wr/airwriter/docs/hardware-rev-2026-11.md

# Rev 2026.11 hardware, as drawn

The main board after rev A, named for what prints on the top case. Designed and routed, the
routing approved by Wells (2026-10-29); not yet ordered or built. Why each change exists is in the design,
`docs/superpowers/specs/2026-10-28-rev-2026-11-board-design.md`. This file is the board as
drawn: what moved from rev A, where things are, and what to leave alone. Edit it in place.

## How the board file is made

`hardware/airwriter/airwriter.kicad_pcb` is generated from rev A (the `hw-rev-a` tag) by
scripts, so every change can be read and re-run:

1. `tools_pcb/r13_build.sh`: rev A's board, then `r13_sync.py` (follow the schematic),
   `r13_place.py` (new parts, D3, TP9, silk), `r13_clean.py` (remove rev A copper the
   changes made wrong; it stops rather than cut a net the design didn't change),
   `r13_place.py` again, and `r13_reroute.py` (rev A copper and parts that move). It stops
   at the first step that fails.
2. `tools_pcb/r13_route.py`: the new traces. The long runs are drawn point by point; the
   short stubs round a part's own pins are found by a small grid search in a corridor.
3. `tools_pcb/r14_lc_light.py`, after `r13_sync.py` has brought JP1 in from the
   schematic: JP1 placed, its two runs drawn by the same grid search, two ground vias (below).

D3's and SW1's footprints are `r13_mkfp_d3.py` and `r13_mkfp_sw1.py`, their 3D models
`lib/make_led_spacer_model.py` and `lib/make_sw1_model.py`.

Once Wells has edited the board in KiCad, don't re-run `r13_build.sh`: it starts again
from rev A. Close KiCad before any of these scripts write the board.

## U3's two RS-232 channels

Rev A used channel 1 for the printer port and tied channel 2's inputs to GND. Rev 2026.11
swaps them, so J4's lines leave U3 on the side facing J4:

| U3 pin | Function | Net | Goes to |
|---|---|---|---|
| 7 | T2OUT | `HSKI_RS232` | R9 (0 Ω), J2.1 |
| 8 | R2IN | `PR_HSKO` | J2.2 |
| 9 | R2OUT | `UART_CTS` | IO8 |
| 10 | T2IN | `HSKI_DRV` | IO47, R24 to GND |
| 11 | T1IN | `J4_HSKO_DRV` | IO13 |
| 12 | R1OUT | `J4_HSKI_RX` | IO21 |
| 13 | R1IN | `J4_HSKI` | J4.2 |
| 14 | T1OUT | `J4_HSKO` | J4.1 |

IO8 also carries a QuickDraw LaserWriter's clock: a Personal LaserWriter 300 drives 533 kHz
on J2.2 whenever it is on, and the firmware clocks TxD out to it with GP-SPI2 through the GPIO
matrix, so the link needs no pin of its own (SPEC §2.4, §3.18; measured on rev A only).

Each port's HSKo has its own GPIO, on pins the DIP switches freed. The cable test drives
each, and through a crossover IO8 reads J2.2 (from J4.1) and IO21 reads J4.2 (from J2.1).
U1 is the ESP32-S3-WROOM-1-N16R8 (16 MB flash, 8 MB octal PSRAM; rev A's is the N8R2): its
PSRAM takes IO35–IO37, so those stay off every net. It needs its own firmware build (SPEC §3.19:
`idf.py -B build-2026.11 -DAIRWRITER_BOARD=2026.11 build`), and it
is rated to 65 °C.

## GPIOs that changed

| GPIO | Net | Notes |
|---|---|---|
| IO15 | `BOARD_LC` | R33 to GND, fitted on AirWriter LC only |
| IO16 | `BOARD_REV` | R32 to GND, fitted on every 2026.11 board; rev A floats high |
| IO13 | `J4_HSKO_DRV` | J4's HSKo, through U3's driver 1; no pull-down (below) |
| IO21 | `J4_HSKI_RX` | J4.2 through U3's receiver 1 |
| IO47 | `HSKI_DRV` | J2's HSKo, through U3's driver 2; R24 holds it low until firmware |
| IO35–IO37 | the N16R8's PSRAM | rev A's `HSKI_DRV` (IO35) and `J4_HSKI_RX` (IO37) |
| IO38–IO40 | `SPARE_IO38`–`40` | rev A's DIP switches; now bare pads on the back (below) |
| IO41, IO42 | none | rev A's DIP switches |

Free: IO1, IO3, IO7, IO9–IO12, IO41, IO42, IO45, IO46, and IO38–IO40 on their pads.

## The LC's one light: D26 and JP1

The LC fits one LED of the 37: D26, the one under the test button, with its cap C46, and U9,
R20 and C29 to drive it. C21, the array's bulk cap, stays off. The chain starts at D10, so
JP1, a solder jumper marked LC on the silk south-east of D26, joins `LED_DATA5` (U9's output
after R20) to `LED_CH16` (D26's input). It is open on AirWriter, where it leaves stubs of
25 mm on `LED_DATA5` and 9 mm on `LED_CH16`; Wells bridges it on the LC. On the LC, D26 is
the first LED U9 drives, so it shows a frame's first pixel. The firmware tells the two
apart by `BOARD_LC`.

`LED_DATA5` runs east from JP1 on the front and down the back to TP5; `LED_CH16` passes under
D26's VBUS and `BTN_TEST` runs on the back. The front run closed off two patches of the front
pour, the ones D26.2, C46.2 and C21.2 reach ground through, so each has a via to the back
plane at (132.75, 97.6) and (139.45, 101.5). JP1 is in the schematic's BOM (konnect can't
clear the flag); `make_fab.sh` leaves solder jumpers off both orders' BOMs.

## Parts that moved from rev A

| Part | Rev A | Now | Why |
|---|---|---|---|
| C18 | (124.20, 152.40) | (121.55, 152.40) | beside U8's VCC pin, west of J4's handshake runs |
| R10 | (121.20, 152.40) | (120.00, 152.40) | `LT_RXD_N` straight down from U8 |
| R11 | (122.70, 152.40) | (118.45, 152.40) | `LT_RXD_P` straight down from U8 |
| R14 | (125.70, 152.40) | (131.30, 144.60) | on `LT_DATA` between U7 and U6, below U7's TASHTALK label |
| SW2 | (144.50, 151.20) | (140.00, 152.70) | below IO0, so `BOOT_CFG` runs straight down; BOOT label to its right |

The maker's marks are on the top silk where S1 was, where the LC's clear lid shows them:
the WW mark (the Macintosh Mini board's two chevrons, 7 mm wide) above KiCad's OSHW logo
(7.5 × 8 mm, LOGO1, a board-only footprint).

Gone: S1, the eight DIP switches, and with them rev A's eight runs from the west edge to the
module. SW1 is now the BZCN TSB001A3518A side-press switch (the Macintosh Mini's), at
(157.60, 99.45) turned −90°: its button faces the case's reset pinhole, on rev A's axis, and
its two contacts sit over rev A's EN and GND pads. It is held by two plastic pegs in 0.9 mm
holes and two bracket pads; rev A's EVQP44B3M lifted off its two small pads. Its RESET label
is board silk now, not a field of the old footprint.

The new resistors sit beside what they serve: R24 below U3, R25 east of U6 (off UART_TX's
back run by a via), R27 east of U7 in LT_RESET's back run, R21 above SW2, R32 and R33 above
IO16 and IO15.

## Rev A copper that changed

- U3's 3.3 V feed runs from pin 16 under U3's body (x 117.3) to the branch at y 144.24,
  not down U3's right side.
- The printer port's handshakes rejoin rev A's routes by short steps from pins 7–10.
- `LT_RESET` meets R27 east of U7; U7.4 is fed back along rev A's run as `LT_MCLR`.
- EN steps round SW1's bracket pad into its pad 1.
- `BOOT_CFG` goes straight down from IO0 to R21 and SW2.
- `LED_DATA`'s run north of the module is 0.37 mm higher, which makes room for R32 and R33's
  ground vias.
- The LocalTalk receive pair from R10/R11 to J4: `LT_PORT_RXD_P` on the back.
- The VBUS via at the H4 crossing is 0.5 mm drill (rev A 0.4), not doubled: its plated wall
  now holds more copper than the 0.5 mm track that feeds it, so that track, unchanged from
  rev A, is the limit.
- D− reaches the ESP32 through U5's pad 3, as D+ goes through U5; U5.2 has a ground via
  under U5.

## New runs

- J4.1 and J4.2 from U3.14 and U3.13: down beside U3, under U8, a via each just below U8,
  then the back layer to J4.
- IO21 (`J4_HSKI_RX`) and IO47 (`HSKI_DRV`): a via each by U3, then side by side on the
  back, along rev A's `HSKI_DRV` run, to a via each just west of the module and a short
  stub into pins 23 and 24.
- IO13 (`J4_HSKO_DRV`): a via beside U3.11, one straight run on the back between U7's two
  rows of pins, and a via just west of pin 21 (BTN_TEST passes on the front).
- Ground vias for R24, R32, R33, TP9's patch of the back pour and U5.2.
- Spare pins: IO38, IO39 and IO40 each run straight down from the module's pin to a via
  and a bare 1 mm pad on the back (TP10–TP12, labelled 38, 39, 40), for trying an idea on
  a built board with a few wires; 3V3 is at TP2 and GND at TP9 nearby. On the back, so the
  front keeps only a short stub per pin and the ground pour still reaches C1 and C22. IO41
  has no way down past USB D− on the back, and IO42 has C1 over it.

## Deliberate, don't "fix"

- IO13, J4's HSKo drive, has no pull-down. A resistor fits only at the end of an 8 mm
  stub, and nothing on J4 reads pin 1 at power-up; firmware drives it within about 0.1 s.
  J2's (IO47) keeps R24: a StyleWriter on J2 watches its HSKo.
- TP9 and the old test pads sit on the back under U1's courtyard.
- Vias under U5's and U8's bodies are tented.
- U2 is TI's THVD1451 (the design had the SP3490): the same pinout, rated ±30 kV HBM on its
  bus pins against the SP3490's ±2 kV, and its receiver works with ±15 V on its inputs
  (absolute maximum ±18 V), so an RS-232 printer's line is in range on its own. R29 and
  R30 stay in series with the receive pair at 15 k, as protection: against the receiver's
  load (at least 75 k at −15 V) a −15 V line arrives at about −12.5 V, and an RS-422
  printer's 2 V as about 1.7 V. Its fail-safe threshold (−20 to −200 mV) reads an idle,
  open or unplugged line as mark, so a printer switched off with the cable in sends no
  garbage.
- D3's cathode is marked K on the silk beside pad 1: the spacer hides the square pad.
- D3's axis sits about 0.5 mm east of the top case's slash centre line: the slash grew to
  about 1.0 × 5.75 mm in the Frame 16 art, and D3 can't move west without meeting J1. Its
  3 mm face still covers the slash's full width.
- R17's pads sit 0.58 mm in from the east edge: PCBWay's minimum is 0.30, with ±0.2 mm on a
  routed edge.

## Checks, 2026-10-28

- ERC: 0 errors, 47 known warnings (42 `lib_symbol_mismatch`; 5 `isolated_pin_label`: TXD0,
  RXD0 and the three spare pins, each a label on one pin by design).
- DRC with `--severity-all --schematic-parity --refill-zones`: 0 errors, 0 unconnected, 5
  `lib_footprint_mismatch` warnings, no field-parity warnings (`r13_sync.py` now copies the
  Description, Manufacturer and Datasheet fields too).
- `r12_gnd.py`: one GND component, no stranded pads.
- `r7_verify.py`: rev A's known FAIL lines, plus TP9 under U1.
- `r13_check.py`: every pad of a part inside the board 0.30 mm or more from the edge, no
  front silk off the board, D3's K and SW1's RESET in place.
- `enclosure/build.sh`: all tests pass; the tray has no DIP slot (a board without S1 gets
  none), and the reset pinhole aims at the new button, 1.90 mm up.
- `make_fab.sh`: 135 placements on AirWriter's panel, 54 on the LC's main board alone, drill
  floor 0.30 mm on both. Neither places J2, J4 or a PIC: Wells fits them after delivery, and
  U7's socket goes on empty.
