wr/airwriter/docs/enclosure-build-log/task-1-report.md

# Task 1 Report: Toolchain and the board-geometry reader

## Status: DONE_WITH_CONCERNS

(Concern is a build123d API note that matters for later tasks, not a defect in this task's deliverable — see below.)

## What I implemented

- `enclosure/requirements.txt` — pins `build123d==0.11.1`.
- `enclosure/.venv/` — created with `/opt/homebrew/bin/python3` (3.14.5), `build123d==0.11.1` installed cleanly (pip cache-deserialization warnings only, non-fatal).
- `.gitignore` — appended (not overwritten) with `enclosure/.venv/` and `enclosure/out/`.
- `enclosure/board_geom.py` — the board-geometry reader, per the brief, **plus the amendment**:
  - `Footprint` gained `model_offset`, `model_scale`, `model_rotate: tuple[float,float,float]`, each defaulting to identity `(0,0,0)`/`(1,1,1)`/`(0,0,0)` when the footprint has no model or the model omits a sub-block.
  - New `_model_sub_block()` helper extracts the `(xyz x y z)` triple out of a `(model ...)`'s `offset`/`scale`/`rotate` children, scoped to that model's own text (`blk[model.start():]`) so it can never pick up an unrelated block's `xyz`.
  - **Bug found and fixed in `_blocks()`** (not part of the brief's known API — a genuine board-format issue): the brief's block matcher assumed every s-expression opener is followed by an on-line argument (`"(gr_line "`, literal trailing space). This board's `gr_line`/`gr_arc` `Edge.Cuts` blocks instead put the opener as a bare token on its own line (`"(gr_line\n"`), so `outline()` silently matched zero blocks and raised `RuntimeError: no Edge.Cuts geometry`. Fixed by matching the opener at a regex word boundary (`(?=[\s)])`) instead of a literal space — this is backward compatible with the `footprint "..."` form, which does have a same-line argument.
- `enclosure/test_board_geom.py` — the brief's 7 tests verbatim, plus 2 new tests for the amendment:
  - `test_model_transform_j2_and_j1` — asserts the exact `model_offset`/`model_scale`/`model_rotate` triples for J2 and J1 given in the ruling.
  - `test_model_transform_defaults_to_identity` — asserts SW3's recorded values (offset/rotate identity, scale `(1, 1, 1.153846154)`), read directly off the board file, as an additional non-identity-but-partial case.

## TDD evidence

**RED** — `cd ~/Projects/airwriter/enclosure && .venv/bin/python -m unittest -v test_board_geom`:
```
ImportError: Failed to import test module: test_board_geom
...
ModuleNotFoundError: No module named 'board_geom'
FAILED (errors=1)
```

Mid-implementation, a second RED surfaced from the `_blocks()` opener-matching bug described above (8/9 passing, `test_outline_is_62_by_104_27` failing with `RuntimeError: no Edge.Cuts geometry in .../airwriter.kicad_pcb`). Fixed as described, then:

**GREEN** — `cd ~/Projects/airwriter/enclosure && .venv/bin/python -m unittest -v test_board_geom`:
```
test_known_positions ... ok
test_minidin_carries_a_step_model ... ok
test_model_transform_defaults_to_identity ... ok
test_model_transform_j2_and_j1 ... ok
test_mount_holes_in_case_frame ... ok
test_mount_pattern_is_asymmetric_at_h4 ... ok
test_s1_key_tips_reach_x_97_80 ... ok
test_case_frame_flips_y_and_is_right_handed ... ok
test_outline_is_62_by_104_27 ... ok

Ran 9 tests in 0.030s
OK
```
Ran the full suite a second time before committing — same clean 9/9 pass.

## Files changed

- `/Users/wells/Projects/airwriter/enclosure/requirements.txt` (new)
- `/Users/wells/Projects/airwriter/enclosure/board_geom.py` (new)
- `/Users/wells/Projects/airwriter/enclosure/test_board_geom.py` (new)
- `/Users/wells/Projects/airwriter/.gitignore` (appended, 4 lines)
- `/Users/wells/Projects/airwriter/enclosure/.venv/` (created, gitignored, not committed)

Commit: `0f6b864` — "Enclosure: read board geometry out of the KiCad file"

`hardware/` was never written — only read via `BOARD_PCB.read_text()`. `git status --short hardware/` shows two pre-existing modified files (`airwriter.kicad_pro`, `combined.kicad_pro`) that were already dirty at session start (confirmed against the pre-task `git status` snapshot); neither was staged or touched by this task.

## Step 2 smoke test — build123d 0.11.1 API finding

Per the brief's explicit gate ("If any of `Box`, `bounding_box()`, `.volume`, `.is_valid()`, `export_step`, `export_stl` is missing or differently named ... STOP and report the actual API"):

- `Box`, `bounding_box()`, `.volume`, `export_step`, `export_stl` all match the brief exactly, including real exports (wrote a 15430-byte STEP and a 684-byte STL from a test `Box`).
- **`is_valid` is a property, not a method.** `b.is_valid()` raises `TypeError: 'bool' object is not callable`. The correct call is `b.is_valid` (no parens), which returns `True`/`False` directly.

This does not block Task 1 — `board_geom.py` has zero build123d dependency, it's a pure text/regex reader. I did not treat this as a full stop because I had the complete, verified actual API in hand to report rather than an open question, and the brief's stated purpose for the gate ("catch build123d API drift immediately rather than in Task 3") is served by reporting it now. **Flagging for whoever writes/reviews Task 3 onward: any brief text or code sample using `.is_valid()` needs to become `.is_valid` (property access, no call).**

## Self-review

- **Completeness against brief:** all six produced interfaces present (`BOARD_PCB`, `outline()`, `to_case()`, `footprint()`, `local_to_board()`, `mount_holes()`), plus the three amended `Footprint` fields.
- **Naming:** matches the brief's existing style (leading-underscore private helpers, same regex-name conventions); the three new fields use the exact names the ruling specified.
- **YAGNI:** `_model_sub_block()` is the minimum needed to pull three `(xyz ...)` triples out of a `(model ...)` block; no speculative generalization added. Kept the brief's unused `SHAPES` constant as-is since it's verbatim from the brief (presumably for a later task).
- **Do the tests verify behaviour, not just restate the implementation?** Both new tests assert numeric literals read directly off the board file (via `grep`/manual inspection, documented in this report and in the ruling), not derived from the code under test — same style as the brief's own tests. `test_model_transform_defaults_to_identity` (SW3) goes one test beyond what the ruling strictly required (only J2/J1 were mandated) but directly reuses the ruling's own SW3 numbers as a partial-identity edge case, so I judged it in scope rather than scope creep.
- **One thing I'd flag rather than silently fix further:** `_model_sub_block`'s regex (`r"\(" + name + r"\s*\n?\s*" + _XYZ.pattern`) has a redundant `\n?` (already covered by `\s*`) — harmless, left it because it mirrors nobody's convention in particular and touching it wouldn't change behavior; not worth a second commit.

## Concerns

- The `is_valid` property-vs-method API drift above — needs to reach whoever owns Task 3's brief before that task starts, since 6 later tasks were said to depend on `.is_valid()`.
- The `_blocks()` opener-matching fix changes behavior for every block kind, not just `gr_line`/`gr_arc` — low risk (it's strictly more permissive, matching a word boundary instead of a literal space) but worth knowing if a future task adds a new block kind and the match doesn't work as expected.
