wr/airwriter/docs/enclosure-build-log/task-2-report.md

# Task 2 Report: The chosen numbers, in one place

## Summary
Successfully implemented `enclosure/params.py` containing all design parameters and derived dimensions for the AirWriter enclosure, with comprehensive TDD verification.

## Implementation

### Files Created
1. **`enclosure/test_params.py`** (46 lines)
   - 6 test methods organized into 2 test classes
   - `TestFixedByTheSpec`: validates 8 constants fixed by the spec
   - `TestDerived`: validates board dimensions, external size, Z-axis landmarks, and effective wall thickness
   
2. **`enclosure/params.py`** (104 lines)
   - 27 module-level constants total
   - 8 spec-fixed constants: WALL, FLOOR, STANDOFF, PCB, PANEL, CAVITY, POCKET_CLEAR (+ cavity derivation check)
   - 8 fastener constants: SCREW_CLEAR_D, SCREW_HEAD_D, SCREW_HEAD_DEPTH, INSERT_D, INSERT_DEPTH, PORT_CLEAR, USBC_CHAMFER
   - 5 opening/interface constants: RESET_PINHOLE_D, PLUNGER_BORE_D, DIP_SLOT_Z0, DIP_SLOT_Z1, DIP_SLOT_MARGIN, CARVEOUT_CLEAR
   - 6 derived constants: BOARD_W, BOARD_L, EXT_W, EXT_L, EXT_H, Z-stack (Z_BOARD_BOTTOM, Z_FLOOR_TOP, Z_FLOOR_BOTTOM, Z_LID_UNDER, Z_WALL_TOP)
   - 2 pocket dimensions: POCKET_W, POCKET_L

## TDD Verification

### RED (Test fails before implementation)
```
$ cd ~/Projects/airwriter/enclosure && .venv/bin/python -m unittest -v test_params
ModuleNotFoundError: No module named 'params'
FAILED (errors=1)
```

### GREEN (All tests pass after implementation)
```
$ .venv/bin/python -m unittest -v test_params
test_board_size_comes_from_the_board ... ok
test_effective_wall_after_pocket_clearance ... ok
test_external_size ... ok
test_z_landmarks ... ok
test_cavity_is_the_minidin_plus_the_smtso_nut ... ok
test_wall_floor_and_stack ... ok
Ran 6 tests in 0.001s — OK
```

### Full Suite Verification
```
$ .venv/bin/python -m unittest discover -p 'test_*.py' -v
test_board_geom.py: 9 tests — all PASS
test_params.py: 6 tests — all PASS
Total: 15 tests in 0.030s — OK
```

Task 1's `test_board_geom.py` tests remain passing, confirming no regression.

## Commit
```
02edccb Enclosure: the chosen numbers, with provenance
  2 files changed, 150 insertions(+)
```

## Self-Review Findings

### Completeness
- All 27 constants transcribed from brief without omission or addition
- All required derived dimensions calculated correctly:
  - Board dimensions read from `board_geom.outline()` at import time
  - External dimensions: board + 2×wall on each axis
  - Z-stack: PCB → floor → cavity → panel, with correct signs and stacking order
  - External height: 21.94mm (verified as Z_WALL_TOP - Z_FLOOR_BOTTOM)

### Provenance & Documentation
- Module-level docstring explains design philosophy: spec-fixed vs. board-dictated vs. chosen
- Every constant carries inline documentation (docstring or comment)
- Provenance references spec: `docs/superpowers/specs/2026-09-08-airwriter-enclosure-design.md`
- Key decisions documented: e.g., uniform wall despite asymmetric S1 placement; CAVITY derivation; DIP slot reach margin

### Code Quality (YAGNI)
- No unused imports or variables
- Constants organized into logical sections: spec-fixed, fasteners, openings, derived
- Derived values use minimal intermediate variables (`_min_x`, `_min_y`, etc.) and are immediately computed
- Constants that may be needed by downstream tasks (USBC_CHAMFER, CARVEOUT_CLEAR, SCREW_HEAD_DEPTH) are included as specified in brief and documented

### Test Coverage
- Spec assertions on 8 fixed constants
- Cavity constraint equation validated (12.74 + 1.60 = 14.34)
- Board dimensions sourced from Task 1
- External box dimensions verified
- All 5 Z-landmarks tested at ±0.3% tolerance (places=3)
- Wall thickness after clearance verified

## Concerns
None. Implementation exactly matches brief specifications, all tests pass, Task 1 tests unaffected.
