wr/airwriter/docs/enclosure-build-log/task-4-report.md

# Task 4 report: board standoffs and the screw stack

## What I implemented

Added two functions to `enclosure/case.py`, exactly as specified in the brief:

- `standoffs() -> Part`: four cylindrical bosses (Ø6.00, `STANDOFF_D`), one per
  mount hole from `board_geom.mount_holes()`, running from `Z_FLOOR_TOP` to
  `Z_BOARD_BOTTOM`.
- `screw_holes() -> Part`: four clearance-plus-counterbore solids to be
  subtracted — an M2.5 clearance bore (Ø2.80) running the full height from
  just below the floor to just above the board, an M2.5 pan-head counterbore
  (Ø5.00, 1.40mm deep) opening on the floor's underside, and a 45° `Cone`
  run-out between the two so the transition isn't a flat, unsupported
  annular ledge on a floor-down print.

Also appended `TestStandoffsAndScrews` to `enclosure/test_case.py`, copied
verbatim from the brief (three tests: standoff placement/reach, screw-hole
through-floor extent, and the coned-not-flat counterbore transition).

Did not write `tray()` — that's Task 6, per the brief.

## TDD evidence

**RED** — `cd ~/Projects/airwriter/enclosure && .venv/bin/python -m unittest -v test_case`, after adding the test class only:

```
test_counterbore_transition_is_coned_not_a_flat_ledge ... ERROR
test_screw_holes_pass_right_through_the_floor ... ERROR
test_standoffs_sit_at_the_mount_holes_and_reach_the_board ... ERROR
...
AttributeError: module 'case' has no attribute 'screw_holes'
AttributeError: module 'case' has no attribute 'standoffs'
Ran 8 tests in 0.051s
FAILED (errors=3)
```

**GREEN** — same command, after implementing `standoffs()`/`screw_holes()`:

```
test_cavity_is_hollow_from_floor_top_upward ... ok
test_external_bounding_box ... ok
test_floor_is_solid_under_the_pocket ... ok
test_is_a_valid_single_solid ... ok
test_sits_in_the_case_frame ... ok
test_counterbore_transition_is_coned_not_a_flat_ledge ... ok
test_screw_holes_pass_right_through_the_floor ... ok
test_standoffs_sit_at_the_mount_holes_and_reach_the_board ... ok

Ran 8 tests in 0.190s
OK
```

**Full suite** — `.venv/bin/python -m unittest discover -p 'test_*.py' -v`: 23 tests, all pass (Tasks 1-3's `test_board_geom.py`/`test_params.py`/`test_case.py` shell tests unaffected).

## Files changed

- `enclosure/case.py` — added `STANDOFF_D`, `standoffs()`, `screw_holes()`, extended the `build123d` import and added `import board_geom as bg`.
- `enclosure/test_case.py` — appended `TestStandoffsAndScrews`.

Commit: `a077a8f` "Enclosure: board standoffs and the screw stack" (2 files changed, 74 insertions, 1 deletion). Nothing under `hardware/` touched (the working tree has unrelated pre-existing modifications to two `.kicad_pro` files and some untracked firmware build artifacts — I left those alone and staged only the two intended files).

## build123d API notes (as requested)

- `Cone(bottom_radius, top_radius, height, ...)` and `Cylinder(radius, height, ...)` both default to `align=(CENTER, CENTER, CENTER)`, matching the brief's assumption that `Pos(x, y, z_center) * Cone(...)` centers the primitive on `z_center`. Confirmed via `help()` before using it — no surprise here.
- Chained `+` unions of several `Part` objects (as `standoffs()` and `screw_holes()` do in their loops) come back as `build123d.topology.composite.Compound`, not `Part`, even though the function signatures say `-> Part` (matching the brief). By contrast, `shell()`'s single `Box - Box` returns an actual `Part`. This is cosmetic, not functional — `.bounding_box()`, `.solids()`, `.is_valid`, and further `+`/`-` against real `Part` objects all work fine on the `Compound` (verified: `(shell() + standoffs()) - screw_holes()` comes back as a valid single-solid `Part`). Worth knowing for Task 6's `tray()`, which will do exactly that composition — no fix needed, just don't be surprised if `type(standoffs())` isn't `Part`.

## Self-review finding — the counterbore test does not actually catch a flat-ledge regression

This is the important one, and exactly the kind of "brief's code assumes something about `face.normal_at()` that doesn't hold" surprise I was told to flag explicitly rather than route around.

`test_counterbore_transition_is_coned_not_a_flat_ledge` calls `case.screw_holes()`
(the tool solid, not the assembled shell) and filters for faces whose
`normal_at(center()).Z ≈ -1` (downward-facing) with area > 2.0, asserting
none exist. I verified empirically (built the "broken" tool — clearance bore
`+` counterbore, no cone — by hand and ran the test's exact filter against
it):

```
flats found (no-cone tool): []   # test would PASS on the broken geometry
```

The dangerous flat annulus is real (area 13.477mm² = π(2.5²−1.4²), exactly
the Ø5.00→Ø2.80 shoulder, at z=−4.60 = `Z_FLOOR_BOTTOM + SCREW_HEAD_DEPTH`)
and it does exist in the no-cone tool — but its outward normal, on the *tool*
solid, is **+1** (up), not −1. That's the correct OCCT convention for a
union of two coaxial cylinders (wider below, narrower above): the tool's own
boundary at the shoulder faces away from the tool's interior, i.e. upward.
It's only after the tool is *subtracted* from real material that the
corresponding surface (now part of the shell) faces downward and becomes a
physical overhang. So the brief's test, run against the bare tool with a
downward-normal filter, is checking the wrong sign on the wrong object, and
it passes unconditionally regardless of whether the cone is present.

I confirmed the flip in isolation (`normal.Z ≈ +1` on the tool does show the
shoulder for the no-cone case and not for the coned case), but a plain sign
flip isn't a safe fix by itself: it also matches the legitimate top cap of
the through-bore (at `Z_BOARD_BOTTOM + 0.01`, area π·1.4² = 6.158), which
is not an overhang and appears in both the broken and correct geometry — so
naively flipping the sign turns the test into an always-fail. Checking the
assembled `shell() - tool` instead (rather than the tool alone) does
discriminate correctly on the shoulder in my testing, but introduces an
unexplained extra flat face elsewhere in the model that I didn't have
confidence chasing down inside this task's scope.

I did **not** change the test — the brief specified it verbatim and I don't
have a confidently-correct replacement to swap in without further
investigation, plus Task 8's whole-part printability gate is explicitly
"built on the same idea," so this is worth fixing once at the plan level
rather than my patching it ad hoc here. My actual `standoffs()`/`screw_holes()`
implementation is geometrically correct regardless — I verified directly
(not via this test) that the coned tool has no flat shoulder face at any
normal orientation at z=−4.60, only the no-cone version does. But the test
as committed gives false confidence: it would pass even if someone later
deleted the `Cone` and left a flat ledge. Recommend fixing the filter (and
probably scoping to the counterbore-to-clearance transition band, not just
any upward-or-downward face) before Task 8 reuses this pattern.

## Other self-review notes

- `test_standoffs_sit_at_the_mount_holes_and_reach_the_board` is solid: it
  pins exact Z bounds, solid count, and XY centres against
  `board_geom.mount_holes()` directly, so it would catch a wrong hole,
  wrong height, or merged/missing boss.
- `test_screw_holes_pass_right_through_the_floor` is deliberately loose
  (`<=`/`>=` on bounding box, not exact) — matches the brief, no concern.
- YAGNI: no `tray()`, no extra helpers beyond what's needed for these two
  functions. `STANDOFF_D` is the only new constant, with a rationale
  docstring per the file's existing convention.

## Fix report: counterbore-flat test now checks the boolean result

Addressed the self-review finding above (also raised independently as a
review "Important" finding): `test_counterbore_transition_is_coned_not_a_flat_ledge`
called `case.screw_holes()` — the cutting tool — and filtered for
downward-facing (`normal_at().Z ≈ -1`) planar faces. A tool solid has no
such face at that shoulder: the tool's own material sits below and wider
there, so the face's outward normal is +Z. The dangerous unsupported ledge
only exists on the boolean **result**, where the same surface (now the
underside of real material) points -Z. The test therefore always passed,
cone or no cone.

**Fix (test-only, `enclosure/test_case.py`):** rewrote the test to build
`(case.shell() + case.standoffs()) - case.screw_holes()` inside the test and
run the same filter (`abs(n.Z + 1.0) < 1e-6`, area > 2.0, centre above
`p.Z_FLOOR_BOTTOM`) against that result instead of the tool. Added a comment
recording why the check has to be on the result, not the tool. Did not touch
`case.py` — `standoffs()`/`screw_holes()` geometry was already correct.

**No-cone sanity check** — before committing, built a throwaway no-cone
variant of the tool (`bore + cbore`, cone omitted) inline in a scratch
script and ran the amended filter against
`(case.shell() + case.standoffs()) - screw_holes_no_cone()`:

```
no-cone result: 4 downward flat(s) found
  area=13.477 mm2 at (5.636, 12.340, -4.600)
  area=13.477 mm2 at (53.364, 12.340, -4.600)
  area=13.477 mm2 at (5.636, 98.634, -4.600)
  area=13.477 mm2 at (56.364, 98.634, -4.600)
SANITY CHECK PASSED: amended test would FAIL (correctly) on the no-cone regression
```

This matches the finding's manual verification exactly (area
π(2.5²−1.4²)=13.477 mm² at `Z_FLOOR_BOTTOM + SCREW_HEAD_DEPTH` = -4.60, one
per mount hole). The scratch variant was never added to `case.py` — discarded
after this check.

**Covering tests, real implementation:**

```
$ .venv/bin/python -m unittest -v test_case
test_cavity_is_hollow_from_floor_top_upward ... ok
test_external_bounding_box ... ok
test_floor_is_solid_under_the_pocket ... ok
test_is_a_valid_single_solid ... ok
test_sits_in_the_case_frame ... ok
test_counterbore_transition_is_coned_not_a_flat_ledge ... ok
test_screw_holes_pass_right_through_the_floor ... ok
test_standoffs_sit_at_the_mount_holes_and_reach_the_board ... ok

Ran 8 tests in 0.188s
OK

$ .venv/bin/python -m unittest discover -p 'test_*.py' -v
[... 23 tests ...]
Ran 23 tests in 0.193s
OK
```

Commit: `1abcf72` "Enclosure: check the counterbore-flat test against the
boolean result" (`enclosure/test_case.py`, 1 file changed, 9 insertions(+),
2 deletions(-)).
