wr/airwriter/docs/enclosure-build-log/task-5-report.md

# Task 5 report: port cutouts booleaned from the real connector STEPs

Status: **DONE_WITH_CONCERNS**

## What was implemented

`enclosure/case.py`:

- `connector_solid(ref)` — a connector's vendor STEP, placed in the case frame by
  the full KiCad 3D-model transform (model scale → model rotate → model offset →
  footprint's own board rotation/position → case frame's Y flip), not the brief's
  false "offset 0, footprint origin only" assumption.
- `_imported_step(path)` — module-level cache keyed by path, since `import_step`
  takes ~0.15s and `connector_solid()` is called many times across the port
  tests. Each caller gets its own transformed copy (`Location * Shape` returns a
  new object; the cached raw import is never mutated). Flagging this per the
  task instructions: it's machinery the brief didn't ask for, added because the
  suite would otherwise re-import the same STEP dozens of times.
- `_grown(ref, amount)` — a private helper: the connector's convex hull, grown by
  `amount` via `offset()`. See "build123d/OCCT surprise" below for why this
  exists instead of offsetting `connector_solid()` directly.
- `port_cutouts()` — unions `_grown(ref, PORT_CLEAR)` for J2/J4/J1, plus the
  USB-C outside chamfer, same construction as the brief's skeleton.

`enclosure/test_case.py`: a new `TestPorts` class with 7 tests — the three
ground-truth tests (mating face Y, shell Z height, USB-C face Y) plus the
brief's four remaining checks (real geometry, no intersection, ≥0.30mm
clearance, wall remains between the mini-DINs), adapted where the brief's
literal code didn't survive contact with the real geometry (see below).

## The transform composition, and the evidence for it

```python
mrx, mry, mrz = fp.model_rotate
part = Rot(-mrx, 0, 0) * part      # 1. negate stored rotate, apply about X first
part = Rot(0, -mry, 0) * part      # 2. ... then Y ...
part = Rot(0, 0, -mrz) * part      # 3. ... then Z, each about the FIXED axes
part = Pos(*fp.model_offset) * part  # 4. offset, in that same numeric frame

part = Rot(0, 0, fp.rot) * part    # 5. footprint's board rotation, sign AS STORED
x, y = bg.to_case(fp.x, fp.y)
return Pos(x, y, 0) * part          # 6. footprint position, converted to case frame
```

Two things this nails down that weren't obvious going in:

1. **KiCad negates the stored `rotate` and applies it about the fixed model
   axes in order X, then Y, then Z** — not the model's own rotating axes
   (that would be a different, intrinsic composition), and not Z-Y-X. I
   verified the axis order empirically: swapping to Z-then-X for J2 (mrx=-90,
   mrz=180) puts the shell's Z-max at 3.75mm instead of ~12.75mm — wildly
   wrong, which is exactly the "obviously wrong" signal the brief said to
   watch for. Not negating the stored rotate at all does the same (3.75mm).
   Only X-then-Y-then-Z with negation lands near the documented 12.74mm.

2. **The footprint's own board rotation (`fp.rot`) is applied to the model's
   local frame using its stored sign directly — not negated, and not
   `180 - fp.rot`** (the brief's formula, which was part of the false
   assumption being overridden). I derived this algebraically: rotating a
   local point by `fp.rot` via `board_geom.local_to_board`'s convention and
   then converting the result to the case frame (which flips Y) is
   numerically identical to applying `Rot(0, 0, fp.rot)` directly to the
   *un-flipped* local numbers and then translating by `to_case(fp.x, fp.y)`.
   The two sign flips (the board-rotation convention, and the case frame's Y
   flip) cancel. I confirmed this by computing full board-frame bounding
   boxes by hand for J2 with `Rot(0,0,-fp.rot)` (the naive guess) — it puts
   the connector body sticking 15mm out the *front* of the case, physically
   backwards — versus `Rot(0,0,fp.rot)` (implemented) — which puts the body
   properly behind the mating face, inside the case.

### The three ground truths, measured

| # | Ground truth | Measured | Match |
|---|---|---|---|
| 1 | J2/J4 mating face at case Y = −2.75 | **−2.75** (exact) | ✓ |
| 2 | J2/J4 shells top out at Z = 12.74 | **12.75** | ~0.01mm off |
| 3 | J1 shell face near case Y = −1.5 (±0.2) | **−1.5** (exact) | ✓ |

Ground truth 1 is somewhat structurally guaranteed once the offset/scale are
right (J2/J4 both have `model_offset = (0,0,0)`, so the footprint origin maps
straight through regardless of rotation), but it's still a real check on the
offset-handling code path and on `to_case()` being wired correctly.

Ground truth 2 came out to 12.75mm, not 12.74mm. I did not adjust the
composition to force this closer — every alternate axis order or sign I
tried during development landed far off (3.75mm, −3.75mm, 16.5mm), so there
was no "close but not quite" candidate to chase; the only two outcomes
observed were "exactly 12.75mm" (this composition) or "obviously wrong by
multiple mm" (every other one tried). 12.75mm is also not an artifact of
rounding in this pipeline — `repr()` on the bounding box gives
`12.750000100000003`, i.e. it's genuinely the raw STEP's own Y-extent
(12.75mm, read directly off `MiniDIN-8_Kycon_KMDGX-8S-BS_RightAngle.step`)
carried straight through the rotation with no further arithmetic. I traced
"12.74" to two places: `scripts/board-model/README.md` in the **shop** repo,
and this project's own `docs/superpowers/specs/2026-09-08-airwriter-enclosure-
design.md` (§2, "14.34 is not a free variable... 12.74 + 1.6 = 14.34"), both
apparently hand-derived rather than measured off this exact STEP file. I
wrote the test with `delta=0.02` rather than `places=2`, documented why in
both the test and the docstring, and am reporting it here rather than
treating it as silently resolved — this is exactly the kind of gap the task
asked me to flag rather than paper over. **This is worth a second look**:
if 12.74 is authoritative for another reason I'm not seeing (e.g. a
different reference plane for "board's top face"), `params.CAVITY` (14.34,
"not a free variable") should be revisited; if 12.75 is right, that design
doc and the shop README are each 0.01mm stale.

Ground truth 3 landed exactly on −1.5, comfortably inside its own stated
±0.2mm tolerance, and gave good confidence that the J1 offset-handling
(the case the brief's false assumption most directly breaks — J1 is the one
footprint with a non-zero `model_offset`) is correct.

## TDD evidence

1. Wrote `TestPorts` in `test_case.py` (7 tests) before touching `case.py`.
2. `python -m unittest -v test_case.TestPorts` → `AttributeError: module 'case'
   has no attribute 'port_cutouts'` (confirmed red).
3. Implemented `connector_solid()`, ran `test_each_connector_has_real_step_geometry`
   and the ground-truth tests in isolation via scratch scripts to find the right
   transform (see composition derivation above) before wiring up `port_cutouts()`.
4. Implemented `port_cutouts()` — first pass used `offset(connector_solid(ref),
   PORT_CLEAR)` per the brief, which failed (see below); switched to the
   convex-hull approach.
5. Full `TestPorts` green, then full suite: `.venv/bin/python -m unittest
   discover -p 'test_*.py'` → **30 tests, OK** (Tasks 1-4's 23 tests plus this
   task's 7, all passing).

## build123d / OCCT surprise: `offset()` fails on the real vendor STEPs

The brief's `port_cutouts()` calls `offset(connector_solid(ref), PORT_CLEAR)`
directly. Against the real imported STEP geometry (303 faces for the mini-DIN,
136 for the USB-C — not the simple few-face primitives `offset()` is usually
exercised against in this codebase), this fails outright:

```
ValueError: Null TopoDS_Shape object
```

I does dug into this rather than assuming it was unfixable:

- Not a degenerate-geometry problem: `solid.is_valid` is `True`, no zero-area
  faces (smallest is 0.015mm²), single solid, 500 vertices.
- Tried every `Kind` (`ARC`, `INTERSECTION`, `TANGENT`) — `ARC` fails instantly,
  `INTERSECTION`/`TANGENT` hang (I killed one after 2+ minutes of live CPU work,
  not a deadlock).
- Tried `.clean()` first (303 → 281 faces) — still null.
- Tried looser `tolerance` on the underlying `offset_3d()` (bypassing the
  `offset()` wrapper): 0.0001 through 0.01 all null; 0.05 "succeeds" but
  returns a solid **smaller** than the input in two of three axes (X: 6→7.6,
  Z: −3.75..12.75 → 0.85..11.65) — a corrupted result, not a real offset, from
  OCCT's healing collapsing features under a tolerance that coarse.
- Tried offset amounts from 0.05 to 0.4mm at tight tolerance: all either null
  or (at 0.2mm) a "successful" solid with volume `9e-10` — garbage.

Conclusion: `BRepOffsetAPI_MakeThickSolid` (what `offset()` calls for solids)
can't produce a valid true 3D offset of this connector's geometry at any
amount/tolerance combination tried — most likely the 8 closely-spaced pins on
the mini-DIN self-intersect under any real offset and the healer can't recover.
This isn't specific to my placement transform; I reproduced it on
`connector_solid()` output directly, and volume/bounding box are placement-
invariant, so a different rotation wouldn't change this.

**Fix:** `_grown(ref, amount)` builds a `ConvexPolyhedron` from
`connector_solid(ref).vertices()` (build123d has this as a first-class
constructor — `objects_part.ConvexPolyhedron`, backed by `scipy.ConvexHull`)
and offsets *that* instead. A convex hull is a handful of large flat/curved
faces with nothing close enough to self-intersect, so the offset is fast
(~0.02-0.08s) and clean. Since the hull always contains the original solid
(same bounding box, only concavities filled in), the grown hull always
contains the true Minkowski-grown solid, so this is a conservative
approximation: openings clear the connector by *at least* `PORT_CLEAR`
everywhere, possibly more near a concave feature (e.g. between the mini-DIN's
mounting posts). I judged this an acceptable and still-faithful-to-the-brief's-
intent substitution — it's still driven entirely by the real vendor geometry,
not a guessed/typed dimension — and documented the reasoning in `_grown()`'s
docstring rather than silently swapping the technique.

The `test_openings_clear_each_connector_by_at_least_0_30` test originally
called `offset(case.connector_solid(ref), 0.30)` per the brief; that fails the
same way, so I rewrote it to use `case._grown(ref, 0.30)` (same technique
port_cutouts() uses, at the spec's stated assertion floor of 0.30mm rather
than production's 0.40mm).

## A second, unrelated finding: J2/J4 pins dip into the floor slab

While writing `test_no_connector_touches_the_tray`, the unscoped version
(`tray_shell & connector_solid(ref)`, matching the brief) failed for J2 and J4
with a tiny intersection volume (0.0276mm³, at X≈19.7-20, Z −3.75..−3.6 for
J2 — the mirror position for J4). This is **not** a port-cutout bug: it's the
connector's real STEP geometry (whose lowest point is at Z=−3.75, now known
accurately for the first time) poking 0.15mm into the floor slab, because the
floor's top surface (`Z_FLOOR_TOP = -3.6`, from Task 2's `STANDOFF = 2.00`)
was sized before this task's accurate connector geometry existed.
`STANDOFF`'s comment says it's meant to clear "the through-hole tails of
J2/J4/S1/SW3/U7" — the real mini-DIN tails apparently need ~2.15mm below the
board's bottom face, not 2.00mm.

This is out of scope for Task 5 (I was told not to touch `tray()`, and
`STANDOFF`/floor sizing is Task 2's committed work) and I didn't touch
`params.py` or `standoffs()`/`shell()`. I scoped
`test_no_connector_touches_the_tray` to the wall/cavity region (Z ≥
`Z_FLOOR_TOP`) — what `port_cutouts()` can actually affect — documented the
0.15mm floor interference in the test's own comment, and am flagging it here
as the concern that makes this DONE_WITH_CONCERNS rather than DONE. Whoever
does Task 6 (`tray()`) should know: **J2/J4's real tails need ~0.15mm more
standoff clearance than `STANDOFF = 2.00` currently provides.**

## Files changed

- `enclosure/case.py` — `connector_solid()`, `_imported_step()` (STEP import
  cache), `_grown()` (convex-hull offset helper), `port_cutouts()`.
- `enclosure/test_case.py` — new `TestPorts` class (7 tests).

## Self-review findings

- Docstrings on `connector_solid()`, `_grown()`, and the affected tests carry
  the reasoning, not just the "what", per the pattern already established in
  this file (`params.py`, `screw_holes()`'s counterbore comment) — checked
  this matches house style before committing.
- Confirmed `.is_valid` used as a property everywhere (`solid.is_valid`, not
  `solid.is_valid()`).
- Confirmed no edits under `hardware/` (`git diff --stat` shows only
  `enclosure/case.py` and `enclosure/test_case.py`).
- Confirmed the STEP-import cache doesn't share mutable state across callers:
  `Location * Shape` returns a new object in build123d; verified this in
  practice by round-tripping `connector_solid()` for the same ref multiple
  times across different tests without cross-contamination (ground-truth
  tests and the clearance/intersection tests all call `connector_solid`
  independently and agree).
- Re-ran the full suite once more after the final test-scoping edit to
  confirm nothing regressed: 30/30 green.

## Concerns

1. **12.74 vs 12.75mm (ground truth 2)** — 0.01mm gap between the measured
   STEP geometry and two hand-written docs (this project's own design spec
   and the shop repo's README) that both cite 12.74 as load-bearing. Worth a
   second look at whether `params.CAVITY` (14.34) needs a 0.01mm correction,
   or whether the docs are just slightly stale. Not blocking — well within
   3D-printing tolerances — but flagged rather than silently absorbed.
2. **J2/J4 pins vs. floor (0.15mm)** — real, if tiny, interference between
   the connector's actual through-hole tail length and `params.STANDOFF`.
   Out of this task's scope to fix; the person doing Task 6 should see this
   before finalizing `tray()`.
3. `offset()` not working on real vendor STEP imports is a build123d/OCCT
   limitation worth remembering for any future task that needs true 3D
   offsets of imported (as opposed to hand-modelled) geometry — the
   convex-hull-offset pattern in `_grown()` is the workaround.

## build123d API notes worth keeping

- `ConvexPolyhedron(points)` (from `objects_part`) builds a convex solid from
  a point cloud via `scipy.ConvexHull` — useful, not obviously discoverable.
- `import_step()` for these STEP files takes ~0.15s each; cached at module
  level in `_imported_step()` since the test suite calls `connector_solid()`
  many times per ref. This is machinery the brief didn't ask for — flagging
  per the task instructions rather than leaving it unmentioned.
- `Solid.vertices()` currently prints a `DeprecationWarning` recommending
  `tuple(Vertex)` over `Vertex.to_tuple()`; used `tuple(v)` throughout to
  avoid it.

---

## Fix report: findings 1 and 2 (reviewer pass)

Status: **DONE**

Both findings the original implementation flagged are now fixed, additively:
`connector_solid()`'s transform and `_grown()`'s convex-hull approach were not
touched.

### Finding 1: STANDOFF was 0.15mm short

The reviewer measured the vendor STEPs directly and ruled `STANDOFF`
2.00 -> 3.00 (floor top -3.60 -> -4.60), and had already amended the spec and
plan before handing this off.

`enclosure/params.py`:

- `STANDOFF = 3.00`, comment rewritten to record the measurement: J2/J4's pin
  tips reach 2.150mm below the board's underside on the Kycon STEP, so 3.00
  leaves 0.85mm for hand-soldered fillets.
- Confirmed the rest of the stack follows without any other edit:

  ```
  STANDOFF          3.0
  Z_BOARD_BOTTOM   -1.6
  Z_FLOOR_TOP      -4.6   (was -3.6)
  Z_FLOOR_BOTTOM   -7.0   (was -6.0)
  EXT_H            22.94  (was 21.94)
  Z_LID_UNDER      14.34  (unchanged -- doesn't depend on STANDOFF)
  Z_WALL_TOP       15.94  (unchanged)
  ```

`enclosure/test_params.py`: updated the four expectations that move --
`STANDOFF` 3.00, `Z_FLOOR_TOP` -4.60, `Z_FLOOR_BOTTOM` -7.00, `EXT_H` 22.94.
Nothing else touched.

`enclosure/test_case.py`: added
`TestPorts.test_connectors_clear_the_floor_by_at_least_0_50`, which derives
the requirement instead of restating a number -- for J2, J4 and J1 it computes
`connector_solid(ref).bounding_box().min.Z - p.Z_FLOOR_TOP` live and asserts
it is `>= 0.50`, with a failure message naming the connector and the actual
clearance. Measured today:

| ref | bb.min.Z | Z_FLOOR_TOP | clearance |
|---|---|---|---|
| J2 | -3.750 | -4.60 | **0.850mm** |
| J4 | -3.750 | -4.60 | **0.850mm** |
| J1 | -1.000 | -4.60 | **3.600mm** |

This is the same 0.85mm the reviewer's ruling promised, now asserted rather
than hoped for -- a future board revision or connector swap that eats the
margin fails the suite instead of quietly interfering with the floor.

### Finding 2: nothing guarded the front wall against being eaten by a port opening

Added `TestPorts.test_front_wall_retains_material_above_and_below_each_port`
to `enclosure/test_case.py`, checked against `shell() - port_cutouts()` as
instructed.

For each of J2, J4, J1, it takes `case._grown(ref, p.PORT_CLEAR)`'s live
bounding box (not a hand-typed Z) and places a thin (0.4mm) probe slab
immediately above and immediately below it, spanning the connector's own
grown X-width and the wall's Y-band (`-WALL .. -POCKET_CLEAR` -- stopping
short of Y=0 so the probe doesn't cross into the board pocket, which is
already hollow for reasons unrelated to `port_cutouts()`). It asserts at
least 10% of each probe's volume survives the boolean against the tray
shell, with a failure message naming the connector, the side, and the
volume actually found.

Anchoring to the live envelope rather than a fixed number means the probe
tracks the real geometry: if a future `PORT_CLEAR` bump or connector STEP
revision grows an opening enough to reach the wall's own floor/top boundary,
the wall there is genuinely gone and the probe (placed just past the
envelope's own edge) finds nothing. Verified this directionally by
re-running the same probe construction with `PORT_CLEAR` inflated well past
its real value and watching the found fraction fall as the growth
approached the wall boundary, before writing the final assertion.

Measured today (probe volume varies by connector because each has a
different grown X-width; `frac` is what the test's 10% floor is checked
against):

| ref | side | probe mm^3 | material mm^3 | frac |
|---|---|---|---|---|
| J2 | above | 16.576 | 16.576 | 1.000 |
| J2 | below | 16.576 | 16.576 | 1.000 |
| J4 | above | 16.576 | 16.576 | 1.000 |
| J4 | below | 16.576 | 16.576 | 1.000 |
| J1 | above | 10.909 | 6.464 | 0.593 |
| J1 | below | 10.909 | 6.464 | 0.593 |

J2/J4 keep the full probe intact -- consistent with the reviewer's own
measurement of 2.79mm above / ~1.85-1.89mm below (recomputed here as
2.79mm / 1.89mm using the post-fix `Z_FLOOR_TOP`, clipped to the true wall
band). J1 sits lower (0.593) because the USB-C outside chamfer
(`USBC_CHAMFER`) is deliberately a wide flare, not because anything is wrong
-- there is still comfortably more than 10% of the probe's material intact.

### A new, unrelated observation -- not fixed, flagged for whoever owns port_cutouts() next

While characterizing J1's geometry for the test above, I found that the
USB-C chamfer cone in `port_cutouts()` reaches down to Z = -4.965 at the
wall's own outer face (Y = -WALL exactly, the cone's wide base). With the
Finding-1 fix, `Z_FLOOR_TOP` is now -4.60, so the chamfer still dips
**0.365mm below the floor top** right at the front-bottom corner near J1 --
confirmed as real (not a zero-area boundary artifact) by probing a small box
there: a 9.6mm^3 probe at that corner found only 9.317mm^3 of material,
~0.28mm^3 short. This is smaller than it was before the Finding-1 fix (old
`Z_FLOOR_TOP` -3.60 gave a ~1.0mm+ deeper overlap), so raising `STANDOFF`
incidentally improved it, but it is not zero.

This is a distinct issue from Finding 2 (it's the outside chamfer's cone
radius intersecting the floor slab, not `_grown()`'s convex hull eating the
wall) and touching `port_cutouts()`'s chamfer geometry or `USBC_CHAMFER` is
outside this fix's additive scope, so I left it alone and designed the new
wall test's J1 probes to sit above/below this corner rather than through it
(Z -1.8..-1.4, well clear of the -4.6ish corner). Whoever next touches
`port_cutouts()` or finalizes `tray()` (Task 6) should know: **the USB-C
chamfer currently shaves a small, real notch out of the floor slab's
front-bottom corner near J1.**

### Verification

```
cd /Users/wells/Projects/airwriter/enclosure
.venv/bin/python -m unittest discover -p 'test_*.py'
```

```
Ran 32 tests in 4.462s

OK
```

All of Tasks 1-4's 23 tests plus this task's original 7 plus the two new
fix tests (32 total) pass. No changes under `hardware/`; `connector_solid()`
and `_grown()` are byte-for-byte unchanged.

### Files changed (this fix pass)

- `enclosure/params.py` -- `STANDOFF` 2.00 -> 3.00, comment rewritten.
- `enclosure/test_params.py` -- `STANDOFF`, `Z_FLOOR_TOP`, `Z_FLOOR_BOTTOM`,
  `EXT_H` expectations updated.
- `enclosure/test_case.py` -- two new tests on `TestPorts`:
  `test_connectors_clear_the_floor_by_at_least_0_50` and
  `test_front_wall_retains_material_above_and_below_each_port`.

Commit: `8d03d6e` "Enclosure: fix STANDOFF pin/floor interference, guard
front wall against port over-cut (W-725 Task 5 fixes)".

---

## Fix report: third round -- the real clearance bug, the chamfer inversion, and four tests that could not fail

Status: **DONE**

A thorough review (not the two rounds above) found that `_grown()`'s
vertex-hull approach didn't just approximate conservatively -- it was
wrong in the unsafe direction: it hulls the BRep's topological *vertices*
(corner points), which chords across every curved face and returns a
solid *smaller* than the true connector everywhere a surface is round.
Real spec violation: J1's clearance to the finished wall measured
**0.0324mm** against a 0.30mm requirement. The review also found the
USB-C chamfer flared the wrong way and over-cut the floor, and that four
tests in this task were structurally incapable of failing. `connector_solid()`'s
placement transform was independently re-validated by the review (11 of
J2's through-hole pads probed against the placed STEP, all hit metal, a
1mm shift returns zero) and was **not** touched here.

### Finding 1: `_grown()` hulled vertices, not the solid

Fixed per the review's prescribed technique: tessellate the connector's
real boundary (`solid.tessellate(0.05)`), hull that dense point cloud
(this alone fixes the containment bug -- a fine tessellation's hull
converges on the true solid's hull, unlike a hull of a few dozen BRep
corner vertices), then grow *that* hull outward along a fixed set of unit
directions and re-hull.

**Direction-set choice: 98, Fibonacci-spiral distributed over the
sphere.** Measured directly against the 0.30mm spec floor at
`PORT_CLEAR=0.40` (all figures from J2, same order of magnitude on
J4/J1):

| directions | clearance measured |
|---|---|
| 14 | 0.298mm -- **fails** the 0.30mm floor outright |
| 26 | 0.344mm |
| 50 | 0.371mm |
| 98 | 0.385mm |

More directions approximate a true sphere (and thus a true Minkowski
offset) more closely, so accuracy keeps climbing with no free lunch at
low counts -- 14 directions isn't just "a bit worse," it fails the spec.
The deciding factor for 98 specifically: the cost turned out to be flat
in practice. Timing 14 vs 98 directions on the same connector: 2.19s vs
2.46s -- the tessellation and the first hull-reduction dominate runtime,
not the final grow-and-rehull, so there was no real cost to buy the
tighter hull. 98 also matches the count the review had already verified
against, giving one-to-one parity with that verification.

**Performance note:** growing all ~30,000 tessellated points along 98
directions directly would be ~3 million points into `scipy.ConvexHull` --
slow. Exploited an identity instead: for finite point sets,
`hull(P (+) D) == hull(vertices(hull(P)) (+) D)` (a convex hull is decided
entirely by its own extreme points, and Minkowski sum distributes over
convex hull), so hulling the raw tessellation *first* to strip it down to
its ~300-400 own corner points, then growing only those, gives the
identical result for a fraction of the cost. Verified numerically before
relying on it: direct (all ~30k points x 8 directions) vs reduced
(hull-first, then x 8 directions) on J2 gave volumes differing by
`4.5e-13 mm^3` (float noise) at ~35% less wall-clock time. Also added a
`(ref, amount)` cache (`_GROWN_CACHE`) since the test suite calls
`_grown()` for the same ref/amount combination several times --
`ConvexPolyhedron` results aren't mutated by the boolean ops callers
apply, so this is safe the same way the existing `_STEP_CACHE` is.

**Measured clearances after the fix** (distance from the surviving wall
to each connector's real solid, at production `PORT_CLEAR=0.40`):

| ref | clearance |
|---|---|
| J2 | 0.3849mm |
| J4 | 0.3849mm |
| J1 | 0.3849mm |

All comfortably clear the 0.30mm spec floor, with headroom below the
nominal 0.40mm growth (the ~0.015mm gap is the discrete-direction-set
approximation, consistent with the table above).

`_grown()`'s docstring is rewritten to state the real correctness
argument (the Minkowski-sum-distributes-over-hull identity, twice: once
for why tessellation-then-hull is correct, once for why hull-first is a
valid speed optimization) instead of the disproven "the hull always
contains the solid" claim.

**Before/after, `_grown(ref, 0.05)` null-shape bug (minor finding):**
resolved as a side effect -- no longer calls `offset()` at all, so there
is no OCCT offset tolerance to fail on. Confirmed: `case._grown("J2",
0.05)` now returns a valid solid (`is_valid=True`, volume 2804.9mm^3).

### Finding 2: `test_openings_clear_each_connector_by_at_least_0_30` could not fail

Rewritten per the review's prescription: probe the surviving local wall
material and assert its real distance to the connector's own solid, via
`Shape.distance_to()`, instead of intersecting the tray with the same
0.30 envelope that was already subtracted from it at 0.40.

**Before/after** (reproduced the exact old vertex-hull bug in a scratch
script, rebuilt the tray with it, and ran the new distance-based
assertion against that broken tray):

| ref | BEFORE (vertex-hull `_grown`, Finding 1's bug) | AFTER (tessellated-surface `_grown`) |
|---|---|---|
| J2 | 0.3324mm -- pass | 0.3849mm -- pass |
| J4 | 0.3324mm -- pass | 0.3849mm -- pass |
| J1 | **0.0324mm -- FAIL** | 0.3849mm -- pass |

This exactly reproduces the review's own numbers for the broken state
(0.3324 / 0.3324 / 0.0324), confirming both that the reproduction is
faithful and that the rewritten test catches it (J1 fails the 0.30
requirement) where the old subset-intersection assertion could not.

### Finding 3: the USB-C chamfer was inverted and over-cut vertically

Replaced the `Cone` (whose `rotation=(90,0,0)` put its wide end toward
the *board*, not the wall's outer face) with `_usbc_flare()`: a
`loft()` between two `RectangleRounded` profiles sized directly from the
connector's real X and Z bounding-box extents -- one at the transition
into the straight `_grown()` envelope, one at the wall's outer face,
widening outward. Because the profile's Z size comes from the
connector's own Z extent (not a radius derived from its X width, the old
bug), the vertical reach is naturally clamped to the port's real height
and can no longer plough into the floor slab or overshoot above the
receptacle.

**Before/after, orientation** (cross-section width at four Y-slices
through J1's opening, wall outer face at Y=-3.00):

| Y | OLD cone (bug) | NEW flare (fixed) |
|---|---|---|
| -2.99 (outer face) | 9.770mm | **12.130mm** |
| -2.50 | 10.750mm | 11.150mm |
| -2.00 | 11.750mm | 10.150mm |
| -1.81 (inner) | 12.130mm | **9.770mm** |

The old cone was narrowest exactly where a plug enters (9.77mm at the
outer face, widening to 12.13mm inside) -- backwards from "a plug's
overmould needs somewhere to go." The new flare is wide at the outer
face and narrows inward, matching the stated intent, and the endpoint
widths are the same two numbers, just swapped ends -- confirming this is
purely a direction fix, not a size change.

**Before/after, vertical over-cut / floor nick** (material removed from
a thin 9mm x WALL x 0.4mm band sitting right at `Z_FLOOR_TOP`, under
J1's X span):

| | OLD cone | NEW flare |
|---|---|---|
| Z range of the chamfer/flare solid | -4.965 .. 7.175 | -2.600 .. 4.810 |
| material removed from the near-floor band | 0.7734mm^3 | **0.0000mm^3** |

The port's real Z extent is -1.00 .. 3.21 (4.21mm tall). The old cone's
Z reach (12.14mm, derived from J1's 8.94mm X size swept as a circular
radius) had nothing to do with that and dipped 0.365mm below
`Z_FLOOR_TOP`; the new flare's Z reach (7.41mm, derived from the real
4.21mm port height plus clearance/chamfer margins in both directions)
stays 2.0mm clear of the floor and removes zero material there.

### Finding 4: nothing asserted the ports were actually open

Added `test_ports_are_actually_open`: for each of J2, J4, J1, a small bar
probe spans the full wall thickness (Y from `-WALL` to `0`) at the
connector's own centre and must find (almost) no material.

**Before/after** (built `port_cutouts()` with the grown hulls alone, no
`_usbc_flare()`, matching what the review described):

| ref | BEFORE (grown hulls only) | AFTER (grown hulls + flare) |
|---|---|---|
| J2 | 0.0000mm^3 -- pass | 0.0000mm^3 -- pass |
| J4 | 0.0000mm^3 -- pass | 0.0000mm^3 -- pass |
| J1 | **4.4357mm^3 -- FAIL (blind port)** | 0.0000mm^3 -- pass |

J1 is the only one that needs the flare to reach the outer face (J2/J4's
straight mini-DIN barrels already reach it on their own), which is why
only J1 fails without it -- consistent with the review's description of
a completely blocked USB-C port.

### Finding 5: the front-wall guard test couldn't detect its own failure

Rewrote `test_front_wall_retains_material_above_and_below_each_port` to
probe fixed bands (`Z_WALL_TOP - 0.8 .. Z_WALL_TOP` and
`Z_FLOOR_TOP .. Z_FLOOR_TOP + 0.8`, both structural constants that don't
move with `PORT_CLEAR` or a connector revision) and require an absolute
minimum surviving thickness (0.5mm) instead of a fraction of the
probe anchored to the live grown envelope.

**Before/after**, at a deliberately inflated `PORT_CLEAR=3.0` (the same
value the review used to show the old test still passing) -- ran both
the literal old (anchored-to-live-envelope) assertion and the new
(fixed-band, absolute-threshold) assertion against the same broken tray:

| | OLD anchored version | NEW fixed-band version |
|---|---|---|
| J2 top/bottom | 12.3/15.7 of 22.3mm^3 (>10%) -- **pass** | 0.282mm / 0.306mm -- **FAIL** (< 0.5mm) |
| J4 top/bottom | 12.3/15.7 of 22.3mm^3 (>10%) -- **pass** | 0.282mm / 0.306mm -- **FAIL** |
| J1 top/bottom | 12.5/12.5 of 16.7mm^3 (>10%) -- pass | 0.800mm / 0.579mm -- pass |

The old assertion passes even at this clearly-broken `PORT_CLEAR=3.0`,
reproducing the review's finding exactly. The new assertion correctly
fails for J2/J4 (whose walls thin to ~0.28-0.31mm there) while still
passing for J1 (whose flare geometry doesn't reach these particular
bands at this `PORT_CLEAR`). At the real production `PORT_CLEAR=0.40`,
the new assertion passes cleanly for all three (0.800mm at every band).

### Finding 6: no placement-registration test

Added `board_geom.pad_positions(ref)` (parses a footprint's through-hole
pads straight out of the board file, independent of
`connector_solid()`'s STEP-placement transform) and
`test_j2_placement_registers_against_the_boards_own_pads`: maps each of
J2's 11 pads (8 signal + 3 shield/mounting posts, confirmed by count)
footprint-local -> board -> case via `board_geom.local_to_board()` +
`to_case()`, and probes for real material in `connector_solid("J2")`
just below the board's underside at each one. Threshold (`0.005mm^3`) is
set from the physics -- a pin's tail either passes through a small probe
box or it doesn't -- not from the measured values (0.025mm^3 -
0.180mm^3 here), per the task's own instruction.

**Before/after** (mis-placed the connector solid in X and re-ran the
same 11 probes):

| mis-placement | pads with real material |
|---|---|
| +6mm X (matches earlier finding) | 0 of 11 -- **FAIL** |
| +1mm X | 1 of 11 -- **FAIL** |
| none (real placement) | 11 of 11 -- pass |

### Minor findings

- **Stale comment / redundant Z clip in `test_no_connector_touches_the_tray`**:
  fixed. The `above_floor` clip and its comment (citing the pre-fix
  `Z_FLOOR_TOP = -3.6` and a 0.15mm interference, both resolved by the
  second round's `STANDOFF` change) are gone; the test now checks the
  unclipped intersection directly. Confirmed it still passes unclipped
  (0.0mm^3 for all three connectors) now that the floor clearance is
  fixed at the source.
- **Back-side-footprint guard**: added. `connector_solid()` now raises
  `NotImplementedError` if a footprint's layer isn't `F.Cu` (added
  `Footprint.layer`, parsed from the board file's own `(layer ...)`
  field). Verified by monkeypatching a cached `Footprint` to `B.Cu` and
  confirming the raise fires with a clear message; reverted immediately
  after (this was a throwaway probe against the parser's cache, not a
  persisted change).
- **`_grown(ref, 0.05)` null-shape bug**: gone, see Finding 1 above --
  not a separate fix, a side effect of no longer calling `offset()`.

### Full suite

```
cd /Users/wells/Projects/airwriter/enclosure
.venv/bin/python -m unittest discover -p 'test_*.py'
```

```
Ran 34 tests in 21.9s

OK
```

34 tests: the prior 32 plus `test_ports_are_actually_open` and
`test_j2_placement_registers_against_the_boards_own_pads`.
`connector_solid()`'s placement transform is byte-for-byte unchanged from
the first round.

### Files changed (this fix pass)

- `enclosure/case.py` -- `_grown()` rewritten (tessellate-then-hull,
  directional growth, `_GROWN_CACHE`); `_sphere_directions()` /
  `_GROWN_DIRS` added; `connector_solid()` gained the F.Cu layer guard;
  `port_cutouts()`'s chamfer replaced by the new `_usbc_flare()`; `offset`
  import dropped, `RectangleRounded`/`loft`/`math` added.
- `enclosure/board_geom.py` -- `Footprint.layer` field, `pad_positions()`.
- `enclosure/test_case.py` -- `test_openings_clear_each_connector_by_at_least_0_30`
  rewritten (distance-based); `test_front_wall_retains_material_above_and_below_each_port`
  rewritten (fixed bands, absolute threshold); `test_no_connector_touches_the_tray`
  simplified (clip removed); two new tests:
  `test_ports_are_actually_open`, `test_j2_placement_registers_against_the_boards_own_pads`.

Commit: `40e817d` "Enclosure: fix port-cutout clearance envelope, USB-C
flare direction, and four tests that could not fail (W-725 Task 5 review
fixes)".

---

## Fix report: fourth round -- the dead layer guard, and a real USB-C flare regression guard

Status: **DONE**

A scoped re-review confirmed five of six prior findings cleanly and left
two narrow ones. Neither touches `connector_solid()`'s transform,
`_grown()`'s envelope, or `_usbc_flare()`'s geometry -- all three stay
byte-for-byte unchanged.

### Finding A: the back-side-footprint guard was dead code

`board_geom.py`'s `_all()` read a footprint's layer with
`_FP_LAYER.match(blk)`. `re.match` anchors at position 0, but every block
`_blocks()` yields begins with the literal characters `"\n\t(footprint "`
-- and `_FP_LAYER` itself starts with a literal `\(footprint`, no leading
whitespace in the pattern. So the match failed at position 0 on every
single block, front-side or back-side, and every footprint silently fell
through to the dataclass default `layer="F.Cu"`. Confirmed directly:

```
>>> bg.footprint('TP2').layer   # pre-fix
'F.Cu'          # wrong -- TP2 is really B.Cu
>>> bg.footprint('J2').layer    # pre-fix
'F.Cu'          # right, but only by accident of the default
```

This meant `connector_solid()`'s `NotImplementedError` guard for
non-F.Cu footprints (added in the third round) could never fire, for any
footprint on the board.

**Fix:** `.match(blk)` -> `.search(blk)` (one line, `board_geom.py:145`).

**The test goes through the real parser, not a fixture.** The prior
round's self-review claimed this guard was "verified by monkeypatching a
cached Footprint to B.Cu" -- which bypasses `_FP_LAYER` entirely and
would have passed identically whether `.match` or `.search` was used.
Added `test_back_side_footprints_read_b_cu_through_the_real_parser` to
`test_board_geom.py`: it calls `bg.footprint(ref)` for the board's five
real back-side footprints (confirmed by scanning all 138 footprint
blocks: exactly `TP2`, `TP4`, `TP5`, `TP7`, `TP8` are `B.Cu`, the
remaining 133 are `F.Cu`) plus `J2` as a known front-side part, and
asserts the layer read off each.

**Red, before the fix** (ran the new test against the untouched
`.match()` code):

```
AssertionError: 'F.Cu' != 'B.Cu'
 : TP2
```

**Green, after** the one-line `.search()` fix: all 138 footprints
re-scanned, counts `{'F.Cu': 133, 'B.Cu': 5}`, matching the board file
exactly; the new test and the full `test_board_geom.py` suite (10 tests)
pass.

### Finding B: the corrected USB-C flare had no regression guard

Round 3 fixed the USB-C flare's direction (was narrow outside, wide
inside -- backwards) and its vertical over-cut into the floor slab, but
nothing pinned either property down: the entire suite stayed green
against the ORIGINAL inverted cone too, in the same way it stayed green
through the flare fix itself. Added two tests to `test_case.py`'s
`TestPorts`:

**`test_usbc_flare_widens_from_the_wall_interior_to_the_exterior`** --
slices `port_cutouts()` with a thin Y slab at J1's Z centre (a 15mm-wide
probe centred on J1's own X, clear of J2/J4) at the wall's outer face
(Y=-2.99) and at the flare-to-envelope transition (Y=-1.81), and asserts
the outer opening is at least 1mm wider than the inner one.

**`test_port_cutouts_do_not_intersect_the_floor_slab`** -- intersects
`port_cutouts()` with a box spanning the full floor slab
(`Z_FLOOR_TOP..Z_FLOOR_BOTTOM`) and asserts the volume is (within
1e-4mm^3 of) zero.

**Verified both directions.** Reconstructed the exact pre-fix cone from
git history (`git show 8dd823e:enclosure/case.py`, the commit right
before the flare fix) --
`Cone((j1.size.X + 2*(PORT_CLEAR+USBC_CHAMFER))/2, (j1.size.X + 2*PORT_CLEAR)/2, USBC_CHAMFER, rotation=(90,0,0))`
-- swapped it into `port_cutouts()` in place of `_usbc_flare()`
temporarily (never committed; restored from a saved copy immediately
after, confirmed byte-identical via `git diff` showing no changes), and
ran the two new tests against it:

| | old inverted cone (RED) | current `_usbc_flare()` (GREEN) |
|---|---|---|
| opening width, Y=-2.99 (outer) | 9.780mm | **12.140mm** |
| opening width, Y=-1.81 (inner) | 12.140mm | **9.780mm** |
| outer - inner | -2.360mm -- **FAIL** (< 1.0mm) | 2.360mm -- pass |
| port_cutouts ∩ floor slab | 0.1473mm^3 -- **FAIL** (!= 0) | 0.0000mm^3 -- pass |

The old-cone numbers match the widths this round measured directly off
the reconstructed cone (not copied from the task brief) and the
0.1473mm^3 floor intersection is a fresh measurement of the exact
pre-Finding-3 geometry, confirming both new tests catch the regression
they're meant to catch.

### Recorded, not fixed: `_usbc_flare()`'s `y_inner` vs. `_grown("J1", PORT_CLEAR)`'s reach

Per instruction, did not touch `_usbc_flare()`'s geometry or restructure
the code. Added a comment at its `y_inner` line recording the coupling:
`y_inner` is hardcoded to `-WALL + USBC_CHAMFER` (currently -1.800) while
`_grown("J1", PORT_CLEAR)`'s own bounding box reaches -1.891 (verified
today: `case._grown("J1", p.PORT_CLEAR).bounding_box().min.Y ==
-1.8910642842345355`) -- a 0.109mm overlap today. If `USBC_CHAMFER` is
ever lowered enough to push `y_inner` past -1.891, a blind pocket reopens
between the flare and the straight envelope. Re-verified the cited
failure mode directly: monkeypatching `p.USBC_CHAMFER = 1.0` and
rebuilding `port_cutouts()` leaves `0.4357mm^3` of material blocking J1's
port (measured via the same bar-probe `test_ports_are_actually_open`
uses), matching the 0.436mm^3 the task description cited. That existing
test would catch this today; no new test asserts the overlap margin
itself, only its symptom.

### Full suite

```
cd /Users/wells/Projects/airwriter/enclosure
.venv/bin/python -m unittest discover -p 'test_*.py'
```

```
Ran 37 tests in 29.6s

OK
```

37 tests: the prior 34 (10 in `test_board_geom.py` + others) plus the
one new back-side-layer test and the two new USB-C flare regression
tests. `connector_solid()`, `_grown()`, and `_usbc_flare()`'s geometry
are byte-for-byte unchanged from the third round.

### Files changed (this fix pass)

- `enclosure/board_geom.py` -- `_FP_LAYER.match()` -> `.search()`
  (`board_geom.py:145`).
- `enclosure/case.py` -- comment only, at `_usbc_flare()`'s `y_inner`,
  recording the coupling to `_grown("J1", PORT_CLEAR)`'s reach.
- `enclosure/test_board_geom.py` -- new test
  `test_back_side_footprints_read_b_cu_through_the_real_parser`.
- `enclosure/test_case.py` -- two new tests on `TestPorts`:
  `test_usbc_flare_widens_from_the_wall_interior_to_the_exterior`,
  `test_port_cutouts_do_not_intersect_the_floor_slab`.

Commit: `5894ab9` "Enclosure: fix dead back-side-footprint guard, add
USB-C flare regression tests (W-725 Task 5 re-review)".
