wr/airwriter/docs/enclosure-build-log/task-8-report.md

# Task 8 report: export, printability gate, README

Branch `wells/airwriter-enclosure`, commit `56273d2` "Enclosure: export,
printability gate, README (W-8)".

## What was implemented

- `enclosure/test_printable.py` — the printability gate, exactly the code the
  brief specifies for Step 1, with one deliberate change to `downward_flats()`
  (see "The check that was wrong" below): a `f.geom_type != GeomType.PLANE`
  guard added before the normal check.
- `enclosure/export.py` — writes `out/airwriter-tray.{step,stl}` and
  `out/airwriter-lite-lid.{step,stl}`, printing each part's bounding box and
  volume. Verbatim from the brief.
- `enclosure/build.sh` (executable) — runs the full test suite, then
  `export.py`. Verbatim from the brief.
- `enclosure/README.md` — build instructions, print orientation, the M2.5×10
  correction, and the first-print checklist with the reset-pinhole caveat.
- `enclosure/case.py` — five additions to make the gate pass (see below).

## What the gate found on first run, and what changed in response

Ran `test_printable.py` against the Task 1–7 `case.py` (unmodified). 2 of 5
tests failed, reporting 5 tray offenders and 4 lid offenders (exact
coordinates below). One tray offender turned out to be a false positive in
the check itself, not the geometry; the other eight were real.

### Real offenders — fixed in `case.py`

1. **DIP slot ceiling** (`(-1.6, 30.0, 9.5)`, area 53.1mm²): `dip_slot()`
   cuts a plain box into the west wall; its own top face is a ~19mm-wide,
   dead-flat horizontal ceiling with nothing under it once printed
   floor-down.
2. **J2's port-opening top** (`(13.1, -1.4, 13.1)`, area 32.9mm²) and
   **J4's** (`(32.6, -1.4, 13.1)`, area 32.9mm²): `_grown(ref, PORT_CLEAR)`
   approximates each mini-DIN connector's shell as a convex hull; the
   shell's own mating flange is genuinely flat on top, so the grown hull's
   top stays flat too — an unsupported ceiling inside the front wall.
3. **J1's (USB-C) port-opening top** (`(52.1, -0.9, 3.6)`, area 8.4mm²):
   same mechanism as #2, on the USB-C receptacle's shield.
4. **Lite lid insert bores** (four, all at Z=4.5 — `(5.6,12.3)`,
   `(53.4,12.3)`, `(5.6,98.6)`, `(56.4,98.6)`): each M2.5 heat-set insert
   bore is a blind cylindrical hole (`INSERT_DEPTH`=4.50 into a 14.34mm-tall
   leg) with a flat bottom — solid above, void below, inside the leg.

**Fix, offenders 1–3:** added `_ridge_roof()` (a 45° ridge-roof
`ConvexPolyhedron`, tapering across whichever dimension is the wall's own
short axis — X for the west wall, Y for the front wall — so the rise is
always half the *wall's* thickness, not half the *opening's* width), plus
`_dip_slot_roof()` and `_port_roof(ref)` that build one over each offending
region, and `_print_reliefs()` that unions all four. `tray()` now subtracts
`_print_reliefs()` as an extra term, *not* by changing `dip_slot()` or
`port_cutouts()` themselves — those two describe the functional opening
(what the switch/connector clearance actually needs) and are exercised by
`TestPorts`/`TestSideFeaturesAndTray` in `test_case.py` against exact
bounding boxes; changing their return values would have broken those tests
for no functional reason. The relief is a printability-only add-on layered
on in `tray()`.

**Fix, offender 4:** the insert-bore loop in `lite_lid()` now also
subtracts a 45° cone from the bore's blind end down to a point
(`Cone(INSERT_D/2, 0, INSERT_D/2)`), the same idea `screw_holes()` already
uses for its own counterbore-to-clearance-bore transition.

### The check that was wrong — a false positive, not a geometry bug

Offender `(63.6, 64.8, 2.35)`, area 10.56mm², sits on the east wall at
SW1's Y — the reset pinhole. Its `geom_type` is `GeomType.CYLINDER`, not
`PLANE`: `normal_at(f.center())` evaluates to straight-down at the
parametric centre of the bore's *whole curved lateral surface* (the bottom
of the barrel), but the face itself is the full 1.20mm-diameter,
2.80mm-deep round through-hole — a curved overhang, exactly the case
`test_printable.py`'s own module docstring already says is fine ("a curved
overhang... prints fine at these diameters"). The area even confirms it:
π × 1.20 × 2.80 = 10.56mm², the full cylinder's lateral area, not a
fragment of a flat cap. Sampling one point's normal cannot distinguish a
curved face from a planar one; `downward_flats()` now also requires
`f.geom_type == GeomType.PLANE`. This is documented inline in
`test_printable.py`.

## Red/green evidence for every check

All five below were re-run against the *unmodified* Task 1–7 `case.py` via
`git stash push -- enclosure/case.py` (test_printable.py is untracked, so
stash left it alone), captured, then `git stash pop` to restore the fix.

| Check | Before (unmodified case.py) | After (fixed case.py) |
|---|---|---|
| `TestTray.test_single_watertight_solid` | ok | ok |
| `TestTray.test_no_unsupported_downward_flats` | **FAIL** — 4 offenders (DIP slot ceiling, J2/J4/J1 port tops; the reset-pinhole cylinder does *not* appear here because the geom_type guard was already in place in this run) | ok — `[]` |
| `TestTray.test_walls_are_at_least_2_80_thick` | ok | ok |
| `TestLid.test_single_watertight_solid` | ok | ok |
| `TestLid.test_no_unsupported_downward_flats_printed_plate_down` | **FAIL** — 4 offenders (all four insert bores) | ok — `[]` |

The very first run (before the geom_type guard existed) additionally
reported the reset-pinhole cylinder as a 5th tray offender; with the guard
in place it no longer appears in the "before" row above, confirmed directly:

```
WITHOUT geom_type filter: (63.6, 64.8, 2.35) area 10.56 GeomType.CYLINDER
WITH geom_type filter:    (nothing)
```

### Deliberate breaks, to confirm each check can actually fail

Per the verification bar, constructed a broken variant for every check
(scratch scripts, no files left modified):

- **`test_single_watertight_solid` (tray):** offset one standoff's mount
  hole by (+40, +40) so it floats disjoint from the shell instead of fusing
  to it. `is_valid=True, solids=2` (assertion wants `solids()==1` → fails).
  Union-ing standoffs the *wrong* way (`shell() - standoffs()` instead of
  `+`) did **not** break it — the resulting holes are still inside one
  solid — so a disjoint-solid break was used instead, confirming the check
  catches the real failure mode (a part that doesn't actually connect) and
  not just any code change.
- **`test_single_watertight_solid` (lid):** same technique, one leg offset
  by (+40, +40) off the plate. `is_valid=True, solids=2` → fails.
- **`test_walls_are_at_least_2_80_thick`:** mutated `params.POCKET_CLEAR`
  from 0.20 to 1.00 (and its two derived `POCKET_W`/`POCKET_L`) at runtime,
  rebuilt `case.tray()`. All three probes dropped from 22.40mm³ (pass, want
  ≥22.35) to 16.00mm³ (fail, want ≥22.35) — confirms the check is sensitive
  to the actual wall thickness and not just checking its own inputs, per
  the brief's specific concern about Task 3's cavity-test bug (probe built
  from the same formula as production geometry). This test's probes use
  fixed case-frame coordinates and its own `MIN_WALL=2.80` constant, not
  `p.POCKET_CLEAR`, so it is a genuinely independent probe.
- **`test_no_unsupported_downward_flats`/`..._printed_plate_down`:** the
  red/green table above *is* this experiment — the unmodified `case.py` via
  git stash — real code, not a synthetic break.

## Exported parts

```
airwriter-tray:      68.00 x 110.27 x 22.94 mm, 36.4 cm3
airwriter-lite-lid:  62.40 x 104.67 x 15.94 mm, 11.9 cm3
```

Matches the brief's Step 6 expectation (68.00 x 110.27 x 22.94 for the tray
— the brief's own text says "21.94" in one place, which conflicts with its
own Global Constraints section stating 22.94; 22.94 is what the geometry
actually produces and is confirmed by `test_case.TestShell.test_sits_in_
the_case_frame`/`test_external_bounding_box` against `p.EXT_H`, so treated
the "21.94" in Step 6 as the typo). `out/*.{step,stl}` written, `out/` is
gitignored and untracked.

## Full suite

```
.venv/bin/python -m unittest discover -p 'test_*.py'
Ran 55 tests in ~43s
OK
```

50 pre-existing tests + 5 new `test_printable.py` tests, all green, none
regressed.

## Files changed

- `enclosure/case.py` (modified) — `_ridge_roof()`, `_dip_slot_roof()`,
  `_port_roof()`, `_print_reliefs()` added; `tray()` subtracts
  `_print_reliefs()`; `lite_lid()`'s insert-bore loop cones the blind end.
- `enclosure/test_printable.py` (new) — the gate.
- `enclosure/export.py` (new) — the exporter.
- `enclosure/build.sh` (new, executable) — the driver.
- `enclosure/README.md` (new).

`hardware/` was not touched. `hardware/airwriter/airwriter.kicad_pro` and
`hardware/combined/combined.kicad_pro` show as modified in `git status` and
`firmware/` has some untracked build output — both pre-existing at session
start, unrelated to this task, and left alone.

## Self-review findings

- Checked that `_print_reliefs()` is subtracted only in `tray()`, not
  folded into `dip_slot()`/`port_cutouts()` — confirmed by re-running the
  full suite: every `TestPorts`/`TestSideFeaturesAndTray` test in
  `test_case.py` that pins an exact bounding box on `dip_slot()` or
  `port_cutouts()` still passes unchanged.
- Checked the new ridge roofs don't eat into the wall-thickness margin the
  existing `test_front_wall_retains_material_above_and_below_each_port`
  and `test_printable`'s own wall-thickness probes rely on: the port roofs
  peak at ~14.5mm Z (J2/J4) and ~5.0mm Z (J1), both well clear of the
  Z_WALL_TOP-band probe at 15.14–15.94mm; the wall-thickness probes sit on
  the west/east/back walls, away from the front-wall/west-wall features the
  roofs touch. Confirmed by the full suite passing, not just by inspection.
- Checked the ridge-roof "gable end" triangular faces (the prism's two
  ends) don't themselves introduce new near-horizontal faces — they lie in
  constant-X or constant-Y planes, so their normals have no significant Z
  component. Confirmed empirically: `test_no_unsupported_downward_flats`
  passes with `[]`, not just with the four original offenders replaced by
  different ones.
- Confirmed `out/` produces exactly 4 files and stays untracked
  (`git status` after `build.sh` shows nothing new under `enclosure/`).
- Re-read `case.py`'s diff end to end before committing; no stray debug
  code, no changed signatures on existing public functions
  (`dip_slot()`, `port_cutouts()`, `screw_holes()`, `tray()`, `lite_lid()`
  all still take no arguments and return `Part`).

## Concerns

- `_grown()`'s convex-hull approximation is the root cause of offenders 2
  and 3 (the mini-DIN/USB-C flat tops): a real mini-DIN shell's top may not
  be perfectly flat edge-to-edge in reality, but the hull-of-tessellated-
  points construction can flatten a genuinely slightly-domed or radiused
  region into a hard flat facet wherever the tessellation is coarse enough.
  The roof relief added here is a safe, deliberately generous fix regardless
  (it only ever removes *more* material above a functional opening, never
  less), but it means the roofs are sized to the *hull's* flat top, not
  necessarily to a print-optimal minimum. Not a functional risk, just a
  note that these two roofs are slightly more material removed than a
  human designing the port shapes by hand might choose.
- The M2.5×10 vs ×8 correction and the reset-pinhole derivation caveat were
  supplied as verbatim facts by the task brief; this report and the README
  state them as given, without independently re-deriving the 5.60mm
  counterbore-seat Z or the 1.75mm actuator Z from scratch. `params.py`
  already carries the actuator-Z derivation and its own caveats in detail;
  the README points there rather than duplicating the full derivation.
- Have not test-printed either part. The gate is a geometric proxy for
  printability (no unsupported flats, minimum wall thickness, single solid)
  — it cannot catch everything a real print would (e.g. warping, first-layer
  adhesion, actual bridging-distance limits on a specific printer/filament
  even for a 45°-roofed opening). The README's first-print checklist is the
  intended backstop for that gap.
