wr/airwriter/docs/superpowers/specs/2026-10-28-lc-acrylic-top-design.md

# LC acrylic top and frame design

2026-10-28. Wells chose a clean top over screws through the acrylic, then UV-cure glue
over tape, the rev 2026.11 board over rev A, and on 2026-10-29 1/16 in (1.5 mm) cast
acrylic (Outus's 12 × 12 in sheets), after a day on 1 mm, his library's. The shop sells AirWriter LC as "the same black bottom case under a clear
acrylic top with the AirWriter mark lasered into it".

## The stack

| Part | Where | Set by |
|---|---|---|
| Tray, board, M2.5 × 10 from below | unchanged | the LC lid's hardware |
| LC frame (printed) | board face to `ACRYLIC_UNDERSIDE - GLUE_LINE` | this design |
| UV-cure glue, about 0.10 | on the four leg tops | `GLUE_LINE` |
| Acrylic top, 1.50 mm clear cast | `ACRYLIC_UNDERSIDE` (13.04) to 14.54 | `ACRYLIC` |

The acrylic's face is at 14.54, `ACRYLIC_FACE_UNDER` (0.10) under the rim, whatever its
thickness: the frame's height follows `ACRYLIC`. A 1.5 mm sheet's underside is at
13.04, on J2 and J4's shells as the Pro's panel is, and on the glued leg tops. A sheet up
to 1.6 still sits no prouder than the rim; 1 mm would rest on the frame alone, 0.50 over
the shells; 3 mm would have to sink 1.50 past them, so it stands proud. A frame that prints up to 0.10 tall leaves the face no
prouder than the rim; one that prints short leaves the glue more gap to fill. The first
version left 0.50 for VHB tape; glue in a gap that deep could let the back of the sheet
settle before it cured.

## The acrylic

`hardware/panel/airwriter-lc-top.svg`, from `lc_top.py`: the panel's own outline cut
(62.00 × 104.27, R2.0), the test hole cut at the panel's 3.8 mm, and the LC's own art,
`hardware/panel/svg/lc.svg` (Wells's Figma Frame 17), frosted: "AirWriter LC", "airprint
to serial bridge", rev 2026.11, the 18 gold dots, the test dot and the dot under it, the
serial and power labels and the three rules, the power slash. The art draws the Pro's 37
lit dots in the background's colour, and they stay clear but for one: the LC fits one of
the 37 LEDs, D26, the one under the test dot, as its status light
(`docs/hardware-rev-2026-11.md`, "The LC's one light"), and the art draws its dot gold, so
it is frosted and lights. The frosted slash sits over D3, so the power light shows in it.

On rev 2026.11 (15 mm SW3) the test plunger stands 0.46 above the acrylic; on rev A
(16 mm) 1.46.

## The frame

One printed part, in `enclosure/lc_frame.py`:

- **Legs:** the LC lid's four, factored out as `case.lc_legs()`: Ø6 at H1–H4, an
  M2.5 heat-set insert in each foot, trimmed round J1, J2 and J4's hulls, feet relieved
  for C22. They stop `GLUE_LINE` under the acrylic, and their tops are the glue pads.
- **Rim:** `FRAME_RIM_H` (2.50) deep at the top, from `RIDGE_CLEAR` short of the pocket wall
  to `FRAME_RIM_IN` (1.50) inside the board edge, like the lattice's lip. It makes the
  four legs one part, so the acrylic goes on square, and it shows as a thin black line
  just inside the tray's rim. J2 and J4's hulls cut it at the front. The short piece
  between them would be loose, so it's left off.
- **Arms:** one `FRAME_ARM_W` (2.40) wide from each leg out to the side rim, at rim depth.
- **Light tube:** under a clear top D3 would light the whole corner, so the frame carries
  a tube round the LC's slash (`hardware/panel/lc_slash.polys.json`, written by
  `lc_top.py` from the art) and D3's envelope: on rev 2026.11 a 3 mm LED on a 4 mm
  spacer standing to 11.85, with R17 nearby outside. Walls run from the board to the
  top, `LATTICE_WALL` thick where there is room; on the east the spacer stands 0.38 from
  the board edge, so that wall runs out to the rim's outer line and is one printed line
  (`FRAME_TUBE_MIN_WALL`, 0.45), as the lattice's was let be on that board. Its inside
  corner follows the rim's rounded one, so the corner keeps that thickness too. A
  `FRAME_CAP` (0.60) cap closes it but for a slit the slash's own shape, right under the
  frost, 0.49 over the LED. D3's grown shadow is left out of the frame's part voids: the
  tube clears D3 itself, and the shadow would cut the east wall away.
- **Clearances:** the rim, arms and tube clear every other part's STEP envelope grown by
  `PART_CLEAR`/`PART_TOP_CLEAR` (`components.py`, as the lattice does).

Printed rim-down (the glue face on the bed, the flattest face), legs up, no supports: the
same orientation as the LC lid, and the same printability gate.

## The light tube

A second printed part, `enclosure/lc_light.py`. Under the clear top D26 would light
the board round it, so it gets a tube as D3 does. D26 sits mid-board, though, about
27 mm from the frame, and joining the two would take an arm across the clear top, so
the tube is a part of its own (Wells, 2026-10-29):

- **Walls:** `LATTICE_WALL` (0.80), from the board to `LC_LIGHT_PLAY` (0.20) under the
  acrylic, round D26's and C46's courtyards with `LC_LIGHT_CLEAR` (0.25) inside. They hug
  the two parts, which is what keeps the loose tube on its dot: about 0.5 of wander at
  most. JP1's solder blob is 0.75 outside the south wall and SW3 0.93 outside the north.
- **Cap:** `FRAME_CAP` (0.60), with a round `LC_LIGHT_APERTURE_D` (3.00) opening centred
  on the dot. The dot is 5.64 across; the smaller opening is a diffuser, since the LEDs
  are bright (Wells).
- **Held by:** the board below and the acrylic above. Nothing glues or screws it.

Printed cap-down, walls up, no supports.

## Assembly

1. Board into the tray. Heat-set inserts into the frame's legs.
2. Frame onto the board, four M2.5 × 10 from below. Bridge JP1 with solder if it
   isn't yet, and set the light tube over D26 (the LED under the test button), cap up.
3. Scuff the four leg tops with sandpaper and put a small dab of UV-cure glue (395–405 nm)
   on each. Squeeze-out shows through the clear top at the front legs.
4. Peel the acrylic's film off both faces, drop it into the pocket frosted face up, and
   press it down onto the shells and legs. The pocket lines it up.
5. Cure through the acrylic, longer than the glue's label says: many clear acrylics block
   some UV. The back legs sit under frosted dots, which scatter the light; give them
   longer still. Try the glue and light on an offcut of the same sheet first.

To open, unscrew from below: the frame and acrylic come out together.

## Calls made here

- Glue on the four leg tops only. The acrylic is captive in the pocket and the frame is
  screwed down, so the glue only has to stop the acrylic lifting off the frame.
  UV-cure over two-part epoxy: clear, and it sets only when lit, so the acrylic is lined
  up in the pocket first. Not superglue, whose fumes haze clear acrylic, nor acrylic
  cement, which doesn't take to the printed frame.
- The legs' tops at H1 and H2 sit under the frosted corner dots, so two of the four glue
  pads don't show. H3 and H4's do, as Ø6 discs below the subtitle.
- D26's tube is loose, not part of the frame: an arm out to it would show across the
  board through the clear top. Its opening is smaller than its dot, to soften the LED.
- The printed LC lid stays, for anyone without a laser. Its plunger bore goes from
  2.25 to 3.80, the panel's hole: 2.25 dated from the old switch and stopped the
  measured 3.1–3.2 plunger.

## What only a print settles

- Whether the glue cures through this acrylic, and whether the acrylic then sits flush.
- How the black rim and the two front leg pads read through the acrylic.
- How brightly the slash glows through the slit, and whether the frost scatters light
  along the sheet into the other frosted marks.
- How D26's dot reads through its 3 mm opening: bright enough, and soft enough at the
  edge of the dot; and whether the loose tube stays square on the board while the top
  goes on.
