wr/airwriter/docs/traps.md

# Traps

Gotchas that are still true, each of which cost real time at least once. Edit in place: when
a trap is fixed in code, delete it here (or move the reason into a comment at that code).
Traps already explained in a code comment are listed only when the comment is easy to miss.

## Firmware, FreeRTOS, ESP-IDF

- **A new Kconfig option doesn't reach an existing build directory by itself.** After an edit
  to `main/Kconfig.projbuild`, `idf.py build` in a build directory configured before it can
  compile with the old `sdkconfig.h`: a new `CONFIG_` reads as undeclared (W-1109's job buffer
  size). `idf.py reconfigure build` brings it in. Each board's build directory (`build/`,
  `build-2026.11/`) needs it once.
- **The bootloader doesn't see main's Kconfig.** Its hook (`bootloader_components/airwriter_boot`)
  can't read `CONFIG_AIRWRITER_*`, so it tells rev 2026.11 from rev A by
  `CONFIG_ESPTOOLPY_FLASHSIZE_16MB`, and main.c ties each board's build to its flash size. Its
  pins are numbers, checked against main's in main.c.

- **A held TLS session in internal RAM starves Wi-Fi.** With mbedTLS on internal RAM, Infinite
  Mac's relay (W-1076) took ~45 KB and left 4-13 KB (91 bytes at a handshake's worst): the
  settings page stalled 25 s at a time and every reconnect failed. `CONFIG_MBEDTLS_EXTERNAL_MEM_ALLOC`
  in `sdkconfig.defaults.esp32s3` fixed it (~42 KB free with the relay up). `/api/et`
  `internal_ram` shows free, largest block and the low mark without a console; `/api/status`
  `internal` shows free and the low mark in a reply small enough to fetch when it is short.
  `/api/mem` (W-1094) shows what held it at its lowest: blocks by size, each task's stack and
  spare, failed allocations; `POST /api/mem/reset` starts a new low. The console's `mem:` lines
  give the low between marks (a relay connect, a job).
- **Every static buffer is Wi-Fi's loss.** `.bss`, `.data` and task stacks are internal RAM,
  which Wi-Fi and lwIP buffer in. W-1082's first build added ~15 KB of statics: every reply
  over one TCP segment (~1.4 KB) crawled or stalled, on ports 80 and 631 alike, with no error
  but `httpd_sock_err ... 104`, while pings and small replies were fine. Put big state in
  PSRAM (`heap_caps_calloc(..., MALLOC_CAP_SPIRAM)` at start); a static with an initialiser
  goes to `.data` whole. Keep internal only what must be: a stack whose task writes NVS, and
  what an interrupt or DMA touches. Statics crept back to 72 KB by W-1088 (the three EtherTalk
  links alone 22 KB); W-1094 moved 60 KB of them to PSRAM: state used before its owner starts
  is a block a constructor makes (`et_mem_t`, `lt_mem_t`), reply buffers are made at first
  use. On board 1 idle free went from ~26 KB to 86.6 KB, and an iPhone job's low from 107
  bytes to 68 KB. Check with `idf.py size-components` (`liblocaltalk.a` `.bss` was 48 KB).
  Any `malloc` under 16 KB (`SPIRAM_MALLOC_ALWAYSINTERNAL`) lands internal too: a 300 dpi
  page's rip rows (~30 KB) took it to 923 bytes, so row buffers come from `bigmem.h`.
- **An unread TCP upload holds internal RAM.** Received frames stay in Wi-Fi's internal
  buffers until the socket is read, and more than the 5.7 KB window's worth. An AirPrint job
  left waiting for the job lock with its body unread took internal RAM from 26 KB to 6.8 KB
  in 25 s. Then it could not start its rip task and was aborted (W-1076 bench). A Print-Job
  that cannot have the printer now is told busy (the sink's `claim`). Never leave a socket
  unread for long.
- **A failed UDP send is usually only a full queue.** Wi-Fi's TX buffers come from internal RAM
  one per frame, so a burst (a PAP reply is eight frames) on top of an upload and a rip makes
  `sendto` fail with ENOMEM. Dropped, each lost PAP reply cost the printer a 2 s retry, and a
  photo page took 9 minutes at -86 dBm (W-1086). The tunnel and the Wi-Fi link wait 10 ms and
  try again (`et_send_patiently`); `/api/et` `tunnel_retries` counts the waits.
- **Broadcasts at boot starve a TLS handshake.** W-1088's first build sent six AppleTalk
  lookups the moment the laser task started, beside Infinite Mac's TLS handshake: esp-aes failed
  to allocate, mDNS dropped what it received, the relay's connect failed, and internal RAM's low
  mark was 23 bytes. The first look now waits 10 s and its lookups go 300 ms apart (low mark
  ~6.6 KB). Anything that bursts frames should wait for the handshakes, or space itself.
- **With internal RAM short, a task cannot be made, and an ignored `xTaskCreate` fails
  silently.** The OTA that installed W-1094's build (internal low 23 bytes on the old one)
  answered "ok" and never restarted: `/api/update` sat at "restarting" for 3+ minutes until
  `/api/restart`, because `fw_update_restart` dropped the failed create of its reboot task.
  It, and the Wi-Fi save's, now restart from the caller's task instead. Check every
  `xTaskCreate` whose task must run.
- **`SPIRAM_TRY_ALLOCATE_WIFI_LWIP` is not the cure.** It forces Wi-Fi to 16 static TX buffers in
  internal RAM: idle free fell from 29 KB to 13 KB with a 5 KB largest block, no job could
  start its rip task, and board 1 fell off Wi-Fi until replugged.
- **ESP-IDF's defaults are slow: 160 MHz and `-Og`.** `sdkconfig.defaults.esp32s3` sets 240 MHz
  (W-1143), but a local sdkconfig made before keeps 160 until it gets
  `CONFIG_ESP_DEFAULT_CPU_FREQ_MHZ_240=y`. The whole firmware stays at ESP-IDF's debug
  optimisation; the rip's components ask for `-O2` in their own CMakeLists (SPEC §3.7), which a
  new per-row component should do too.
- **The rip task's stack is internal and tight.** A task that may write flash (the rip's
  `done` keeps the known-good record) needs an internal stack, and 8 KB in one piece is often
  not free when a job starts: raising `PIPE_STACK` made jobs fail at once. Keep big state off
  it: `pipe_t` (ImageWriter encoder, ink screens, ~3.8 KB) is `big_calloc`'d; a LaserWriter job
  then leaves ~4.2 KB of 7 KB spare.
- **`esp_websocket_client` holds its lock while it runs your event handler.** A handler that
  takes a lock your own task holds while calling `esp_websocket_client_send_text` deadlocks. The
  relay handler only queues and sets flags; sends happen outside the EtherTalk lock.
- **`esp_websocket_client` keeps the last handshake's status after a failed attempt.** An
  `ERROR` event reads "101" (the previous success) when the real failure is TLS or a socket;
  report the TLS error first. And the event comes before the client records the error's type,
  so a connection that drops reads "type 0" with no TLS error: the client's own text ("...
  failed with -1, ... errno=104", "no PONG received") is the event's `data_ptr`. `/api/et`
  `relay` `why` keeps it (W-1094).

- **A semaphore taken on one task and given on another must be binary, not a mutex.** A mutex
  given by a non-holder trips `xTaskPriorityDisinherit` and panics the board after every job.
  Both carry the comment now. Bit `s_job_lock`
  (`W-1033 Test button reboots the board after the test page prints`) and `s_print_lock`
  (`W-1042 Buffer the whole job in PSRAM and reply when the upload is done`).
- **`pdMS_TO_TICKS()` rounds down at 100 Hz.** 3 and 6 ms become 0 ticks, so a "wait" ends at
  the next tick, 0–10 ms later. Round up to whole ticks plus one (`pic_sleep_ticks()`); the PIC
  config write failed verify until it did
  (`W-1035 PIC flash: config word verify fails because ms waits round to one tick`).
- **`uart_get_tx_buffer_free_size` is not a capacity probe, and `uart_write_bytes` has no
  timeout.** The probe sees only the ring item in service. That is why `serial_out` has no TX
  ring and writes FIFO-direct (comment in `serial_out.c`).
- **`sdkconfig.defaults*` only seed a new `sdkconfig`.** A value added there (the lwIP
  `CONFIG_LWIP_MAX_SOCKETS=16` and `CONFIG_LWIP_TCP_ACCEPTMBOX_SIZE=8`, for one) must also be
  set in an existing `sdkconfig`, or the build silently keeps the old one.
- **Floating pins from power-on until firmware claims them.** IO48 (U9's input, no pull) and IO35
  (SP3232 T1IN, a driver input with no pull) are driven low as the first statements of
  `app_main()`. IO48 floating can brownout-loop the board on a 500 mA port, not just flicker the
  LEDs. Keep the clamps first; rev B adds the resistors (`docs/hardware-rev-a.md`).
- **The LED chain needs RMT DMA.** 37 SK6812s are an 888-bit frame; without DMA the RMT driver
  refills a 48-symbol block from an interrupt every ~30 us, and that interrupt is masked while
  the flash cache is off. A Wi-Fi join (scan, handshake, NVS writes) delayed it and sent stale
  bits: the boot Spin stuttered. `led_grid.c` sends each frame from one DMA buffer (the S3's only
  DMA TX channel, so nothing else may ask for RMT DMA).
- **The LED task belongs on core 1.** Unpinned, it ran every frame on core 0 with the Wi-Fi task,
  and the WPA3 handshake starved it for about a second during the join (frames up to 316 ms
  apart, W-1060's frame log). It is pinned to core 1 and creates the strip there, so the RMT
  interrupt is on core 1 too. An unpinned task is not "free to use the idle core".
- **Rev A has no hardware LED current limit.** `LG_BRIGHTNESS_CAP` and friends in
  `led_grid_core.h` are the only limit on 37 SK6812s; raise them knowingly. All 37 lit at
  about the boot animation's heaviest draw (the Spin's then; the boot wave is held under it)
  measured 5.2 V, 0.461 A for the whole board at 160 MHz. At 240 MHz (W-1143) the boot spin
  peaked at 0.45 A, and a Personal LaserWriter 300 job drew about 0.19 A with a half-second
  peak near 0.22 A (board 1, 2026-11-13), under USB's 0.5 A.
- **Dithering one or two counts flickers.** There a dot can show only a few colours, and temporal
  dithering between them reads as flicker even at 400 fps: a rev A board's embers hopped red, yellow,
  white (W-1115). No dot rests below `LG_GLOW`, and only dots over `LG_BLEND` are dithered. A new
  dim floor goes through `glow_at` or `rest()`; a fade to or from dark may pass through.
- **The panel is not true RGB.** Through the FR4, blue reads cyan except at hue 240 (sky blue),
  270 is pale lavender, 285 onward pink, and there is no purple; under the mask white turns
  mint. Pick colours from the measured map (`tools/lights/panel_colours.json`, the
  status-language spec's material table), not from a screen.
- **A raw pyserial open on macOS drops the S3 into download mode** (the driver asserts DTR at
  open). Read the console only with `idf.py monitor` under `script` (AGENTS.md, On a real board).
- **Rev A can power up into download mode: D3 lit, panel dark, no Wi-Fi, console silent.** IO0
  has C7 (100 nF) to GND and only the S3's ~45 k internal pull-up, so it races EN's 10 k / 1 µF
  and sometimes is still low when the straps latch (board 1, 2026-10-28: `GPIO_STRAP` 0x23,
  bit 3 clear, after a power-on reset; IO0 read high once it had charged). No firmware runs, so
  none can help. An `idf.py monitor` reset and esptool's RTS reset leave it there (USB resets
  don't re-latch the straps); `esptool.py -p /dev/cu.usbmodem* --before no_reset --after
  watchdog_reset read_mac` does re-latch them, and so do SW1 or unplugging. Lifting C7 fixes
  it, and the BOOT button works without it: board 1 started normally in 50 plug-ins after
  (2026-10-29). Rev 2026.11 has a 10 k pull-up on IO0 and no C7.
- **An image built without W-1046 is rolled back at its next reboot** when a W-1046 image
  installs it over the air: the installer marks it on trial, and nothing in it ever keeps
  itself. It runs fine until then. Rebase a branch on W-1046 before OTAing it to a W-1046 board,
  or USB-flash it (which also puts the old bootloader and table back).
- **An image without W-1059 OTA'd onto a W-1059 board can overwrite the known-good slot.** It
  updates into IDF's next slot, which may be the known-good one, and never promotes itself. The
  record then vouches for nothing and the power-up reset boots the newest kept image instead.
  It also logs "no factory slot". Rebase a branch on W-1059 before OTAing it to board 1.
- **The bootloader hook (`bootloader_components/airwriter_boot`) cannot be updated over the
  air.** A bug there needs a USB flash on every board. Bench every reset path after changing it
  (`docs/superpowers/specs/2026-10-16-known-good-slot-design.md`), and keep it inside the
  bootloader's 9 s watchdog: the 5 s hold, the image checks and the app's start all count.
- **`esp_image_verify` in the app checks the RSA signature too** (signed updates), at least
  3.4 KB of stack, and that overflows `app_main`'s stack: the board crash-loops at boot. Board 1
  did twice, from a status check on the known-good slot (W-1059) and, after a failed update, from
  `esp_ota_get_last_invalid_partition()` (W-1108), which calls it out of sight; so do
  `esp_ota_check_rollback_is_possible()` and with it `esp_ota_mark_app_invalid_rollback*()`. The
  overflow lands on the other core's IPC task, so the panic names `ipc_task`, not the culprit.
  The bootloader's check has no such cost; leave whole-image checks to it, or run them on a task
  with a large stack, and run `tools/stackcheck` after adding one.
- **`idf.py app-flash` writes ota_0 and nothing else.** otadata may boot another slot, so the
  board can keep running the old image, and ota_0 may be the known-good slot. Use `idf.py flash`,
  which also blanks otadata and the record.
- **A board running a signed image refuses every image not signed with the same key**
  (`W-1048 OTA updates from GitHub releases: signed, verified, optional auto-update`), and
  `/update` says "not signed with this board's key, or damaged". A branch without W-1048 needs
  no rebase to OTA board 1: the five `CONFIG_SECURE_*` lines of `sdkconfig.defaults`, with the
  key's absolute path, in its own sdkconfig sign its build. An image running unsigned (one
  flashed as `airwriter-unsigned.bin`) refuses everything; USB-flash a signed one.
- **Never publish an image built with `idf.py` by hand.** The local sdkconfig may carry Wi-Fi
  credentials and bench options. `tools/release/release.sh` builds from `sdkconfig.defaults`
  alone and checks the image before it tags. Never rebase a branch after a release tag lands
  on it.
- **W-1048's TLS client and certificate bundle cost flash:** the S3 image leaves 37% of its 2 MB
  slot free. Check the size when adding anything large.
- **Any reboot while an OTA image is on trial rolls it back** (up to 2 min after it boots;
  `/api/status` `trial`): a crash, a Wi-Fi change from the web UI, the long-press reset, and
  `idf.py monitor` without `--no-reset`, which resets the chip when it attaches.
- **`idf.py flash` over USB leaves the printer not-ready until SELECT is toggled.** The S3 sits
  ~10 s in download mode with IO17 (UART1 TX → U2 DI) floating. Power-cycling does not do it.
  Dev-only; rev B candidate pull-up on IO17.
- **The Wi-Fi library logs one line in three calls** (prefix, message, newline), each through the
  `esp_log_set_vprintf` hook. A hook that takes each call for a line records blanks. `lb_feed`
  joins them per task.
- **The job lock is held for moments with nothing printing** (the port task's checks on the
  printer). Reading it twice in one operation can give two answers, so decide once. A request for
  the newest log lines that asked twice came back nearly empty about one time in ten.
- **PSRAM keeps its contents through a panic and a software restart** on rev A's N8R2, in the
  noinit segment (`CONFIG_SPIRAM_ALLOW_NOINIT_SEG_EXTERNAL_MEMORY`). A power cut loses it.

## Printer self-ID (W-1064)

- **`ESC ?` answers at once on board 1's ImageWriter II:** `49 57 31 30 43 0d` ("IW10C" and a
  CR; no F, no SheetFeeder), within ~150 ms, with RX at normal polarity. The CR fallback in
  `ribbon_check` was not needed. It needs the printer selected and between commands.
- **The colour ribbon is reported as C straight after the width.** `iw_self_id_ribbon` takes C
  only there, so noise read out after a black reply cannot flip the board to colour.
- **A cut-short job leaves the link dirty, and the idle `ESC ?` is then skipped** until a job
  resyncs the printer (`ribbon_ask`, `s_link.dirty`). Since W-1116 an ImageWriter record reads
  Ready only once `ESC ?` has named it since its line came up (`s_iw_named`), so a line-up
  while the link is dirty must keep the record it named, or the printer reads Offline until
  the next job (ruling R17, 2026-10-30). The plain question still runs every 5 s while the
  printer isn't answering.

## IPP, iOS, macOS, mDNS

- **iOS keys a printer on `printer-uuid`, cached capabilities included.** Changing
  `operations-supported` under the same UUID left every iPhone job at "Waiting"; a per-boot UUID
  (dev mode) left two "ImageWriter II" entries. Bump `CONFIG_AIRWRITER_UUID_EPOCH` only when
  advertised values change: a new UUID orphans the Mac's CUPS queue, whose device-uri pins
  `uuid=` (Kconfig help has the detail). The colour attributes are the exception (W-1064):
  turning `color-supported`, `print-color-mode-*` and `SRGB24` on under the same UUID, after
  the iPhone had the printer cached black-only, gave a colour option and a colour print with no
  "Waiting" (board 1, 2026-10-17). The TXT record's old copy (`Color=F`) still showed beside
  the new one on the Mac for a while.
- **Stale UUIDs linger as twins.** ESP mDNS does not cache-flush the previous boot's TXT record,
  so a UUID or name change shows two printers until client caches expire (~75 min).
- **A printer's whole answer must fit `RESP_MAX`.** Get-Printer-Attributes is encoded into one
  buffer per IPP worker (`ipp_server.c`); an answer that does not fit fails on the board and
  nowhere else. The largest is a Personal LaserWriter 300's six sheets asked for as `all` with
  `media-col-database`, 6,688 bytes (W-1102), so `RESP_MAX` is 7,680. The four workers' scratch
  (~67 KB) is in PSRAM. `tools/ipp`'s `test_qd_caps` and `test_sw_caps` print each printer's
  size; a printer with more sheets or sources raises it, in the tests too.
- **A Mac's print job carries about 50 settings of its own.** The print dialog adds
  `com.apple.print.*` attributes to every Print-Job: a one-page job to a Personal LaserWriter 300
  had a 2,082-byte attribute section (W-1102, 2026-11-13), past the 2,048 the board then read.
  The board answered 400 and macOS paused the queue ("Print job was not accepted"). The section
  must fit `HDRBUF_MAX`, now 8,192, in the same PSRAM scratch as `RESP_MAX`.
- **A Mac's print dialog sends no `media-col`.** Its job carries `media` "Letter",
  `PageSize` "Letter" and the PPD option `InputSlot` "Manual" (capitalised, nameWithoutLanguage)
  as Job attributes of their own (macOS, board 1, 2026-11-13). `ipp_req` reads `InputSlot` as
  well as media-col's `media-source`, or a Mac's manual-slot page feeds from the cassette.
- **Never advertise Create-Job / Send-Document.** With them in `operations-supported` the
  iPhone held every job at "Waiting" (SPEC §3.4).
- **iOS and macOS open 25–50 parallel Get-Printer-Attributes connections.** Workers parked on
  idle keep-alives starved them and prints timed out before Print-Job. Fixed in `ipp_server.c`
  (4 workers, backlog 8, 300 ms idle close when no worker is free); keep it when touching workers.
- **`make -C tools/ipp test` can run stale binaries.** After a `git checkout` the build folder
  may be newer than the sources; use `make -B -C tools/ipp test`.
- **macOS's `get-printer-attributes-suite.test` has a broken fifth test** (asks for `all`,
  expects only `media-col-database`). No printer passes it (SPEC §3.5).
- **A slow upload is usually the link, not the firmware.** Read the per-job `rssi` (`doc_begin`)
  and `run_document`'s upload-time / longest-wait / longest-push logs before debugging code.
  At rssi −80 an upload crawled at 270 B/s and a cut was seen 16 s late.
- **Killing `ipptool` does not cut a transfer on macOS.** The kernel delivers the buffered file,
  and with the PSRAM job buffer a small upload is already in. To cut mid-document use Cancel-Job, starve
  `ipptool` through a FIFO, or `curl --limit-rate` with a hand-built IPP request.
- **`ipptool` does not retry `server-error-busy`.** CUPS and iOS ask again; `ipptool` reports
  the busy and stops. A bench job sent while the printer is taken needs a loop around it.
- **Documents over 1 MB bypass the PSRAM buffer** and stream with TCP backpressure (an iPhone
  photo page is 6.4 MB of URF). For those a dropped upload during a pause still looks like a
  healthy pause until paper returns: the client's FIN waits behind its unsent data.
- **macOS's Supply Levels panel has a fixed layout (W-1137).** A row is a name and, on the
  right, a bar or macOS's own words: any negative level is "Level is unknown", except -3, "Level
  is OK". Nothing leaves the right side blank (a bar in the panel's colour draws as an empty
  outline), and level 0 always gets the warning triangle, whatever the low level. Names are forced
  to title case and inner capitals lowered ("AirWriter" shows as "Airwriter", "3 of 6" as "3 Of
  6"), and a newline ends the name. Colours run together stripe one bar. The type and high level
  change nothing, and a level over 100 is a full bar.
- **Testing that panel needs an AirPrint queue.** A queue added with `lpadmin -m everywhere` never
  asks the printer and shows "Information Not Available"; one whose PPD has `*APAirPrint: True`
  asks when the tab opens, and again only when the sheet is reopened.
- **`fixtures/checker.urf` cannot show printer desync.** Its 0x00/0xFF bytes print nothing when
  read out of sync; test resync with a mid-gray band.

## Wi-Fi and network

- **The home mesh: a fast scan joins the first node that answers.** It took a far node on
  channel 1 (−80 to −87 dBm) over a −46 dBm node in the same room; uploads ran at ~6 KB/s and an
  OTA failed. Firmware now scans all channels and joins the strongest AP; don't revert that.
- **The ESP32's Wi-Fi hands EtherTalk frames over with an 802.3 length of 0.** Seen from a
  BlueSCSI's DaynaPORT (W-1078): the SNAP header and the DDP datagram are intact, the length
  field is not. `et_radio_normalize` rebuilds it from the DDP header; don't trust it.
- **Infinite Mac's emulators send unicast only to MACs starting `B2`.** Theirs all do
  (`ether_js.cpp`); any other destination is dropped, so a board with another MAC answers the
  Chooser's lookup and never gets the OpenConn. The zone MAC is `B2` and the station MAC's rest.
- **An OTA refused as "not signed with this board's key, or damaged" can be a cut upload.** Seen
  once on W-1076's bench with a correctly signed image (`python -m espsecure verify_signature
  --version 2 --keyfile firmware/keys/airwriter-release.pub.pem build/airwriter.bin` passed); the
  same file went in on the next try. Verify the image, then retry once.
- **Never OTA while a job prints.** It cut two jobs on 2026-10-15. Since W-1048 `/update` refuses
  (409) while a job holds the job lock and gives way to one that arrives mid-upload, but an
  image from before W-1048 still on a board does not. AGENTS.md, On a real board.

## Serial, printer, LocalTalk

- **J2 needs Apple's crossover cable (590-0552-A / M0197).** Many reproduction "ImageWriter II"
  cables are wired straight and give a false "out of paper"; buzz pin 1 → pin 2 first (SPEC §2.4),
  or plug it from J2 to J4 and press test (the cable test, W-1055). The test can't reach pins 1/2
  (J4's are not connected), so a cable crossed on data but straight on the handshake passes.
- **TashTalk can go deaf to a fresh UART2 link with the node off** (seen once on board 1, W-1055):
  no transmit and no relay, while its CTS read ready and it took the 1024-NUL sync. A node-mode
  boot in between cleared it; the PIC is never reset by an ESP32 reboot. The cable test retries
  from a reset TashTalk (MCLR low 2 ms); its `dbg.reset` is 2 when the reset is what passed.
- **An empty U7 never answers, so silence looks like a free network.** With no PIC (or one not
  running TashTalk) CTS floats up through `uart_set_pin`'s pull-up and the node's bytes wait in
  UART2's ring; before W-1081 the node took 20 unanswered ENQs as a free node ID, went "online"
  and the panel played "LocalTalk on". `localtalk_start` now refuses (`ESP_ERR_NOT_FOUND`) unless
  TashTalk drains the 1024-NUL sync within 100 ms. A TashTalk that stops answering after the start
  still leaves the node running: anything sending through it must check `localtalk_tt_alive()`
  first (the cable test does, W-1063) or it fills the 4 KB ring and blocks with the node's lock
  held.
- **An empty U7 and a PIC with LVP off both read device ID 0x0000** (DAT is pulled down). Only
  with TashTalk silent too does 0x0000 mean an empty socket; a chip flashed with stock TashTalk
  elsewhere answers on the UART and reads 0x0000 over ICSP.
- **`uart_set_pin` releases every pin the UART had, CTS included, before routing new ones.**
  Re-routing TX and RX alone (after lending them to RMT, which also moves IO18 off the IOMUX)
  leaves CTS tied to "clear" and overruns the printer; `serial_out_lend(0)` passes all three.
- **An aborted mid-strip write leaves the printer counting `ESC G` bytes**, so it prints the next
  job's header as dots. The next job resyncs with 1280 NULs + CTRL-X (`iw_resync`,
  `W-1041 Resync the printer after an aborted job so the next job doesn't print garbage`).
  Not covered: a board reboot mid-strip.
- **Never place the print head with `ESC F`.** On board 1's ImageWriter II (test page, round 1,
  2026-10-20) lines near one landed inches to the right, whole strips and single colour passes,
  while AirPrint streams, which never use it, print right. Skip blank columns with zeros (or
  `ESC V nnnn` + a zero byte, as Ghostscript's driver does) and place text with spaces in a fixed
  pitch.
- **A line that runs past 8 in wraps:** its overflow prints from the left margin on the same row
  (an `ESC F1144` "8" in proportional type landed at 0 in). A line of exactly 1152 dots prints.
- **Nothing prints above where the head sat at power-on.** The board can add paper ahead of a
  page or drop its top rows, never roll the sheet back, so paper loaded at the tear edge (about
  2 3/16 in above the head) loses that much of every page whatever the top margin. Load it under
  the paper bail. The printer can pull paper back (`ESC r`, LFs, `ESC f`: 1 3/8 in of fanfold
  went back cleanly on board 1, 2026-10-20), but it counts its page from its top of form: pulled
  back past it, a form feed only returns to it. `ESC v` sets top of form where the head is.
- **Board 1's ImageWriter has a dead top pin.** Every strip's first row is blank, so a one-dot
  rule on bit 0 does not print at all: the test page's rules use pin 5.
- **`LT_DE` floats whenever the PIC is not driving it** (no PIC, or PIC held in reset, which
  tristates it). Tack 10 k across U6 pins 3–5 before connecting a LocalTalk network.
- **Never high-voltage program the PIC in its socket.** VPP (~9 V) lands on ESP32 IO2
  (`LT_RESET`). The ESP32 flashes it over LVP and keeps CONFIG2.LVP set so it stays
  reprogrammable without high voltage (`pic_prog.h`).
- **TashTalk never says whether a frame went out.** It does the RTS/CTS handshake itself and
  drops a frame silently after 32 failed attempts, and it relays every frame but its own. Prove
  the transmit path with `POST /api/lt/echo` (body: a Mac's node number) and look for the echo
  reply in `GET /api/log`.
- **TashTalk's CTS (RA2 → IO6) is low when it can take bytes**, the ESP32 UART's own CTS
  polarity: no inversion. Its queue is 128 bytes and a frame can be 605, so flow control is not
  optional.
- **A LocalTalk job with no printer on J2 cannot finish.** The line reads off line and the status
  word says so; whatever the Mac sends fills the spool and holds its reads, and after
  `CONFIG_AIRWRITER_STALL_ABORT` the job is aborted (CloseConn). To take a job on the bench without
  a printer, build with `CONFIG_AIRWRITER_UART_LOOPBACK`: the line reads ready and the log checks
  the job's bytes as they come back (never on a board that should print).
- **The LocalTalk node owns IO4/IO5, which are also the PIC's ICSP lines.** The web UI's
  TashTalk flash refuses while the node runs: switch the AppleTalk Port off on the page (with
  the switch never used, set DIP1-2 off mode 2; and build without `CONFIG_AIRWRITER_LT_BENCH`),
  restart, then flash. A chip without TashTalk never starts the node (W-1081), so it flashes
  straight from the AppleTalk Port card.
- **The Option Card's PAP status is a two-byte word, low byte first, not a string** (Apple TN
  NW20; `LT_IW_*` in `lt_node.h`). A LaserWriter-style `%%[ status: ... ]%%` string is wrong here.
- **Never report busy (bit 15) to a Mac about its own connection.** Mac OS 8.1's AppleTalk
  ImageWriter 7.0.1 opened PAP, read 0x8008 (busy + off line) and sent nothing until the
  connection timed out. Busy is only for the board printing someone else's job.
- **AppleTalk ImageWriter 7.0.1 ends a job with CloseConn, never PAP EOF**, after its last Data.
  It never reads back (no SendData to us), polls SendStatus about twice per chunk, writes ~88
  bytes per read with a flow quantum of 1, and sends the same native ImageWriter stream as serial
  (one short page: 11968 bytes, identical across prints). Once, the Mac sent a whole page and
  then tickled the connection for 10+ minutes without closing. Cause not found. Its next job's
  OpenConn now supersedes a connection silent for 10 s (`LT_PAP_STALE_MS`), and a job that has
  owed data for 5 min with the printer ready is closed (`LT_PAP_QUIET_MS`), so the printer is
  never held indefinitely.
- **The bench Mac's 8.1 install had no AppleTalk ImageWriter driver**, and the plain
  "ImageWriter" Chooser driver is serial only.
  Apple's `AppleTalk_ImageWriter_7.0.1.sea.bin` (Wayback copy of download.info.apple.com) works.
- **U8's ~RE rides `LT_DE`, so U8 shuts down while the PIC transmits.** Deliberate: wake is
  ≤ 1.8 µs against LocalTalk's ~200 µs inter-dialogue gap. It mirrors the U6 bug fixed on 08-22
  but is not that bug; don't "fix" it.
- **A port record and the printer on the port can be of different families** (W-1103, W-1116). A
  StyleWriter answering on a port whose records are ImageWriters, or the reverse, is a record of
  its own once it has answered twice (`pr_port_seen_sw`, `pr_port_seen`: one answer is
  `PR_SEEN_AGAIN`), never a notice; meanwhile nothing in a record's language goes out to the
  other family's printer, by what is on the port now and what the work's own questions got,
  never the list's last answer (`pr_port_other_family` is in the core and host-tested; nothing
  on the board reads it). What phones are told follows the printer on the port (`pr_port_say`,
  `port_push`); jobs, the test page and cleaning follow the record they are for (W-1116's job
  commit): a job, test page or cleaning for a port record that is not the one on the port --
  another port record's printer is -- is answered busy or 409 "Connect <name> to the printer
  port first." (`pr_port_absent`, the port sink's `port_claim`, `port_page_refused`,
  `clean_head`); a job or test page takes its family, model and screen from its own record
  (`printers_record_*`), not the port's; an ImageWriter job on a quiet port sends no page byte
  until its own model answers `ESC ?` (`colour_ok` on `pr_job_gate`). **The gate is fed only
  what the job's own questions got (`s_job_heard`), never the list's `heard`**: the list's last
  answer is history (a StyleWriter that answered and was unplugged stays `pr_port_current`), and
  a gate read from it ended a quiet-port ImageWriter job at once with "Another printer was
  connected" (task 6 review, I1). For the same reason the job's wait in `ribbon_ask` is not
  guarded on the current record's mode; `lt_print_begin` reads `s_port_sw` (a StyleWriter now)
  or a StyleWriter sighting whose repeat is pending (`s_port_confirm`, the 500 ms the port task
  lets the lock go between the two answers, R16), not `pr_port_other_family`; and `sw_swapped`
  is an ImageWriter on the port now (`printers_port_on_is_imagewriter`), not the list's last
  answer. **A job's or test page's plain question goes before any ImageWriter byte whenever the
  line is up** (the wait's 5 s question too), and a StyleWriter answering ends the call with
  nothing else sent: a StyleWriter that raises its line and hears `ESC ?` first goes deaf until
  a reset, and an original ImageWriter record would then take its silence for its own line (task
  6 re-review, N2/N3). **A job's or test page's settle is its own**: `ribbon_ask`'s wait and
  serial_out's line task poll the same pin every 100 ms, so `s_ribbon_want`/`s_ribbon_due`
  (`printer_line_changed`, on the line task) may not be set yet when the wait sees the line up;
  keyed off them alone, a II switched on mid-wait would get its first `ESC ?` ~0.3 s after the
  line-up, too soon to answer, and with an original ImageWriter record listed its silence would
  read as the original's. The wait holds 2 s from its own first sighting of the line up (or to
  `s_ribbon_due`, whichever is later), never more than 2.5 s. `s_port_sw` flips only under the
  job lock (`port_sw_sync`): read it with the lock held wherever a decision sends bytes; the
  unlocked reads (`port_live`, `box_ready`, `status_json`, `printer_line_changed`) only show
  state and may be one flip behind. And a StyleWriter-first port
  (`port_policy.h`) gets `ESC ?` only after the plain question got nothing: `swfake.py` takes
  `ESC ?` for a letter it does not know and stops listening until a reset.
- **A StyleWriter's bytes at 57600 print nothing on an ImageWriter II at 9600** (board 1,
  2026-10-27): 300 plain questions a second apart, then the full sequence (`00 FF FF FF 49`, 2 s,
  `?`) once, each followed by a CR LF at 9600, left the paper blank but for the line feeds. So a
  look or a swapped port's question costs an ImageWriter nothing; the bytes that can mark paper
  go the other way, an ImageWriter's stream to a StyleWriter.
- **A StyleWriter's rect is as wide as its rows' whole bytes** (board 1's Color StyleWriter 2500,
  2026-11-02). Letter's printable width on the 2200, 2400 and 2500 is 2916 dots, and a rect that
  wide over 365-byte rows stopped the 2500 before its first row: `1` read busy for about 6 s after `L`,
  then `1` 00 and `2` 80, with `B` never rising. It counts a row's bytes from the rect's width
  rounded down. A 2920-dot rect printed the page. The session once read that `2` 80 as spurious
  (lpstyl's testers saw 80 with nothing wrong), so the page sat in `wait_room` to the 600 s
  stall limit with the phone showing Printing; now 80 with `1` not busy and nothing draining
  ends it after 10 s. TailTalk's rects are the printable width (fine on A4's 2832); lpstyl's
  are always 2920.
- **A Color StyleWriter 2500 goes dark on its own** (board 1, 2026-11-02): about 5 minutes after
  a job's end (`E l`) its light goes out and it answers nothing, `?` and `1` alike, until
  `00 FF FF FF 49` wakes it, answering 2 s later (a job's reset, the start-up reset, Look for
  Printers'). Left alone after a reset with no job it stayed awake past 11 minutes. A second
  reset close behind the first has left it dark, twice: the start-up full sequence's at 2 s and
  a session's at 7 s, where a single reset woke it two minutes later. So a waking printer gets
  10 s before a second reset, and a job's start up to three resets. It also went dark at once
  after the reset that ends a failed page, after one Look for Printers wake it went dark again
  10 s later, and once a job's first reset darkened it while it was awake and answering; two
  more got nothing for 30 s, and the job's closing reset brought it back 70 ms later. Forum
  threads on aging StyleWriters blame power-supply capacitors that brown out when the motors
  start, which a reset does: this one may be that. A page cut short
  (the board restarting mid-page) leaves it answering nothing but a reset as well.

- **A Color StyleWriter 2500 reads busy whether it is or not** (board 1, 2026-11-07): `1`
  reads 11 from a reset on and 19 once what it was sent is done, idle, cleaning and after `E`
  alike, so its busy bit cannot say a cleaning has ended. Its 08 can: off from the reset, on
  26 s after a setup with `P` and 3.5 s after one without. A cleaning that waited for busy to go
  off, as TailTalk's does, showed Printing and held the job lock for the full 600 s, then reset
  the printer and failed, though the head was done in 26 s. A cleaning now ends on whichever
  comes first, busy off after on or 08 on after off (`wait_cleaned`).
- **A StyleWriter test page waits for whatever the board draws** (board 1's Color StyleWriter
  2500, 2026-11-07, `W-1133`). The page is drawn and sent from one task, and `serial_out` has no
  TX ring, so the link is idle while the board draws a row. Tracing the still life and the
  panels there stopped the 2500 twice partway down the page, the second time with the noises it
  makes at power-up; they are stored now (`sw_scene.h`). Anything new on the page that costs
  the board time costs the printer the same. The link itself is 57600 baud, 5.76 KB a second:
  the densest 400-row band (the still life beside its ramps) is 73 KB, about 13 s on the wire
  however fast it is drawn.

- **A Personal LaserWriter 300 drives a clock on HSKi, IO8 on rev A** (W-1102): 533 kHz while
  it is on. `serial_out` counts its edges with PCNT through the GPIO matrix, so the pad stays
  UART1's CTS. PCNT's counter is 16 bits (32,767 here): the line task counts for 50 ms of each
  100 ms (26,650 edges at 533 kHz), clears the count each window, and lets the unit accumulate
  past its limit so a window stretched by a busy core still counts true. Clocked is two windows
  running at 100 kHz or more; gone is 20 below (`serial_clock.c`), about 2 s: board 1's 300
  stopped its clock for under a second three times one afternoon with nobody near it
  (2026-11-13), and at two windows each showed on the phones as Offline and back. A stop ridden
  out is a warning in the log. While clocked, the line's level is never reported: it is
  noise.
- **IO17 is UART1's IO_MUX TxD pin.** A GPIO write reaches the pad only after
  `esp_rom_gpio_pad_select_gpio` moves it to the GPIO function; until then the UART still drives
  it. `qd_link_open` takes TxD from the UART with `serial_out_lend(1)` and does that first.
- **ESP-IDF's SPI slave reads chip select from a pad at every transaction's start** (W-1102,
  `qd_link.c`). `restore_cs` connects the pad named in `spics_io_num` to the chip-select input as
  each transaction loads, and `freeze_cs` ties it high at the end. Given `spics_io_num = -1` the
  driver never sets the signal number and would connect input signal 0, the flash's SPIQ, to a
  pad numbered -1. The link gives the driver TxD as chip select instead: TxD is a GPIO holding
  mark whenever the driver reads it, which is high, "not selected", on a board whose TxD is not
  inverted, and `post_setup_cb` then drives chip select from the matrix's constant 0 before it
  hands TxD to MISO; the chunk's end timer drives it from constant 1. No pad but TxD, RxD and
  HSKi is touched, so J6 and rev 2026.11's spare pins stay free. Untested on a board with
  `CONFIG_AIRWRITER_INVERT_TX`: there mark is low, the slave is selected a few microseconds
  early, and the read-back may fail every chunk. `spicommon_cs_initialize` also points TxD's
  output at the chip-select output for the moment between `spi_slave_initialize` and the link
  setting TxD back to mark.
- **The slave clocks out whatever follows its data while chip select stays low.** A chunk ends
  only when chip select rises, so each ends in a tail of 4,096 marks (7.7 ms at 533 kHz) and the
  end timer is armed from `post_setup_cb` as the chunk loads, aimed at the tail's middle: a rip
  that is slow to fill the next chunk can never leave one running past its tail. The spike's
  timer was up to 873 us late against a 960 us tail; `worst_end_us` is in the job's log line,
  and on board 1 it was never more than 1,828 us against the 4,096-mark tail's 3.8 ms half
  (2026-11-13).
- **A chunk's read-back can record nothing though the chunk went out** (W-1102, board 1,
  2026-11-13). About one chunk in 20 to 30, never the first after the link opens, the slave's
  result has `trans_len` of 0 to 7 bits, no more than the chunk's lead, while the clock is
  there. Sending such a chunk again printed its rows twice on the test page and a photo: it had
  reached the printer. `qd_link` counts it as `unchecked` and goes on, but only if the clock is
  toggling at that moment (`serial_out_clock_live`): `serial_out_clock` holds a pause of up to
  2 s as present, and a chunk that ended inside a pause never left, so it is short and the job
  ends Offline. A chunk with more bits recorded than its lead but fewer than sent is a failure
  too. The cause is not known.
- **The 300 says a page is done while the sheet is still coming out.** `8E 00` bit 2 comes about
  15 s before the sheet leaves the printer, while `83 01` bit 5 (paper moving) is still set. A
  job that went to Ready at page done would go Ready, then Printing again on the next status
  question; `qd_session_end` asks `83 01` and leaves the state Printing until the paper stops.
- **A 300's `83 02` `10` is no paper at the source it was told to use, and sets `83 01`'s fault
  bit too** (board 1, 2026-11-13). The cassette pulled out or empty, or the manual slot chosen
  (`83 4F`) and empty after a page from it: `83 01` `02`, `83 02` `10`, `82 00` `AC` (engine not
  ready); `83 2A` says which source has paper. Read as an engine fault, the phone said "check
  the printer" and a page mid-print failed; read as the cassette, the board said "check the
  paper cassette" with the cassette full after a manual-slot page. `qd_state_from` and the
  page's wait skip the fault bit while `10` is set and go by `83 2A`. The job's end sends
  `83 4C` after a manual-slot page: the printer otherwise keeps the slot, says it has no paper
  and pulls in any sheet put there.
- **A 300 takes the next page's rows while a page prints, and five things go with that**
  (W-1144; board 1's printer, 2026-11-13; SPEC §3.18 has the runs). `qd_session` keeps to each,
  and `qdfake.py` answers as the printer did:
  1. *Only the paper source goes before the next page's rows*: no `81 00`. Its print sequence
     (`83 2A`, `84`, `8B 8B` twice, `8A 01`) goes at the printing page's done (`8E 00` bit 2,
     with the printer's BREAK), never before: `8E`'s done is cleared by the read, so a done
     read anywhere, between rows too, must be counted.
  2. *The two pages share the memory.* 513,287 bytes of codes fit and 533,655 did not. Past it
     while a page prints, `8E 00` bit 0 and a BREAK, and both sheets come out blank, the
     printing one "done" early. A page's room is free at its done. `82 00` bit 0 never said
     full; don't wait on it. The session's limit for the two together is 500,000.
  3. *`81 00` while a page prints blanks that sheet* and no page done ever comes. It goes back
     to the start of the memory and clears nothing (`82 00` then says empty all the same). Send
     it between a page's `8A 01` and its done only to stop the page.
  4. *The offsets and width (`85` to `89`) are read as a page prints.* Sent for the next page
     3 s into a print, they moved both sheets. Change them only with nothing printing: a page
     on another sheet waits for the done.
  5. *Apple's jam recovery prints the page at the start of the memory*, the first since the
     last `81 00`, and a page loaded behind it survives and prints from its own print
     sequence. `8B 8B` sent straight after the recovery's `81 00` lands on that first page's
     start and blanks it (the bench's first two tries). After a recovery the printer writes
     from the start of its memory again, so the page after the one behind must start over
     with `81 00`. A jammed page that is not the first can't be had back this way: after
     a jam on page 2 the recovery printed page 1. A job sends its pages again from the copy
     it keeps (`qd_session.c`, `resend`) and never relies on the printer's reprint. The cover
     opened mid-page reads `83 01` `13`, `83 02` `0D`, and for about 3 s after it closes, and
     after `84 08`, the `83` questions go unanswered.
- **A 300 that says jam is to be sent nothing but questions, `8A 00` and the lights** (W-1144;
  board 1's printer, 2026-11-13, runs A4d and A4e). An `8A 01` sent while `83 02` says jam is
  kept: when the jam clears the printer feeds by itself, and `81 00` and `84 08` sent into
  that feed jammed it again. A jam during the second page of two usually has the first page's
  sheet in the path as well: after the cover closed `83 02` read clear once, then jam again
  until that sheet was out too. So a jam is gone only when `83 02` has stayed clear on reads
  3 s apart and `83 01` bit 5 (moving) is clear (`wait_clear`), and the recovery, a Cancel
  and an abort all hold back `81 00` until then. Rows were never tried with a jam or the
  cover showing: the session stops them, and `qdfake.py` fails a page sent any.
- **With a 300 on the port, HSKi's level means nothing.** The test button's cable-test branch
  reads that level for a printer that isn't there; with a clock it reads whatever edge it lands
  on. The button goes by `port_line_speaks()`, false when the port's printer is a StyleWriter or
  a 300, so a 300 gets its test page.

## LaserWriters (W-1082)

- **`gs` is aliased to `git status` in Wells's shell.** Call Ghostscript by path,
  `/opt/homebrew/bin/gs` (`brew install ghostscript`); the test scripts do.
- **Ghostscript 10 has no Level 1 mode** (`.setlanguagelevel` is gone). `pscheck.py` traps every
  operator outside `tools/rip/test/ps_level1_ops.txt` instead, plus the Level 2 names Ghostscript
  defines as procedures; trapping every procedure hangs Ghostscript.
- **Binary PostScript: exactly one LF after the procedure name.** The scanner eats one
  whitespace byte after a token; CR LF leaves the LF as the first data byte and shifts every
  row after it.
- **PAP to a LaserWriter: 512-byte Data packets, one ATP socket.** Bigger upsets a LaserWriter
  on LocalTalk; and the socket that sends OpenConn must be the responding socket it names, or
  the printer's SendData never arrives (TailTalk, on hardware, PR #26).
- **A LaserWriter's PAP connection carries many jobs: EOF ends a job, CloseConn the
  connection.** A Mac's LaserWriter driver sends a query (is Laser Prep in the printer?), reads
  the answer to the printer's EOF, then sends the document as the next job on the same
  connection, and closes only at the end; a LaserWriter, having answered a job's EOF with its
  own, asks for the next with a new SendData. Take the first EOF as the end and Print Monitor
  says "starting job" forever (W-1095: an SE/30 through the relay to a Personal LaserWriter
  NTR). The relay passes each EOF through (`LT_JOB_EOF`, `papc_open_multi`); the ImageWriter's
  connections and the board's own LaserWriter jobs stay one job each. The SE/30's driver sends
  four jobs (query, Laser Prep by `exitserver`, query, document) and closes as soon as the
  last EOF is out, before the printer's: a LaserWriter has every byte by then, so the relay
  finishes that job (`papc_finish`) rather than cancelling it and dropping what it still holds.
- **`lt_node_init` resets a node's roles and its PAP client.** Every re-init (the AppleTalk
  port waking from quiet) re-applies `lt_node_set_serve` and `lt_node_attach`.
- **`laser.c`'s lock order is `s_client_mx`, a link's lock, `s_mu`.** The client's callbacks
  run under a link's lock and take only `s_mu`; Cancel-Job reaches the client as a flag, since
  `ipp_server` calls cancel under its own lock.
- **The printer list's NVS blob is `pr_rec_t`s as they are in RAM.** A field added to
  `pr_rec_t` (or to `lw_info_t`, inside it) changes the blob's size, and an older firmware (an
  OTA rollback, the known-good reset) then reads none of it, keeps it untouched and shares no
  printer. Keep new facts about a printer beside it under a key of their own, as W-1098's
  `seen` does (addresses and page counts). A new kind or model (`pr_kind_t`, `pr_model_t`) is
  not a new key either: an older `pr_load` refuses the number. Bump `PR_BLOB_VER` (W-1103's
  StyleWriters made it 2), keep a reader for each older version in `pr_load`, and append,
  never insert. The bump is also what tells an older firmware the list is a newer one's, to
  keep; a list it merely cannot read is replaced. `pr_save` writes the lowest version that
  holds the list (1 until a record or notice names a StyleWriter), so an OTA rollback does not
  touch the printers of anyone with no StyleWriter. A StyleWriter's cartridge is no field of
  the record: it is `pr_live_t.cart`, read by the board. Version 4 (W-1102) adds the Personal
  LaserWriter 300's kind and model and nothing else; it is written only while the list holds
  one, versions 1 to 3 still load, and a board rolled back to a firmware before it keeps a 4
  untouched and shares nothing until the next update.
- **A printer switched on is not ready at its first frame.** The NTR spends 8 s on LLAP ENQs
  (TashTalk passes other nodes' ENQs; `/api/lt` counts them in `frames`, not `heard`), then
  looks up its own name five times 2 s apart, and answers lookups only after that. Look after
  the last check (W-1098), not at the first sign of it.
- **The preview server's port 8079 may be another session's.** `preview.py --port` runs one of
  your own.
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
