wr/airwriter/hardware/airwriter/fab/airwriter-top.png

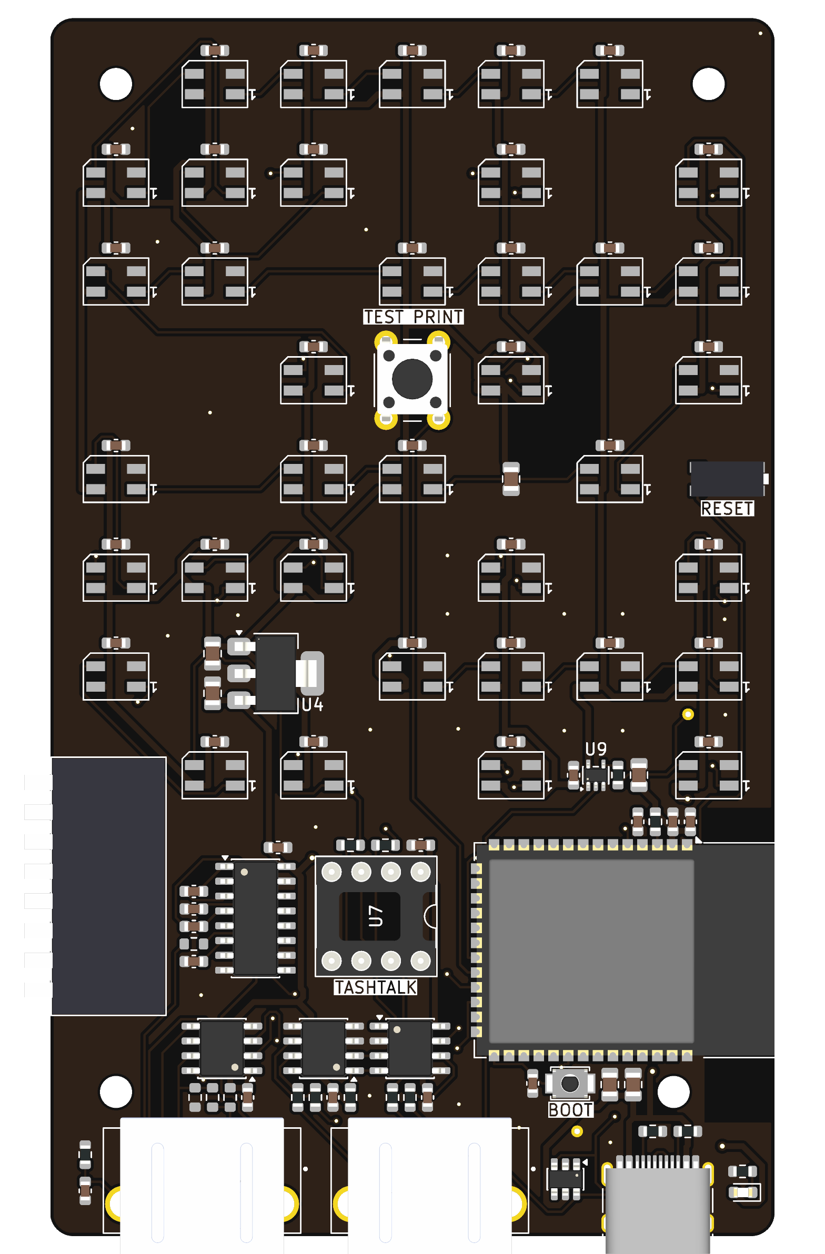
hardware/airwriter/fab/airwriter-top.png
