wr/airwriter/hardware/combined/airwriter-top.png

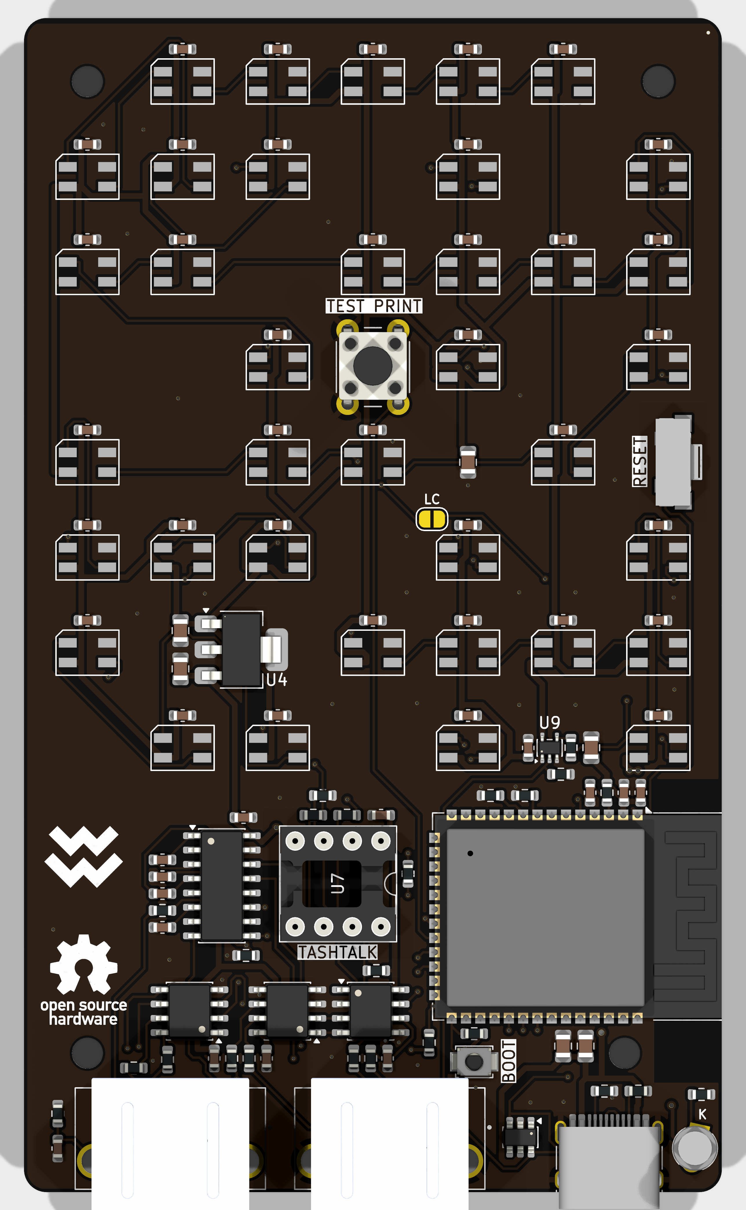
hardware/combined/airwriter-top.png
