wr/airwriter/hardware/combined/combined-top.png

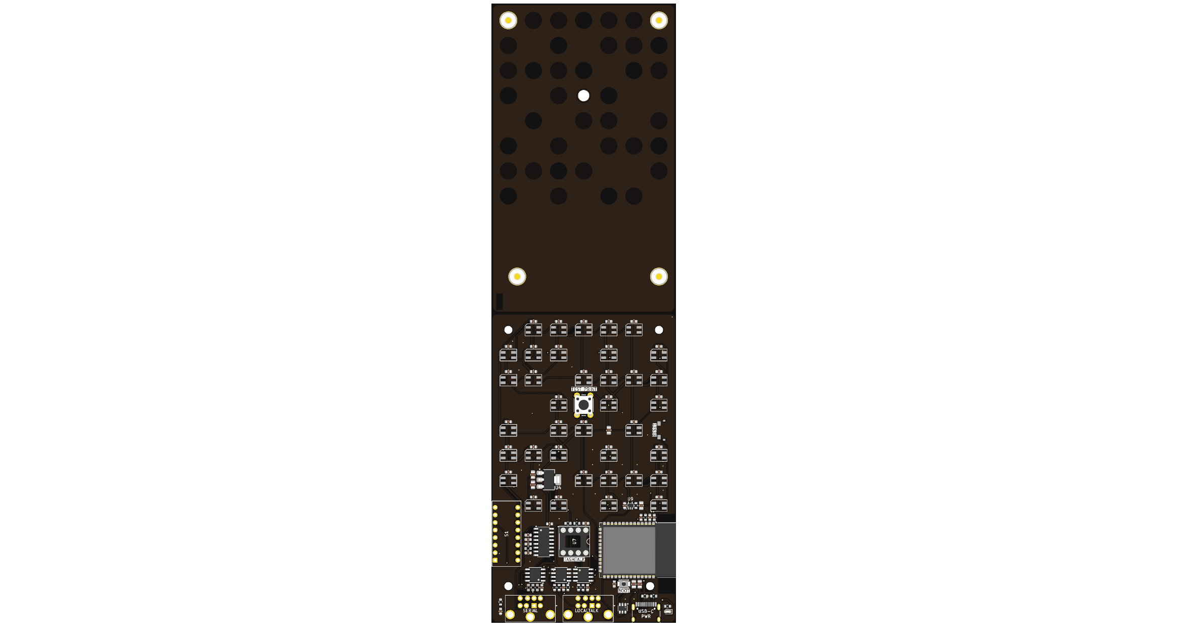
hardware/combined/combined-top.png
