wr/airwriter/tools/webui/airwriter.webp

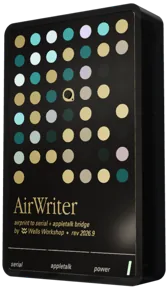
tools/webui/airwriter.webp
