wr/airwriter/hardware/combined/fab-lc/airwriter-lc-assembly-bom.csv

Designator | Comment | Footprint | LCSC | Qty | Note
C1,C22 | 22u | Capacitor_SMD:C_0805_2012Metric | C29277 | 2
C2,C4 | 10u | Capacitor_SMD:C_0805_2012Metric | C15850 | 2
C3,C5,C9,C10,C11,C12,C13,C14,C16,C17,C18,C29,C46 | 100n | Capacitor_SMD:C_0603_1608Metric | C14663 | 13
C6 | 1u | Capacitor_SMD:C_0603_1608Metric | C15849 | 1
C15 | 1n | Capacitor_SMD:C_0603_1608Metric | C1588 | 1
C67 | 1u | Capacitor_SMD:C_0805_2012Metric | C28323 | 1
D3 | green PWR | airwriter:LED_D3.0mm_Spacer_H8mm | C20613324 | 1 | THT: 3 mm flat-top green on a HIWA LED4*8 nylon spacer (LCSC C92326) under the body, lens up
D26 | SK6812MINI-C | LED_SMD:LED_SK6812MINI_PLCC4_3.5x3.5mm_P1.75mm | C7423117 | 1
J1 | USB-C 5V in | Connector_USB:USB_C_Receptacle_HRO_TYPE-C-31-M-12 | C165948 | 1
J2 | Mini-DIN-8 to printer | airwriter:MiniDIN-8_Kycon_KMDGX-8S-BS_RightAngle | C5780060 | 1 | DO NOT ASSEMBLE - keep its 11 holes free of solder; fitted after delivery (Kycon KMDGX-8S-BS)
J4 | Mini-DIN-8 LocalTalk | airwriter:MiniDIN-8_Kycon_KMDGX-8S-BS_RightAngle | C5780060 | 1 | DO NOT ASSEMBLE - keep its 11 holes free of solder; fitted after delivery (Kycon KMDGX-8S-BS)
R1,R2 | 5.1k | Resistor_SMD:R_0603_1608Metric | C23186 | 2
R3,R14,R21-R25,R32,R33 | 10k | Resistor_SMD:R_0603_1608Metric | C25804 | 9
R8,R9 | 0R | Resistor_SMD:R_0603_1608Metric | C21189 | 2
R10-R13 | 10R | Resistor_SMD:R_0603_1608Metric | C22859 | 4
R15,R16 | 100R | Resistor_SMD:R_0603_1608Metric | C22775 | 2
R17 | 150R | Resistor_SMD:R_0603_1608Metric | C22808 | 1
R20 | 47R | Resistor_SMD:R_0603_1608Metric | C23182 | 1
R27 | 1k | Resistor_SMD:R_0603_1608Metric | C21190 | 1
R29,R30 | 15k | Resistor_SMD:R_0603_1608Metric | C22809 | 2
SW1 | TSB001A3518A | airwriter:SW_BZCN_TSB001A3518A | C2888448 | 1
SW2 | B3U-1000P | Button_Switch_SMD:SW_SPST_B3U-1000P | C231329 | 1
SW3 | TS-1002-BR15026 | Button_Switch_THT:SW_PUSH_6mm_H13mm | C920209 | 1
U1 | ESP32-S3-WROOM-1-N16R8 | RF_Module:ESP32-S3-WROOM-1 | C2913202 | 1
U2 | THVD1451DR | Package_SO:SOIC-8_3.9x4.9mm_P1.27mm | C2671319 | 1
U3 | SP3232EBEN-L/TR | Package_SO:SOIC-16_3.9x9.9mm_P1.27mm | C6852 | 1
U4 | AP7361C-33E | Package_TO_SOT_SMD:SOT-223-3_TabPin2 | C500795 | 1
U5 | USBLC6-2SC6 | Package_TO_SOT_SMD:SOT-23-6 | C7519 | 1
U6,U8 | SP3485EN-L | Package_SO:SOIC-8_3.9x4.9mm_P1.27mm | C8963 | 2
U7 | PIC12F1840-I/P | Package_DIP:DIP-8_W7.62mm_Socket | C72124 | 1 | Fit the DIP-8 SOCKET only (LCSC C72124) and leave it empty: no PIC
U9 | SN74LV1T125DCKR | Package_TO_SOT_SMD:SOT-353_SC-70-5 | C75925 | 1
D3 (spacer) | LED4*8 nylon LED spacer, 4 mm x 8 mm | - | C92326 | 1 | Under D3: LED leads through the spacer bore, LED flange seated on it, lens up
