wr/airwriter/enclosure/out/airwriter-lc-light.stl

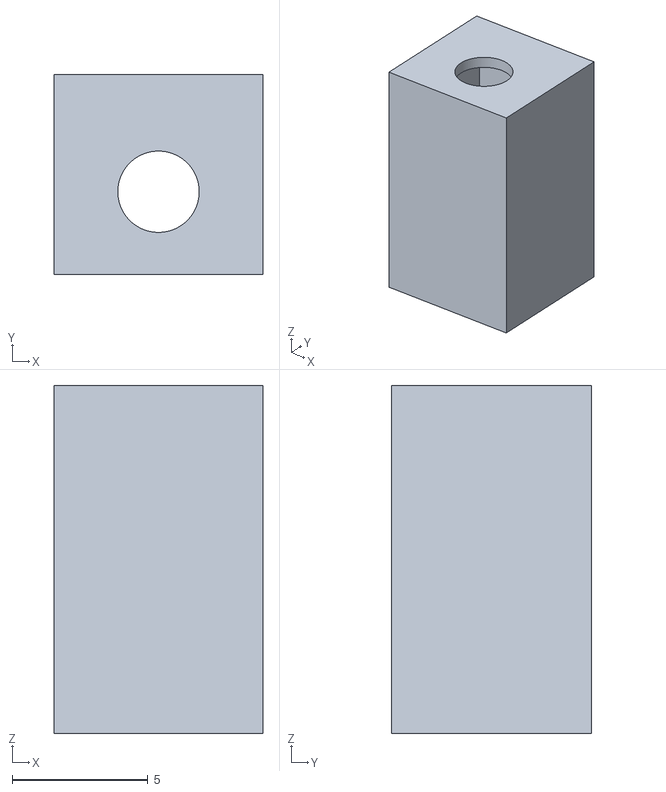
[picture p6: CAD file, 2026-10-30]
enclosure/out/airwriter-lc-light.stl
7.70 x 7.37 x 12.8
