wr/airwriter/hardware/airwriter/fab/airwriter-3d.step

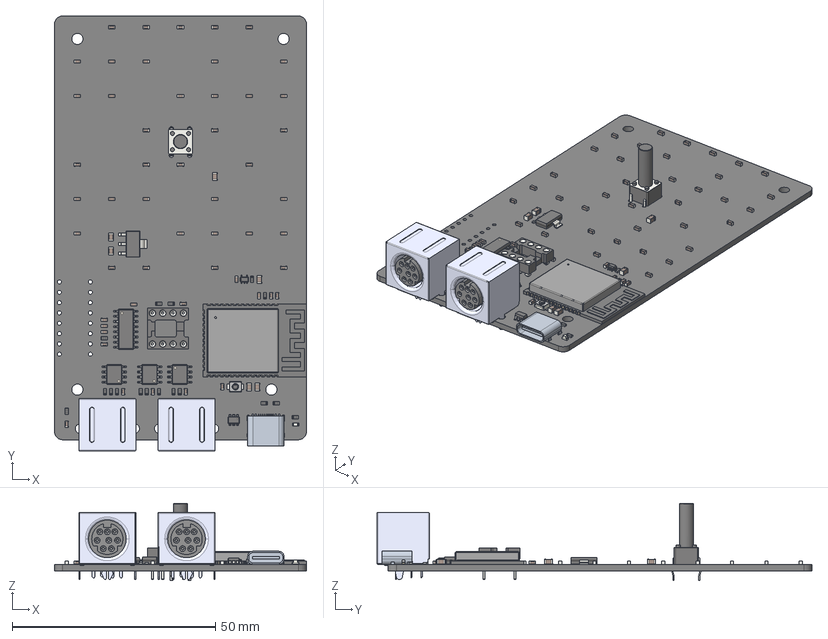
[picture p7: CAD file, 2026-10-16]
hardware/airwriter/fab/airwriter-3d.step
62.0 x 107.0 x 19.0 mm
C_0603_1608Metric x 52
R_0603_1608Metric x 17
C_0805_2012Metric x 6
SW_PUSH_6mm_h13mm
SOIC-16_3.9x9.9mm_P1.27mm
KMDGX-8S-BS_rC3 x 2
SOIC-8_3.9x4.9mm_P1.27mm x 3
LED_0603_1608Metric
SOT-223
SW_SPST_B3U-1000P
SOT-353_SC-70-5
USB_C_Receptacle_HRO_TYPE-C-31-M-12
ESP32-S3-WROOM-1
SOT-23-6
DIP_8_W762mm_Socket
airwriter_PCB
