wr/airwriter/enclosure/out/airwriter-lattice.stl

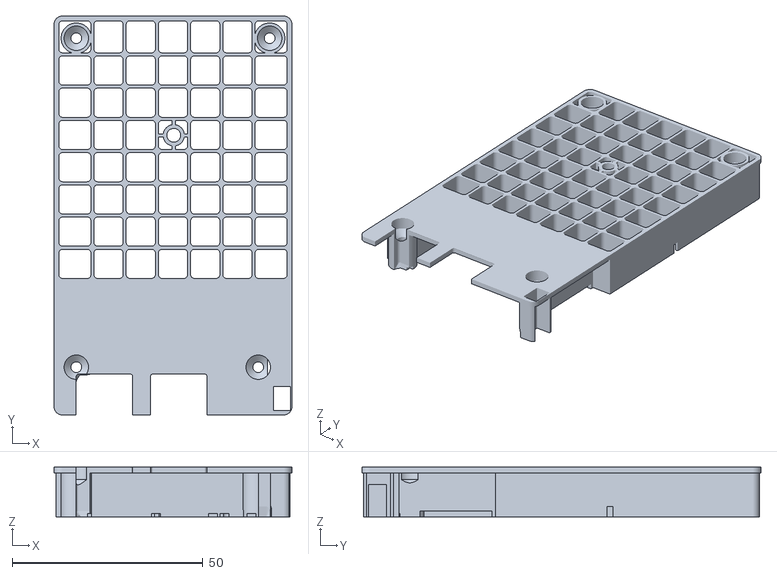
[picture p8: CAD file, 2026-10-30]
enclosure/out/airwriter-lattice.stl
62.4 x 104.7 x 13.0
