wr/airwriter/enclosure/out/airwriter-tray.stl

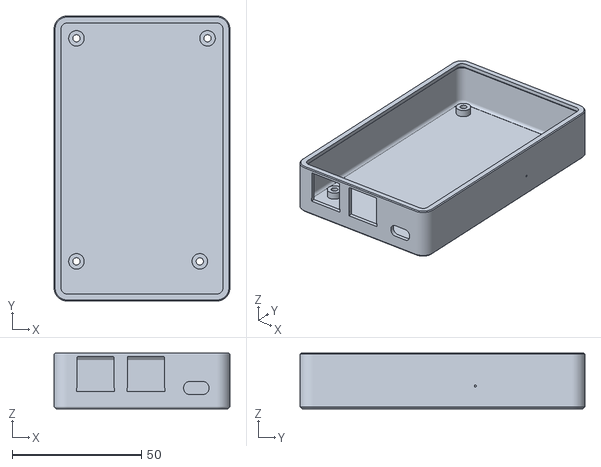
[picture p9: CAD file, 2026-10-29]
enclosure/out/airwriter-tray.stl
68.0 x 110.3 x 21.6
