wr/airwriter/enclosure/out/airwriter-lite-lid.stl

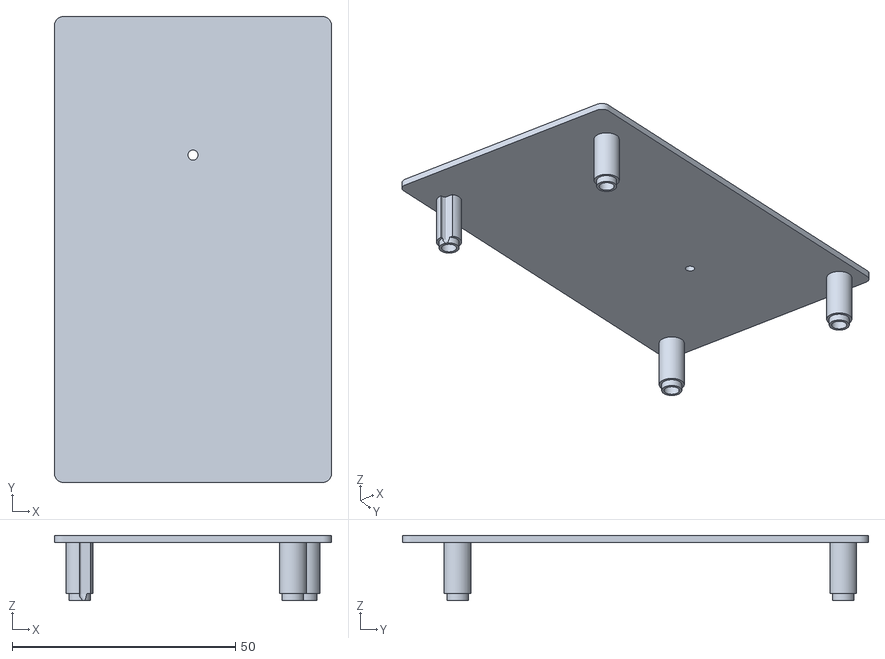
[picture p10: CAD file, 2026-10-15]
enclosure/out/airwriter-lite-lid.stl
62.0 x 104.3 x 14.6
