wr/airwriter/docs/superpowers/plans/2026-10-23-printers.md

# Printers Implementation Plan

> **For agentic workers:** REQUIRED SUB-SKILL: Use superpowers:subagent-driven-development (recommended) or superpowers:executing-plans to implement this plan task-by-task. Steps use checkbox (`- [ ]`) syntax for tracking.

**Goal:** AirWriter offers, over AirPrint and to old Macs, exactly the printers a person has, found or told, with a Printers section, printers in first-run setup, and existing boards unchanged.

**Architecture:** A pure-C printer list (`components/printers/printers_core.c`, host-tested) owns records, naming, identity, sharing, notices, migration and what old Macs are offered. A firmware glue (`printers.c`) persists it in NVS, feeds it what the port and AppleTalk find, and drives `ipp_server` (one slot per shared record), the AppleTalk links (one NBP registration per offered printer, plus an AirWriter marker) and the page. AppleTalk printers generalise W-1082's single LaserWriter; a PAP relay bridges a Mac on one link to a printer on another.

**Tech Stack:** ESP-IDF 5.5.1 C, FreeRTOS, esp-mdns; host tests in `tools/rip` (cc, Makefile); the page in `tools/webui` (HTML/JS, `mkheader.py`, `preview.py`); Python `etpeer.py` fakes; Ghostscript for PostScript checks.

**Spec:** `docs/superpowers/specs/2026-10-23-printers-design.md` (W-1088)

## Global Constraints

- No phantom printer: AirPrint advertises only records with `shared` on; old Macs are offered every identified record AirWriter can carry, shared or not.
- At most 4 records shared over AirPrint (1 on the port, 3 on AppleTalk); more are listed, not offered.
- Names come from the printer: an AppleTalk printer's NBP name; a port printer's model ("ImageWriter II", "ImageWriter LQ", "ImageWriter"); duplicates get " 2", " 3"; never "ImageWriter II" by default for a board with no ImageWriter.
- A record's `uuid` never changes. Port printer of an updated board: today's `41575254-4552-<epoch>-<mac>`. AppleTalk: `lw_uuid()` (W-1082). New port record on a new board: `lw_uuid()` form with the name hash replaced by the fixed tag `0001`.
- IPP paths: port record `ipp/print`; AppleTalk records `ipp/p<id>`; `ipp/laser` keeps answering for the LaserWriter migrated from W-1082.
- An AppleTalk printer is its NBP name and type; heard on two links it is one record on the preferred link: cable, network (radio), tunnel, zone.
- Every AirWriter registers `<host name>:AirWriter@*` on each link it runs; lookups skip printers registered by such a node, and its own.
- Lookups of `=:LaserWriter@*` and `=:ImageWriter@*`: at boot, every 30 s for the first 5 minutes, then every 5 minutes, and at once when the Printers section is open (and from setup's Look Again).
- A LaserWriter whose query gets no answer is asked again twice over 2 minutes, then gets the "didn't answer" notice with Try Again, Use Anyway (PostScript, Letter, 300 dpi, hex) and Remove.
- ImageWriter commands (idle CTRL-X, resync, `ESC ?` before jobs, the ImageWriter stream) go to the port only when its record's kind is ImageWriter; a ready port that does not answer `ESC ?` gets nothing more until the person says what it is.
- A different identified printer on the port is offered, never swapped: "The printer port now has an *model*. Use it instead of *name*?"
- Updated boards: records from today's NVS, nothing changes on phones; a board that never set a host name keeps `imagewriter-xxxx` (stored explicitly); new boards default to `airwriter-xxxx`.
- New boards' ways in: AppleTalk Port on, Networked Macs on, Basilisk II on, Infinite Mac off.
- On-screen words are the spec's words, verbatim (setup steps, notices, finish sheet, Remove confirmation, offline lines).
- One job at a time across the box, relayed Mac jobs included; internal RAM is Wi-Fi's: new state goes to PSRAM (`bigmem.h` / `heap_caps`), as in `docs/traps.md`.
- Board 1: checker and test pages may print without asking, daytime only; other prints wait for Wells's final sitting. Never OTA mid-print; console only via `idf.py monitor` under `script`.
- New source files carry an SPDX header (GPL-3.0-or-later for firmware and tools).

## Review Focus

1. **An updated board whose ImageWriter is off at first boot**: migration must create the port record from NVS alone, offered and shared, with no "found"/"changed" churn when the printer later answers. Test in Task 1 (`test_migrate_port_off`) and Task 5's bench step.
2. **Name collisions**: an AppleTalk printer whose NBP name equals the port printer's name, or two printers with one name: unique names, distinct Bonjour instances, stable across reboots. Test in Task 1 (`test_names_unique`).
3. **MacRoman NBP names** ("Café Laser"): UTF-8 for Bonjour, IPP and the page; the original Pascal bytes for NBP registration and lookups. Test in Task 1 (`test_macroman_name`) and Task 7 (`test_register_macroman`).
4. **A missing, short, old-version or corrupt `printers` blob**: load fails safe, migration runs only when no blob exists, legacy keys are never erased. Test in Task 1 (`test_load_garbage`).
5. **A relayed Mac job while an AirPrint job holds the box, or the target LaserWriter is busy**: the Mac is told busy (status and OpenConn), nothing deadlocks, the relay frees on either side's close. Test in Task 8 (`test_relay_busy`, `test_relay_peer_closes`).

---

### Task 1: The printer list (pure core)

**Files:**
- Create: `firmware/components/printers/include/printers_core.h`, `firmware/components/printers/printers_core.c`, `firmware/components/printers/CMakeLists.txt` (REQUIRES laser for `lw_uuid`, `nbp_utf8`)
- Modify: `tools/rip/Makefile` (INCS `printers/include`; SRCS `printers_core.c`)
- Test: `tools/rip/test/test_printers.c`

**Interfaces:**
- Consumes: `lw_uuid()` (`lw_caps.h`), `nbp_utf8()` (MacRoman Pascal to UTF-8), `at_link_t` (`at_printer.h`).
- Produces:
  - `enum { PR_MAX = 8, PR_SHARE_MAX = 4, PR_NAME_MAX = 33 };`
  - `typedef enum { PR_WHERE_PORT, PR_WHERE_CABLE, PR_WHERE_NETWORK, PR_WHERE_TUNNEL, PR_WHERE_ZONE } pr_where_t;` (order = link preference after the port)
  - `typedef enum { PR_KIND_UNKNOWN, PR_KIND_IMAGEWRITER, PR_KIND_LASERWRITER, PR_KIND_AT_IMAGEWRITER } pr_kind_t;`
  - `typedef enum { PR_MODEL_NONE, PR_MODEL_IW2, PR_MODEL_IWLQ, PR_MODEL_IW1 } pr_model_t;`
  - `typedef enum { PR_PORT_NOTHING, PR_PORT_SILENT, PR_PORT_IW2, PR_PORT_IWLQ } pr_port_seen_t;`
  - `typedef struct { uint8_t id, where, kind, model, shared, found_auto, identified, query_fails; char name[PR_NAME_MAX]; uint8_t nbp[33], nbp_type[33]; char uuid[46]; char dither[12]; uint8_t gain; int16_t top_margin; uint8_t ribbon; lw_info_t lw; uint8_t ipp_laser; } pr_rec_t;`
  - `typedef enum { PR_NOTE_FOUND, PR_NOTE_UNKNOWN_PORT, PR_NOTE_CHANGED, PR_NOTE_NO_ANSWER, PR_NOTE_TOO_MANY } pr_note_kind_t;` and `typedef struct { uint8_t kind, id, model; } pr_note_t;` (up to 8, oldest dropped)
  - `typedef struct { pr_rec_t r[PR_MAX]; uint8_t n, next_id; pr_note_t notes[8]; uint8_t n_notes; uint8_t mac[6]; uint16_t epoch; } pr_list_t;`
  - `void pr_init(pr_list_t *l, const uint8_t mac[6], uint16_t epoch);`
  - `int  pr_port_seen(pr_list_t *l, pr_port_seen_t what);` returns the port record id or -1
  - `int  pr_at_seen(pr_list_t *l, pr_where_t link, const uint8_t *nbp_name, const uint8_t *nbp_type, int from_airwriter);`
  - `void pr_at_queried(pr_list_t *l, int id, int ok, const lw_info_t *info);`
  - `int  pr_rename(pr_list_t *l, int id, const char *name);` `int pr_set_shared(pr_list_t *l, int id, int on);` (0, or -1 refused at the cap) `int pr_set_model(pr_list_t *l, int id, pr_model_t m);` (`PR_MODEL_NONE` = "Something else": kind unknown) `int pr_remove(pr_list_t *l, int id);` `int pr_use_anyway(pr_list_t *l, int id);` `int pr_accept_change(pr_list_t *l, int note);` `void pr_dismiss(pr_list_t *l, int note);`
  - `pr_rec_t *pr_get(pr_list_t *l, int id);` `const pr_rec_t *pr_port(const pr_list_t *l);`
  - `int pr_offers(const pr_list_t *l, pr_where_t link, int ids[], int max);` records old Macs get on `link`
  - `typedef struct { uint8_t present, ready, attention, printing, failed; } pr_live_t;` and `typedef enum { PR_BOX_OFFLINE, PR_BOX_READY, PR_BOX_PRINTING, PR_BOX_ATTENTION, PR_BOX_FAILED } pr_box_t;` `pr_box_t pr_box_state(const pr_list_t *l, const pr_live_t live[PR_MAX]);` `int pr_test_target(const pr_list_t *l, const pr_live_t live[PR_MAX]);`
  - `typedef struct { const char *model, *name; int airprint; const char *dither; uint8_t gain; int16_t top_margin; uint8_t ribbon; const char *uuid; int laser_shared; const uint8_t *laser_nbp; int laser_link; const lw_info_t *laser_info; const char *laser_dither; uint8_t laser_gain; } pr_legacy_t;` `void pr_migrate(pr_list_t *l, const pr_legacy_t *old);`
  - `size_t pr_save(const pr_list_t *l, uint8_t *buf, size_t cap);` `int pr_load(pr_list_t *l, const uint8_t *buf, size_t n);` (0 ok, -1 refused; version byte `PR_BLOB_VER 1`)
  - `size_t pr_json(const pr_list_t *l, const pr_live_t live[PR_MAX], char *buf, size_t cap);`

- [ ] **Step 1: Write the failing tests** in `test_printers.c`:
  - `test_port_identified`: empty list, `pr_port_seen(IW2)` → one record, where PORT, kind IW, model IW2, name "ImageWriter II", shared 1, found_auto 1, a FOUND note; again → same id, no new note.
  - `test_port_silent`: `PR_PORT_SILENT` → kind UNKNOWN, shared 0, one UNKNOWN_PORT note; `pr_set_model(id, IW1)` → kind IW, name "ImageWriter", shared 1.
  - `test_port_changed`: record IW2 named "Desk"; `pr_port_seen(IWLQ)` → still IW2 "Desk", a CHANGED note (model LQ); `pr_accept_change` → model LQ, name "ImageWriter LQ" unless renamed ("Desk" kept), same uuid, same id.
  - `test_port_nothing`: `PR_PORT_NOTHING` with a record → record kept, no note.
  - `test_at_laserwriter`: `pr_at_seen(NETWORK, "Office", "LaserWriter", 0)` → kind LW, identified 0, shared 0; `pr_at_queried(ok)` → identified 1, shared 1, FOUND note, uuid == `lw_uuid(mac, epoch, "Office")`.
  - `test_at_no_answer`: three `pr_at_queried(fail)` → NO_ANSWER note after the third only; `pr_use_anyway` → identified 1, shared 1, lw info Letter/300/hex.
  - `test_at_imagewriter`: type "ImageWriter" → kind AT_IW, identified 1, shared 1 at once.
  - `test_link_preference`: seen on TUNNEL then CABLE → one record, where CABLE; then NETWORK → still CABLE.
  - `test_skip_airwriter`: `from_airwriter` 1 → returns -1, no record.
  - `test_cap`: port + 4 LaserWriters identified → 4 shared (port + 3), the fourth AT record shared 0 with TOO_MANY; `pr_set_shared(5th, 1)` → -1; unshare one, then 0.
  - `test_names_unique`: port "ImageWriter II" + AT NBP "ImageWriter II" → second named "ImageWriter II 2"; `pr_rename(a, "X")`, `pr_rename(b, "X")` → b "X 2".
  - `test_macroman_name`: NBP name bytes `"\x0a" "Caf\x8e Laser"` → name "Café Laser" (UTF-8), nbp kept byte for byte.
  - `test_remove`: remove → gone, shared count drops; seen again → new id, new FOUND note.
  - `test_offers`: port IW, LW on CABLE, AT_IW on TUNNEL, unknown port excluded: `pr_offers(CABLE)` → {port, AT_IW}; `pr_offers(TUNNEL)` → {port, LW}; `pr_offers(NETWORK)` → {port, LW, AT_IW}; a LW with shared 0 still offered; an unidentified LW not offered.
  - `test_box_state`: ready+offline → READY; attention anywhere → ATTENTION; failed beats all; none present → OFFLINE. `pr_test_target`: port first, else the first shared.
  - `test_migrate`: legacy model "ImageWriter II", name "", airprint 1, uuid U, laser shared "Office" on TUNNEL → port record name "ImageWriter II", uuid U, found_auto 0, ipp_laser 0; AT record "Office" with `ipp_laser` 1, shared 1, uuid == lw_uuid; no notes.
  - `test_migrate_port_off`: as above with airprint 0 → port shared 0, still in `pr_offers(CABLE)`; a later `pr_port_seen(IW2)` makes no note.
  - `test_save_load`: round trip equal; `test_load_garbage`: empty, short, wrong version, flipped byte (length field) → -1 and the list unchanged.
  - `test_json`: two records → JSON with `id`, `name`, `where`, `kind`, `model`, `shared`, `state`, `notes[]`; names escaped.

- [ ] **Step 2: Run** `make -C tools/rip build/test_printers` — Expected: compile failure, `printers_core.h` missing.
- [ ] **Step 3: Implement** `printers_core.c` per the interfaces; names via `nbp_utf8` then the " N" suffix; uuid for a new port record: `lw_uuid` with a 1-byte Pascal name `"\x01\x01"`, then overwrite the hash group with `0001`.
- [ ] **Step 4: Run** `make -C tools/rip test` — Expected: `ok  test/test_printers.c`, every other test ok.
- [ ] **Step 5: Commit** `printers: the printer list, its rules and migration (W-1088)`.

### Task 2: The port tells II from LQ

**Files:**
- Modify: `firmware/components/imagewriter/include/imagewriter.h`, `imagewriter.c`
- Test: `tools/rip/test/test_imagewriter.c`

**Interfaces:**
- Produces: `typedef struct { iw_ribbon_t ribbon; pr_port_seen_t seen; } iw_self_id_t;` `iw_self_id_t iw_self_id(const uint8_t *reply, size_t n);` (`seen`: IW2 for "IW", IWLQ for "LQ", SILENT for no match). `iw_self_id_ribbon()` stays as a wrapper.

- [ ] **Step 1: Failing tests** `test_self_id_model`: `"IW10C"` → IW2 + colour; `"LQ1CF1\r"` → IWLQ + colour; `"LQ1F1"` → IWLQ + black; `""` → SILENT + unknown; noise `"\x00\x00IW10"` → IW2 + black.
- [ ] **Step 2: Run** `make -C tools/rip build/test_imagewriter && tools/rip/build/test_imagewriter` — FAIL (undefined `iw_self_id`).
- [ ] **Step 3: Implement** on top of W-1087's reader (one parse, two results).
- [ ] **Step 4: Run** `make -C tools/rip test` and `make -C tools/rip regress` — all ok, streams unchanged.
- [ ] **Step 5: Commit** `imagewriter: the self-ID names the model too (W-1088)`.

### Task 3: ipp_server: a slot per shared printer, records by name in Bonjour

**Files:**
- Modify: `firmware/components/ipp_server/ipp_server.c`, `include/ipp_server.h`, `include/ipp_req.h` (`IPP_PRINTERS 4`), `ipp_req.c` (`ipp_route` from the table only), `firmware/components/printer_caps/` (caps per ImageWriter model: make-and-model "Apple ImageWriter LQ" / "Apple ImageWriter", device id)
- Test: `tools/ipp/test/test_ipp_route.c`, `tools/ipp/test/test_printer_caps.c`, golden files unchanged

**Interfaces:**
- Consumes: `printer_caps_t`.
- Produces:
  - `ipp_printer_cfg_t` gains `const char *legacy_resource;` (`"ipp/laser"` or NULL) and slot 0 is set through the same call: `esp_err_t ipp_server_set_printer(int idx, const ipp_printer_cfg_t *cfg);` for idx 0..3, NULL withdraws (Bonjour records removed by instance name, routes answer not-found).
  - `ipp_server_cfg_t.queue_name` becomes only the default instance used before slot 0 is set; TXT `ty` and printer-info come from the slot's caps and name; `rp` from its resource.
  - `const printer_caps_t *printer_caps_imagewriter_model(int model);` (II, LQ, original)
  - Every mDNS call names its instance (`*_for_host(instance, ...)`), generalising f831c43 on `wells/w-1082-laserwriters` (cherry-pick it first).

- [ ] **Step 1: Cherry-pick** `f831c43` onto the branch; build.
- [ ] **Step 2: Failing tests**: `test_route_slots`: resources `{"ipp/print", "ipp/p3", NULL, "ipp/p5"}` plus legacy `"ipp/laser"` on slot 1 → `/ipp/p3` → 1, `/ipp/laser` → 1, `/ipp/p5` → 3, `/ipp/p4` → -1, `/ipp/print` → 0, `/` → 0 only when slot 0 is set else -1; `test_caps_models`: LQ caps make_model "Apple ImageWriter LQ", URF identical to the II's.
- [ ] **Step 3: Run** `make -B -C tools/ipp test` — FAIL on the new tests.
- [ ] **Step 4: Implement**; the ImageWriter golden answers stay byte for byte (slot 0 configured as today by main).
- [ ] **Step 5: Run** `make -B -C tools/ipp test` — all ok, golden unchanged; `idf.py build` clean.
- [ ] **Step 6: Commit** `ipp_server: a slot per shared printer, each named in Bonjour (W-1088)`.

### Task 4: lt_node: several NBP registrations and the AirWriter marker

**Files:**
- Modify: `firmware/components/localtalk/include/lt_node.h`, `lt_node.c`
- Test: `tools/rip/test/test_localtalk.c`, `test_ethertalk.c`

**Interfaces:**
- Produces:
  - `enum { LT_REG_MAX = 5 };` registration 0 is the node's own `obj:type` as today; `int lt_node_register(lt_node_t *n, int reg, const uint8_t *obj, const uint8_t *type, uint8_t sls);` (`obj == NULL` clears) with SLS sockets `0x81` (reg 0) and `0x85..0x88`.
  - `lt_ops_t` gains `int (*pap_open)(void *ctx, int reg, uint64_t now);` (0 accept, 1 busy) and the server connection records `reg`; registration 0 keeps today's spool path when `pap_open` is NULL.
  - The marker: `lt_node_register(n, 4, host, "AirWriter", 0x89)` answers lookups; it never opens.
  - `found` tuples carry the responder's node; `int lt_node_is_airwriter(const lt_node_t *n, uint16_t net, uint8_t node);` remembers nodes seen answering `AirWriter` (16 slots, 10 min).

- [ ] **Step 1: Failing tests**: `test_register_two`: LkUp `=:LaserWriter@*` answered only by reg 1 with its SLS; `=:=@*` answered by every registration; `test_open_on_reg`: OpenConn to 0x85 calls `pap_open(reg 1)`; busy return → OpenConnReply busy; `test_marker`: a LkUp for `=:AirWriter@*` answered; `lt_node_is_airwriter` true after hearing another node's marker reply; `test_register_macroman`: obj `"Caf\x8e"` registered and matched case-insensitively per NBP rules.
- [ ] **Step 2: Run** `make -C tools/rip build/test_localtalk build/test_ethertalk` and both binaries from `tools/rip` — FAIL.
- [ ] **Step 3: Implement** in `lt_node.c`; the 4 KB PAP `rd_buf` stays one per node (one connection per node at a time).
- [ ] **Step 4: Run** `make -C tools/rip test` (from the repo root; tests read fixtures relative to `tools/rip`) and `make -C tools/rip interop` — all ok.
- [ ] **Step 5: Commit** `lt_node: several names per node, and an AirWriter marker (W-1088)`.

### Task 5: The printers glue: NVS, migration, the port, the API

**Files:**
- Create: `firmware/components/printers/printers.c`, `include/printers.h`
- Modify: `firmware/main/main.c` (the port printer from the record; ImageWriter commands only for kind ImageWriter; detection hook; panel state; test button; `/api/status` gains `printers` summary), `firmware/components/settings/settings.c` (host default `airwriter-%s` for new boards; an updated board with Wi-Fi and no host key gets `imagewriter-%s` stored; a new board's `lt_port` defaults to 1, an updated board keeps -1 and its DIP rule), `firmware/components/webui/webui.c` (`GET/POST /api/printers`), `firmware/main/Kconfig.projbuild` (queue-name default no longer used for new boards)
- Test: `tools/rip/test/test_printers.c` (host-name rule), bench step

**Interfaces:**
- Consumes: Task 1 core, Task 2 `iw_self_id`, Task 3 `ipp_server_set_printer`.
- Produces:
  - `esp_err_t printers_start(const printers_cfg_t *cfg);` with `printers_cfg_t { uint8_t mac[6]; uint16_t epoch; void (*changed)(void); }`
  - `void printers_port_seen(pr_port_seen_t s);` `void printers_at_seen(pr_where_t link, const nbp_tuple_t *t, int from_airwriter);` `void printers_at_queried(int id, int ok, const lw_info_t *i);` `void printers_live(int id, const pr_live_t *live);`
  - `int printers_port_is_imagewriter(void);` `pr_model_t printers_port_model(void);`
  - `void printers_json(char *buf, size_t cap);` `int printers_post(const char *body, char *err, size_t cap);` keys: `rename{id,name}`, `share{id,on}`, `model{id,model}`, `remove{id}`, `use_anyway{id}`, `accept{note}`, `dismiss{note}`, `look`
  - `const char *settings_default_host(int has_wifi, int has_host_key);` returns the format ("airwriter-%s" or "imagewriter-%s")
- Store: NVS namespace `printers`, key `list` (the `pr_save` blob, in PSRAM while loaded). Migration runs only when `list` is absent; legacy keys are left in place.

- [ ] **Step 1: Failing test** `test_default_host`: (1,0) → "imagewriter-%s"; (0,0) → "airwriter-%s"; (1,1) and (0,1) → NULL (keep the stored one).
- [ ] **Step 2: Run** — FAIL.
- [ ] **Step 3: Implement** `printers.c`, the settings rule, the `/api/printers` routes, and in `main.c`: the port printer's slot 0 from its record (name, model caps, uuid, `shared`); `ps_want_kick`, `iw_resync`, `ribbon_check` and the job's `ESC ?` only when `printers_port_is_imagewriter()`; line-up after 1 s down → `ESC ?` → `printers_port_seen(iw_self_id(...).seen)`; LED state from `pr_box_state`; the test button from `pr_test_target`.
- [ ] **Step 4: Run** `make -C tools/rip test`, `make -B -C tools/ipp test`, `make -C tools/rip regress`, `idf.py build` — all ok.
- [ ] **Step 5: Bench (board 1)**: back up NVS over USB (`python -m esptool --chip esp32s3 -p <port> read_flash 0x9000 0x6000 nvs-backup.bin`, offsets from `partitions.csv`); OTA; `/api/printers` shows the ImageWriter and, with the fake running, "LaserWriter II NT" as migrated; `dns-sd -B _ipp._tcp` shows both under their old names; the iPhone-captured URF via `ipptool` to `ipp/print` and `ipp/laser` both print (checker crc32 `8ee84844` at top margin 0 on the USB console, then back to -126).
- [ ] **Step 6: Commit** `printers: the list on the board, migration, the port by its record (W-1088)`.

### Task 6: AppleTalk printers: many records, one PAP client

**Files:**
- Modify: `firmware/components/laser/laser.c`, `include/laser.h` (generalise from one shared LaserWriter to the records of kind LW and AT_IW), `lw_core.c/h` (per-record status and query schedule; lookup cadence 30 s for 5 min then 5 min, and on demand), `firmware/main/main.c` (per-slot sinks: `sink.ctx` = record id)
- Test: `tools/rip/test/test_lw_core.c`

**Interfaces:**
- Consumes: Task 1, Task 3, Task 4 (`lt_node_is_airwriter`, lookups of two types).
- Produces: `int laser_job_begin(int rec_id, const char *name, job_pipe_target_t *t);` `laser_job_end`, `laser_job_cancel` unchanged; `void laser_look_now(void);` `laser_json` removed (the page reads `/api/printers`); `/api/laser` answers from `/api/printers` for one release (old page cached in a browser).

- [ ] **Step 1: Failing tests** `test_cadence`: lookups at 0, 30, 60 … 300 s, then every 300 s; `laser_look_now` resets to 30 s; `test_query_retry`: query fails → retried at +60 s and +120 s, then NO_ANSWER via `pr_at_queried`; `test_two_lw_status`: two records polled in turn, a job's record every 2 s.
- [ ] **Step 2: Run** — FAIL.
- [ ] **Step 3: Implement**; the PAP client rides the link of whichever record it serves; state and caps per record in PSRAM.
- [ ] **Step 4: Run** `make -C tools/rip test`, `make -C tools/rip interop`, `idf.py build` — all ok.
- [ ] **Step 5: Bench**: two fakes (`etpeer.py tunnel laserwriter "LaserWriter II NT"` and a second on the zone or a second tunnel name) both appear on `dns-sd` unasked and each prints a text page via `ipptool`.
- [ ] **Step 6: Commit** `laser: every AppleTalk printer in the list, one client (W-1088)`.

### Task 7: Old Macs: register what each link offers

**Files:**
- Modify: `firmware/main/main.c` (`lt_roles_apply` from `pr_offers` per link), `localtalk.c`, `ethertalk.c` (register per offer: reg 0 the port printer as `ImageWriter`, regs 1-3 relayed printers under their NBP name and type, reg 4 the marker)
- Test: `tools/rip/test/test_ethertalk.c` (`test_offers_registered`)

**Interfaces:**
- Consumes: `pr_offers`, `lt_node_register`.
- Produces: `void localtalk_set_offers(const pr_offer_t *o, int n);` `void ethertalk_set_offers(int link, const pr_offer_t *o, int n);` with `pr_offer_t { int id; uint8_t obj[33], type[33]; }`.

- [ ] **Step 1: Failing test** `test_offers_registered`: offers {port "ImageWriter II":ImageWriter, "Office":LaserWriter} on the tunnel node → LkUp `=:LaserWriter@*` answered with "Office" on SLS 0x85; LkUp `=:ImageWriter@*` answered with reg 0; `test_register_macroman` already from Task 4 covers the bytes.
- [ ] **Step 2: Run** — FAIL. **Step 3: Implement.** **Step 4: Run** all host tests and interop — ok.
- [ ] **Step 5: Commit** `localtalk, ethertalk: offer old Macs every printer AirWriter can carry (W-1088)`.

### Task 8: The PAP relay

**Files:**
- Create: `firmware/components/localtalk/pap_relay.c`, `include/pap_relay.h`
- Modify: `laser.c` (a relayed connection takes the job lock and the client), `lt_node.c` (server reads answered from the relay's output; server pulls feed the relay)
- Test: `tools/rip/test/test_pap_relay.c` (two nodes in one process: Mac ↔ node B ↔ relay ↔ client on node A ↔ scripted printer); `tools/ethertalk/etpeer.py` gains `print-ps NAME FILE` (a Mac printing PostScript to a LaserWriter-type name, printing the printer's output it reads back)

**Interfaces:**
- Produces: `typedef struct pap_relay pap_relay_t;` `int pap_relay_open(pap_relay_t *r, lt_node_t *mac_side, int reg, pap_client_t *c, const lt_route_t *printer, uint64_t now);` (0 ok, 1 busy) `void pap_relay_tick(pap_relay_t *r, uint64_t now);` `int pap_relay_active(const pap_relay_t *r);` buffers 16 KB each way in PSRAM.

- [ ] **Step 1: Failing tests**: `test_relay_bytes`: 40 KB from the Mac reach the printer byte for byte; 3 KB of printer output (query answers) reach the Mac's reads; EOF both ways; both connections closed. `test_relay_status`: the Mac's SendStatus on node B gets the printer's last status string. `test_relay_busy`: printer OpenConn busy → the Mac's OpenConn answered busy, retried by the Mac, then opens. `test_relay_peer_closes`: printer closes mid-job → the Mac's connection closes; Mac closes mid-job → the printer's connection closes, no buffer left.
- [ ] **Step 2: Run** — FAIL. **Step 3: Implement.** **Step 4: Run** all host tests, `make -C tools/rip interop` — ok.
- [ ] **Step 5: Bench**: fake LaserWriter on the tunnel; `etpeer.py zone ZONE print-ps "LaserWriter II NT" page.ps` reaches it through the board (zone → tunnel), the fake saves the job and draws it.
- [ ] **Step 6: Commit** `localtalk: relay a Mac's PAP connection to a printer on another link (W-1088)`.

### Task 9: The PostScript test page

**Files:**
- Create: `firmware/components/ps_page/ps_testpage.c`, `include/ps_testpage.h`
- Modify: `tools/rip/main.c` (`rip --ps-testpage OUT.ps`), `tools/rip/test/pscheck.py` (renders it, Level 1 operators only), `laser.c` (`laser_test_page(int rec_id)` sends it raw, no rip)
- Test: `tools/rip/test/test_ps_page.c` (`test_testpage_text`)

**Interfaces:**
- Produces: `typedef struct { const char *printer, *product, *version, *host, *board; } ps_tp_info_t;` `void ps_testpage(const ps_tp_info_t *i, void (*out)(void *ctx, const uint8_t *b, size_t n), void *ctx);`

- [ ] **Step 1: Failing test**: output starts `%!PS-Adobe-3.0`, has `%%Title: (AirWriter test page)`, `/Times-Roman findfont`, `/Helvetica findfont`, the printer's name escaped, ends `%%EOF`; pscheck renders it with no error under the Level 1 trap.
- [ ] **Step 2: Run** — FAIL. **Step 3: Implement**: the mark, name, product, board details in Times and Helvetica; a gray ramp and the five screens as 300 dpi `imagemask` swatches (via `ht_*` and `ps_page`'s band writer); a ruler and four one-inch squares.
- [ ] **Step 4: Run** `make -C tools/rip test pscheck` — ok; look at the PNG.
- [ ] **Step 5: Commit** `ps_page: a test page for PostScript printers (W-1088)`.

### Task 10: Setup finds printers

**Files:**
- Modify: `firmware/main/main.c` (setup mode starts the port check, the LocalTalk node and the AppleTalk printers on the cable), `firmware/components/webui/webui.c` (`/api/printers` in captive mode; `/api/status` `fresh` for the finish sheet until dismissed: `POST /api/general {"finish":true}`), `settings.c` (`settings_finish_seen()`)

**Interfaces:**
- Consumes: Tasks 5, 6.
- Produces: `/api/status` `fresh` (bool); setup mode serves `/api/printers` and `POST /api/printers {"look":true}`.

- [ ] **Step 1: Bench in setup mode** (after the NVS backup): `POST /api/erase`; on the Mac join `AirWriter-2434`; `curl http://192.168.4.1/api/printers` lists the ImageWriter (printer on) within 5 s; with the fake LaserWriter impossible here (no Wi-Fi), the cable lookup runs (log line); `POST {"look":true}` re-runs. Then restore NVS (`write_flash 0x9000 nvs-backup.bin`) and reboot: board 1 back on Wi-Fi with its calibration.
- [ ] **Step 2: Commit** `setup: look for printers before Wi-Fi (W-1088)`.

### Task 11: The page: Printers, AirPrint, AppleTalk

**Files:**
- Modify: `tools/webui/body.html`, `app.js`, `style.css` (or the page's stylesheet), `states.json`; regenerate `firmware/components/webui/webui_page.h` with `mkheader.py`

**Interfaces:**
- Consumes: `/api/printers`, `/api/status` `printers` and `fresh`.

- [ ] **Step 1:** The Printers pane (hero, notices with their keys, rows, Look for Printers, Add a Printer…), a printer's detail (status words per spec, Name, Model for port printers, Share switch, Halftone with sample, Print Test Page, Test Cable… for the port, Remove Printer… with the spec's confirmation), AirPrint's list of addresses, AppleTalk's hero "Let old Macs print to your printers over AppleTalk." and "Old Macs see: …", the LaserWriters card removed; the sidebar row's state.
- [ ] **Step 2:** `states.json` states: no printer; one port printer; port + two AppleTalk; unidentified port device; found notice; changed notice; more than four; a printer offline; a LaserWriter that didn't answer.
- [ ] **Step 3: Check** `python3 tools/webui/preview.py`, every state at desktop and phone width, light and dark, in Chrome; fix what looks wrong; `python3 tools/webui/mkheader.py`; `idf.py build`.
- [ ] **Step 4: Commit** `webui: a Printers section, AirPrint and AppleTalk around it (W-1088)`.

### Task 12: The page: setup steps and the finish sheet

**Files:**
- Modify: `tools/webui/body.html`, `app.js`, `states.json`; `webui_page.h`

- [ ] **Step 1:** Captive setup as three steps with the spec's words: "Let's find your printer" (looking line, rows with editable names and where, the "Don't see your printer?" line, Look Again, Add a Printer…, Continue / Continue Without a Printer, "No printers found yet."), Wi-Fi with "AirWriter joins your Wi-Fi so your iPhone, iPad and Mac can print to it.", and Joining ("AirWriter is joining *Network*. … open **airwriter-xxxx.local** to print a test page." with Copy).
- [ ] **Step 2:** The finish sheet on the first visit with `fresh`: "AirWriter is ready", each printer with its lamp and Print Test Page, newly found ones, the two lines for iPhone/iPad and Mac, Done (posts `finish`).
- [ ] **Step 3:** `states.json`: each setup step (found, nothing found), joining, the finish sheet; check all in preview as Task 11; `mkheader.py`; build.
- [ ] **Step 4: Commit** `webui: printers in setup, and AirWriter is ready (W-1088)`.

### Task 13: Fakes for the bench

**Files:**
- Modify: `tools/ethertalk/etpeer.py` (`atimagewriter NAME`: an AppleTalk ImageWriter answering PAP with the Option Card status word, saving the stream; `--out`; a startup check that its tunnel IP still matches the Mac's and a restart when it changes), `tools/ethertalk/README.md`, `tools/ethertalk/test_interop.py` (`atimagewriter` case)

- [ ] **Step 1: Failing interop case**: the board's PAP client prints an ImageWriter stream to `atimagewriter` over the pipe; the saved stream equals what was sent.
- [ ] **Step 2: Run** `make -C tools/rip interop` — FAIL. **Step 3: Implement.** **Step 4: Run** — ok.
- [ ] **Step 5: Commit** `etpeer: a fake AppleTalk ImageWriter, and a fake that follows the Mac's IP (W-1088)`.

### Task 14: AppleTalk ImageWriters (last; cuttable)

**Files:**
- Modify: `laser.c` (kind AT_IW: the ImageWriter rip's stream into the spool, ImageWriter II caps, colour from status bit 0x80, attention from 0x20), `job_pipe_rip.c` target for an ImageWriter-stream stage over PAP
- Test: `tools/rip/test/test_lw.c` (`test_at_iw_status_word`), interop `atimagewriter` print

- [ ] **Step 1: Failing tests**: status word 0x20 → attention "out of paper"; 0x80 → colour; 0x00 → ready.
- [ ] **Step 2–4:** Run (FAIL), implement, run all host tests and interop (ok).
- [ ] **Step 5: Bench**: fake AppleTalk ImageWriter on the tunnel appears on `dns-sd` and prints the checker; its saved stream equals `checker.expected.bin` at top margin 0.
- [ ] **Step 6: Commit** `laser: print to an AppleTalk ImageWriter over PAP (W-1088)`.

### Task 15: Docs and wiki drafts

**Files:**
- Modify: `README.md`, `AGENTS.md`, `docs/SPEC.md` (§3.4, §3.5, §3.13, §3.14 and a new section for printers), `docs/traps.md`; wiki clone in the scratchpad: `Home.md`, `Setup.md`, new `Printers.md` (replaces the LaserWriters draft), `Vintage-Macs-(LocalTalk).md`, `Status-Lights.md`, `Settings-and-Updates.md` (rewritten for the W-1079 page), `Troubleshooting.md`, `_Sidebar.md`

- [ ] **Step 1:** Repo docs in the wording the spec gives (README's opening sentence verbatim).
- [ ] **Step 2:** Wiki drafts in the wiki's plain second-person style; no push.
- [ ] **Step 3: Commit** `docs: printers, not an ImageWriter (W-1088)`.

### Task 16: End to end on board 1, review, hand over

- [ ] **Step 1:** The spec's seven steps in order, each result written in the ledger, with the stand-ins the spec names, NVS backed up before step 2 and restored after; checker crc32 `8ee84844` read on the console.
- [ ] **Step 2:** Whole-branch review on the most capable model (Opus) with the spec, this plan and the Review Focus; fix Critical and Important findings test-first.
- [ ] **Step 3:** Push the branch; tell Wells what is ready for his one sitting (Wi-Fi password in the real setup, one iPhone print, the pages and the wiki drafts); merge only on his word.
