wr/airwriter/docs/superpowers/plans/2026-10-20-test-page.md

# Test Page Implementation Plan

> **For agentic workers:** REQUIRED SUB-SKILL: Use superpowers:subagent-driven-development (recommended) or superpowers:executing-plans to implement this plan task-by-task. Steps use checkbox (`- [ ]`) syntax for tracking.

**Goal:** Print the approved full-page test page from all three triggers.

**Architecture:** A pure-C component `testpage` builds the page as an ImageWriter II stream
through an output callback, band by band and line by line, so the firmware and the host tests
run the same code. Bit images go through `halftone` and a shared ink-screening helper in
`ink.c`; text is escape codes. `main.c` fills in the board's details and hands the stream to
`printer_out`.

**Tech Stack:** C11, ESP-IDF 5.5, host tests in `tools/rip` (`test_util.h`), Python 3.14 with
PIL for the art generator and the preview tool.

**Spec:** `docs/superpowers/specs/2026-10-20-test-page-design.md`

## Global Constraints

- 1152 dots across (144 dpi), rows at 72 dpi, line feeds in 1/144 in; content from 0.5 in to at
  most 10.5 in below top of form.
- No text line wider than 8 in; `ESC F` values ascending within a line and under 1152.
- No `ESC K` unless the ribbon is colour; the page ends on black.
- The colour fixture and every other `make -C tools/rip regress` stream stay byte-identical.
- Copy on the page is exactly the spec's.

## Review Focus

- A host name, name or version longer than its column: cut to the column, never past 8 in.
- A second tap during the ribbon wait or mid-page: stops within one line or strip.
- Setup mode (no IP yet): the Wi-Fi line and 192.168.4.1, no "0.0.0.0".
- Unknown ribbon: the black page with the "could not tell" note.
- Each screen as the one in use: exactly one tick, beside that screen's name.

---

### Task 1: Shared ink screening

**Files:** Modify `firmware/components/ripjob/include/ink.h`, `ink.c`, `ripjob.c`;
Test `tools/rip/test/test_ink.c`.

**Interfaces — Produces:**
```c
typedef struct { ht_t ht[IW_INKS]; uint8_t *plane[IW_INKS]; uint8_t *avoid; uint32_t w; } ink_screens_t;
int  ink_screens_init(ink_screens_t *s, ht_algo_t algo, int gain, uint32_t w);   // 0 or -1
void ink_screens_row(ink_screens_t *s, const uint8_t *rgb, uint8_t *const bits[IW_INKS]);
void ink_screens_free(ink_screens_t *s);
void ink_screen_phase(ht_t *h, iw_ink_t ink);   // the ink's mask phase, for one-ink rows
```
- [ ] Test: a 64-px RGB row of pure red screened through `ink_screens_row` prints only
  magenta and yellow dots and the same bits as `ink_split` + the ink-ordered `ht_row_avoid` loop.
- [ ] Move `ink_order`, `ink_phase` and `on_rgb_row`'s loop into `ink.c`; `ripjob.c` uses it.
- [ ] `make -C tools/rip test regress`: all pass, all four streams unchanged. Commit.

### Task 2: Letterhead art

**Files:** Create `firmware/components/testpage/tools/mkart.py`, generated
`firmware/components/testpage/tp_art.h`.

**Produces:** `TP_TITLE_W/H`, `tp_title[]` ("AirWriter", cap height 34 rows), `TP_SUB_W/H`,
`tp_sub[]` ("Test page", cap height 20 rows), rows MSB-first, `(W+7)/8` bytes each;
`TP_ICON_W 32`, `TP_ICON_H 28`, `tp_icon[]` palette indices and `tp_icon_rgb[][3]`.
- [ ] Script reads the woff2 out of `tools/webui/style.css` and `tools/icon/imagewriter.txt`,
  renders as the approved mock-up did (threshold 100 after a Lanczos scale to 2x across).
- [ ] Commit script and header.

### Task 3: Still life

**Files:** Create `firmware/components/testpage/tp_scene.c`, `include/tp_scene.h`;
Test `tools/rip/test/test_testpage.c`.

**Produces:** `void tp_scene_row(uint32_t w, uint32_t h, uint32_t y, uint8_t *rgb);`
(w x 3 bytes of sRGB for row y of a w-by-h picture at 144 x 72 dpi).
- [ ] Tests: row 0 is sky (blue the largest channel); a pixel at the red ball's centre is red
  dominant; the floor's bottom row is warm gray (no channel more than 40 from another); two
  calls give the same bytes.
- [ ] Port `scene.py` in float: the four spheres, the light, the 6 fixed shadow jitters, 2 x 2
  supersampling, the sRGB curve. Commit.

### Task 4: The page builder

**Files:** Create `firmware/components/testpage/testpage.c`, `include/testpage.h`,
`CMakeLists.txt`; Modify `tools/rip/Makefile`; Test `tools/rip/test/test_testpage.c`.

**Produces:**
```c
typedef struct {
    const char *version, *built, *model, *name, *host, *ip, *setup_ssid, *appletalk;
    iw_ribbon_t ribbon; ht_algo_t screen; int gain;
} tp_info_t;            // host: without .local; setup_ssid non-NULL in setup mode
typedef struct { iw_out_fn out; void *out_ctx; int (*stop)(void *ctx); void *stop_ctx; } tp_io_t;
typedef enum { TP_DONE = 0, TP_STOPPED = 1, TP_NOMEM = -1 } tp_result_t;
tp_result_t tp_print(const tp_info_t *info, const tp_io_t *io);
```
- [ ] Tests, each against a small interpreter in the test (ESC c/p/n/N/E/e/q/Q/P, ESC T, ESC F,
  ESC G, ESC V, ESC K, CR, LF, FF; text advance by pitch):
  starts `ESC c`, ends `FF` between commands (`iw_scan_between`); every line's extent ≤ 1152
  dots; last printed row ≤ 10.5 in; colour ribbon sends `ESC K` 0-6 and ends on `ESC K0`;
  black and unknown send none; unknown carries "could not tell"; version, host and IP appear;
  setup mode shows "join AirWriter-2434" and "http://192.168.4.1" and no "0.0.0.0"; for each of
  the five screens exactly one `ESC & D` and it follows that screen's name; a 60-character host
  name stays inside 8 in; `stop` true after its 10th call returns `TP_STOPPED` with no FF.
- [ ] Implement as the mock-up's layout (spec section "The page").
- [ ] `make -C tools/rip test`. Commit.

### Task 5: Preview tools

**Files:** Modify `tools/rip/main.c` (`--testpage [colour|black|unknown]` writes the stream);
Create `tools/iwview/iwview.py`.
- [ ] `rip --testpage colour --out-stream /tmp/tp.bin` then `iwview.py /tmp/tp.bin tp.png`
  renders the page; compare with the approved preview by eye. Commit.

### Task 6: Firmware

**Files:** Modify `firmware/main/main.c` (`test_page_task`, `ribbon_check`), `main/CMakeLists.txt`.
- [ ] `test_page_task`: ribbon check, `tp_info_t` from the settings, app description and link
  states, `tp_print` with `printer_out` and a stop that reads `s_test_cancel`; log free
  internal heap before, its minimum after, and the task's stack high-water mark.
- [ ] `idf.py build` clean; record app size and slot headroom. Commit.

### Task 7: Docs

- [ ] AGENTS.md (state, layout), SPEC test-button line, `docs/traps.md` if anything bit. Commit.
