wr/airwriter/(list of files, drawings)

Other design files:
hardware/airwriter/airwriter.dsn
