wr/airwriter/hardware/airwriter/airwriter.kicad_pcb

## KiCad design hardware/airwriter/airwriter.kicad_pcb (2026-10-29)

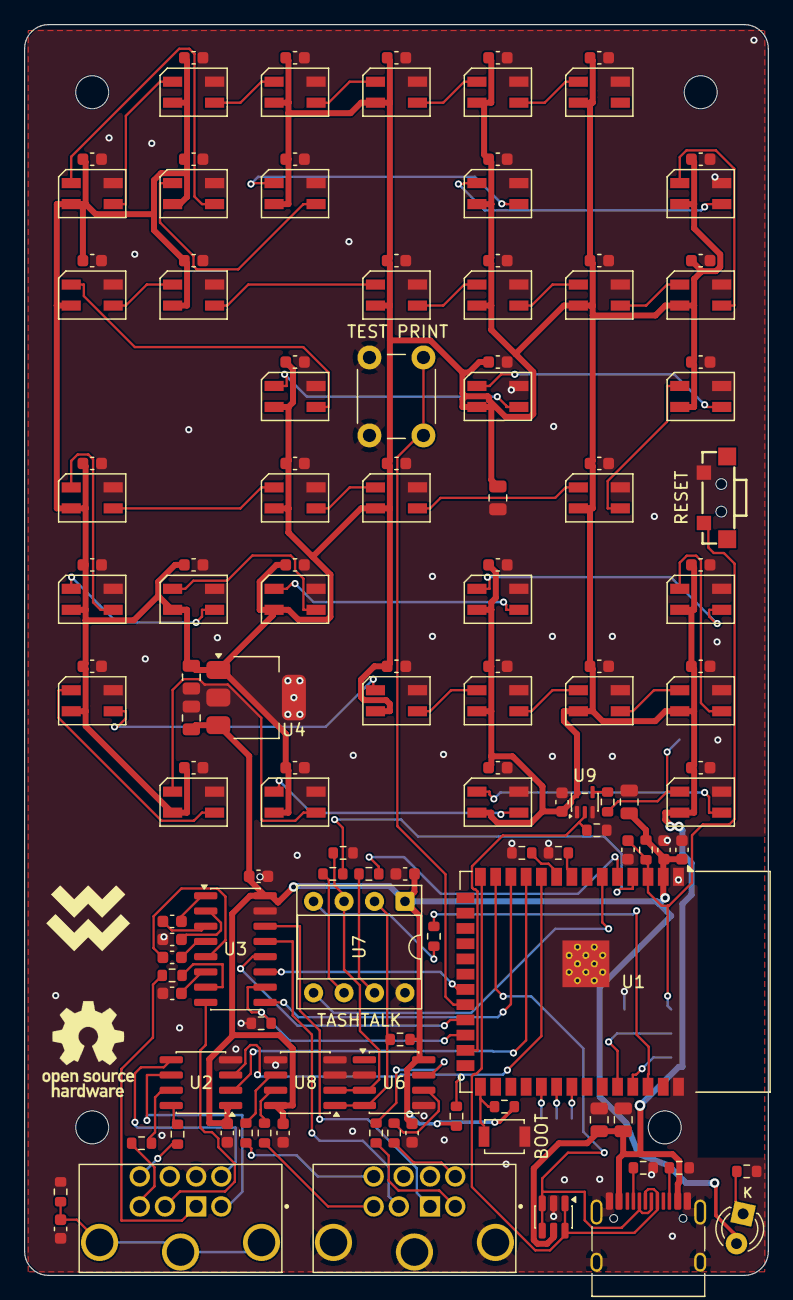
[picture p11: board airwriter.kicad_pcb from above]

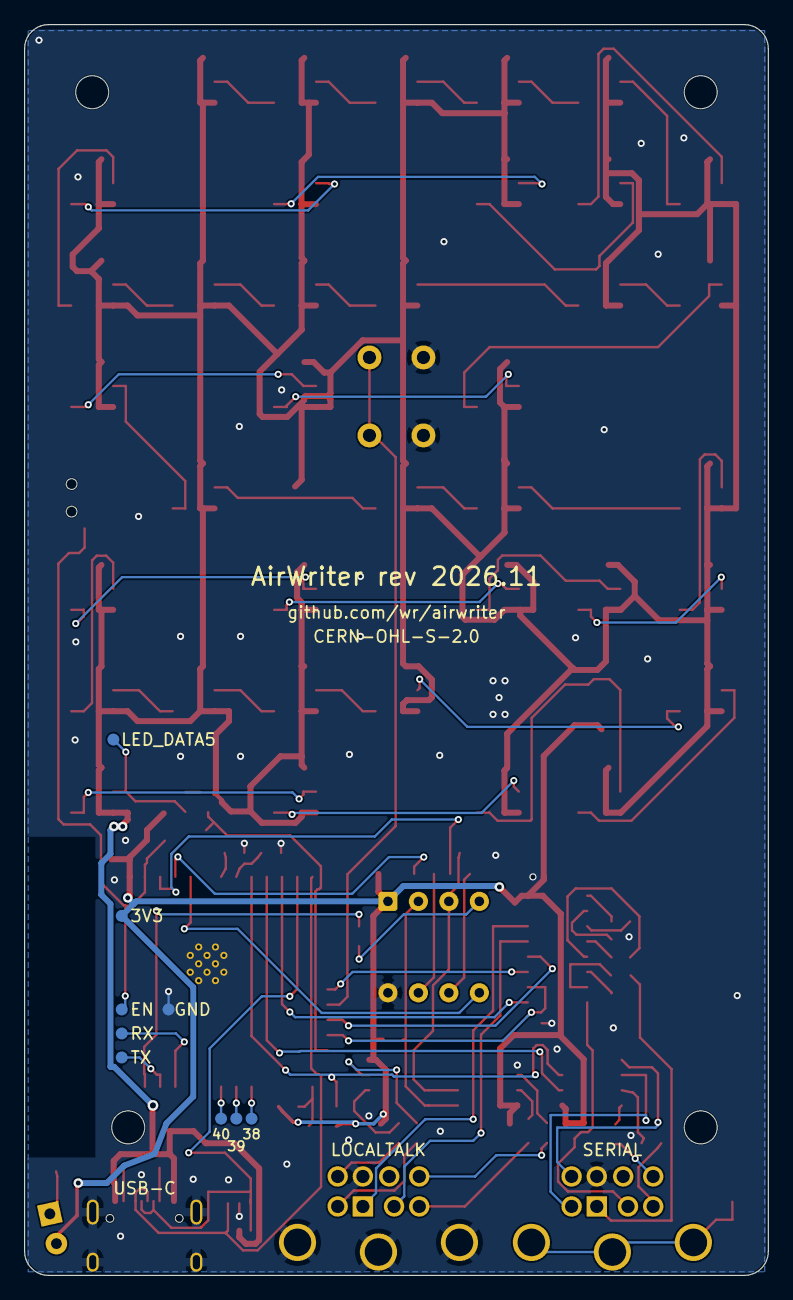
[picture p12: board airwriter.kicad_pcb from below]

Board: 2 copper layers, 62.0 x 104.3 mm, 148 parts (9 on the bottom side), 98 nets.

Parts:
C1, C21, C22: 22u; C_0805_2012Metric
C2, C4: 10u; C_0805_2012Metric
C3, C5, C9, C10, C11, C12, C13, C14, C16, C17, C18, C29, C30, C31, C32, C33, C34, C35, C36, C37, C38, C39, C40, C41, C42, C43, C44, C45, C46, C47, C48, C49, C50, C51, C52, C53, C54, C55, C56, C57, C58, C59, C60, C61, C62, C63, C64, C65, C66: 100n; C_0603_1608Metric
C6: 1u; C_0603_1608Metric
C15: 1n; C_0603_1608Metric
C67: 1u; C_0805_2012Metric
D3: green PWR; LED_D3.0mm_Spacer_H8mm
D10, D11, D12, D13, D14, D15, D16, D17, D18, D19, D20, D21, D22, D23, D24, D25, D26, D27, D28, D29, D30, D31, D32, D33, D34, D35, D36, D37, D38, D39, D40, D41, D42, D43, D44, D45, D46: SK6812MINI-C; LED_SK6812MINI_PLCC4_3.5x3.5mm_P1.75mm
H1, H2, H3, H4: MountingHole_2.2mm_M2
J1: USB-C 5V in; USB_C_Receptacle_HRO_TYPE-C-31-M-12
J2: Mini-DIN-8 to printer; MiniDIN-8_Kycon_KMDGX-8S-BS_RightAngle
J4: Mini-DIN-8 LocalTalk; MiniDIN-8_Kycon_KMDGX-8S-BS_RightAngle
LOGO1: OSHW-Logo_7.5x8mm_SilkScreen
R1, R2: 5.1k; R_0603_1608Metric
R3, R14, R21, R22, R23, R24, R25, R32, R33: 10k; R_0603_1608Metric
R8, R9: 0R; R_0603_1608Metric
R10, R11, R12, R13: 10R; R_0603_1608Metric
R15, R16: 100R; R_0603_1608Metric
R17: 150R; R_0603_1608Metric
R20: 47R; R_0603_1608Metric
R27: 1k; R_0603_1608Metric
R29, R30: 15k; R_0603_1608Metric
SW1: TSB001A3518A; SW_BZCN_TSB001A3518A
SW2: B3U-1000P; SW_SPST_B3U-1000P
SW3: TS-1002-BR15026; SW_PUSH_6mm_H13mm
TP2: +3V3; TestPoint_Pad_D1.0mm
TP4: EN; TestPoint_Pad_D1.0mm
TP5: LED_DATA5; TestPoint_Pad_D1.0mm
TP7: TXD0; TestPoint_Pad_D1.0mm
TP8: RXD0; TestPoint_Pad_D1.0mm
TP9: GND; TestPoint_Pad_D1.0mm
TP10: SPARE_IO38; SparePad_D1.0mm
TP11: SPARE_IO39; SparePad_D1.0mm
TP12: SPARE_IO40; SparePad_D1.0mm
U1: ESP32-S3-WROOM-1-N16R8; ESP32-S3-WROOM-1
U2: THVD1451DR; SOIC-8_3.9x4.9mm_P1.27mm
U3: SP3232EBEN-L/TR; SOIC-16_3.9x9.9mm_P1.27mm
U4: AP7361C-33E; SOT-223-3_TabPin2
U5: USBLC6-2SC6; SOT-23-6
U6, U8: SP3485EN-L; SOIC-8_3.9x4.9mm_P1.27mm
U7: PIC12F1840-I/P; DIP-8_W7.62mm_Socket
U9: SN74LV1T125DCKR; SOT-353_SC-70-5

Connections:
/+3V3: C2.1, C3.1, C4.1, C5.1, C9.1, C14.1, C16.1, C17.1, C18.1, D3.2, R3.1, R14.1, R21.1, R25.1, TP2.1, U1.2 (3V3), U2.1 (VCC), U3.16 (VCC), U4.3 (VO), U6.8 (VCC), U7.1 (VDD), U8.8 (VCC)
/BOARD_LC: R33.1, U1.8 (IO15)
/BOARD_REV: R32.1, U1.9 (IO16)
/BOOT_CFG: R21.2, SW2.1, U1.27 (IO0)
/BTN_TEST: SW3.1, U1.22 (IO14)
/CC1: J1.A5 (CC1), R1.1
/CC2: J1.B5 (CC2), R2.1
/CP1N: C10.2, U3.3 (C1-)
/CP1P: C10.1, U3.1 (C1+)
/CP2N: C11.2, U3.5 (C2-)
/CP2P: C11.1, U3.4 (C2+)
/EN: C6.1, R3.2, SW1.1, TP4.1, U1.3 (EN)
/GND: C1.2, C2.2, C3.2, C4.2, C5.2, C6.2, C9.2, C12.2, C13.2, C14.2, C15.2, C16.2, C17.2, C18.2, C21.2, C22.2, C29.2, C30.2, C31.2, C32.2, C33.2, C34.2, C35.2, C36.2, C37.2, C38.2, C39.2, C40.2, C41.2, C42.2, C43.2, C44.2, C45.2, C46.2, C47.2, C48.2, C49.2, C50.2, C51.2, C52.2, C53.2, C54.2, C55.2, C56.2, C57.2, C58.2, C59.2, C60.2, C61.2, C62.2, C63.2, C64.2, C65.2, C66.2, C67.1, D10.2, D11.2, D12.2, D13.2, D14.2, D15.2, D16.2, D17.2, D18.2, D19.2, D20.2, D21.2, D22.2, D23.2, D24.2, D25.2, D26.2, D27.2, D28.2, D29.2, D30.2, D31.2, D32.2, D33.2, D34.2, D35.2, D36.2, D37.2, D38.2, D39.2, D40.2, D41.2, D42.2, D43.2, D44.2, D45.2, D46.2, J1.A1 (GND), J1.A12 (GND), J1.B1 (GND), J1.B12 (GND), J1.SH (SHIELD), J2.4 (GND), J4.4 (GND), J4.9 (SHIELD), R1.2, R2.2, R8.2, R17.2, R22.2, R23.2, R24.2, R32.2, R33.2, SW1.2, SW2.2, SW3.2, TP9.1, U1.1 (GND), U1.40 (GND), U1.41 (GND), U2.4 (GND), U3.15 (GND), U4.2 (GND), U5.2 (GND), U6.2 (~RE), U6.5 (GND), U7.8 (VSS), U8.3 (DE), U8.4 (DI), U8.5 (GND), U9.1, U9.3 (GND)
/HSKI_DRV: R24.1, U1.24 (IO47), U3.10 (T2IN)
/HSKI_RS232: R9.1, U3.7 (T2OUT)
/J4_HSKI: J4.2 (HSKi), U3.13 (R1IN)
/J4_HSKI_RX: U1.23 (IO21), U3.12 (R1OUT)
/J4_HSKO: J4.1 (HSKo), U3.14 (T1OUT)
/J4_HSKO_DRV: U1.21 (IO13), U3.11 (T1IN)
/LED_CH01: D10.1, D11.3
/LED_CH02: D11.1, D12.3
/LED_CH03: D12.1, D13.3
/LED_CH04: D13.1, D14.3
/LED_CH05: D14.1, D15.3
/LED_CH06: D15.1, D16.3
/LED_CH07: D16.1, D17.3
/LED_CH08: D17.1, D18.3
/LED_CH09: D18.1, D19.3
/LED_CH10: D19.1, D20.3
/LED_CH11: D20.1, D21.3
/LED_CH12: D21.1, D22.3
/LED_CH13: D22.1, D23.3
/LED_CH14: D23.1, D24.3
/LED_CH15: D24.1, D25.3
/LED_CH16: D25.1, D26.3
/LED_CH17: D26.1, D27.3
/LED_CH18: D27.1, D28.3
/LED_CH19: D28.1, D29.3
/LED_CH20: D29.1, D30.3
/LED_CH21: D30.1, D31.3
/LED_CH22: D31.1, D32.3
/LED_CH23: D32.1, D33.3
/LED_CH24: D33.1, D34.3
/LED_CH25: D34.1, D35.3
/LED_CH26: D35.1, D36.3
/LED_CH27: D36.1, D37.3
/LED_CH28: D37.1, D38.3
/LED_CH29: D38.1, D39.3
/LED_CH30: D39.1, D40.3
/LED_CH31: D40.1, D41.3
/LED_CH32: D41.1, D42.3
/LED_CH33: D42.1, D43.3
/LED_CH34: D43.1, D44.3
/LED_CH35: D44.1, D45.3
/LED_CH36: D45.1, D46.3
/LED_DATA: R23.1, U1.25 (IO48), U9.2
/LED_DATA5: D10.3, R20.1, TP5.1
/LED_DATA5R: R20.2, U9.4
/LT_CTS: U1.6 (IO6), U7.5 (RA2)
/LT_DATA: R14.2, U6.4 (DI), U7.2 (RA5), U8.1 (RO)
/LT_DE: R22.1, U6.3 (DE), U7.3 (RA4), U8.2 (~RE)
/LT_ICSPCLK: R15.2, U7.6 (RA1)
/LT_ICSPDAT: R16.2, U7.7 (RA0)
/LT_MCLR: R27.2, U7.4 (RA3)
/LT_PORT_RXD_N: J4.5 (RxD-), R10.2
/LT_PORT_RXD_P: J4.8 (RxD+), R11.2
/LT_PORT_TXD_N: J4.3 (TxD-), R12.2
/LT_PORT_TXD_P: J4.6 (TxD+), R13.2
/LT_RESET: R27.1, U1.38 (IO2)
/LT_RXD_N: R10.1, U8.7 (B)
/LT_RXD_P: R11.1, U8.6 (A)
/LT_TXD_N: R12.1, U6.7 (B)
/LT_TXD_P: R13.1, U6.6 (A)
/LT_UART_RX: R16.1, U1.5 (IO5)
/LT_UART_TX: R15.1, U1.4 (IO4)
/PR_HSKI: J2.1 (HSKo), R9.2
/PR_HSKO: J2.2 (HSKi), U3.8 (R2IN)
/PR_RXD_N: J2.3 (TxD-), U2.6 (Z)
/PR_RXD_P: J2.6 (TxD+), U2.5 (Y)
/PR_TXD_N: J2.5 (RxD-), R30.1
/PR_TXD_N_IN: R30.2, U2.7 (B)
/PR_TXD_P: J2.8 (RxD+), R29.1
/PR_TXD_P_IN: R29.2, U2.8 (A)
/RXD0: TP8.1, U1.36 (RXD0)
/SHELL: C15.1, J2.9 (SHIELD), R8.1
/SPARE_IO38: TP10.1, U1.31 (IO38)
/SPARE_IO39: TP11.1, U1.32 (IO39)
/SPARE_IO40: TP12.1, U1.33 (IO40)
/TXD0: TP7.1, U1.37 (TXD0)
/UART_CTS: U1.12 (IO8), U3.9 (R2OUT)
/UART_RX: U1.11 (IO18), U2.2 (RO)
/UART_TX: R25.2, U1.10 (IO17), U2.3 (DI)
/USB_DM: J1.A7 (D-), J1.B7 (D-), U1.13 (USB_D-), U5.3 (I/O2), U5.4 (I/O2)
/USB_DP: J1.A6 (D+), J1.B6 (D+), U1.14 (USB_D+), U5.1 (I/O1), U5.6 (I/O1)
/VBUS: C1.1, C21.1, C22.1, C29.1, C30.1, C31.1, C32.1, C33.1, C34.1, C35.1, C36.1, C37.1, C38.1, C39.1, C40.1, C41.1, C42.1, C43.1, C44.1, C45.1, C46.1, C47.1, C48.1, C49.1, C50.1, C51.1, C52.1, C53.1, C54.1, C55.1, C56.1, C57.1, C58.1, C59.1, C60.1, C61.1, C62.1, C63.1, C64.1, C65.1, C66.1, C67.2, D10.4, D11.4, D12.4, D13.4, D14.4, D15.4, D16.4, D17.4, D18.4, D19.4, D20.4, D21.4, D22.4, D23.4, D24.4, D25.4, D26.4, D27.4, D28.4, D29.4, D30.4, D31.4, D32.4, D33.4, D34.4, D35.4, D36.4, D37.4, D38.4, D39.4, D40.4, D41.4, D42.4, D43.4, D44.4, D45.4, D46.4, J1.A4 (VBUS), J1.A9 (VBUS), J1.B4 (VBUS), J1.B9 (VBUS), U4.1 (VI), U5.5 (VBUS), U9.5 (VCC)
/VS_NEG: C13.1, U3.6 (VS-)
/VS_POS: C12.1, U3.2 (VS+)
unnamed: D3.1, R17.1
