wr/airwriter/firmware/main/main.c

// SPDX-License-Identifier: GPL-3.0-or-later
//
// AirWriter application entry point.
//
// M4 scope: join WiFi, advertise over mDNS, answer IPP. A job is accepted and
// counted, not printed -- serial_out and printer_state land with the board.
#include <string.h>
#include <stdio.h>

#include "driver/gpio.h"
#include "esp_rom_sys.h"
#include "esp_log.h"
#include "esp_system.h"
#include "esp_timer.h"
#include "esp_mac.h"
#include "esp_event.h"
#include "esp_netif.h"
#include "esp_wifi.h"
#include "nvs.h"
#include "nvs_flash.h"
#include "freertos/FreeRTOS.h"
#include "freertos/task.h"
#include "freertos/event_groups.h"
#include "freertos/semphr.h"

#include "dip_config.h"
#include "halftone.h"
#include "imagewriter.h"
#include "ipp_server.h"
#include "job_pipe.h"
#include "led_grid.h"
#include "led_grid_core.h"
#include "printer_state.h"
#include "serial_out.h"
#include "settings.h"
#include "webui.h"
#include "net_provision.h"
#include "pic_prog.h"
#include "localtalk.h"
#include "ethertalk.h"
#include "lt_node.h"
#include "laser.h"
#include "printers.h"
#include "printer_caps.h"
#include "port_policy.h"
#include "stylewriter.h"
#include "sw_status.h"
#include "qdlaser.h"
#include "qd_link.h"
#include "qd_status.h"
#include "ota_health.h"
#include "fw_update.h"
#include "cable_test.h"
#include "testpage.h"
#include "esp_heap_caps.h"
#include "bigmem.h"
#include "memdiag.h"
#include "logbook.h"
#include "esp_app_desc.h"
#include "esp_partition.h"
#if CONFIG_BOOTLOADER_RESERVE_RTC_MEM
#include "bootloader_common.h"
#endif

static const char *TAG = "airwriter";

// A Kconfig bool that is off defines nothing at all, so every one of these
// needs a fallback rather than a bare CONFIG_ reference.
#ifdef CONFIG_AIRWRITER_INVERT_TX
#define AW_INVERT_TX 1
#else
#define AW_INVERT_TX 0
#endif
#ifdef CONFIG_AIRWRITER_INVERT_RX
#define AW_INVERT_RX 1
#else
#define AW_INVERT_RX 0
#endif
#ifdef CONFIG_AIRWRITER_INVERT_CTS
#define AW_INVERT_CTS 1
#else
#define AW_INVERT_CTS 0
#endif
#ifdef CONFIG_AIRWRITER_UART_LOOPBACK
#define AW_LOOPBACK 1
#else
#define AW_LOOPBACK 0
#endif

// W-1046: the way back lives below the app, in the bootloader and the
// partition table, so the sdkconfig has to carry it. sdkconfig.defaults only
// seed a new sdkconfig; an older one keeps its old values, and this is where
// that shows rather than on a board that cannot recover.
#if !CONFIG_BOOTLOADER_APP_ROLLBACK_ENABLE
#error "sdkconfig predates W-1046: enable CONFIG_BOOTLOADER_APP_ROLLBACK_ENABLE (sdkconfig.defaults)"
#endif
// W-1059: the power-up reset is the bootloader hook's (airwriter_boot). IDF's
// own would erase otadata and boot ota_0 instead of the known-good slot.
#if CONFIG_BOOTLOADER_FACTORY_RESET
#error "sdkconfig predates W-1059: turn CONFIG_BOOTLOADER_FACTORY_RESET off (sdkconfig.defaults.esp32s3)"
#endif
#if !CONFIG_BOOTLOADER_RESERVE_RTC_MEM
#error "sdkconfig predates W-1059: set CONFIG_BOOTLOADER_CUSTOM_RESERVE_RTC (sdkconfig.defaults.esp32s3)"
#endif
#if CONFIG_AIRWRITER_TEST_BTN_PIN != 14
#error "the bootloader hook's reset pin (airwriter_boot, RESET_PIN) must be the test button"
#endif
// W-1048: an image that is not signed would refuse every update after it
// (IDF trusts the key that signed the running image), so every build is.
#if !CONFIG_SPIRAM_ALLOW_NOINIT_SEG_EXTERNAL_MEMORY
#error "sdkconfig predates W-1136: enable CONFIG_SPIRAM_ALLOW_NOINIT_SEG_EXTERNAL_MEMORY (sdkconfig.defaults.esp32s3)"
#endif
#if !CONFIG_SECURE_SIGNED_APPS_NO_SECURE_BOOT || !CONFIG_SECURE_SIGNED_APPS_RSA_SCHEME || \
    !CONFIG_SECURE_SIGNED_ON_UPDATE_NO_SECURE_BOOT || !CONFIG_SECURE_BOOT_BUILD_SIGNED_BINARIES
#error "sdkconfig predates W-1048: copy the signing options from sdkconfig.defaults"
#endif
// W-1109: each board's build carries its own module and pins. An sdkconfig made for one
// board and switched to the other in menuconfig keeps the first board's values; this is
// where that shows. Rev 2026.11's PSRAM is on IO35-IO37: nothing may name them.
#if CONFIG_AIRWRITER_BOARD_2026_11
// The bootloader hook knows the board only by the flash size.
#if !CONFIG_SPIRAM_MODE_OCT || !CONFIG_ESPTOOLPY_FLASHSIZE_16MB
#error "a rev 2026.11 build needs octal PSRAM and 16 MB flash (sdkconfig.defaults.2026.11)"
#endif
#if CONFIG_AIRWRITER_HSKI_DRV_PIN != 47 || CONFIG_AIRWRITER_J4_HSKO_DRV_PIN != 13 || \
    CONFIG_AIRWRITER_J4_HSKI_PIN != 21 || CONFIG_AIRWRITER_BOARD_REV_PIN != 16 || \
    CONFIG_AIRWRITER_BOARD_LC_PIN != 15
#error "this sdkconfig has rev A's pins: start sdkconfig.2026.11 again from the defaults"
#endif
#if CONFIG_AIRWRITER_DIP1_PIN >= 0 || CONFIG_AIRWRITER_DIP2_PIN >= 0 || CONFIG_AIRWRITER_DIP3_PIN >= 0 || \
    CONFIG_AIRWRITER_DIP4_PIN >= 0 || CONFIG_AIRWRITER_DIP5_PIN >= 0 || CONFIG_AIRWRITER_DIP6_PIN >= 0 || \
    CONFIG_AIRWRITER_DIP7_PIN >= 0 || CONFIG_AIRWRITER_DIP8_PIN >= 0
#error "rev 2026.11 has no DIP switches: start sdkconfig.2026.11 again from the defaults"
#endif
#else
#if CONFIG_IDF_TARGET_ESP32S3 && (!CONFIG_SPIRAM_MODE_QUAD || !CONFIG_ESPTOOLPY_FLASHSIZE_8MB || \
    CONFIG_AIRWRITER_HSKI_DRV_PIN != 35 || CONFIG_AIRWRITER_J4_HSKO_DRV_PIN >= 0 || \
    CONFIG_AIRWRITER_BOARD_REV_PIN >= 0)
#error "this sdkconfig has rev 2026.11's module or pins: build it with -DAIRWRITER_BOARD=2026.11"
#endif
#endif
_Static_assert(LG_RESET_FILL_MS == BTN_FILL_MS,
               "the panel's countdown must run out when the button commits");

#define WIFI_CONNECTED_BIT BIT0
#define WIFI_FAILED_BIT    BIT1
#define WIFI_MAX_RETRY     8

static EventGroupHandle_t s_wifi_events;
static int s_retries;
static settings_t s_set;
static char s_ip[16] = "0.0.0.0";
static int  s_ap_mode;

// Reconnect after a drop. Once the board has had the network it never falls
// back to setup mode on its own -- a router reboot is no reason to make the
// user re-provision -- it keeps trying, backing off 1, 2, 4 ... 30 s.
static int s_wifi_was_up;
static uint32_t s_backoff_ms = 1000;
static esp_timer_handle_t s_reconnect;

static void reconnect_cb(void *arg)
{
    (void)arg;
    esp_wifi_connect();
}

// Last job, for the status page.
static char   s_last_job[64];
static int32_t s_last_job_id;          // what the log calls it: it never holds the name (W-1136)
static int    s_printing;
static size_t s_last_pages, s_last_bytes;
// W-1132: what s_printing is busy with is a print-head cleaning (sw_clean_web to the end of
// sw_clean_task): the settings page says Cleaning for the StyleWriter, not Printing.
static volatile int s_cleaning;

// The real mutual exclusion between a real IPP job and a test page: taken
// (blocking) at the top of doc_begin and (non-blocking) in test_page, given
// back in job_finished -- when the job has printed, not when its upload
// ended -- and at the bottom of test_page_task. s_printing above is
// merely the status page's idea of "busy" -- it is not itself a lock, since
// checking it and then setting it is not atomic across tasks.
//
// A binary semaphore, not a mutex: test_page takes it on dip_config's poll
// task and test_page_task gives it back, and a mutex given by a task that
// does not hold it trips FreeRTOS's priority-disinherit assert (W-1033).
static SemaphoreHandle_t s_job_lock;

// W-1048: a firmware update holds s_job_lock from its start to the restart,
// and gives way to a job that arrives meanwhile. A job that finds the lock
// taken raises this; the update reads it between chunks and lets go. Only
// jobs raise it -- a refused CTRL-X kick or TashTalk flash is not a job.
// The test page holds s_job_lock, and a second tap cancels it (W-1049). The
// tap and the page's end decide under s_tap_mux, so a tap landing as the page
// finishes can never set its cancel on the next job instead.
static portMUX_TYPE s_tap_mux = portMUX_INITIALIZER_UNLOCKED;
static int s_test_running;      // the test page holds the lock
static int s_sw_test_running;   // ... and it is a StyleWriter's or a 300's: a session, not ImageWriter writes
static volatile int s_test_cancel;  // a second tap asked to stop it

static volatile int s_job_waiting;
// Uptime seconds of the last job's start or end, -1 for none yet:
// auto-update installs only once the board has been idle for a while.
static volatile int32_t s_last_job_s = -1;

static void job_touch(void)
{
    s_last_job_s = (int32_t)(esp_timer_get_time() / 1000000);
}

// For the log, which leaves flash alone while a job is on or just ended. Reads the count,
// never takes the lock: it's a binary semaphore, and a job arriving in that instant would be
// told the board was busy.
static int job_busy(void)
{
    if (!s_job_lock || uxSemaphoreGetCount(s_job_lock) == 0) return 1;
    int32_t last = s_last_job_s;
    return last >= 0 && esp_timer_get_time() / 1000000 - last < 5;
}

// ---------------------------------------------------------------- raster
// A bring-up check that the raster components run on this silicon, not just
// that they compile. Cheap enough to keep on the boot path.

#define SELFTEST_W 256
#define SELFTEST_H 16

static void count_out(void *ctx, const uint8_t *buf, size_t n)
{
    (void)buf;
    *(size_t *)ctx += n;
}

static void raster_selftest(void)
{
    ht_t h;
    if (ht_init(&h, HT_ATKINSON, SELFTEST_W) != 0) {
        ESP_LOGE(TAG, "raster selftest: ht_init failed");
        return;
    }

    // Once at boot: from the heap, not 2.3 KB of .bss held for good (W-1094).
    iw_t *w = big_calloc(1, sizeof *w);
    if (!w) {
        ht_free(&h);
        ESP_LOGE(TAG, "raster selftest: no memory");
        return;
    }
    size_t emitted = 0;
    iw_init(w, SELFTEST_W, count_out, &emitted);
    iw_begin_page(w);

    uint8_t gray[SELFTEST_W];
    uint8_t bits[(SELFTEST_W + 7) / 8];
    for (uint32_t y = 0; y < SELFTEST_H; y++) {
        for (uint32_t x = 0; x < SELFTEST_W; x++)
            gray[x] = (uint8_t)(x * 255 / (SELFTEST_W - 1));
        ht_row(&h, gray, bits);
        iw_row(w, bits);
    }

    iw_end_page(w);
    free(w);
    ht_free(&h);
    ESP_LOGI(TAG, "raster selftest: %ux%u page -> %u printer bytes",
             SELFTEST_W, SELFTEST_H, (unsigned)emitted);
}

// ------------------------------------------------------------- document
// The document goes straight into the raster pipeline. What comes out is the
// ImageWriter byte stream -- the exact bytes serial_out will put on the wire
// once there is a board to put them on. Until then they are checksummed, which
// is enough to compare the device against tools/rip byte for byte.

// CRC-32/ISO-HDLC, computed without a table: 256 entries of flash is not worth
// it at these rates, and this runs once per output byte, not per pixel.
static uint32_t crc32_up(uint32_t crc, const uint8_t *buf, size_t n)
{
    crc = ~crc;
    while (n--) {
        crc ^= *buf++;
        for (int k = 0; k < 8; k++)
            crc = (crc >> 1) ^ (0xEDB88320u & (uint32_t)(-(int32_t)(crc & 1)));
    }
    return ~crc;
}

static uint32_t s_stream_crc;

// Set when serial_out gave up on a stalled printer mid-job. job_pipe_cfg_t's
// out callback returns void, so the failure travels in this flag instead and
// job_finished() reads it for the post-mortem.
static int s_printer_failed;

// Set by doc_cancel: the job ended because the person cancelled it, which the
// panel shows as done, not as a red failure.
static volatile int s_job_cancelled;

// Set by doc_begin to record whether job_pipe_begin actually started the
// pipeline task. doc_end reads it to decide whether job_pipe_end is safe to
// call.
static int s_job_pipe_ok;

// Whether the last job's stream was cut mid-command (W-1041). Only the task
// holding s_job_lock touches it: doc_begin through job_finished, or a test
// page.
static iw_link_t s_link;

static void resync_out(void *ctx, const uint8_t *buf, size_t n)
{
    esp_err_t *err = (esp_err_t *)ctx;
    if (*err == ESP_OK) *err = serial_out_write(buf, n);
}

// A write failed: the printer stayed paused past STALL_ABORT, or the job was
// cancelled. Abort the job so the rip task winds down and job_pipe drops the
// rest of the job's bytes instead of pushing them at a dead line. On the
// printer task, the one writing.
static void printer_fail(void)
{
    s_printer_failed = 1;
    // The dead job's queued tail must not reach the printer when paper
    // returns -- it would print garbage ahead of the next job.
    serial_out_purge();
    job_pipe_abort();
}

// doc_end's verdict on the transfer, for job_finished on the pipeline task.
static volatile int s_doc_ok;

// The AirPrint printer (slot) the LaserWriter job in the pipeline is for (W-1082).
static int s_laser_slot = 1;

// An IPP job holds s_job_lock: from doc_claim's take to job_finished's give.
// A Cancel-Job before doc_begin must not reach the printer another job owns
// -- a LocalTalk job holds it for minutes (W-1053 review). ipp_server passes
// the cancel on again once begin returns.
static volatile int s_ipp_owns;

// The printer stream: checksummed so the device can be compared with tools/rip
// byte for byte, then put on the wire.
// The last stream left the paper away from top of form (cut, or a Mac's that
// stopped mid-page): a form feed first, so this job starts on a fresh page.
// Outside the CRC, as the resync is; after it, in text mode.
static esp_err_t paper_to_tof(void)
{
    if (!iw_link_need_ff(&s_link) || AW_LOOPBACK) return ESP_OK;
    ESP_LOGW(TAG, "the paper was left mid-page; a form feed first");
    static const uint8_t ff[] = { 0x0C };
    return serial_out_write(ff, sizeof ff);
}

static void printer_out(void *ctx, const uint8_t *buf, size_t n)
{
    (void)ctx;
    s_stream_crc = crc32_up(s_stream_crc, buf, n);
    if (s_printer_failed) return;
    // The last job was cut short, so the printer may still be counting a
    // strip's graphics bytes: flush that before this job's first byte. Flow
    // controlled like the job, so it waits out a paused printer; outside the
    // CRC, which is the job's stream alone. Loopback has no printer to resync,
    // and the extra bytes would fail its byte count.
    if (iw_link_need_resync(&s_link) && !AW_LOOPBACK) {
        ESP_LOGW(TAG, "last job was cut short; resyncing the printer first");
        esp_err_t err = ESP_OK;
        iw_resync(resync_out, &err);
        if (err != ESP_OK) { printer_fail(); return; }
    }
    if (paper_to_tof() != ESP_OK) { printer_fail(); return; }
    if (serial_out_write(buf, n) != ESP_OK) printer_fail();
}

// ------------------------------------------------------------- ribbon
// W-1064: which ribbon is in, from the printer's self-ID. What AirPrint
// clients see follows it (the colour attributes and TXT keys, same UUID), and
// RGB pages print in colour only while it says colour. Saved, so a restart
// advertises what the printer last said instead of black until it answers.
static volatile uint8_t    s_ribbon;        // iw_ribbon_t
static volatile int        s_ribbon_want;   // ask the idle printer, from s_ribbon_due on
static volatile TickType_t s_ribbon_due;
static volatile TickType_t s_line_low_at;   // when HSKo last went false
static volatile int        s_line_seen;     // serial_out has reported the line
// W-1082: which printer the panel's printer line follows. While a LaserWriter
// job prints, or with no ImageWriter shared and a LaserWriter shared, the
// LaserWriter's readiness (laser_ready); while the port prints, its HSKo; idle,
// the box's (W-1088): ready while the port printer is, if its record is shared, or any
// shared LaserWriter is (box_ready).
enum { LINE_IW, LINE_LASER };
static volatile int        s_line_src = LINE_IW;
static volatile int        s_iw_ready = -1;    // HSKo as last reported, -1 before
// W-1116: an ImageWriter record reads Ready only once ESC ? has named its model since the
// line came up, never from the line alone, so the page never shows the wrong ImageWriter for a
// moment. Cleared on a line-up after a second or more down, set when ESC ? names the current
// record's model (or an original ImageWriter record's silent line).
static volatile int        s_iw_named;
static volatile int        s_laser_owns;       // the job in the pipeline is the LaserWriter's

// W-1103: a StyleWriter on the port. Its HSKo says nothing, so its own answers are its state:
// `s_iw_ready` above is then what they say (-1 before the first), not the line.
// W-1102: the port's record's family (printers_changed). PR_FAM_IMAGEWRITER also stands for a
// port with no family yet: the line speaks for both (port_fam_norm).
static volatile pr_family_t s_port_fam = PR_FAM_IMAGEWRITER;
static volatile int        s_port_answering;   // the port's printer answered its last question
static volatile sw_state_t s_sw_state = SWS_OFFLINE;   // and what it said (a job's session also reports it)
static volatile int        s_sw_cart;          // pr_live_t.cart: 0 not read yet, 1 black, 2 colour
static volatile pr_family_t s_job_fam;         // the family whose own job is in the pipeline, PR_FAM_NONE otherwise
static volatile int        s_hsko = -1;        // HSKo as last reported, whichever printer is there
static volatile uint32_t   s_line_drops;       // and how often it has gone down

// W-1102: the line (HSKo) speaks for an ImageWriter, and for a port with no family yet; a
// StyleWriter's or a QuickDraw LaserWriter's own answers are its state.
static pr_family_t port_fam_norm(pr_family_t f)
{
    return f == PR_FAM_NONE ? PR_FAM_IMAGEWRITER : f;
}

static int port_line_speaks(void)
{
    return s_port_fam == PR_FAM_IMAGEWRITER || s_port_fam == PR_FAM_NONE;
}

static pr_family_t port_fam_of_mode(port_mode_t m)
{
    return m == PORT_STYLEWRITER ? PR_FAM_STYLEWRITER
         : m == PORT_QDLASER ? PR_FAM_QDLASER : PR_FAM_IMAGEWRITER;
}
// Events for the port task (kick_task), set by whoever knows and cleared by what acts on them.
static volatile int        s_look;             // boot, setup or the Printers section asked
static volatile int        s_confirm_sw;       // the person named the port's printer a StyleWriter
static volatile int        s_confirm_sw_id;    // ...the record they picked (pr_port_sw_found)
static volatile int        s_link_check;       // the record's kind changed: J2's link may be the wrong one
static volatile int        s_screen_check;     // the record on the port changed under a job: its screen follows after
// The port task's books between its calls of port_policy (port_policy.h's port_in_t).
static uint32_t            s_last_plain_ms, s_last_status_ms;
static int                 s_plain_asked, s_plain_unanswered, s_event_plain, s_full_due;
// W-1116: an act to repeat at once (port_in_t.confirm), set after a seen call that returned
// PR_SEEN_AGAIN (one sighting of an answer that would change the list: a model with no
// record, or one that would replace a Something else record or drop an Unknown one; the same
// answer twice makes the change, R16).
static volatile port_act_t s_port_confirm;   // read on the LocalTalk task too (lt_print_begin)
// W-1116: the last printers_port_seen result ribbon_ask kept, for the port task: the record id
// the ESC ? answer belongs to, PR_SEEN_AGAIN (asked again first), or -1.
static int                 s_seen_again = -1;
static volatile int        s_look_person;      // the pending look is the person's Look for Printers
// Bumped by every ask for a look (look_ask) and every line-up edge, so the port task's
// write-back after an act clears only what it saw before the act, never one asked for while
// its exchange ran (up to ~1.7 s): a model change or a Look then is still owed.
static volatile uint32_t   s_look_gen, s_ribbon_gen;
static void look_ask(void) { s_look = 1; s_look_gen++; }
static TaskHandle_t        s_kick_handle;      // the port task (kick_task)
// The port's StyleWriter answered before the session began (a job, the test page, a cleaning):
// if the session then gets nothing, the port is looked at once when it is over.
static volatile int        s_sw_was_answering;
// A session (a job, the test page, a cleaning, the person's pick) got no answer from the port's
// StyleWriter since it last answered: the original then reads as offline when idle and silent
// (sw_idle_silent), until it answers or the next session begins.
static volatile int        s_sw_job_silent;
// The port's StyleWriter was sent a job's end (`E l`: a job, the test page or a cleaning ended
// well) and no reset has woken it since: a 2200, 2400 or 2500 goes dark about 5 minutes later
// and answers nothing until a job's reset wakes it, so its silence reads as ready
// (sw_idle_silent). Answering meanwhile leaves it set: the dark comes after.
static volatile int        s_sw_asleep;
static volatile sw_model_t s_sw_asleep_model;  // whose: another StyleWriter on the port is not asleep
// W-1102: a Personal LaserWriter 300 on the port. Its state as it last said it (a job's session
// reports it too), and the clock on HSKi as serial_out last reported it: clocked, and its rate.
static volatile qd_state_t s_qd_state = QDS_OFFLINE;
static volatile int        s_clocked, s_clock_hz;
// The port task's books for port_policy's clocked port (port_in_t.last_qd_ms, qd_asked).
static uint32_t            s_last_qd_ms;
static int                 s_qd_asked;
// The last job's reason for a person, when it has one (/api/status job_error), cleared as the
// next job starts: a 300 page that didn't fit in its memory. And that job's first such page.
static char                s_job_error[64];
static volatile int        s_qd_bad_page;
static volatile int        s_qd_skipped;       // W-1141: pages of the job too big to print
// W-1116: the AirPrint printer (slot) the port's job came in on, and its record id, from the
// sink's ctx (printers.c's slot_ctx). The job's end goes back to the slot; the record is the
// job's own family (doc_begin) and the ImageWriter gate's (colour_ok), not the port's.
static int                 s_port_job_slot, s_port_job_record;
// W-1116: what an ImageWriter job's (or test page's) own ESC ? and plain questions got, for its
// gate (pr_job_gate): the family (pr_heard_t) and the model it named. Reset as the job's wait
// begins; never the list's history, so a printer that answered before the job and was
// unplugged neither ends the job as "another printer" nor passes it. Written and read on the
// task that holds the job lock.
static int                 s_job_heard, s_job_heard_model;
// The job's wait for its printer ends at this uptime (colour_ok, test_page_task), so the
// re-asks after a lost answer never run past one stall limit in all.
static uint32_t            s_job_deadline_ms;
// The upload was cut short (doc_end with ok 0): the job is ending, and its wait for the
// printer must stop now, as a cancel does.
static volatile int        s_job_dropped;
static uint32_t uptime_ms(void);
static void port_push(ps_state_t box);

static char s_suffix[8];            // the MAC's last two bytes, the default hostname's

// W-1079: what the page last saved, beside s_set's names in use since boot:
// a new name or hostname reaches mDNS and the Chooser only at a restart.
static char s_saved_model[SET_QUEUE_MAX], s_saved_name[SET_QUEUE_MAX], s_saved_host[SET_HOST_MAX];
// The DIP bank as last read, for the page (W-1079). Unknown until the first.
static dip_config_t s_dip;
static volatile int s_dip_known;

// W-1081: whether U7 runs TashTalk, for the AppleTalk Port card: asked at
// boot, whenever the node starts, and after a flash. Unknown until then.
typedef enum { LT_CHIP_UNKNOWN, LT_CHIP_OK, LT_CHIP_NONE, LT_CHIP_NO_TASHTALK,
               LT_CHIP_SILENT } lt_chip_t;
static volatile lt_chip_t s_lt_chip;

static const char *lt_chip_name(lt_chip_t c)
{
    switch (c) {
    case LT_CHIP_OK:          return "ok";
    case LT_CHIP_NONE:        return "no_chip";
    case LT_CHIP_NO_TASHTALK: return "no_tashtalk";
    case LT_CHIP_SILENT:      return "silent";
    default:                  return "unknown";
    }
}

// The page saved queue, hostname, dither or gain (W-1068): re-read them, and
// give the pipe and the test page the screen they now name. The hostname
// and queue still take a restart to reach mDNS, as they always have.
static void lt_port_apply(int on);
static void line_source(void);

static void general_saved(void *ctx)
{
    (void)ctx;
    settings_t fresh;
    if (settings_load(&fresh, s_suffix) != ESP_OK) return;
    // W-1088: the port printer's record holds its screen; the old Printer
    // pane's save reaches it here.
    if (strcmp(fresh.dither, s_set.dither) || fresh.gain != s_set.gain)
        printers_port_set_screen(fresh.dither, fresh.gain);
    strncpy(s_set.dither, fresh.dither, sizeof s_set.dither - 1);
    s_set.gain = fresh.gain;
    ht_algo_t algo;
    if (ht_algo_from_name(s_set.dither, &algo)) algo = HT_ATKINSON;
    job_pipe_set_screen(algo, s_set.gain);
    ESP_LOGI(TAG, "screen now %s, gain %u%%", s_set.dither, s_set.gain);
    if (fresh.top_margin != s_set.top_margin) {
        s_set.top_margin = fresh.top_margin;
        job_pipe_set_top_margin(s_set.top_margin);
        ESP_LOGI(TAG, "top margin now %d/144 in", s_set.top_margin);
    }
    // W-1079: the names wait for a restart; the switches act now.
    snprintf(s_saved_model, sizeof s_saved_model, "%s", fresh.model);
    snprintf(s_saved_name, sizeof s_saved_name, "%s", fresh.name);
    snprintf(s_saved_host, sizeof s_saved_host, "%s", fresh.hostname);
    if (fresh.airprint != s_set.airprint) {
        s_set.airprint = fresh.airprint;
        ipp_server_set_airprint(s_set.airprint);
        line_source();                       // W-1082: no ImageWriter, the LaserWriter's lights
    }
    if (fresh.lt_port >= 0 && fresh.lt_port != s_set.lt_port) {
        s_set.lt_port = fresh.lt_port;
        lt_port_apply(s_set.lt_port);
    }
    if (fresh.rainbow != s_set.rainbow) {
        s_set.rainbow = fresh.rainbow;
#if CONFIG_AIRWRITER_DIP7_PIN < 0
        led_grid_set_gamer(s_set.rainbow);  // on rev A, DIP 7 decides
#endif
    }
}

static const char *ribbon_name(uint8_t r)
{
    return r == IW_RIBBON_COLOUR ? "colour" : r == IW_RIBBON_BLACK ? "black" : "unknown";
}

// Asks the printer which ribbon is in. The caller holds s_job_lock, with
// nothing of a job sent yet. ESC ? needs the printer ready (a deselected one
// does not answer) and between commands (after a stream cut mid-graphics it
// would be taken as dots). Idle, a printer that is not ready, or one left
// mid-graphics, is left alone. For a job it must not be: a colour page on a
// ribbon swapped while the printer was off would print four passes in black.
// So a job waits for the line as its first write would, and sends the resync
// its first write would have sent. 1 when the printer answered as an ImageWriter.
// The job (or test page) whose printer is being waited for is ending: a cancel, the test
// page's second tap, or an upload cut short. Nothing waits on the printer past it.
static int job_stopping(void)
{
    return s_job_cancelled || s_test_cancel || s_job_dropped;
}

// W-1116: an ImageWriter job's (or test page's) plain question: has a StyleWriter taken the
// port? Its bytes are harmless to an ImageWriter (bench 2026-10-27). The link goes back to the
// ImageWriter's afterwards whatever record is on the port now (stylewriter_ask_plain puts it
// back to the port's record's, which may be a StyleWriter's while this job's record is an
// ImageWriter). One that answers is this job's answer (its gate aborts: the page was ripped
// for an ImageWriter) and is recorded, so it comes online.
static sw_model_t job_ask_plain(void)
{
    sw_model_t sw = stylewriter_ask_plain();
    stylewriter_link(0);
    if (sw != SW_NONE) {
        s_job_heard = PR_HEARD_STYLEWRITER;
        s_job_heard_model = pr_model_from_sw(sw);
        printers_port_seen_sw(sw);
    }
    return sw;
}

static int ribbon_ask(int for_job)
{
    if (AW_LOOPBACK) { s_iw_named = 1; return 0; }  // no printer to ask: the record reads Ready
    s_seen_again = -1;                  // no answer unless printers_port_seen is reached below
    // W-1088: ESC ? also finds what is on the port, so it goes to anything
    // but a printer the person said is something else.
    port_mode_t mode = printers_port_mode();
    // W-1116: on a Something else port only the person's own Look for Printers asks (the policy
    // sends PA_ESCQ for that alone); a job's or test page's never does.
    // ...and the repeat of what that look sighted once (the look is over by then, port_after
    // ends it; the same answer twice replaces the Something else record, R16).
    if (mode == PORT_UNKNOWN_SAID && (for_job || (!s_look_person && s_port_confirm != PA_ESCQ)))
        return 0;
    // W-1116: a job's or test page's ESC ? is its own record's, an ImageWriter by construction
    // (doc_begin and test_page_to took this path for one), whatever record is on the port now:
    // a StyleWriter that answered before and was unplugged must not keep the job from waiting
    // for its ImageWriter. It waits for the line to its deadline (s_job_deadline_ms: one stall
    // limit in all, the plain questions' time counted), and every 5 s with the line down asks
    // whether a StyleWriter took the quiet port; one answering ends the wait.
    //
    // Then its ESC ? waits the idle one's settle (W-1064) after a line-up: a II switched on
    // mid-wait does not answer its first ESC ? yet, and with an original ImageWriter record
    // listed its silence would be taken for the original's. The settle is the job's own: 2 s
    // from when this wait first saw the line up, since serial_out's line task and this loop poll
    // the same pin every 100 ms and either may see the edge first; and a line-up the line task
    // saw just before the job (s_ribbon_due still ahead) is waited out too. Never more than
    // 2.5 s, however stale s_ribbon_due is; a cancel or a cut upload ends it, and a line that
    // goes down again inside it is waited for anew.
    uint32_t plain_at = uptime_ms();
    int saw_down = 0;                   // this ask found the line down
    for (;;) {
        while (for_job && !serial_out_clear() && !job_stopping() &&
               (int32_t)(s_job_deadline_ms - uptime_ms()) > 0) {
            saw_down = 1;
            vTaskDelay(pdMS_TO_TICKS(100));
            if (uptime_ms() - plain_at >= 5000) {
                if (job_ask_plain() != SW_NONE) return 0;     // a StyleWriter: not one ImageWriter byte
                plain_at = uptime_ms();
            }
        }
        if (!serial_out_clear()) return 0;
        if (!for_job) break;
        if (job_stopping()) return 0;
        TickType_t t0 = xTaskGetTickCount();
        TickType_t hold = saw_down ? pdMS_TO_TICKS(2000) : 0;
        if (s_ribbon_want) {
            TickType_t left = s_ribbon_due - t0;
            if ((int32_t)left > 0 && left > hold) hold = left;
        }
        if (hold > pdMS_TO_TICKS(2500)) hold = pdMS_TO_TICKS(2500);
        while (!job_stopping() && xTaskGetTickCount() - t0 < hold)
            vTaskDelay(pdMS_TO_TICKS(100));
        if (job_stopping()) return 0;
        if (serial_out_clear()) break;
        if ((int32_t)(s_job_deadline_ms - uptime_ms()) <= 0) return 0;
        saw_down = 1;                   // down again inside the settle
    }
    // W-1116: a job's or test page's plain question goes before any ImageWriter byte -- the
    // resync, ESC ?, the CR -- whenever the line is up: a StyleWriter that raised its line and
    // heard ESC ? first would stop listening until a reset, and an original ImageWriter record
    // would then take its silence for its own line. One that answers is this job's answer and
    // nothing else is sent. The question is harmless to an ImageWriter (bench 2026-10-27).
    if (for_job && job_ask_plain() != SW_NONE) return 0;
    if (s_link.dirty) {
        if (!for_job) return 0;
        esp_err_t err = ESP_OK;
        iw_resync(resync_out, &err);
        if (err != ESP_OK) return 0;
        iw_link_resynced(&s_link);
        ESP_LOGW(TAG, "last job was cut short; resynced the printer before asking its ribbon");
    }
    static const uint8_t self_id[] = { 0x1B, '?' }, cr[] = { '\r' };
    uint8_t reply[16];
    serial_out_rx_drop();
    int n = serial_out_query(self_id, sizeof self_id, reply, sizeof reply, 500);
    // The printer acts on a command when it reaches the line holding it (the
    // note under Table 6-7), so if it said nothing, end the line. Idle, the
    // head is at the left margin and a CR moves nothing.
    if (n == 0) n = serial_out_query(cr, sizeof cr, reply, sizeof reply, 1000);
    if (n < 0) return 0;
    char hex[3 * sizeof reply + 1] = "";
    for (int i = 0; i < n; i++) snprintf(hex + 3 * i, 4, " %02x", reply[i]);
    iw_self_id_t id = iw_self_id(reply, (size_t)n);
    iw_ribbon_t r = id.ribbon;
    ESP_LOGI(TAG, "self-ID: %d byte%s%s, %s, %s ribbon", n, n == 1 ? "" : "s", hex,
             id.model == IW_MODEL_LQ ? "LQ" : id.model == IW_MODEL_II ? "II" : "no model",
             ribbon_name(r));
    s_seen_again = printers_port_seen(id.model, 1);
    int answered = id.model != IW_MODEL_NONE;
    // W-1116: what this job's own ESC ? got, for its gate. The line up with ESC ? and the plain
    // question (asked above) both unanswered is an original ImageWriter's answer when the list
    // has that record (the core named it: printers_port_seen gave its id): the job's answer is
    // then ImageWriter / original, so an original's job goes and a II's or LQ's ends as
    // another printer's. With no such record, silence is a lost answer, and the job re-asks.
    if (for_job) {
        if (answered) {
            s_job_heard = PR_HEARD_IMAGEWRITER;
            s_job_heard_model = id.model == IW_MODEL_LQ ? PR_MODEL_IWLQ : PR_MODEL_IW2;
        } else if (printers_record_model(s_seen_again) == PR_MODEL_IW1) {
            s_job_heard = PR_HEARD_IMAGEWRITER;
            s_job_heard_model = PR_MODEL_IW1;
        }
    }
    // The ImageWriter on the port named its model, or an original ImageWriter record answered
    // with its silent line (the core then makes it current): Ready may now show for it. A
    // first sighting (PR_SEEN_AGAIN), and silence on a port whose record is a II or LQ (a lost
    // answer: the core keeps the record and nothing is named), leave Ready waiting.
    if (s_seen_again > 0 && printers_port_is_imagewriter() &&
        (answered || printers_port_model() == PR_MODEL_IW1) && !s_iw_named) {
        s_iw_named = 1;
        line_source();                  // the panel follows the record's Ready (box_ready)
    }
    if (!printers_port_is_imagewriter() || r == IW_RIBBON_UNKNOWN || r == s_ribbon) return answered;
    ESP_LOGI(TAG, "ribbon now %s (was %s)", ribbon_name(r), ribbon_name(s_ribbon));
    s_ribbon = (uint8_t)r;
    settings_save_ribbon((uint8_t)r);
    port_push(printer_state_view().state);      // the colour it offers (W-1116: its own slot)
    return answered;
}

// ESC ? is the ImageWriter's, at 9600 with CTS (W-1103): a StyleWriter's link is given
// up for it and taken back, so a port whose record is a StyleWriter that has stopped
// answering can still be asked whether an ImageWriter has taken its place. Before a job's
// or the test page's ImageWriter bytes the link stays the ImageWriter's, whatever the record
// becomes meanwhile.
static int ribbon_check(int for_job)
{
    stylewriter_link(0);
    int answered = ribbon_ask(for_job);
    if (!for_job) stylewriter_link_record();
    return answered;
}

// W-1116: the wait of an ImageWriter job, or test page, for its own record's printer, before
// any page byte, on the task that holds s_job_lock. ribbon_check asks (the line, the plain
// question, then ESC ?) and pr_job_gate reads only what this job's own questions got (never
// the list's last answer), to one stall limit in all, the questions' time counted:
//   GO    its own model answered (an original ImageWriter: its line up with ESC ? and the plain
//         question unanswered): the page may go.
//   OTHER another model or a StyleWriter answered: the page was ripped for the model it was
//         sent to, and must not go.
//   WAIT  it stopped with nothing answered: a cancel, an upload cut short, or the deadline.
// Between asks it rests 500 ms: the line still down (ribbon_check waited to the deadline, or
// a flap), or a II or LQ record's model not named while its line is up (a lost ESC ?).
static pr_gate_t job_gate_wait(int id)
{
    if (AW_LOOPBACK) return PR_GATE_GO;     // the UART loopback build takes every job
    s_job_heard = PR_HEARD_NONE;
    s_job_heard_model = PR_MODEL_NONE;
    s_job_deadline_ms = uptime_ms() + CONFIG_AIRWRITER_STALL_ABORT * 1000u;
    for (;;) {
        if (job_stopping()) return PR_GATE_WAIT;
        ribbon_check(1);
        if (job_stopping()) return PR_GATE_WAIT;
        pr_gate_t g = printers_job_gate(id, s_job_heard, (pr_model_t)s_job_heard_model,
                                        serial_out_clear());
        if (g != PR_GATE_WAIT) return g;
        if ((int32_t)(s_job_deadline_ms - uptime_ms()) <= 0) return PR_GATE_WAIT;
        vTaskDelay(pdMS_TO_TICKS(500));
    }
}

// job_pipe asks as each job's rip starts, on the pipeline task, before any page byte, while
// the job holds s_job_lock. W-1116: the ImageWriter job's gate (job_gate_wait): on GO the rip
// runs, in the ribbon's colour; on OTHER the job aborts with the message the phone shows; on
// WAIT it aborts as a cancel, a cut upload, or a printer that never answered.
static int colour_offered(int kind, int model);

static int colour_ok(void *ctx)
{
    (void)ctx;
    pr_gate_t g = job_gate_wait(s_port_job_record);
    if (g == PR_GATE_GO)
        return s_ribbon == IW_RIBBON_COLOUR &&
               colour_offered(PR_KIND_IMAGEWRITER, printers_record_model(s_port_job_record));
    if (g == PR_GATE_OTHER) {
        ESP_LOGW(TAG, "job %d aborted: another printer was connected on the printer port",
                 (int)s_last_job_id);
        ipp_server_job_message_for(s_port_job_slot, "Another printer was connected. Print again.");
    } else if (!job_stopping()) {
        ESP_LOGW(TAG, "job %d aborted: its printer never answered", (int)s_last_job_id);
    }
    job_pipe_abort();                       // ends the job before any page byte
    return 0;
}

// HSKo edges from serial_out. printer_state turns a low line into "printer
// offline" (idle) or "needs attention" (mid-job) on its own clock. A printer
// that comes ready may have had its ribbon changed: ask it once it settles.
// Only after the line was down a second or more (power, SELECT, the lid) or
// at its first report: the printer's own busy blips are not a ribbon swap,
// and a check whose CR blipped the line must not schedule the next.

static void printer_line_changed(void *ctx, int ready)
{
    (void)ctx;
    TickType_t now = xTaskGetTickCount();
    if (!ready) {
        s_line_low_at = now;
    } else if (!s_line_seen || now - s_line_low_at >= pdMS_TO_TICKS(1000)) {
        s_ribbon_due  = now + pdMS_TO_TICKS(2000);
        s_ribbon_want = 1;
        s_ribbon_gen++;
        // A fresh line is not Ready until ESC ? names the model (W-1116). Not mid-job (a paper
        // reload drops the line), and not while the link is dirty after a job cut short (the
        // idle ESC ? waits for a job's resync, so the record it named is kept, ruling R17; the
        // plain question still runs).
        if (!s_printing && !s_link.dirty) s_iw_named = 0;
    }
    s_line_seen = 1;
    s_hsko = ready;                     // the port task's, for any record
    if (!ready) s_line_drops++;
    // W-1103: a StyleWriter's line says nothing; its answers are its state, and the
    // line only tells the port task when an ImageWriter may have taken its place.
    if (!port_line_speaks()) return;
    s_iw_ready = ready;
    printer_state_port_line(ready);     // the kick's, whatever line the panel follows
    // Mid-job the line toggles every printed line: this stays cheap.
    if (s_line_src == LINE_IW && s_printing) {
        printer_state_post(ready ? PS_EV_LINE_READY : PS_EV_LINE_NOT_READY);
        return;
    }
    if (s_line_src == LINE_IW) line_source();
    // Idle, the box may not change while the port does (W-1088): its printer's own state.
    if (!s_printing) port_push(printer_state_view().state);
}

// W-1088: the box's line while idle. Ready while the printer on the port is, if its record
// is shared (an ImageWriter once ESC ? named it), or any shared LaserWriter is; with nothing
// shared, the port's line, as before. Unknown (-1) until the port's
// ImageWriter, when shared, has reported, so the quiet power-on's boot wave waits.
static int box_ready(void)
{
    int iw = printers_port_shared(), lw = laser_ready();   // lw < 0: none shared
    if (!iw && lw < 0) return s_iw_ready;
    // W-1116: an ImageWriter record is ready once ESC ? has named it, as port_live reads it,
    // so the panel does not read Ready before the record does.
    int iw_up = s_iw_ready == 1 && (!port_line_speaks() || s_iw_named);
    if ((iw && iw_up) || lw == 1) return 1;
    if (iw && s_iw_ready < 0) return -1;
    return 0;
}

// W-1082: the line the panel follows, chosen again whenever a job starts or
// ends, the printer list changes, or a LaserWriter's readiness changes. Its
// state is posted at once (the panel takes a repeat as nothing new); before a
// LaserWriter has answered there is none, so the quiet power-on's boot wave waits
// for it, to its 30 s cap.
static void line_source(void)
{
    int src = s_laser_owns || (!printers_port_shared() && laser_shared()) ? LINE_LASER : LINE_IW;
    s_line_src = src;
    int ready = src == LINE_LASER ? laser_ready() : s_printing ? s_iw_ready : box_ready();
    if (ready >= 0) printer_state_post(ready ? PS_EV_LINE_READY : PS_EV_LINE_NOT_READY);
}

// Both AirPrint sinks' claim: a job never waits out a Mac's job, the test page
// or an update with its document unread (ipp_server.h). Its client is told
// busy and asks again, as a Mac on AppleTalk is.
static int doc_claim(void *ctx)
{
    (void)ctx;
    if (xSemaphoreTake(s_job_lock, 0) == pdTRUE) return 1;
    s_job_waiting = 1;                  // an update in progress gives way (W-1048)
    return 0;
}

// The port sink's claim (W-1116). A job for a port record whose printer is not the one on the
// port -- another port record's printer is -- is answered busy at once, nothing held, as SPEC
// 3.4 does when a job finds the printer taken: the phone keeps the job and asks again, and it
// prints once the person swaps the cable. s_job_waiting is not set: this is not an update
// giving way, and the board holds nothing, so the printer that is there keeps printing. Else
// the job takes the lock as any AirPrint job does.
static int port_claim(void *ctx)
{
    int id = (int)((intptr_t)ctx & 0xFF);
    if (printers_port_absent(id)) return 0;
    return doc_claim(ctx);
}

static esp_err_t sw_doc_begin(const char *format, const char *name, const ipp_job_opts_t *opts);
static esp_err_t qd_doc_begin(const char *format, const char *name, const ipp_job_opts_t *opts);
static void port_fam_sync(pr_family_t fam, int locked);

static esp_err_t doc_begin(void *ctx, const char *format, const char *name,
                           const ipp_job_opts_t *opts)
{
    // W-1116: whose job, by its slot and record id (printers.c's slot_ctx): the end goes back
    // to the slot, and the record is the job's own family and the ImageWriter gate's.
    s_port_job_slot = (int)((intptr_t)ctx >> 8);
    s_port_job_record = (int)((intptr_t)ctx & 0xFF);
    s_job_dropped = 0;
    // doc_claim took s_job_lock. ipp_server always pairs this call with
    // exactly one doc_end -- including when job_pipe_begin below fails -- and
    // every doc_end leads to exactly one job_finished, whose give balances
    // the claim.
    // W-1116: whose job this is follows its own record (the one the phone picked), not the
    // printer on the port: port_claim already answered busy if another port record's printer
    // is there, so here the record is the one on the port or the port is quiet. An ImageWriter
    // job on a quiet port sends no page byte until its model answers (colour_ok's gate).
    port_fam_sync(printers_record_family(s_port_job_record), 1);
    s_ipp_owns = 1;
    switch (s_port_fam) {
    case PR_FAM_STYLEWRITER:            // W-1103: the same sink, its own job
        return sw_doc_begin(format, name, opts);
    case PR_FAM_QDLASER:                // W-1102: the same again
        return qd_doc_begin(format, name, opts);
    default:                            // an ImageWriter's, below
        break;
    }
    stylewriter_link(0);                // the ImageWriter's link, whatever the last job's was
    // W-1116: the rip's screen and gain are this job's own record's (the pipe's otherwise
    // follow the printer on the port, port_screen_follow), set under the job lock before the
    // pipeline starts; every rip path sets its own, so nothing reads a stale one.
    {
        char d[sizeof s_set.dither];
        int g;
        ht_algo_t algo;
        if (!printers_record_screen(s_port_job_record, d, sizeof d, &g)) {
            if (ht_algo_from_name(d, &algo)) algo = HT_ATKINSON;
            job_pipe_set_screen(algo, g);
        }
    }
    // The link's strength with each job: a weak one is what a slow upload
    // usually is (W-1042 bench).
    wifi_ap_record_t ap;
    int rssi = esp_wifi_sta_get_ap_info(&ap) == ESP_OK ? ap.rssi : 0;
    s_last_job_id = opts ? opts->job_id : 0;
    ESP_LOGI(TAG, "job %d format %s, rssi %d", (int)s_last_job_id,
             format[0] ? format : "(unspecified)", rssi);
    memdiag_mark("job start");          // W-1094
    s_job_error[0] = '\0';
    strncpy(s_last_job, name && name[0] ? name : "Untitled", sizeof s_last_job - 1);
    s_last_job[sizeof s_last_job - 1] = '\0';
    s_stream_crc = 0;
    s_printer_failed = 0;
    s_job_cancelled = 0;
    serial_out_set_abort(0);
    iw_link_job_start(&s_link);
    s_printing = 1;
    job_touch();
    led_grid_set_source(LG_SRC_AIRPRINT);
    line_source();                  // the port's own line, not the box's
    printer_state_post(PS_EV_JOB_START);
    serial_out_loopback_reset();
    esp_err_t err = job_pipe_begin(name);
    s_job_pipe_ok = (err == ESP_OK);
    return err;
}

static esp_err_t doc_data(void *ctx, const uint8_t *buf, size_t n)
{
    (void)ctx;
    return job_pipe_data(buf, n);
}

static void doc_cancel(void *ctx)
{
    (void)ctx;
    if (!s_ipp_owns) return;
    s_job_cancelled = 1;
    if (s_job_fam == PR_FAM_STYLEWRITER) stylewriter_cancel();     // its session stops at its next step
    else if (s_job_fam == PR_FAM_QDLASER) qdlaser_cancel();         // W-1102: the same
    else serial_out_set_abort(1);    // a paused printer must not hold the job hostage
    job_pipe_abort();
}

// The job is over: ripped and written, or abandoned. Runs on the pipeline
// task once it has finished with the document (or on the IPP worker, if the
// pipeline never started), and is what ends the job everywhere -- the panel,
// the job lock, and the IPP job record with the printer it holds.
static void job_finished(const job_pipe_stats_t *st, int ok)
{
    s_printing = 0;
    job_touch();
    memdiag_mark("job done");           // W-1094: the low since its start

    // Clean only if the rip finished every page and every byte was queued;
    // anything else may have stopped mid-strip.
    int clean = st->rc == 0 && ok && !s_printer_failed;

    if (!clean) {
        iw_link_job_end(&s_link, 0);
        // The rip may have stopped between writes, leaving up to a FIFO of
        // the dead job queued behind a paused printer. The printer task has
        // stopped writing, or no write ever ran.
        serial_out_purge();
        if (s_job_cancelled) {
            ESP_LOGI(TAG, "job canceled after %u bytes in", (unsigned)st->doc_bytes);
            printer_state_post(PS_EV_JOB_CANCELLED);
        } else {
            ESP_LOGE(TAG, "job failed: %u bytes in, rc %d%s",
                     (unsigned)st->doc_bytes, st->rc,
                     s_printer_failed ? ", printer timeout"
                                      : ok ? "" : ", transfer truncated");
            printer_state_post(PS_EV_JOB_FAILED);
        }
        s_ipp_owns = 0;
        xSemaphoreGive(s_job_lock);
        ipp_server_job_done_for(s_port_job_slot, 0);
        return;
    }

    s_last_pages = (size_t)st->pages;
    s_last_bytes = st->printer_bytes;
    ESP_LOGI(TAG, "ripped %d page%s, %ux%u dots, %u bytes in -> %u printer bytes in %ums, "
             "all out in %ums", st->pages, st->pages == 1 ? "" : "s", (unsigned)st->dst_w,
             (unsigned)st->dst_h, (unsigned)st->doc_bytes, (unsigned)st->printer_bytes,
             (unsigned)st->rip_ms, (unsigned)st->ms);
    ESP_LOGI(TAG, "printer stream crc32 %08x", (unsigned)s_stream_crc);

    // Let the last byte clear the shift register before calling it printed.
    // Paper running out on the last sheet is still this job's stall, so the
    // flush waits as long as a paused job does, and Done comes after it. A
    // cancel stops the wait, and the tail must not print ahead of the next job.
    esp_err_t flushed = serial_out_flush(CONFIG_AIRWRITER_STALL_ABORT * 1000u);
    // A purged tail is a cut stream too, so the link is settled only here.
    iw_link_job_end(&s_link, flushed == ESP_OK);
    if (flushed != ESP_OK) {
        serial_out_purge();
        if (s_job_cancelled) {
            ESP_LOGI(TAG, "job canceled with its last bytes still queued");
            printer_state_post(PS_EV_JOB_CANCELLED);
        } else {
            ESP_LOGE(TAG, "job failed: the printer never took its last bytes");
            printer_state_post(PS_EV_JOB_FAILED);
        }
        s_ipp_owns = 0;
        xSemaphoreGive(s_job_lock);
        ipp_server_job_done_for(s_port_job_slot, 0);
        return;
    }
    printer_state_post(PS_EV_JOB_DONE);

    if (AW_LOOPBACK) {
        size_t got; uint32_t crc;
        serial_out_loopback_wait(st->printer_bytes, 3000);
        serial_out_loopback_stats(&got, &crc);
        if (got == st->printer_bytes && crc == s_stream_crc)
            ESP_LOGI(TAG, "uart loopback: %u bytes returned intact, crc32 %08x",
                     (unsigned)got, (unsigned)crc);
        else
            ESP_LOGE(TAG, "uart loopback MISMATCH: sent %u/%08x, got %u/%08x",
                     (unsigned)st->printer_bytes, (unsigned)s_stream_crc,
                     (unsigned)got, (unsigned)crc);
    }

    // At 9600 baud, 8N1, one byte costs 10 bit times.
    ESP_LOGI(TAG, "that is %u seconds of printing at 9600 baud",
             (unsigned)(st->printer_bytes * 10 / 9600));

    ota_health_printed();       // W-1059: this firmware prints; under the job lock
    s_ipp_owns = 0;
    // W-1141: every page printed. Under the job lock, as each finisher's is, so the slot is
    // still this job's.
    ipp_server_job_pages_for(s_port_job_slot, st->pages);
    xSemaphoreGive(s_job_lock);
    ipp_server_job_done_for(s_port_job_slot, 1);
}

static void laser_finished(const job_pipe_stats_t *st, int ok);
static void sw_finished(const job_pipe_stats_t *st, int ok);
static void qd_finished(const job_pipe_stats_t *st, int ok);

// job_pipe's page_out (W-1141): a page's last byte has gone to the printer, so the phone's
// "Printing 1 of 5" moves on. On the printer task for an ImageWriter's or a StyleWriter's
// job; on the pipeline task for a LaserWriter's, and for a Personal LaserWriter 300's once its
// session has printed the page. Whose job it is was set at its begin, under the job lock, and
// holds until its finish.
static void pipe_page_out(void *ctx, int pages)
{
    (void)ctx;
    if (s_laser_owns) {
        // After a PostScript error the printer throws the rest of the job away.
        if (!laser_job_ps_error()) ipp_server_job_pages_for(s_laser_slot, pages);
    } else if (s_ipp_owns) {
        // A 300's page too big for its memory was skipped: no sheet came out for it.
        if (s_job_fam == PR_FAM_QDLASER) pages -= s_qd_skipped;
        ipp_server_job_pages_for(s_port_job_slot, pages);
    }
}

// job_pipe's done callback: the pipeline has printed the document or let it go.
static void pipe_done(void *ctx, const job_pipe_stats_t *st)
{
    (void)ctx;
    if (s_job_fam == PR_FAM_STYLEWRITER) {
        sw_finished(st, s_doc_ok);
    } else if (s_job_fam == PR_FAM_QDLASER) {
        qd_finished(st, s_doc_ok);
    } else if (s_laser_owns) {
        laser_finished(st, s_doc_ok);
    } else {
        job_finished(st, s_doc_ok);
        printers_apply();           // W-1088: a change to the port's printer waited for it
        line_source();              // idle: the box's line
    }
}

// The upload is over; the printing usually is not. Returns at once so the
// client gets its answer while the pipeline prints from the job buffer, and
// pipe_done finishes the job when the paper stops.
static void doc_end(void *ctx, int ok)
{
    (void)ctx;
    s_doc_ok = ok;
    if (!ok) s_job_dropped = 1;         // W-1116: a wait for the printer stops now (colour_ok)
    // A cut transfer (a client that cancels by dropping the upload rather
    // than with Cancel-Job) means nothing more will arrive: stop a write
    // that is waiting out a paused printer, so the pipeline unwinds now
    // instead of after the stall limit. A StyleWriter's session stops at its next step.
    if (!ok) {
        if (s_job_fam == PR_FAM_STYLEWRITER) stylewriter_cancel();
        else if (s_job_fam == PR_FAM_QDLASER) qdlaser_cancel();
        else serial_out_set_abort(1);
    }
    if (s_job_pipe_ok) {
        job_pipe_end(ok);
        return;
    }
    if (s_job_fam == PR_FAM_STYLEWRITER) {                    // the pipeline never started: finish here
        job_pipe_stats_t none = {0};
        sw_finished(&none, 0);
        return;
    }
    if (s_job_fam == PR_FAM_QDLASER) {                        // W-1102: the same
        job_pipe_stats_t none = {0};
        qd_finished(&none, 0);
        return;
    }
    // A failed job_pipe_begin never created the pipeline task, so nothing
    // will call pipe_done: finish here, with zeroed stats. ipp_server still
    // calls doc_end exactly once after a failed begin, so the give in
    // job_finished balances doc_begin's take.
    job_pipe_stats_t st = {0};
    job_finished(&st, 0);
    printers_apply();
    line_source();
}

// ------------------------------------------------------------ LaserWriter jobs
// W-1082: a shared LaserWriter on AppleTalk, AirPrint printer 1-6 (W-1088, W-1116). Its
// job takes the same job lock as the ImageWriter's (one job buffer, one rip),
// rips at 300 dpi into laser.c's PostScript and PAP client, and is a job like
// any other to the panel and to Macs on AppleTalk (told busy). The rip runs
// through job_pipe as the ImageWriter's does; laser_job_end waits for the
// printer. The sink's ctx is (slot << 8 | record id), the printer list's.

static int s_laser_pipe_ok;

static esp_err_t laser_doc_begin(void *ctx, const char *format, const char *name,
                                 const ipp_job_opts_t *opts)
{
    (void)opts;
    int id = (int)((intptr_t)ctx & 0xFF);
    s_laser_owns = 1;                   // doc_claim took s_job_lock
    memdiag_mark("job start");          // W-1094
    s_laser_slot = (int)((intptr_t)ctx >> 8);
    s_last_job_id = opts ? opts->job_id : 0;
    ESP_LOGI(TAG, "LaserWriter job %d for printer %d format %s", (int)s_last_job_id, id,
             format[0] ? format : "(unspecified)");
    s_job_error[0] = '\0';
    strncpy(s_last_job, name && name[0] ? name : "Untitled", sizeof s_last_job - 1);
    s_last_job[sizeof s_last_job - 1] = '\0';
    s_job_cancelled = 0;
    s_printing = 1;
    job_touch();
    led_grid_set_source(LG_SRC_AIRPRINT);
    line_source();
    printer_state_post(PS_EV_JOB_START);
    job_pipe_target_t t = { 0 };
    s_laser_pipe_ok = 0;
    if (laser_job_begin(id, name, &t)) return ESP_FAIL;
    esp_err_t err = job_pipe_begin_to(name, &t);
    s_laser_pipe_ok = err == ESP_OK;
    return err;
}

static void laser_doc_cancel(void *ctx)
{
    (void)ctx;
    if (!s_laser_owns) return;
    s_job_cancelled = 1;
    laser_job_cancel();
    job_pipe_abort();
}

// The rip is over; the printer usually is not. On the pipeline task (or the
// IPP worker, when the pipeline never started), as job_finished.
static void laser_finished(const job_pipe_stats_t *st, int ok)
{
    int printed = laser_job_end(st->rc == 0 && ok && !s_job_cancelled);
    s_printing = 0;
    job_touch();
    memdiag_mark("job done");           // W-1094
    s_last_pages = (size_t)st->pages;
    s_last_bytes = 0;
    printer_state_post(printed ? PS_EV_JOB_DONE : s_job_cancelled ? PS_EV_JOB_CANCELLED
                                                                  : PS_EV_JOB_FAILED);
    s_laser_owns = 0;
    line_source();
    if (printed) ipp_server_job_pages_for(s_laser_slot, st->pages);   // W-1141
    xSemaphoreGive(s_job_lock);
    ipp_server_job_done_for(s_laser_slot, printed);
    printers_apply();               // W-1088: a change to its slot waited for it
}

static void laser_doc_end(void *ctx, int ok)
{
    (void)ctx;
    s_doc_ok = ok;
    if (!ok) laser_job_cancel();
    if (s_laser_pipe_ok) {
        job_pipe_end(ok);
        return;
    }
    job_pipe_stats_t st = {0};
    laser_finished(&st, 0);
}

// laser.c's view changed: the panel's line may follow it.
static void laser_changed(void)
{
    line_source();
}

// laser.c heard a printer, or its query ended: the printer list's.
static void laser_found(int link, const uint8_t *name, const uint8_t *type)
{
    printers_at_seen(link, name, type);
}

static void laser_queried(int id, int ok, const lw_info_t *info, const laser_at_t *at)
{
    printers_at_queried(id, ok, info, at ? at->link : -1, at ? at->net : 0, at ? at->node : 0,
                        at ? at->pages : -1);
}

// W-1088: a Mac's job relayed to a printer on another AppleTalk link holds the
// job lock as any job does, never waiting (the Mac hears busy and asks again),
// and shows on the panel in the Mac's stripes.
static int laser_relay(int take)
{
    if (take) {
        if (xSemaphoreTake(s_job_lock, 0) != pdTRUE) {
            s_job_waiting = 1;
            return -1;
        }
        s_job_error[0] = '\0';
    strncpy(s_last_job, "Relayed job", sizeof s_last_job - 1);
        s_printing = 1;
        s_laser_owns = 1;
        job_touch();
        led_grid_set_source(LG_SRC_LOCALTALK);
        line_source();
        printer_state_post(PS_EV_JOB_START);
        return 0;
    }
    printer_state_post(PS_EV_JOB_DONE);
    s_printing = 0;
    s_laser_owns = 0;
    job_touch();
    line_source();
    xSemaphoreGive(s_job_lock);
    return 0;
}

// ------------------------------------------------------------ StyleWriter jobs
// W-1103: the port's printer is a StyleWriter. Its job takes the same sink, job lock and
// pipeline as the ImageWriter's, rips at 360 dpi into sw_page's frames and goes out through
// a session (stylewriter.c) on the printer task: the printer is reset and its cartridge
// read as the rip begins, then each frame is sent as the printer's buffer has room.

static esp_err_t sw_doc_begin(const char *format, const char *name, const ipp_job_opts_t *opts)
{
    s_job_fam = PR_FAM_STYLEWRITER;     // doc_claim took s_job_lock; sw_finished gives it
    s_sw_job_silent = 0;                // a new session: what it finds is the state
    s_sw_was_answering = s_port_answering;
    // W-1116: the job's own record's model and screen (the one the phone picked), not the
    // printer on the port's: port_claim let it through, so that record is the one on the port
    // or the port is quiet, and the session's own `?` must name this model before any page byte.
    sw_model_t m = pr_model_to_sw(printers_record_model(s_port_job_record));
    s_last_job_id = opts ? opts->job_id : 0;
    ESP_LOGI(TAG, "StyleWriter job %d format %s, quality %d", (int)s_last_job_id,
             format[0] ? format : "(unspecified)", opts ? opts->quality : 0);
    memdiag_mark("job start");          // W-1094
    s_job_error[0] = '\0';
    strncpy(s_last_job, name && name[0] ? name : "Untitled", sizeof s_last_job - 1);
    s_last_job[sizeof s_last_job - 1] = '\0';
    s_printer_failed = 0;
    s_job_cancelled = 0;
    s_printing = 1;
    job_touch();
    led_grid_set_source(LG_SRC_AIRPRINT);
    line_source();
    printer_state_post(PS_EV_JOB_START);
    // The job's record's screen, with Apple's tone curve under it (stylewriter.c).
    char screen[sizeof s_set.dither];
    int gain = 0;
    ht_algo_t algo = HT_ATKINSON;
    if (!printers_record_screen(s_port_job_record, screen, sizeof screen, &gain) &&
        ht_algo_from_name(screen, &algo))
        algo = HT_ATKINSON;
    job_pipe_target_t t = { 0 };
    s_job_pipe_ok = 0;
    if (stylewriter_job_begin(m, opts ? opts->quality : 0, algo, gain, &t)) return ESP_FAIL;
    esp_err_t err = job_pipe_begin_to(name, &t);
    s_job_pipe_ok = err == ESP_OK;
    return err;
}

// The rip is over and the printer task has sent its last frame, or the job was abandoned. On
// the pipeline task (or the IPP worker, when the pipeline never started): the last page is
// waited out and the printer told it is the end, or told to stop.
static void sw_finished(const job_pipe_stats_t *st, int ok)
{
    int cancelled = s_job_cancelled;
    int rc = stylewriter_job_end(!(st->rc == 0 && ok && !cancelled));
    int printed = rc == 0;
    s_printing = 0;
    job_touch();
    memdiag_mark("job done");           // W-1094
    s_last_pages = (size_t)st->pages;
    s_last_bytes = st->printer_bytes;
    s_sw_was_answering = 0;
    if (printed) {
        printers_port_answered(PR_HEARD_STYLEWRITER);   // its `?` named the record's model
        ESP_LOGI(TAG, "StyleWriter job: %d page%s, %u bytes in -> %u printer bytes in %ums, "
                 "all out in %ums", st->pages, st->pages == 1 ? "" : "s", (unsigned)st->doc_bytes,
                 (unsigned)st->printer_bytes, (unsigned)st->rip_ms, (unsigned)st->ms);
        ota_health_printed();           // W-1059: this firmware prints; under the job lock
    } else {
        ESP_LOGE(TAG, "StyleWriter job %s: %u bytes in, rc %d, printer %d%s",
                 cancelled ? "canceled" : "failed", (unsigned)st->doc_bytes, st->rc, rc,
                 ok ? "" : ", transfer truncated");
    }
    printer_state_post(printed ? PS_EV_JOB_DONE : cancelled ? PS_EV_JOB_CANCELLED
                                                            : PS_EV_JOB_FAILED);
    // A job that stopped short reset the printer, which takes 2 s to settle: the port task's
    // next `1` and `2` are due in 10 s, not now, or a printer still starting reads as gone.
    s_last_status_ms = uptime_ms();
    s_job_fam = PR_FAM_NONE;
    s_ipp_owns = 0;
    line_source();
    if (printed) ipp_server_job_pages_for(s_port_job_slot, st->pages);   // W-1141
    xSemaphoreGive(s_job_lock);
    ipp_server_job_done_for(s_port_job_slot, printed);
    printers_apply();                   // W-1088: a change to the port's printer waited for it
}

// ------------------------------------------------- Personal LaserWriter 300 jobs
// W-1102: the port's printer is a Personal LaserWriter 300. Its job takes the same sink, job
// lock and pipeline again, rips at 300 dpi into qd_page's rows and runs its session on the rip
// task (qdlaser.c): the link opens and the printer is asked who it is as the rip begins, each
// page is loaded as the rip makes it, while the page before it prints (W-1144), and a page too
// big for the printer's memory in the record's screen goes in Apple's.

static esp_err_t qd_doc_begin(const char *format, const char *name, const ipp_job_opts_t *opts)
{
    s_job_fam = PR_FAM_QDLASER;         // doc_claim took s_job_lock; qd_finished gives it
    s_qd_bad_page = 0;
    s_qd_skipped = 0;
    qd_model_t m = pr_model_to_qd(printers_record_model(s_port_job_record));
    int manual = opts ? opts->manual : 0;
    s_last_job_id = opts ? opts->job_id : 0;
    ESP_LOGI(TAG, "LaserWriter 300 job %d format %s, source %s", (int)s_last_job_id,
             format[0] ? format : "(unspecified)", manual ? "manual" : "cassette");
    memdiag_mark("job start");          // W-1094
    s_job_error[0] = '\0';
    strncpy(s_last_job, name && name[0] ? name : "Untitled", sizeof s_last_job - 1);
    s_last_job[sizeof s_last_job - 1] = '\0';
    s_printer_failed = 0;
    s_job_cancelled = 0;
    s_printing = 1;
    job_touch();
    led_grid_set_source(LG_SRC_AIRPRINT);
    line_source();
    printer_state_post(PS_EV_JOB_START);
    char screen[sizeof s_set.dither];
    int gain = 0;
    ht_algo_t algo = HT_ATKINSON;
    if (!printers_record_screen(s_port_job_record, screen, sizeof screen, &gain) &&
        ht_algo_from_name(screen, &algo))
        algo = HT_ATKINSON;
    job_pipe_target_t t = { 0 };
    s_job_pipe_ok = 0;
    qd_link_stats(NULL, 1);
    if (qdlaser_job_begin(m, algo, gain, manual, &t)) return ESP_FAIL;
    esp_err_t err = job_pipe_begin_to(name, &t);
    s_job_pipe_ok = err == ESP_OK;
    return err;
}

// A page was settled, on the rip task: the screen it went in, or too big for the printer's memory.
static void qd_page_cb(int page, int apple, uint32_t bytes, int too_big)
{
    if (too_big) {
        ESP_LOGW(TAG, "page %d: didn't fit in the printer's memory", page + 1);
        if (!s_qd_bad_page) s_qd_bad_page = page + 1;
        s_qd_skipped++;                 // before its page_done, on the same task
    } else {
        ESP_LOGI(TAG, "page %d: %s screen, %u bytes of codes", page + 1,
                 apple ? "Apple's" : "the record's", (unsigned)bytes);
    }
}

// The rip is over and every page that was going to print is loaded, the last still printing,
// or the job was abandoned. On the rip task (or the IPP worker, when the pipeline never started).
static void qd_finished(const job_pipe_stats_t *st, int ok)
{
    int cancelled = s_job_cancelled;
    // W-1144: the last page is still printing as the rip ends; the job's end waits for its done.
    int64_t t_end = esp_timer_get_time();
    int rc = qdlaser_job_end(!(st->rc == 0 && ok && !cancelled));
    uint32_t end_ms = (uint32_t)((esp_timer_get_time() - t_end) / 1000);
    int printed = rc == QD_OK;
    s_printing = 0;
    job_touch();
    memdiag_mark("job done");           // W-1094
    s_last_pages = (size_t)st->pages;
    s_last_bytes = st->printer_bytes;
    if (s_qd_bad_page) {
        // The job went on past it, and ends as failed with the page named, on the phone and
        // the settings page alike.
        snprintf(s_job_error, sizeof s_job_error, "Page %d didn’t fit in the printer’s memory.",
                 s_qd_bad_page);
        ipp_server_job_message_for(s_port_job_slot, s_job_error);
    }
    if (printed) {
        printers_port_answered(PR_HEARD_QDLASER);   // its 83 3E named the record's model
        ESP_LOGI(TAG, "LaserWriter 300 job: %d page%s, %u bytes in, all out in %u s",
                 st->pages, st->pages == 1 ? "" : "s", (unsigned)st->doc_bytes,
                 (unsigned)((st->ms + end_ms) / 1000));
        ota_health_printed();           // W-1059: this firmware prints; under the job lock
    } else {
        ESP_LOGE(TAG, "LaserWriter 300 job %s: %d page%s, %u bytes in, rc %d, printer %d%s",
                 cancelled ? "canceled" : "failed", st->pages, st->pages == 1 ? "" : "s",
                 (unsigned)st->doc_bytes, st->rc, rc, ok ? "" : ", transfer truncated");
    }
    qd_link_stats_t ls;
    qd_link_stats(&ls, 0);
    ESP_LOGI(TAG, "LaserWriter 300 link: %u chunks, %u bits, %u bad, %u stalls, %u unchecked, "
             "ends at most %d us late; last failure %u, %u of %u bits in %d us, due %d us",
             (unsigned)ls.chunks, (unsigned)ls.bits, (unsigned)ls.bad_bits, (unsigned)ls.stalls,
             (unsigned)ls.unchecked, (int)ls.worst_end_us, (unsigned)ls.fail_why,
             (unsigned)ls.fail_got, (unsigned)ls.fail_want, (int)ls.fail_took_us, (int)ls.fail_due_us);
    printer_state_post(printed ? PS_EV_JOB_DONE : cancelled ? PS_EV_JOB_CANCELLED
                                                            : PS_EV_JOB_FAILED);
    s_last_qd_ms = uptime_ms();         // its status was just in the job: the next in 3 s
    s_job_fam = PR_FAM_NONE;
    s_ipp_owns = 0;
    line_source();
    if (printed) ipp_server_job_pages_for(s_port_job_slot, st->pages - s_qd_skipped);   // W-1141
    xSemaphoreGive(s_job_lock);
    ipp_server_job_done_for(s_port_job_slot, printed);
    printers_apply();                   // a change to the port's printer waited for it
}

// ------------------------------------------------------------- printers
// W-1088: the printer list (components/printers) keeps what is where; these
// are its board's side of the port printer.

static void port_live(pr_live_t *o)
{
    ps_view_t v = printer_state_view();
    int mine = s_line_src == LINE_IW;
    // W-1116: an ImageWriter is present and ready only once ESC ? has named its model since the
    // line came up, so the page never shows the wrong ImageWriter while the line is up but the
    // self-ID has not come back yet (about 2-3 s).
    o->present = o->ready = s_iw_ready == 1 && s_iw_named;
    o->printing = s_printing && !s_laser_owns;
    o->cleaning = o->printing && s_cleaning;
    o->attention = mine && v.state == PS_ATTENTION;
    o->failed = mine && v.state == PS_FAILED;
    if (s_port_fam == PR_FAM_STYLEWRITER) {
        // W-1103: its own answers. A fault it reports is attention whether or not a job is
        // printing, and the page names it; present means it answered, or is the original
        // StyleWriter reading as ready while it is silent (sw_idle_silent), and ready that it
        // could print now.
        sw_state_t st = s_sw_state;
        o->present = s_port_answering || s_iw_ready == 1;
        o->ready = o->present && sw_state_ready(st);
        o->attention = s_port_answering && sw_state_fault(st);
        o->fault = o->attention ? (uint8_t)pr_fault_from_sw(st) : 0;
        o->cart = (uint8_t)s_sw_cart;
    } else if (s_port_fam == PR_FAM_QDLASER) {
        // W-1102: its own answers too. Present means it answered its last question, which
        // only a clock on HSKi lets it be asked.
        qd_state_t st = s_qd_state;
        o->present = s_port_answering;
        o->ready = o->present && qd_state_ready(st);
        o->attention = o->present && qd_state_fault(st);
        o->fault = o->attention ? (uint8_t)pr_fault_from_qd(st) : 0;
    }
}

// The page changed the port printer's halftone: the next job prints with it.
static void port_screen(const char *dither, int gain)
{
    settings_save_general(NULL, NULL, dither, gain);
    snprintf(s_set.dither, sizeof s_set.dither, "%s", dither);
    s_set.gain = (uint8_t)gain;
    ht_algo_t algo;
    if (ht_algo_from_name(s_set.dither, &algo)) algo = HT_ATKINSON;
    job_pipe_set_screen(algo, s_set.gain);
    ESP_LOGI(TAG, "the port printer's screen now %s, gain %u%%", s_set.dither, s_set.gain);
}

// ------------------------------------------------------- a StyleWriter on the port
// W-1103: the port task (kick_task) asks it, a job reports through its session, and these
// turn what it says into the box's state, the panel's line and what the phone is told.

// The screen ImageWriter jobs and the test page print with follows the record on the port
// (W-1116): another ImageWriter record (the LQ for the II), or one changed back from a
// StyleWriter (no Apple screen), each with its own halftone and gain. Under the job lock: a
// job's rip keeps the screen it started with.
static void port_screen_follow(void)
{
    char d[sizeof s_set.dither];
    int g;
    if (!printers_port_screen(d, sizeof d, &g) && (strcmp(d, s_set.dither) || g != s_set.gain))
        port_screen(d, g);
}

// The port's record became a StyleWriter, or stopped being one: whose answers are the
// port's state changes hands. Only with no job on the port, which reads the family it began
// with (its panel, IPP state and cartridge): `locked` when the caller holds the job lock, else
// it is taken without waiting, and a flip that finds it held is the port task's to make once
// the job is over.
static void port_fam_sync(pr_family_t fam, int locked)
{
    fam = port_fam_norm(fam);
    if (fam == s_port_fam) return;
    if (!locked && xSemaphoreTake(s_job_lock, 0) != pdTRUE) return;
    s_port_fam = fam;
    s_port_answering = 0;
    s_sw_cart = 0;
    s_sw_job_silent = 0;
    s_sw_asleep = 0;
    s_link_check = 1;                   // J2's link follows the record, under the job lock
    // The printer now on the record is asked what it has in, its ribbon or its cartridge, so
    // AirPrint offers colour for it and not for the last one (a look: ESC ? with the line up
    // for an ImageWriter, the plain question first for a StyleWriter). The port task's own
    // flip is answered by the act that made it, so it is not a look asked during that act.
    if (xTaskGetCurrentTaskHandle() == s_kick_handle) s_look = 1;
    else look_ask();
    if (fam == PR_FAM_STYLEWRITER) {
        s_iw_ready = -1;                // its answers will say; HSKo says nothing
        s_iw_named = 0;                 // an ImageWriter's name is not this record's
        s_sw_state = SWS_OFFLINE;
        s_last_plain_ms = port_plain_due(uptime_ms());
    } else if (fam == PR_FAM_QDLASER) {
        s_iw_ready = -1;                // W-1102: its answers will say; HSKi is its clock
        s_iw_named = 0;
        s_qd_state = QDS_OFFLINE;
    } else {
        s_iw_ready = s_hsko;            // the line speaks again
        if (s_hsko >= 0) printer_state_port_line(s_hsko);
        port_screen_follow();
    }
    // The panel and the phone follow the record that is the port's now, in this call: the
    // caller may be the port task holding the job lock, which printers_changed's own sync
    // cannot take, so nothing else would post the line or push the slots until the next event.
    line_source();
    port_push(printer_state_view().state);
    if (!locked) xSemaphoreGive(s_job_lock);
}

// A cartridge was read: AirPrint offers colour or not under the same UUID, as the ribbon
// does, and it is kept so a restart offers what the printer last said. A black-only model
// never offers colour. Not for the printer task to call: this writes flash.
static void sw_cart_seen(int colour)
{
    const sw_spec_t *sp = sw_spec(printers_port_sw_model());
    if (!sp) return;                    // the record is no longer a StyleWriter: not its ribbon
    colour = colour > 0 && sp->colour;
    s_sw_cart = colour ? 2 : 1;
    iw_ribbon_t r = colour ? IW_RIBBON_COLOUR : IW_RIBBON_BLACK;
    if (r != s_ribbon) {
        ESP_LOGI(TAG, "cartridge now %s (was %s)", ribbon_name(r), ribbon_name(s_ribbon));
        s_ribbon = (uint8_t)r;
        settings_save_ribbon((uint8_t)r);
    }
    port_push(printer_state_view().state);      // the colour it offers (W-1116: its own slot)
}

// Whether a port record of `kind` and `model` may offer colour at all: a black-only
// StyleWriter never does, whatever the ImageWriter that was there before had in, and nor
// does an original ImageWriter, which never says its ribbon (s_ribbon is the last answer's,
// a colour cartridge's or a II's ribbon).
static int colour_offered(int kind, int model)
{
    if (kind == PR_KIND_QDLASER) return 0;      // W-1102: black only
    if (kind != PR_KIND_STYLEWRITER) return model != PR_MODEL_IW1;
    const sw_spec_t *sp = sw_spec(pr_model_to_sw((pr_model_t)model));
    return sp && sp->colour;
}

// What a saved ribbon may offer a phone at start, for printer 0 (the oldest port record,
// which is the port's printer until anything answers).
static int ribbon_offered(void)
{
    return s_port_fam == PR_FAM_STYLEWRITER ? colour_offered(PR_KIND_STYLEWRITER, pr_model_from_sw(printers_port_sw_model()))
         : s_port_fam == PR_FAM_QDLASER ? 0
                     : colour_offered(PR_KIND_IMAGEWRITER, printers_port_model());
}

// The session reports its state (sw_session.h) while it runs a job or a cleaning, on
// whichever task that is, the printer task included, so nothing here may write flash. The
// fault goes to the panel at once and to IPP in its own words, not only as a change of the
// display state.
static void sw_state_cb(sw_state_t st)
{
    s_sw_state = st;
    s_port_answering = st != SWS_OFFLINE;
    s_sw_asleep = st == SWS_READY;      // only the session's end shows ready: `E l` went out
    if (s_sw_asleep) s_sw_asleep_model = printers_port_sw_model();
    if (st == SWS_OFFLINE) {
        s_sw_job_silent = 1;            // the session got nothing: offline until it answers
        // It was answering before the session: the port is looked at once the session is over
        // (the plain question, then ESC ?), so an ImageWriter put in its place is found.
        if (s_sw_was_answering) {
            s_sw_was_answering = 0;
            look_ask();
        }
    }
    s_iw_ready = sw_state_ready(st);
    if (s_printing) {
        printer_state_post(sw_state_fault(st) ? PS_EV_FAULT_ON : PS_EV_FAULT_OFF);
        printer_state_post(st == SWS_OFFLINE ? PS_EV_LINE_NOT_READY : PS_EV_LINE_READY);
    }
    port_push(printer_state_view().state);
}

// What the port task's question (`1` and `2`, the plain question) found, idle: the state to
// show, and whether the record's printer answered. The original StyleWriter shows ready while it
// is silent and has not failed a session (sw_idle_silent), unanswering.
static void sw_idle_state(sw_state_t st, int answered)
{
    s_sw_state = st;
    s_port_answering = answered;
    if (answered) {
        s_sw_job_silent = 0;
        printers_port_answered(PR_HEARD_STYLEWRITER);
    }
    s_iw_ready = sw_state_ready(st);
    line_source();
    port_push(printer_state_view().state);
}

// The record's StyleWriter did not answer, idle.
static void sw_idle_quiet(void)
{
    sw_model_t m = printers_port_sw_model();
    sw_idle_state(sw_idle_silent(m, s_sw_job_silent, s_sw_asleep && m == s_sw_asleep_model), 0);
}

// A StyleWriter that has just answered: its cartridge (what AirPrint offers follows it), and
// its state.
static void sw_online(sw_model_t m)
{
    int c = stylewriter_cart(m);
    if (c >= 0) sw_cart_seen(c);
    sw_state_t st;
    if (stylewriter_status(m, &st) == SW_OK) sw_idle_state(st, 1);
    else sw_idle_quiet();
    s_last_status_ms = uptime_ms();     // `1` and `2` were just asked: not again in 10 s
}

// ------------------------------------------------- a Personal LaserWriter 300 on the port
// W-1102: the port task asks it while its clock runs, a job's session reports through
// qd_state_cb, and these turn what it says into the box's state, the panel's line and what the
// phone is told, as the StyleWriter's do.

// Each change of state, once, by name.
static void qd_log_state(qd_state_t st, const qd_raw_t *raw)
{
    static const char *const k_names[] = {
        [QDS_READY] = "ready", [QDS_PRINTING] = "printing", [QDS_NO_PAPER] = "paper out",
        [QDS_NO_CASSETTE] = "cassette out", [QDS_MANUAL] = "waiting for a sheet in the manual slot",
        [QDS_JAM] = "jam", [QDS_COVER] = "cover open", [QDS_ENGINE] = "engine fault",
        [QDS_OFFLINE] = "offline",
    };
    if (st == QDS_ENGINE && raw)
        ESP_LOGW(TAG, "LaserWriter 300: engine fault 83 04 %02x 83 07 %02x", raw->s04, raw->s07);
    else
        ESP_LOGI(TAG, "LaserWriter 300: %s", (unsigned)st < sizeof k_names / sizeof k_names[0]
                                            ? k_names[st] : "?");
}

// A job's or the test page's session reports its state, on the rip task or the page's own:
// nothing here writes flash. The fault goes to the panel at once and to IPP in its own words.
static void qd_state_cb(qd_state_t st)
{
    if (st != s_qd_state) qd_log_state(st, NULL);
    s_qd_state = st;
    s_port_answering = st != QDS_OFFLINE;
    s_iw_ready = qd_state_ready(st);
    if (s_printing) {
        printer_state_post(qd_state_fault(st) ? PS_EV_FAULT_ON : PS_EV_FAULT_OFF);
        printer_state_post(st == QDS_OFFLINE ? PS_EV_LINE_NOT_READY : PS_EV_LINE_READY);
    }
    port_push(printer_state_view().state);
}

// What the port task's question found, idle: the state to show, and whether the record's
// printer answered.
static void qd_idle_state(qd_state_t st, int answered, const qd_raw_t *raw)
{
    if (st != s_qd_state) qd_log_state(st, raw);
    s_qd_state = st;
    s_port_answering = answered;
    if (answered) printers_port_answered(PR_HEARD_QDLASER);
    s_iw_ready = qd_state_ready(st);
    line_source();
    port_push(printer_state_view().state);
}

// The record's 300 asked for its state (and its lights set), under the job lock.
static void qd_online(void)
{
    qd_model_t m = printers_port_qd_model();
    qd_state_t st = QDS_OFFLINE;
    qd_raw_t raw = { 0 };
    if (m != QD_NONE && qdlaser_status(s_clock_hz, m, &st, &raw) == QD_OK) qd_idle_state(st, 1, &raw);
    else qd_idle_state(QDS_OFFLINE, 0, NULL);
}

// serial_out's on_clock, from its line task: a clock on HSKi came (a QuickDraw LaserWriter was
// switched on, or plugged in on) or went. Each find logs the clock's rate and duty, so a board
// whose U3 carries a marginal clock shows in its log. A job in flight learns of a lost clock
// from its own session.
static void printer_clock_changed(void *ctx, int clocked, int hz)
{
    (void)ctx;
    s_clock_hz = hz;
    s_clocked = clocked;
    if (clocked) {
        int duty = serial_out_clock_duty();
        ESP_LOGI(TAG, "printer port: a clock, %d Hz, duty %d.%d%%", hz, duty / 10, duty % 10);
        if (s_kick_handle) xTaskAbortDelay(s_kick_handle);   // the port task asks at once
        return;
    }
    printers_port_clock_gone();
    if (s_port_fam == PR_FAM_QDLASER && !s_printing) qd_idle_state(QDS_OFFLINE, 0, NULL);
    look_ask();
    ESP_LOGI(TAG, "printer port: the clock stopped");
}

// J2's link for the port's record: a QuickDraw LaserWriter's opens per question and per job
// (qd_link.c), so there is nothing to set; the others' are the StyleWriter glue's.
static void port_link_record(void)
{
    if (printers_port_family() == PR_FAM_QDLASER) return;
    stylewriter_link_record();
}

// The person named the port's printer a StyleWriter (Add a Printer…, the unknown printer's
// notice, the detail's Model): the full sequence, which finds the original too, confirms it
// and reads its model. A printer that stays silent keeps the pick, offline.
static void sw_confirm(void)
{
    int id = s_confirm_sw_id;
    // The record the person picked; skip if it is no longer a port StyleWriter (changed since).
    if (printers_test_kind(id) != PR_TEST_STYLEWRITER) return;
    ESP_LOGI(TAG, "asking the port's StyleWriter what it is");
    sw_model_t m = stylewriter_ask_full();
    s_last_status_ms = uptime_ms();
    if (m == SW_NONE) {
        // The full sequence resets even the original: nothing answered. The picked record
        // keeps the pick, offline; the printer on the port (another record, or none) is left.
        ESP_LOGW(TAG, "the port's StyleWriter did not answer; keeping the pick, offline");
        s_sw_job_silent = 1;
        if (printers_port_is_stylewriter()) sw_idle_state(SWS_OFFLINE, 0);
        else port_push(printer_state_view().state);
        return;
    }
    s_sw_asleep = 0;                    // the reset woke it: it stays awake now
    // The picked record takes the model it named (when free), and that model is on the port now.
    printers_port_set_sw_model(id, m);
    port_fam_sync(printers_port_family(), 1);
    sw_online(m);
    ESP_LOGI(TAG, "port task: %u bytes of stack to spare", (unsigned)uxTaskGetStackHighWaterMark(NULL));
}

static int sw_cancelled(void)
{
    if (s_job_fam == PR_FAM_STYLEWRITER || s_job_fam == PR_FAM_QDLASER) return s_job_cancelled;
    return s_test_running && s_test_cancel;      // the test page's second tap
}

// W-1116: an ImageWriter is the printer on the port now (its record is current and present),
// so the StyleWriter's language must not go out (stylewriter_cfg_t.swapped), whichever record
// a job, page or cleaning is for. Now, not the list's last answer: an ImageWriter that
// answered and was unplugged must not refuse a StyleWriter's job, page or cleaning on the
// quiet port that follows (the session's own `?` still refuses the wrong printer).
static int sw_swapped(void)
{
    return printers_port_on_is_imagewriter();
}

// The settings page's Print Head cleaning (printers_cfg_t.clean): one cleaning, on a task
// of its own so the page is answered. The job lock is held to its end.
static void sw_clean_task(void *arg)
{
    sw_model_t m = (sw_model_t)(intptr_t)arg;
    int rc = stylewriter_clean(m);
    s_sw_was_answering = 0;
    if (rc == SW_OK) printers_port_answered(PR_HEARD_STYLEWRITER);
    printer_state_post(rc == SW_OK ? PS_EV_JOB_DONE : PS_EV_JOB_FAILED);
    s_last_status_ms = uptime_ms();
    s_printing = 0;                              // first: never Printing in between
    s_cleaning = 0;
    job_touch();
    line_source();
    ESP_LOGI(TAG, "cleaning task: %u bytes of stack to spare", (unsigned)uxTaskGetStackHighWaterMark(NULL));
    xSemaphoreGive(s_job_lock);
    vTaskDelete(NULL);
}

// 0 once it has begun, 409 when a job holds the printer, 502 when it is not the port's
// StyleWriter, has no cleaning (the original), does not answer or holds a fault (a cleaning
// would wait on it with the lock held): stylewriter_clean_check decides, with the lock.
static int sw_clean_web(int id)
{
    if (printers_test_kind(id) != PR_TEST_STYLEWRITER) return 502;
    int busy = xSemaphoreTake(s_job_lock, 0) != pdTRUE;
    if (!busy) {
        // W-1116: the cleaning's family is its record's, a StyleWriter, under the lock, as a
        // job's (doc_begin) and a test page's (test_page_to) are: whose answers are the port's
        // state while it runs, and whose family the answer at its end names. The flip zeroes
        // answering, so what the StyleWriter was doing before is read after it.
        port_fam_sync(PR_FAM_STYLEWRITER, 1);
        s_sw_job_silent = 0;                     // a new session: what it finds is the state
        s_sw_was_answering = s_port_answering;
    }
    sw_model_t m = pr_model_to_sw(printers_record_model(id));   // the record's own (W-1116)
    int rc = stylewriter_clean_check(m, busy);
    if (rc) {
        if (!busy) xSemaphoreGive(s_job_lock);
        return rc;
    }
    printer_state_post(PS_EV_ACTIVITY);          // a person asked: wake the panel
    s_cleaning = 1;
    s_printing = 1;
    job_touch();
    led_grid_set_source(LG_SRC_AIRPRINT);
    line_source();
    printer_state_post(PS_EV_JOB_START);
    if (xTaskCreate(sw_clean_task, "sw_clean", 4096, (void *)(intptr_t)m, 3, NULL) != pdPASS) {
        ESP_LOGE(TAG, "cleaning: could not create task");
        printer_state_post(PS_EV_JOB_FAILED);
        s_printing = 0;
        s_cleaning = 0;
        job_touch();
        line_source();
        xSemaphoreGive(s_job_lock);
        return 502;
    }
    return 0;
}

// On the HTTP task: the full sequence takes 2 to 12 s, so it is the port task's to run. The
// record the person picked (W-1116) is confirmed, not the newest StyleWriter.
static void sw_confirm_queue(int id)
{
    s_confirm_sw_id = id;
    s_confirm_sw = 1;
}

// "Look for printers": the port is asked again (the ImageWriter's self-ID once the line is
// ready, the StyleWriter's plain question while nothing answers), and AppleTalk is looked on
// every 30 s again for a while.
static void printers_look(void)
{
    s_look_person = 1;
    look_ask();
    laser_look_now();
}

static void offers_apply(void);

// W-1116: the person set a port record's model (Add a Printer…, the Model detail): the port's
// last answer is forgotten for the record on the port (R10), so the port is asked again at once
// to find what is there. The policy gives the look the right question: the plain one first on a
// StyleWriter-first port, and nothing on a Something else port but the person's own look.
static void port_model_changed(int id)
{
    (void)id;
    // The port's answer went with the record that changed or was removed (R10, R19): the name
    // ESC ? gave was that record's, so no other reads Ready on it until the port answers again.
    if (printers_port_heard() == PR_HEARD_NONE && s_iw_named) {
        s_iw_named = 0;
        line_source();
        port_push(printer_state_view().state);
    }
    look_ask();
}

static void printers_changed(void)
{
    port_fam_sync(printers_port_family(), 0);
    // The record on the port may be another of the same family now (the LQ for the II): the
    // screen follows it under the job lock; a job in progress keeps its own, and the port task
    // follows once the job is over (s_screen_check).
    if (port_line_speaks()) {
        if (xSemaphoreTake(s_job_lock, 0) == pdTRUE) {
            port_screen_follow();
            xSemaphoreGive(s_job_lock);
        } else {
            s_screen_check = 1;
        }
    }
    line_source();
    offers_apply();
    // What the phone is told about each port record follows the list (W-1116): its slot,
    // which record is the printer on the port, and the colour it may offer (a black-only
    // StyleWriter, the record changed to one, offers none).
    port_push(printer_state_view().state);
}

static void printers_web_json(void *ctx, char *buf, size_t cap)
{
    (void)ctx;
    printers_json(buf, cap);
}

static int printers_web_post(void *ctx, const char *body, char *err, size_t cap)
{
    (void)ctx;
    return printers_post(body, err, cap);
}

// ---------------------------------------------------------- AppleTalk jobs
// W-1053: a PAP job is the Mac driver's own ImageWriter stream, so it goes to
// the printer as it is -- no rip -- under the same job lock as an IPP job or a
// test page. at_printer.c spools it for whichever link it came in on (the
// cable, or W-1076's EtherTalk links) and calls these from its print task
// (begin from the link's task). Whether a job that ended was cut mid-command
// is read off its bytes (iw_scan): a Mac that cancels just closes the
// connection, wherever its stream is, and W-1041's resync then runs before the
// next job.

static iw_scan_t    s_lt_scan;
static size_t       s_lt_bytes;

static const char *lt_job_name(at_link_t link)
{
    switch (link) {
    case AT_LINK_TUNNEL: return "Basilisk II job";
    case AT_LINK_ZONE:   return "Infinite Mac job";
    case AT_LINK_RADIO:  return "EtherTalk job";
    default:             return "LocalTalk job";
    }
}

static int lt_print_begin(void *ctx, at_link_t link)
{
    (void)ctx;
    // Never waits: the LocalTalk task must keep answering the Mac, which is
    // told "busy" and asks again.
    if (xSemaphoreTake(s_job_lock, 0) != pdTRUE) {
        s_job_waiting = 1;
        return 1;
    }
    // A Mac's stream is the ImageWriter driver's, and goes to whichever ImageWriter answers on
    // the port (W-1116): busy while the printer on the port is a StyleWriter now (s_port_fam),
    // a flip to or from one is pending, or a StyleWriter's first answer awaits its repeat (the
    // port task asks again within 500 ms, R16, and has let the lock go meanwhile: s_port_confirm
    // with the list's last answer a StyleWriter's), so the driver's bytes never reach a
    // StyleWriter. Not on the list's last answer alone: a StyleWriter sighted once, its repeat
    // over and gone, must not keep Macs busy while nothing answers. The offers keep Macs from
    // asking; this keeps a stray one from being heard. A family flip is the port task's to
    // make, within a tick, not this task's: port_fam_sync pushes the AppleTalk status, whose
    // stack lock this task holds (W-1116 review, NB1); the Mac hears busy until then.
    pr_family_t fam = port_fam_norm(printers_port_family());
    int sighted = s_port_confirm != PA_NONE && printers_port_heard() == PR_HEARD_STYLEWRITER;
    if (fam != s_port_fam || !port_line_speaks() || sighted) {
        xSemaphoreGive(s_job_lock);
        return 1;
    }
    stylewriter_link(0);
    s_job_error[0] = '\0';
    strncpy(s_last_job, lt_job_name(link), sizeof s_last_job - 1);
    s_stream_crc = 0;
    s_printer_failed = 0;
    s_job_cancelled = 0;
    s_lt_bytes = 0;
    iw_scan_init(&s_lt_scan);
    serial_out_set_abort(0);
    iw_link_job_start(&s_link);
    s_printing = 1;
    job_touch();
    led_grid_set_source(LG_SRC_LOCALTALK);     // W-1049: the stripes, not AirPrint's ink
    line_source();                             // the port's own line, not the box's
    printer_state_post(PS_EV_JOB_START);
    serial_out_loopback_reset();
    printer_state_post(PS_EV_ACTIVITY);
    ESP_LOGI(TAG, "%s starts", lt_job_name(link));
    return 0;
}

static int lt_print_write(void *ctx, const uint8_t *d, size_t n)
{
    (void)ctx;
    s_stream_crc = crc32_up(s_stream_crc, d, n);
    iw_scan(&s_lt_scan, d, n);
    s_lt_bytes += n;
    if (s_printer_failed) return 1;
    if (iw_link_need_resync(&s_link) && !AW_LOOPBACK) {
        ESP_LOGW(TAG, "last job was cut short; resyncing the printer first");
        esp_err_t err = ESP_OK;
        iw_resync(resync_out, &err);
        if (err != ESP_OK) goto fail;
    }
    if (paper_to_tof() != ESP_OK) goto fail;
    if (serial_out_write(d, n) == ESP_OK) return 0;
fail:
    // Paused past STALL_ABORT: the Mac is told (CloseConn) and its queued
    // tail must not print ahead of the next job.
    s_printer_failed = 1;
    serial_out_purge();
    return 1;
}

static int lt_print_end(void *ctx, int normal)
{
    (void)ctx;
    int clean = normal && !s_printer_failed && iw_scan_between(&s_lt_scan);
    esp_err_t flushed = clean ? serial_out_flush(CONFIG_AIRWRITER_STALL_ABORT * 1000u) : ESP_FAIL;
    // The last bytes never left: paper out on the last line, past the limit.
    if (clean && flushed != ESP_OK) s_printer_failed = 1;
    if (flushed != ESP_OK) serial_out_purge();
    // The Mac's driver feeds to the next page by line, never by form feed.
    iw_link_job_end_at(&s_link, flushed == ESP_OK, iw_scan_at_tof(&s_lt_scan));
    s_last_bytes = s_lt_bytes;
    s_last_pages = 0;
    // In the link's log too (/api/lt, /api/et): the console is not always attached.
    char line[100];
    snprintf(line, sizeof line, "job %s: %u bytes, crc32 %08x",
             flushed == ESP_OK ? (s_lt_bytes ? "printed" : "empty") : s_printer_failed ? "failed"
             : normal ? "cut short" : "abandoned",
             (unsigned)s_lt_bytes, (unsigned)s_stream_crc);
    at_printer_note(line);
    if (AW_LOOPBACK && flushed == ESP_OK) {
        size_t got; uint32_t crc;
        serial_out_loopback_wait(s_lt_bytes, 3000);
        serial_out_loopback_stats(&got, &crc);
        snprintf(line, sizeof line, "uart loopback: %u/%u bytes back, crc32 %08x: %s",
                 (unsigned)got, (unsigned)s_lt_bytes, (unsigned)crc,
                 got == s_lt_bytes && crc == s_stream_crc ? "intact" : "MISMATCH");
        at_printer_note(line);
    }
    // A Mac that cancels is a done job, as Cancel-Job is; a printer that gave
    // up is a failed one.
    printer_state_post(s_printer_failed ? PS_EV_JOB_FAILED : PS_EV_JOB_DONE);
    s_printing = 0;
    job_touch();
    line_source();
    // W-1059, under the job lock; an empty job (a Mac that opened and closed,
    // or an idle relay peer) proves nothing about this firmware.
    if (flushed == ESP_OK && s_lt_bytes) ota_health_printed();
    xSemaphoreGive(s_job_lock);
    return flushed == ESP_OK;
}

// ------------------------------------------------------------- dip / test
// DIP1-8 select mode/dev-mode/test-on-boot/dither-override/spare; a press of
// the test button prints a self-test page. dev_mode and dither_ovr land in
// later milestones -- for this rev dev_mode is a log note only (each
// printer's uuid is its record's since W-1088).
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
void app_main(void)
{
    // Before anything else: U9's level-shifter input has no pull, so from
    // power-on until this line the LED chain sees noise (a brief flicker at
    // boot is expected on rev A; rev B adds a 100k pulldown on U9.2). It must
    // run before wifi_start() especially -- the join loop can block for 60s.
    // Compile-time guard: the pin is -1 on a devkit with no strip.
#if CONFIG_AIRWRITER_LED_DATA_PIN >= 0
    gpio_config_t led_clamp = {
        .pin_bit_mask = 1ULL << CONFIG_AIRWRITER_LED_DATA_PIN,
        .mode         = GPIO_MODE_OUTPUT,
    };
    gpio_set_level(CONFIG_AIRWRITER_LED_DATA_PIN, 0);
    gpio_config(&led_clamp);
#endif
    // As early as it can be: everything after this reaches the log (W-1136).
    logbook_start(job_busy, reset_name(esp_reset_reason()));
    // IO4 runs through R15 to the PIC's RA1, TashTalk's UART receive. Left
    // floating, TashTalk can decode noise as host commands and put garbage
    // on a LocalTalk bus. High is the UART idle level; low would be a break.
    // pic_prog borrows the pin for a flash and hands it back as a pulled-up
    // input; a LocalTalk UART driver will own it once that lands. Off the S3
    // the default is -1; a devkit wired to a breadboard PIC sets its own pin
    // and gets the same clamp.
#if CONFIG_AIRWRITER_PIC_CLK_PIN >= 0
    gpio_config_t lt_tx_clamp = {
        .pin_bit_mask = 1ULL << CONFIG_AIRWRITER_PIC_CLK_PIN,
        .mode         = GPIO_MODE_OUTPUT,
    };
    gpio_set_level(CONFIG_AIRWRITER_PIC_CLK_PIN, 1);
    gpio_config(&lt_tx_clamp);
#endif
    // The SP3232's driver inputs have no pull-ups and must be tied: a floating
    // CMOS input can idle at threshold, on the chip that carries the CTS
    // receiver. Low asserts the port's handshake out. J2's: IO35 on rev A
    // (T1OUT reaches only R9, DNP), IO47 on rev 2026.11 (to J2.1). J4's, rev
    // 2026.11 only: IO13. The bootloader hook drove them low already; this
    // keeps them so once the app owns the pins.
#if CONFIG_AIRWRITER_HSKI_DRV_PIN >= 0
    gpio_config_t hski_clamp = {
        .pin_bit_mask = 1ULL << CONFIG_AIRWRITER_HSKI_DRV_PIN,
        .mode         = GPIO_MODE_OUTPUT,
    };
    gpio_set_level(CONFIG_AIRWRITER_HSKI_DRV_PIN, 0);
    gpio_config(&hski_clamp);
#endif
#if CONFIG_AIRWRITER_J4_HSKO_DRV_PIN >= 0
    gpio_config_t j4_hsko_clamp = {
        .pin_bit_mask = 1ULL << CONFIG_AIRWRITER_J4_HSKO_DRV_PIN,
        .mode         = GPIO_MODE_OUTPUT,
    };
    gpio_set_level(CONFIG_AIRWRITER_J4_HSKO_DRV_PIN, 0);
    gpio_config(&j4_hsko_clamp);
#endif

    // Before anything that can call doc_begin or test_page: dip_config's poll
    // task starts soon and a button press must not race the lock into
    // existence.
    s_job_lock = xSemaphoreCreateBinary();
    xSemaphoreGive(s_job_lock);             // created empty; start it free
    s_offers_mx = xSemaphoreCreateMutex();
#if CONFIG_AIRWRITER_PIC_CLK_PIN >= 0 && CONFIG_AIRWRITER_PIC_DAT_PIN >= 0
    s_lt_mx = xSemaphoreCreateMutex();
#endif

    read_straps();

    ps_timing_t tm = PS_TIMING_DEFAULT;
    tm.stall_attention_ms = CONFIG_AIRWRITER_STALL_TIMEOUT * 1000u;
    tm.boot_ms = LG_BOOT_MS;
    tm.boot_out_ms = LG_SPIN_OUT_MS;
    printer_state_start(&tm, on_ps_change);
    // After the clamp above: the RMT driver takes IO48 over from here, and
    // by the first frame the line is driven, never floating.
    ESP_ERROR_CHECK(led_grid_start());

    ESP_LOGI(TAG, "AirWriter starting after %s reset, %u bytes free",
             reset_name(esp_reset_reason()), (unsigned)esp_get_free_heap_size());
    memdiag_start();                        // W-1094: what holds internal RAM (/api/mem)
    if (bootloader_common_get_rtc_retain_mem_factory_reset_state()) {
        logbook_clear();
        ESP_LOGW(TAG, "power-up reset by the bootloader: settings erased, known-good firmware");
        s_boot_reset = 1;
    }

    esp_err_t err = nvs_flash_init();
    if (err == ESP_ERR_NVS_NO_FREE_PAGES || err == ESP_ERR_NVS_NEW_VERSION_FOUND) {
        ESP_ERROR_CHECK(nvs_flash_erase());
        err = nvs_flash_init();
    }
    ESP_ERROR_CHECK(err);

    // Default hostname imagewriter-XXXX, the last two MAC bytes. SPEC.md 3.2.
    uint8_t mac[6] = {0};
    esp_read_mac(mac, ESP_MAC_WIFI_STA);
    snprintf(s_suffix, sizeof s_suffix, "%02x%02x", mac[4], mac[5]);
    settings_load(&s_set, s_suffix);
    logbook_set_names(s_set.ssid, s_set.hostname);
    // W-1088: a board's first boot on the printer list. One set up before
    // (Wi-Fi saved, no list) keeps its host name and DIP rule, and its records
    // are made from what it had; a new one is airwriter-xxxx, port on.
    int has_wifi = s_set.ssid[0] != 0;
    int updated = has_wifi && !printers_stored();
    settings_first_boot(pr_default_host_fmt(has_wifi), s_suffix, pr_default_lt_port(has_wifi));
    settings_load(&s_set, s_suffix);
    logbook_set_names(s_set.ssid, s_set.hostname);
#if CONFIG_AIRWRITER_DIP7_PIN < 0
    led_grid_set_gamer(s_set.rainbow);      // W-1109: no DIP 7, the page's switch
#endif
    printers_cfg_t pc = {
        .epoch = CONFIG_AIRWRITER_LASER_UUID_EPOCH, .updated_board = updated,
        .legacy = { .model = s_set.model, .name = s_set.name, .airprint = s_set.airprint,
                    .dither = s_set.dither, .gain = s_set.gain, .top_margin = s_set.top_margin,
                    .ribbon = s_set.ribbon },
        .port_sink = { .claim = port_claim, .begin = doc_begin, .data = doc_data, .end = doc_end,
                       .cancel = doc_cancel, .ctx = NULL },
        .at_sink   = { .claim = doc_claim, .begin = laser_doc_begin, .data = doc_data,
                       .end = laser_doc_end, .cancel = laser_doc_cancel },
        .port_live = port_live, .port_screen = port_screen, .look = printers_look,
        .changed = printers_changed, .placed = port_placed,          // W-1116: placed
        .port_model = port_model_changed,                            // W-1116: R10's re-ask
        .clean = sw_clean_web, .confirm_sw = sw_confirm_queue,      // W-1103
    };
    memcpy(pc.mac, mac, sizeof pc.mac);
    ESP_ERROR_CHECK(printers_start(&pc));
    s_port_fam = port_fam_norm(printers_port_family());  // W-1103: whose answers are the port's state
    if (updated && !s_set.airprint) {
        // W-1079's switch was the ImageWriter's alone: its record took it as
        // Share, and the switch is now the whole box's.
        settings_save_switches(1, -1);
        s_set.airprint = 1;
    }
    {
        char dither[sizeof s_set.dither];
        int gain;
        if (!printers_port_screen(dither, sizeof dither, &gain)) {
            snprintf(s_set.dither, sizeof s_set.dither, "%s", dither);
            s_set.gain = (uint8_t)gain;
        }
        // The Chooser's name and mDNS's default instance: the port's one ImageWriter for
        // vintage Macs (W-1116: the oldest ImageWriter record's, fixed across swaps), else
        // the oldest port record's, else AirWriter.
        printers_chooser_name(s_set.queue, sizeof s_set.queue);
    }
    offers_apply();                 // the cable's, kept for its node's start
    s_ribbon = s_set.ribbon;
    // Wi-Fi saved before this restart: green greets the join (W-1049).
    if (settings_take_wifi_fresh()) printer_state_post(PS_EV_WIFI_FRESH);
    ota_health_start(s_set.ssid[0] != 0);
    snprintf(s_saved_model, sizeof s_saved_model, "%s", s_set.model);
    snprintf(s_saved_name, sizeof s_saved_name, "%s", s_set.name);
    snprintf(s_saved_host, sizeof s_saved_host, "%s", s_set.hostname);
#if CONFIG_AIRWRITER_LT_BENCH
    lt_start("bench build");
    if (s_set.lt_port == 0) lt_roles_apply();
#endif
    if (s_set.lt_port == 1) lt_start("the settings page");
    // W-1081: off or not, the card says whether U7 can run the port. DIP
    // mode 2, read later, starts the node as before.
    if (!localtalk_running()) lt_go("boot", 1);

    raster_selftest();
    // W-1082: no ImageWriter and a LaserWriter shared: the panel follows the
    // LaserWriter from the first report, not J2's line.


    ht_algo_t algo;
    if (ht_algo_from_name(s_set.dither, &algo)) algo = HT_ATKINSON;

    serial_out_cfg_t ser = {
        .uart_num        = CONFIG_AIRWRITER_UART_NUM,
        .tx_pin          = CONFIG_AIRWRITER_TX_PIN,
        .rx_pin          = CONFIG_AIRWRITER_RX_PIN,
        .cts_pin         = CONFIG_AIRWRITER_CTS_PIN,
        .baud            = CONFIG_AIRWRITER_BAUD,
        .invert_tx       = AW_INVERT_TX,
        .invert_rx       = AW_INVERT_RX,
        .invert_cts      = AW_INVERT_CTS,
        .stall_abort_s   = CONFIG_AIRWRITER_STALL_ABORT,
        .on_line         = printer_line_changed,
        .on_clock        = printer_clock_changed,   // W-1102
        .loopback        = AW_LOOPBACK,
    };
    // W-1102: the 300's link, J2's pins; it touches nothing until a question opens it.
    qd_link_init(&(qd_link_cfg_t){ .uart_num = CONFIG_AIRWRITER_UART_NUM,
                                   .tx_pin = CONFIG_AIRWRITER_TX_PIN,
                                   .rx_pin = CONFIG_AIRWRITER_RX_PIN,
                                   .clk_pin = CONFIG_AIRWRITER_CTS_PIN,
                                   .invert_tx = AW_INVERT_TX });
    ESP_ERROR_CHECK(serial_out_init(&ser));
#if CONFIG_AIRWRITER_PIC_CLK_PIN >= 0
    cable_test_cfg_t ct = {
        .tx_pin  = CONFIG_AIRWRITER_TX_PIN,       .rx_pin = CONFIG_AIRWRITER_RX_PIN,
        .invert_tx = AW_INVERT_TX,
        .lt_uart = CONFIG_AIRWRITER_LT_UART_NUM,  .lt_tx  = CONFIG_AIRWRITER_PIC_CLK_PIN,
        .lt_rx   = CONFIG_AIRWRITER_PIC_DAT_PIN,  .lt_cts = CONFIG_AIRWRITER_LT_CTS_PIN,
        .lt_mclr = CONFIG_AIRWRITER_PIC_MCLR_PIN,
        // W-1109: rev 2026.11's handshake legs; -1 on rev A skips them.
        .hsk_j2_out = CONFIG_AIRWRITER_HSKI_DRV_PIN,     .hsk_j2_in = CONFIG_AIRWRITER_CTS_PIN,
        .hsk_j4_out = CONFIG_AIRWRITER_J4_HSKO_DRV_PIN,  .hsk_j4_in = CONFIG_AIRWRITER_J4_HSKI_PIN,
    };
    cable_test_init(&ct);
#endif
    // W-1103: the StyleWriter's line, over the port serial_out just brought up.
    stylewriter_cfg_t swc = { .record_is_sw = printers_port_is_stylewriter, .state = sw_state_cb,
                              .cart = sw_cart_seen, .cancelled = sw_cancelled,
                              .swapped = sw_swapped };
    stylewriter_start(&swc);
    static const qdlaser_cfg_t qdc = { .state = qd_state_cb, .cancelled = sw_cancelled,
                                       .page = qd_page_cb };
    qdlaser_start(&qdc);
    // 4 KB: a ribbon change saves to NVS and re-announces mDNS from here; the StyleWriter's
    // questions and its model and cartridge saves run here too.
    xTaskCreate(kick_task, "kick", 4096, NULL, 3, &s_kick_handle);

    job_pipe_cfg_t pipe = { .out = printer_out, .dither = algo, .gain = s_set.gain,
                            .top_margin = s_set.top_margin,
                            .done = pipe_done, .colour_ok = colour_ok,
                            .page_out = pipe_page_out };
    ESP_ERROR_CHECK(job_pipe_init(&pipe));

    // Before wifi_start, which can block up to 60s joining: the debounce
    // settles in ~300ms, so the boot-time read is long ready by the time
    // test_on_boot is checked below, whichever path gets there.
    dip_config_cb_t dip_cb = { .on_change = dip_on_change, .on_test_button = test_button,
                               .on_hold = on_hold };
    ESP_ERROR_CHECK(dip_config_start(&dip_cb));

    // No credentials, or they no longer work: become an access point and let
    // the user fix it from a phone. This is the only path a person who did not
    // build the firmware can take.
    // Joining only when there is a network to try: setup mode after it is a
    // failed join, which the panel opens with two red pulses (W-1049).
    if (s_set.ssid[0]) printer_state_post(PS_EV_WIFI_JOINING);
    wifi_init();
    if (!s_set.ssid[0] || wifi_start() != ESP_OK) {
        char ap[32];
        snprintf(ap, sizeof ap, "AirWriter-%s", s_suffix);
        s_ap_mode = 1;
        strncpy(s_ip, "192.168.4.1", sizeof s_ip - 1);
        printer_state_post(PS_EV_WIFI_SETUP_AP);

        if (!s_set.ssid[0]) ESP_LOGW(TAG, "no wi-fi credentials stored");
        else                ESP_LOGW(TAG, "could not join \"%s\"", s_set.ssid);

        ESP_ERROR_CHECK(esp_event_handler_instance_register(
            WIFI_EVENT, WIFI_EVENT_AP_STACONNECTED, ap_event, NULL, NULL));
        ESP_ERROR_CHECK(esp_event_handler_instance_register(
            WIFI_EVENT, WIFI_EVENT_AP_STADISCONNECTED, ap_event, NULL, NULL));
        ESP_ERROR_CHECK(net_provision_start(ap));
        ota_health_set(OH_AP_UP, 1);
        fwu_start(1);
        webui_cfg_t wcfg = { .status_json = status_json, .general_saved = general_saved, .captive = 1,
                              .restart = web_restart, .erase = web_erase, .test_page = web_test_page,
                              .localtalk_flash = localtalk_flash,
                              .lt_json = lt_json, .lt_job = lt_job, .lt_echo = lt_echo,
                              .cable_test = cable_web,     // no EtherTalk: the zone stays off the open AP
                              .printers_json = printers_web_json, .printers_post = printers_web_post };
        ESP_ERROR_CHECK(webui_start(&wcfg));
        ota_health_set(OH_WEB_UP, 1);
        // W-1088: setup shows what is plugged in before there is Wi-Fi: the
        // port answers as its line comes up, and the cable is looked on at once.
        laser_cfg_t lc = { .version = esp_app_get_description()->version, .first_look_ms = 0,
                           .links = laser_links, .found = laser_found, .queried = laser_queried,
                           .changed = laser_changed, .relay = laser_relay };
        if (laser_start(&lc) == ESP_OK) printers_apply();

        for (;;) { vTaskDelay(pdMS_TO_TICKS(1000)); logbook_tick(); }
    }

    ipp_server_cfg_t cfg = {
        .queue_name   = s_set.queue,
        .hostname     = s_set.hostname,
        .port         = 631,
        .port_printer = printers_port_ipp(),        // W-1088: as its record says
        .on_job_op    = on_activity,
        .colour       = s_ribbon == IW_RIBBON_COLOUR && ribbon_offered(),
    };
    ipp_server_set_airprint(s_set.airprint);          // W-1079
    ESP_ERROR_CHECK(ipp_server_start(&cfg));
    // The ribbon or the line may have been read while the server started; push what they are.
    port_push(printer_state_view().state);
    ota_health_set(OH_IPP_UP, 1);
    // wifi_start returned joined, before this could hear the join.
    fwu_start(0);
    fw_update_net_up();

    webui_cfg_t wcfg = { .status_json = status_json, .general_saved = general_saved, .captive = 0,
                          .restart = web_restart, .erase = web_erase, .test_page = web_test_page,
                          .localtalk_flash = localtalk_flash,
                          .lt_json = lt_json, .lt_job = lt_job, .lt_echo = lt_echo,
                          .cable_test = cable_web, .et_json = et_json,
                          .et_settings_get = et_settings_get, .et_settings_set = et_settings_set,
                          .laser_json = laser_web_json,
                          .printers_json = printers_web_json, .printers_post = printers_web_post };
    ESP_ERROR_CHECK(webui_start(&wcfg));
    ota_health_set(OH_WEB_UP, 1);
    et_start();
    offers_apply();

    // W-1082, W-1088: the printers on AppleTalk, each shared on its own slot.
    laser_cfg_t lc = { .version = esp_app_get_description()->version, .first_look_ms = 10000,
                       .links = laser_links, .found = laser_found, .queried = laser_queried,
                       .changed = laser_changed, .relay = laser_relay };
    err = laser_start(&lc);
    if (err != ESP_OK) ESP_LOGE(TAG, "AppleTalk printers did not start: %s", esp_err_to_name(err));
    printers_apply();                           // W-1116: the other slots are placed, and pushed (placed)

    if (s_test_on_boot) {
        s_test_on_boot = 0;
        ESP_LOGI(TAG, "DIP4 was on at boot; printing a test page");
        test_page();
    }

    ESP_LOGI(TAG, "ready: %s", ipp_server_uri());
    ESP_LOGI(TAG, "settings at http://%s.local/", s_set.hostname);
    ESP_LOGI(TAG, "%u bytes free after startup", (unsigned)esp_get_free_heap_size());
    memdiag_mark("ready");

    for (;;) { vTaskDelay(pdMS_TO_TICKS(1000)); logbook_tick(); }
}
