wr/airwriter/firmware/components/localtalk/ethertalk.c

// SPDX-License-Identifier: GPL-3.0-or-later
//
// ESP glue for EtherTalk; see ethertalk.h. One task owns both links under
// s_lock. The relay's WebSocket task never takes s_lock: the client holds its
// own lock while it runs our handler, and our task sends through that client,
// so the handler only queues what it receives and sets flags, and what the
// zone link sends is queued under s_lock and written by our task outside it.
#include "ethertalk.h"
#include <errno.h>
#include <stdio.h>
#include <stdlib.h>
#include <string.h>
#include "esp_crt_bundle.h"
#include "esp_heap_caps.h"
#include "esp_log.h"
#include "esp_mac.h"
#include "esp_private/wifi.h"
#include "esp_random.h"
#include "esp_timer.h"
#include "esp_websocket_client.h"
#include "freertos/FreeRTOS.h"
#include "freertos/queue.h"
#include "freertos/semphr.h"
#include "freertos/task.h"
#include "lwip/pbuf.h"
#include "lwip/sockets.h"
#include "memdiag.h"
#include "nvs.h"
#include "et_link.h"
#include "et_transport.h"
#include "et_radio_hook.h"

static const char *TAG = "et";

#define LINE_LEN        100
#define ZQ_DEPTH        16
#define WS_MSG_MAX      4096           // one relay message: a 621-byte frame is ~2.5 KB of JSON
#define BACKOFF_MIN_MS  1000
#define BACKOFF_MAX_MS  60000
#define STEADY_MS       60000          // a connection this long resets the backoff
#define ET_JSON_PEERS   6              // peers per link in /api/et: 3 full links, named,
                                       // and an ordinary log come to ~4.3 KB of its 4.5

typedef struct { uint16_t n; uint8_t f[ELAP_MAX_FRAME]; } zframe_t;

typedef struct {
    et_link_t   link;
    at_owner_t  owner;
    const char *name;              // "tunnel", "zone": the log's prefix
    const char *nvs_net, *nvs_node;
    uint16_t    status;
    int         active;            // ticking: the tunnel with a socket and an address,
                                   // the zone while the relay is connected
    uint32_t    seen_replies;      // what the panel was last told (W-1049)
    uint8_t     seen_heard[32];
    lt_name_t  *names;             // its Macs' names, in PSRAM (internal RAM is short)
    lt_reg_t   *regs;              // W-1088: its node's registrations, in PSRAM
    lt_offers_t *offers;           // W-1088: what its Macs are offered, in PSRAM
} et_side_t;

// W-1094: the three links and the buffers each context keeps between calls,
// ~37 KB, in PSRAM rather than .bss, where they were internal RAM that Wi-Fi
// and lwIP buffer in (docs/traps.md). None is touched by an interrupt or DMA:
// the Wi-Fi driver, lwIP and the WebSocket client copy what they are handed.
// Made by a constructor, before app_main, so every use below finds it.
typedef struct {
    et_side_t side[3];                        // s_tun, s_zone, s_radio
    zframe_t  zone_out;                       // zone_send's, s_lock held
    uint8_t   radio_raw[ELAP_MAX_FRAME + 64]; // ethertalk_radio_input's: lwIP's thread
    zframe_t  radio_in;
    zframe_t  relay_in;                       // on_relay_message's: the client's task
    uint8_t   relay_f[ELAP_MAX_FRAME + 64];
    char      relay_msg[WS_MSG_MAX];          // ws_handler's: the client's task
    uint8_t   task_buf[ELAP_MAX_FRAME + 64];  // et_task's
    zframe_t  task_z;
    char      task_json[WS_MSG_MAX];
} et_mem_t;

static et_mem_t *s_mem;
#define s_tun   (s_mem->side[0])
#define s_zone  (s_mem->side[1])
#define s_radio (s_mem->side[2])

__attribute__((constructor)) static void et_mem_make(void)
{
    s_mem = heap_caps_calloc(1, sizeof *s_mem, MALLOC_CAP_SPIRAM | MALLOC_CAP_8BIT);
    if (!s_mem) s_mem = calloc(1, sizeof *s_mem);    // a board with no PSRAM
    if (!s_mem) abort();
}

static SemaphoreHandle_t s_lock;           // the links, the settings, the pending flags
static int        s_running;
static char       s_obj[NBP_NAME_MAX + 1], s_type[NBP_NAME_MAX + 1];
static void     (*s_on_event)(lt_event_t ev);

// Settings, and what the task has yet to act on.
static int        s_tunnel_on = 1;
static volatile int s_radio_on = 1;
// W-1082: a LaserWriter shared on the tunnel or the radio keeps that link
// running whatever its switch; the switch alone answers as the ImageWriter.
static volatile int s_laser_tun, s_laser_radio;
static void     (*s_found)(int link, const nbp_tuple_t *t, const lt_route_t *r);
static void     (*s_name_check)(int link, const nbp_tuple_t *t);

static int tun_wanted(void)   { return s_tunnel_on || s_laser_tun; }
static int radio_wanted(void) { return s_radio_on || s_laser_radio; }
static char       s_zone_name[ET_ZONE_MAX + 1];
static int        s_zone_on;               // the relay runs when on and named
static int        s_want_tunnel = -1;      // -1: nothing to do
static int        s_want_radio = -1;
static int        s_want_zone;
static uint32_t   s_ip, s_new_ip;
static int        s_ip_changed, s_net_down;

// The tunnel.
static int        s_sock = -1;
static uint32_t   s_tun_drops;
static uint32_t   s_tun_nomem;      // of those, sendto still out of buffers after its tries
static int        s_tun_errno;      // the last failed sendto's errno
static uint32_t   s_tun_retries, s_radio_retries;   // sends that waited for a buffer (W-1086)

// The radio: frames in from lwIP's thread, out through the Wi-Fi driver.
static QueueHandle_t s_rin;
static uint8_t    s_sta_mac[ETH_ALEN];
static volatile uint32_t s_radio_in_drops, s_radio_out_drops, s_radio_unknown, s_radio_kept;

// The relay.
static esp_websocket_client_handle_t s_ws;
static QueueHandle_t s_zin, s_zout;
static volatile int s_ws_up, s_ws_went_down, s_ws_came_up;
static volatile int64_t s_up_at;
static uint8_t    s_zone_mac[ETH_ALEN];
static volatile uint32_t s_zone_in_drops, s_zone_out_drops, s_zone_bad, s_zone_pongs;
static uint32_t   s_backoff_ms = BACKOFF_MIN_MS;
static char       s_zone_err[64];
static char       s_zone_why[160];          // the client's own text for the last error

static uint64_t now_ms(void) { return (uint64_t)(esp_timer_get_time() / 1000); }

static void note(const char *who, const char *line)
{
    char l[LINE_LEN];
    snprintf(l, sizeof l, "%s: %s", who, line);
    ESP_LOGI(TAG, "%s", l);
}

static void tun_note(const char *line)  { note("tunnel", line); }
static void zone_note(const char *line) { note("zone", line); }
static void radio_note(const char *line) { note("radio", line); }

// ------------------------------------------------------------- link ops
// On our task with s_lock held, except abort (the print task).

static void op_log(void *ctx, const char *line) { note(((et_side_t *)ctx)->name, line); }
// The node's own connection prints on the ImageWriter; one on another
// registration is the relay's (W-1088).
static const at_relay_t *relay_conn(et_side_t *s)
{
    return lt_node_pap_reg(&s->link.node) ? at_relay() : NULL;
}

static int op_begin(void *ctx) { return at_job_begin(&((et_side_t *)ctx)->owner); }
static void op_data(void *ctx, const uint8_t *d, size_t n)
{
    const at_relay_t *r = relay_conn(ctx);
    if (r) r->data(d, n);
    else at_job_data(&((et_side_t *)ctx)->owner, d, n);
}
static size_t op_room(void *ctx)
{
    const at_relay_t *r = relay_conn(ctx);
    return r ? r->room() : at_job_room(&((et_side_t *)ctx)->owner);
}
static void op_end(void *ctx, int normal)
{
    const at_relay_t *r = relay_conn(ctx);
    if (r) r->end(normal);
    else at_job_end(&((et_side_t *)ctx)->owner, normal);
}
static int op_pap_open(void *ctx, int reg, uint64_t now)
{
    et_side_t *s = ctx;
    return at_relay() ? at_relay()->open((int)s->owner.link, &s->link.node, reg, now) : 1;
}
static size_t op_reg_status(void *ctx, int reg, uint8_t *pstr, size_t cap)
{
    et_side_t *s = ctx;
    return at_relay() ? at_relay()->status((int)s->owner.link, &s->link.node, reg, pstr, cap) : 0;
}
static size_t op_reg_output(void *ctx, int reg, uint8_t *buf, size_t max, int *eof, int again)
{
    (void)ctx;
    (void)reg;
    if (!at_relay()) {
        *eof = 1;
        return 0;
    }
    return at_relay()->output(buf, max, eof, again);
}

static void op_claimed(void *ctx, uint16_t net, uint8_t node)
{
    et_side_t *s = ctx;
    nvs_handle_t h;
    if (nvs_open("et", NVS_READWRITE, &h) != ESP_OK) return;
    nvs_set_u16(h, s->nvs_net, net);
    nvs_set_u8(h, s->nvs_node, node);
    nvs_commit(h);
    nvs_close(h);
}

static void op_found(void *ctx, const nbp_tuple_t *t, const lt_route_t *r)
{
    if (s_found) s_found((int)((et_side_t *)ctx)->owner.link, t, r);
}

static void op_name_check(void *ctx, const nbp_tuple_t *t)
{
    if (s_name_check) s_name_check((int)((et_side_t *)ctx)->owner.link, t);
}

static void side_abort(void *ctx)
{
    et_side_t *s = ctx;
    xSemaphoreTake(s_lock, portMAX_DELAY);
    lt_node_pap_abort(&s->link.node, now_ms());
    xSemaphoreGive(s_lock);
}

// et_send_patiently's: a burst Wi-Fi has not sent yet leaves no buffer.
static void send_wait(uint32_t ms)
{
    TickType_t t = pdMS_TO_TICKS(ms);
    vTaskDelay(t ? t : 1);
}

static int tun_sendto(void *ctx, const uint8_t *f, size_t n)
{
    if (sendto(s_sock, f, n, 0, (const struct sockaddr *)ctx, sizeof(struct sockaddr_in)) >= 0)
        return ET_SEND_OK;
    s_tun_errno = errno;
    return errno == ENOMEM || errno == ENOBUFS ? ET_SEND_BUSY : ET_SEND_FAILED;
}

static void tun_send(void *ctx, const uint8_t *f, size_t n)
{
    (void)ctx;
    uint32_t ip;
    if (s_sock < 0 || !et_tunnel_dest(f, &ip)) {
        s_tun_drops++;
        return;
    }
    struct sockaddr_in to = { .sin_family = AF_INET, .sin_port = htons(ET_TUNNEL_PORT) };
    to.sin_addr.s_addr = htonl(ip);
    int retries;
    if (et_send_patiently(tun_sendto, &to, f, n, send_wait, &retries)) {
        s_tun_drops++;
        if (s_tun_errno == ENOMEM || s_tun_errno == ENOBUFS) s_tun_nomem++;
    }
    s_tun_retries += (uint32_t)retries;
}

static void zone_send(void *ctx, const uint8_t *f, size_t n)
{
    (void)ctx;
    zframe_t *z = &s_mem->zone_out;                // s_lock held
    if (!s_ws_up || n > sizeof z->f) {
        s_zone_out_drops++;
        return;
    }
    z->n = (uint16_t)n;
    memcpy(z->f, f, n);
    if (xQueueSend(s_zout, z, 0) != pdTRUE) s_zone_out_drops++;
}

static int radio_tx(void *ctx, const uint8_t *f, size_t n)
{
    (void)ctx;
    esp_err_t e = esp_wifi_internal_tx(WIFI_IF_STA, (void *)f, (uint16_t)n);
    return e == ESP_OK ? ET_SEND_OK : e == ESP_ERR_NO_MEM ? ET_SEND_BUSY : ET_SEND_FAILED;
}

static void radio_send(void *ctx, const uint8_t *f, size_t n)
{
    (void)ctx;
    int retries = 0;
    if (!s_radio.active || et_send_patiently(radio_tx, NULL, f, n, send_wait, &retries))
        s_radio_out_drops++;
    s_radio_retries += (uint32_t)retries;
}

// lwIP's thread, for every frame it does not know (et_radio_hook.h): the
// AppleTalk ones are ours, the rest it drops as it always did.
err_t ethertalk_radio_input(struct pbuf *p, struct netif *netif)
{
    (void)netif;
    uint8_t *raw = s_mem->radio_raw;               // lwIP's thread only
    zframe_t *z = &s_mem->radio_in;
    s_radio_unknown++;
    if (!s_running || !radio_wanted() || !s_rin || p->tot_len > sizeof s_mem->radio_raw)
        return ERR_ARG;
    u16_t n = pbuf_copy_partial(p, raw, sizeof s_mem->radio_raw, 0);
    size_t m = et_radio_normalize(raw, n, z->f, sizeof z->f);
    if (!m) return ERR_ARG;
    z->n = (uint16_t)m;
    s_radio_kept++;
    if (xQueueSend(s_rin, z, 0) != pdTRUE) s_radio_in_drops++;
    pbuf_free(p);
    return ERR_OK;
}

static void side_init(et_side_t *s, const uint8_t mac[ETH_ALEN])
{
    uint16_t hnet = 0;
    uint8_t hnode = 0;
    nvs_handle_t h;
    if (nvs_open("et", NVS_READONLY, &h) == ESP_OK) {
        nvs_get_u16(h, s->nvs_net, &hnet);
        nvs_get_u8(h, s->nvs_node, &hnode);
        nvs_close(h);
    }
    if (!s->names) s->names = heap_caps_calloc(LT_SEEN_SLOTS, sizeof *s->names, MALLOC_CAP_SPIRAM);
    if (!s->regs) s->regs = heap_caps_calloc(LT_REG_MAX, sizeof *s->regs, MALLOC_CAP_SPIRAM);
    et_cfg_t c = { s_obj, s_type, s->status, {0}, hnet, hnode, esp_random() | 1, LT_IDLE_HOLD_MS,
                   s->names, s->regs };
    memcpy(c.mac, mac, ETH_ALEN);
    et_ops_t o = { s, s == &s_tun ? tun_send : s == &s_zone ? zone_send : radio_send, op_log,
                   op_begin, op_data, op_room, op_end, op_claimed, op_found, op_pap_open,
                   op_reg_status, op_reg_output, op_name_check };
    et_link_init(&s->link, &c, &o, now_ms());
    if (s->offers)
        lt_node_offer(&s->link.node, s->offers->own, s->offers->rel, s->offers->n_rel, s->offers->marker);
}

// ------------------------------------------------------------- the tunnel

static void tunnel_open(void)
{
    if (s_sock >= 0) return;
    int fd = socket(AF_INET, SOCK_DGRAM, IPPROTO_UDP);
    if (fd < 0) {
        note("tunnel", "no socket");
        return;
    }
    int on = 1;
    setsockopt(fd, SOL_SOCKET, SO_REUSEADDR, &on, sizeof on);
    setsockopt(fd, SOL_SOCKET, SO_BROADCAST, &on, sizeof on);
    struct sockaddr_in a = { .sin_family = AF_INET, .sin_port = htons(ET_TUNNEL_PORT) };
    a.sin_addr.s_addr = htonl(INADDR_ANY);
    if (bind(fd, (struct sockaddr *)&a, sizeof a) < 0) {
        close(fd);
        note("tunnel", "port 6066 is taken");
        return;
    }
    s_sock = fd;
}

static void tunnel_close(void)
{
    if (s_sock < 0) return;
    close(s_sock);
    s_sock = -1;
}

// ------------------------------------------------------------- the relay
// The handler runs on the client's task, holding the client's lock.

static void on_relay_message(esp_websocket_client_handle_t c, const char *msg, size_t len)
{
    zframe_t *z = &s_mem->relay_in;                // the client's task only
    uint8_t *f = s_mem->relay_f;
    size_t n = 0;
    int r = et_zone_parse(msg, len, f, sizeof s_mem->relay_f, &n);
    if (r < 0) {
        s_zone_bad++;
        return;
    }
    if (r == 0) return;
    uint8_t pong[ET_PONG_LEN];
    if (et_zone_pong(f, n, s_zone_mac, pong)) {    // Infinite Mac's latency check
        char j[256];
        size_t jl = et_zone_send_json(j, sizeof j, pong, sizeof pong);
        if (jl) esp_websocket_client_send_text(c, j, (int)jl, pdMS_TO_TICKS(200));
        s_zone_pongs++;
        return;
    }
    if (n > sizeof z->f) {
        s_zone_bad++;
        return;
    }
    z->n = (uint16_t)n;
    memcpy(z->f, f, n);
    if (xQueueSend(s_zin, z, 0) != pdTRUE) s_zone_in_drops++;
}

// W-1094: the client's own words for an error, the ERROR event's data. Its
// codes lose them: the event comes before the client records the error's type,
// so every dropped connection read "connection error (type 0)".
static void relay_why(const char *m, int n)
{
    s_zone_why[0] = '\0';
    if (!m || n <= 0) return;
    if (n > (int)sizeof s_zone_why - 1) n = (int)sizeof s_zone_why - 1;
    memcpy(s_zone_why, m, (size_t)n);
    s_zone_why[n] = '\0';
    for (char *c = s_zone_why; *c; c++)            // it goes into JSON as it is
        if (*c == '"' || *c == '\\' || (unsigned char)*c < ' ') *c = '\'';
}

// For the event log: "esp_transport_read() failed with -1, ..., errno=104"
// as "read failed, errno 104"; a missed pong as "no answer to pings".
static void relay_why_short(char *out, size_t cap)
{
    const char *f = strstr(s_zone_why, "esp_transport_");
    const char *e = strstr(s_zone_why, "errno=");
    if (f) {
        f += strlen("esp_transport_");
        snprintf(out, cap, "%.*s failed, errno %d", (int)strcspn(f, "("), f, e ? atoi(e + 6) : 0);
    } else if (strstr(s_zone_why, "PONG")) {
        snprintf(out, cap, "no answer to pings");
    } else {
        snprintf(out, cap, "%s", s_zone_why);
    }
}

static void ws_handler(void *arg, esp_event_base_t base, int32_t id, void *data)
{
    (void)arg;
    (void)base;
    char *msg = s_mem->relay_msg;                  // the client's task only
    esp_websocket_event_data_t *d = data;
    switch (id) {
    case WEBSOCKET_EVENT_BEFORE_CONNECT:
        memdiag_mark("relay connecting");          // W-1094: what a handshake costs
        break;
    case WEBSOCKET_EVENT_CONNECTED: {
        memdiag_mark("relay up");
        char init[80];
        size_t n = et_zone_init_json(init, sizeof init, s_zone_mac);
        if (n) esp_websocket_client_send_text(d->client, init, (int)n, pdMS_TO_TICKS(1000));
        s_up_at = esp_timer_get_time() / 1000;
        s_zone_err[0] = '\0';
        s_ws_up = 1;
        s_ws_came_up = 1;
        break;
    }
    case WEBSOCKET_EVENT_DATA:
        if (d->op_code != 0x1 && d->op_code != 0x0) break;   // text, and its continuations
        if (d->payload_len > WS_MSG_MAX || d->payload_offset < 0 ||
            d->payload_offset + d->data_len > WS_MSG_MAX) {
            s_zone_bad++;
            break;
        }
        memcpy(msg + d->payload_offset, d->data_ptr, (size_t)d->data_len);
        if (d->payload_offset + d->data_len < d->payload_len) break;
        on_relay_message(d->client, msg, (size_t)d->payload_len);
        break;
    case WEBSOCKET_EVENT_ERROR: {
        // The handshake status outlives a failed attempt (it is the last
        // upgrade's), so the TLS and socket errors come first, and a 101 is
        // never the error.
        const esp_websocket_error_codes_t *e = &d->error_handle;
        relay_why(d->data_ptr, d->data_len);
        if (e->esp_tls_last_esp_err)
            snprintf(s_zone_err, sizeof s_zone_err, "TLS: %s (%d)", esp_err_to_name(e->esp_tls_last_esp_err),
                     e->esp_tls_stack_err);
        else if (e->esp_ws_handshake_status_code && e->esp_ws_handshake_status_code != 101)
            snprintf(s_zone_err, sizeof s_zone_err, "the relay answered %d", e->esp_ws_handshake_status_code);
        else if (s_zone_why[0])
            relay_why_short(s_zone_err, sizeof s_zone_err);
        else
            snprintf(s_zone_err, sizeof s_zone_err, "connection error (type %d)", (int)e->error_type);
        break;
    }
    case WEBSOCKET_EVENT_DISCONNECTED:
    case WEBSOCKET_EVENT_CLOSED: {
        memdiag_mark("relay down");
        // 1 s, doubling to 60 s; back to 1 s after a connection that held a minute.
        int64_t now = esp_timer_get_time() / 1000;
        if (s_ws_up && now - s_up_at >= STEADY_MS) s_backoff_ms = BACKOFF_MIN_MS;
        else s_backoff_ms = s_backoff_ms * 2 > BACKOFF_MAX_MS ? BACKOFF_MAX_MS : s_backoff_ms * 2;
        esp_websocket_client_set_reconnect_timeout(d->client, (int)s_backoff_ms);
        s_ws_up = 0;
        s_ws_went_down = 1;
        break;
    }
    default:
        break;
    }
}

// Stops and frees the client; on our task, never the client's own.
static void zone_stop(void)
{
    if (!s_ws) return;
    if (s_ws_up) {
        static const char bye[] = "{\"type\":\"close\"}";
        esp_websocket_client_send_text(s_ws, bye, sizeof bye - 1, pdMS_TO_TICKS(200));
    }
    esp_websocket_client_stop(s_ws);
    esp_websocket_client_destroy(s_ws);
    s_ws = NULL;
    s_ws_up = 0;
}

static void zone_start(const char *zone)
{
    if (s_ws || !zone[0]) return;
    char uri[96];
    snprintf(uri, sizeof uri, "wss://infinitemac.org/zone/%s/websocket", zone);
    esp_websocket_client_config_t c = {
        .uri = uri,
        .crt_bundle_attach = esp_crt_bundle_attach,
        .buffer_size = 2048,
        .task_stack = 6144,
        // Core 0, with Wi-Fi: a TLS handshake on core 1 stutters the panel (W-1060).
        .task_core_id_set = true,
        .task_core_id = 0,
        .reconnect_timeout_ms = BACKOFF_MIN_MS,
        .network_timeout_ms = 10000,
        // A relay restart closes cleanly; without this the client's task ends
        // and the zone stays down until the setting is saved again.
        .enable_close_reconnect = true,
        // Wi-Fi gone leaves the TLS socket looking open: pings find it in 45 s.
        .ping_interval_sec = 15,
        .pingpong_timeout_sec = 45,
    };
    s_backoff_ms = BACKOFF_MIN_MS;
    s_ws = esp_websocket_client_init(&c);
    if (!s_ws) {
        note("zone", "no memory for the relay");
        return;
    }
    esp_websocket_register_events(s_ws, WEBSOCKET_EVENT_ANY, ws_handler, NULL);
    if (esp_websocket_client_start(s_ws) != ESP_OK) {
        esp_websocket_client_destroy(s_ws);
        s_ws = NULL;
        note("zone", "could not start the relay client");
        return;
    }
    note("zone", "connecting to Infinite Mac");
}

// ------------------------------------------------------------- the task

static void side_events(et_side_t *s, int *lookup, int *fresh)
{
    const lt_node_t *n = &s->link.node;
    if (n->st.replies != s->seen_replies) *lookup = 1;
    for (size_t k = 0; k < sizeof s->seen_heard; k++) {
        if (n->heard[k] & ~n->printers[k] & ~s->seen_heard[k]) *fresh = 1;
        s->seen_heard[k] = n->heard[k];
    }
    s->seen_replies = n->st.replies;
}

static void apply_pending(void)
{
    xSemaphoreTake(s_lock, portMAX_DELAY);
    int want_t = s_want_tunnel, want_z = s_want_zone, want_r = s_want_radio;
    int ipch = s_ip_changed, down = s_net_down;
    uint32_t ip = s_new_ip;
    char zone[ET_ZONE_MAX + 1];
    memcpy(zone, s_zone_name, sizeof zone);
    if (!s_zone_on) zone[0] = '\0';
    s_want_tunnel = -1;
    s_want_radio = -1;
    s_want_zone = 0;
    s_ip_changed = 0;
    s_net_down = 0;
    // W-1082: a switch turned off while a LaserWriter needs its link leaves it running.
    if (want_t == 0 && tun_wanted()) want_t = -1;
    if (want_r >= 0) want_r = radio_wanted();
    // A switch turned off with a LaserWriter keeping its link: a Mac printing
    // to the ImageWriter there is told, as a quiet cable tells it.
    if (!s_tunnel_on && s_tun.link.node.serve && s_tun.link.node.pap.open)
        lt_node_pap_abort(&s_tun.link.node, now_ms());
    if (!s_radio_on && s_radio.link.node.serve && s_radio.link.node.pap.open)
        lt_node_pap_abort(&s_radio.link.node, now_ms());
    lt_node_set_serve(&s_tun.link.node, s_tunnel_on);
    lt_node_set_serve(&s_radio.link.node, s_radio_on);
    xSemaphoreGive(s_lock);
    uint64_t now = now_ms();

    if (down) {
        xSemaphoreTake(s_lock, portMAX_DELAY);
        if (s_tun.link.node.pap.open || s_zone.link.node.pap.open || s_radio.link.node.pap.open)
            note("all", "Wi-Fi lost; the job ends");
        et_link_down(&s_tun.link, now);
        et_link_down(&s_zone.link, now);
        et_link_down(&s_radio.link, now);
        xSemaphoreGive(s_lock);
    }

    if (want_t == 0) {
        xSemaphoreTake(s_lock, portMAX_DELAY);
        et_link_down(&s_tun.link, now);
        s_tun.active = 0;
        xSemaphoreGive(s_lock);
        tunnel_close();
        note("tunnel", "off");
    }
    if ((ipch && ip != s_ip) || want_t == 1) {
        if (ipch) s_ip = ip;
        if (tun_wanted()) tunnel_open();
        uint8_t mac[ETH_ALEN];
        et_tunnel_mac(s_ip, mac);
        xSemaphoreTake(s_lock, portMAX_DELAY);
        if (tun_wanted() && s_sock >= 0 && s_ip) {
            et_link_set_mac(&s_tun.link, mac, now);    // a job on the old address ends
            s_tun.active = 1;
        } else {
            et_link_down(&s_tun.link, now);
            s_tun.active = 0;
        }
        xSemaphoreGive(s_lock);
        if (s_tun.active) note("tunnel", "listening for Basilisk II");
    }
    // The radio follows the setting and the station's address; its MAC is the
    // station's own, so a new IP changes nothing but whether it can talk.
    if (want_r >= 0 || ipch) {
        xSemaphoreTake(s_lock, portMAX_DELAY);
        int was = s_radio.active;
        s_radio.active = radio_wanted() && s_ip;
        if (s_radio.active && !was) et_link_set_mac(&s_radio.link, s_sta_mac, now);   // acquire again
        if (!s_radio.active && was) et_link_down(&s_radio.link, now);
        xSemaphoreGive(s_lock);
        if (want_r >= 0) note("radio", s_radio.active ? "listening for Macs on this network" : "off");
    }
    if (want_z) {
        zone_stop();
        xSemaphoreTake(s_lock, portMAX_DELAY);
        et_link_down(&s_zone.link, now);
        s_zone.active = 0;
        xSemaphoreGive(s_lock);
        s_ws_came_up = s_ws_went_down = 0;
        if (zone[0]) zone_start(zone);
        else note("zone", "off");
    }
}

static void et_task(void *arg)
{
    (void)arg;
    uint8_t *buf = s_mem->task_buf;
    zframe_t *z = &s_mem->task_z;
    char *json = s_mem->task_json;
    for (;;) {
        apply_pending();

        // The tunnel: up to 20 ms for a datagram.
        if (s_sock >= 0) {
            fd_set rf;
            FD_ZERO(&rf);
            FD_SET(s_sock, &rf);
            struct timeval tv = { 0, 20000 };
            if (select(s_sock + 1, &rf, NULL, NULL, &tv) > 0) {
                int n = recv(s_sock, buf, sizeof s_mem->task_buf, 0);
                if (n > 0) {
                    xSemaphoreTake(s_lock, portMAX_DELAY);
                    if (s_tun.active) et_link_rx(&s_tun.link, buf, (size_t)n, now_ms());
                    xSemaphoreGive(s_lock);
                }
            }
        } else {
            vTaskDelay(pdMS_TO_TICKS(20));
        }

        // The relay's comings and goings, then what it brought.
        if (s_ws_came_up) {
            s_ws_came_up = 0;
            xSemaphoreTake(s_lock, portMAX_DELAY);
            et_link_set_mac(&s_zone.link, s_zone_mac, now_ms());   // the address again
            s_zone.active = 1;
            xSemaphoreGive(s_lock);
            note("zone", "connected to Infinite Mac");
        }
        if (s_ws_went_down) {
            s_ws_went_down = 0;
            xSemaphoreTake(s_lock, portMAX_DELAY);
            if (s_zone.active) et_link_down(&s_zone.link, now_ms());
            s_zone.active = 0;
            xSemaphoreGive(s_lock);
            char l[LINE_LEN];
            snprintf(l, sizeof l, "disconnected (%s); again in %lu s",
                     s_zone_err[0] ? s_zone_err : "closed", (unsigned long)(s_backoff_ms / 1000));
            note("zone", l);
        }
        while (xQueueReceive(s_zin, z, 0) == pdTRUE) {
            xSemaphoreTake(s_lock, portMAX_DELAY);
            if (s_zone.active) et_link_rx(&s_zone.link, z->f, z->n, now_ms());
            xSemaphoreGive(s_lock);
        }
        while (xQueueReceive(s_rin, z, 0) == pdTRUE) {
            xSemaphoreTake(s_lock, portMAX_DELAY);
            if (s_radio.active) et_link_rx(&s_radio.link, z->f, z->n, now_ms());
            xSemaphoreGive(s_lock);
        }

        // Timers, and what the panel should hear.
        int lookup = 0, fresh = 0;
        xSemaphoreTake(s_lock, portMAX_DELAY);
        uint64_t now = now_ms();
        if (s_tun.active) et_link_tick(&s_tun.link, now);
        if (s_zone.active) et_link_tick(&s_zone.link, now);
        if (s_radio.active) et_link_tick(&s_radio.link, now);
        side_events(&s_tun, &lookup, &fresh);
        side_events(&s_zone, &lookup, &fresh);
        side_events(&s_radio, &lookup, &fresh);
        xSemaphoreGive(s_lock);
        if (s_on_event) {
            if (lookup) s_on_event(LT_EV_LOOKUP);
            if (fresh)  s_on_event(LT_EV_NEW_NODE);
        }

        // The zone link's frames out, outside s_lock.
        while (xQueueReceive(s_zout, z, 0) == pdTRUE) {
            size_t jl = et_zone_send_json(json, WS_MSG_MAX, z->f, z->n);
            if (!jl || !s_ws || !s_ws_up ||
                esp_websocket_client_send_text(s_ws, json, (int)jl, pdMS_TO_TICKS(200)) < 0)
                s_zone_out_drops++;
        }
    }
}

// ------------------------------------------------------------- settings

static void load_settings(int *tunnel, int *radio, int *infinite, char *zone, size_t cap)
{
    *tunnel = 1;
    *radio = 1;
    *infinite = 0;
    zone[0] = '\0';
    nvs_handle_t h;
    if (nvs_open("et", NVS_READONLY, &h) != ESP_OK) return;
    uint8_t t;
    if (nvs_get_u8(h, "tunnel", &t) == ESP_OK) *tunnel = t != 0;
    if (nvs_get_u8(h, "radio", &t) == ESP_OK) *radio = t != 0;
    size_t l = cap;
    if (nvs_get_str(h, "zone", zone, &l) != ESP_OK || !et_zone_name_ok(zone)) zone[0] = '\0';
    // Infinite Mac's switch: off until someone turns it on (W-1079), since a
    // zone is reachable by anyone on the internet who knows its name.
    if (nvs_get_u8(h, "zone_on", &t) == ESP_OK) *infinite = t != 0;
    nvs_close(h);
}

esp_err_t ethertalk_apply(int tunnel, int radio, int infinite, const char *zone)
{
    if (zone && zone[0] && !et_zone_name_ok(zone)) return ESP_ERR_INVALID_ARG;
    nvs_handle_t h;
    esp_err_t err = nvs_open("et", NVS_READWRITE, &h);
    if (err != ESP_OK) return err;
    if (tunnel >= 0) nvs_set_u8(h, "tunnel", tunnel ? 1 : 0);
    if (radio >= 0) nvs_set_u8(h, "radio", radio ? 1 : 0);
    if (infinite >= 0) nvs_set_u8(h, "zone_on", infinite ? 1 : 0);
    if (zone) nvs_set_str(h, "zone", zone);
    err = nvs_commit(h);
    nvs_close(h);
    if (!s_running) return err;

    xSemaphoreTake(s_lock, portMAX_DELAY);
    // W-1082: a link a LaserWriter keeps running stays as it is when its
    // switch moves; only whether it answers as the ImageWriter changes.
    if (tunnel >= 0 && (tunnel != 0) != s_tunnel_on) {
        int was = tun_wanted();
        s_tunnel_on = tunnel != 0;
        if (tun_wanted() != was) s_want_tunnel = tun_wanted();
    }
    if (radio >= 0 && (radio != 0) != s_radio_on) {
        int was = radio_wanted();
        s_radio_on = radio != 0;
        if (radio_wanted() != was) s_want_radio = radio_wanted();
    }
    if (zone && strcmp(zone, s_zone_name)) {
        strncpy(s_zone_name, zone, ET_ZONE_MAX);
        s_zone_name[ET_ZONE_MAX] = '\0';
        s_want_zone = 1;
    }
    if (infinite >= 0 && (infinite != 0) != s_zone_on) {
        s_zone_on = infinite != 0;
        s_want_zone = 1;
    }
    xSemaphoreGive(s_lock);
    return err;
}

void ethertalk_set_offers(int link, const lt_offers_t *o)
{
    et_side_t *s = link == AT_LINK_TUNNEL ? &s_tun : link == AT_LINK_ZONE ? &s_zone
                 : link == AT_LINK_RADIO ? &s_radio : NULL;
    if (!s) return;
    if (!s->offers) s->offers = heap_caps_calloc(1, sizeof *s->offers, MALLOC_CAP_SPIRAM);
    if (!s->offers) return;
    if (s_lock) xSemaphoreTake(s_lock, portMAX_DELAY);
    *s->offers = *o;
    if (s_running) lt_node_offer(&s->link.node, o->own, o->rel, o->n_rel, o->marker);
    if (s_lock) xSemaphoreGive(s_lock);
}

void ethertalk_set_laser(int link, int on)
{
    on = on ? 1 : 0;
    if (!s_running) {
        if (link == AT_LINK_TUNNEL) s_laser_tun = on;
        if (link == AT_LINK_RADIO) s_laser_radio = on;
        return;
    }
    xSemaphoreTake(s_lock, portMAX_DELAY);
    if (link == AT_LINK_TUNNEL && s_laser_tun != on) {
        int was = tun_wanted();
        s_laser_tun = on;
        if (tun_wanted() != was) s_want_tunnel = tun_wanted();   // else running already: leave it
    }
    if (link == AT_LINK_RADIO && s_laser_radio != on) {
        int was = radio_wanted();
        s_laser_radio = on;
        if (radio_wanted() != was) s_want_radio = radio_wanted();
    }
    xSemaphoreGive(s_lock);
}

void ethertalk_lookup(const char *type)
{
    if (!s_running) return;
    xSemaphoreTake(s_lock, portMAX_DELAY);
    uint64_t now = now_ms();
    if (s_tun.active) lt_node_lookup(&s_tun.link.node, type, now);
    if (s_radio.active) lt_node_lookup(&s_radio.link.node, type, now);
    if (s_zone.active) lt_node_lookup(&s_zone.link.node, type, now);
    xSemaphoreGive(s_lock);
}

void ethertalk_set_found(void (*found)(int link, const nbp_tuple_t *t, const lt_route_t *r))
{
    s_found = found;
}

void ethertalk_set_name_check(void (*check)(int link, const nbp_tuple_t *t))
{
    s_name_check = check;
}

void ethertalk_attach(int link, pap_client_t *c)
{
    if (!s_running) return;
    xSemaphoreTake(s_lock, portMAX_DELAY);
    et_side_t *sides[] = { &s_tun, &s_zone, &s_radio };
    for (int i = 0; i < 3; i++) {
        lt_node_t *n = &sides[i]->link.node;
        if (n->client && (!c || n->client == c)) lt_node_attach(n, NULL);
    }
    for (int i = 0; c && i < 3; i++)
        if ((int)sides[i]->owner.link == link) lt_node_attach(&sides[i]->link.node, c);
    xSemaphoreGive(s_lock);
}

int ethertalk_locked(void (*fn)(void *arg), void *arg)
{
    if (!s_running) return -1;
    xSemaphoreTake(s_lock, portMAX_DELAY);
    fn(arg);
    xSemaphoreGive(s_lock);
    return 0;
}

void ethertalk_settings(int *tunnel, int *radio, int *infinite, char *zone, size_t cap)
{
    if (!s_running) {
        load_settings(tunnel, radio, infinite, zone, cap);
        return;
    }
    xSemaphoreTake(s_lock, portMAX_DELAY);
    *tunnel = s_tunnel_on;
    *radio = s_radio_on;
    *infinite = s_zone_on;
    snprintf(zone, cap, "%s", s_zone_name);
    xSemaphoreGive(s_lock);
}

// ------------------------------------------------------------- start

esp_err_t ethertalk_start(const ethertalk_cfg_t *cfg)
{
    if (s_running) return ESP_OK;
    esp_err_t err = at_printer_init(&cfg->printer);
    if (err != ESP_OK) return err;
    s_lock = xSemaphoreCreateMutex();
    s_zin = xQueueCreateWithCaps(ZQ_DEPTH, sizeof(zframe_t), MALLOC_CAP_SPIRAM);
    s_zout = xQueueCreateWithCaps(ZQ_DEPTH, sizeof(zframe_t), MALLOC_CAP_SPIRAM);
    s_rin = xQueueCreateWithCaps(ZQ_DEPTH, sizeof(zframe_t), MALLOC_CAP_SPIRAM);
    if (!s_lock || !s_zin || !s_zout || !s_rin) return ESP_ERR_NO_MEM;

    strncpy(s_obj, cfg->object, sizeof s_obj - 1);
    strncpy(s_type, cfg->type, sizeof s_type - 1);
    s_on_event = cfg->on_event;
    int radio_on = 1;
    load_settings(&s_tunnel_on, &radio_on, &s_zone_on, s_zone_name, sizeof s_zone_name);
    s_radio_on = radio_on;

    // Field by field: a compound literal would put two links (~7 KB) on this stack.
    s_tun.owner = (at_owner_t){ AT_LINK_TUNNEL, side_abort, tun_note, &s_tun };
    s_tun.name = "tunnel";
    s_tun.nvs_net = "tnet";
    s_tun.nvs_node = "tnode";
    s_tun.status = cfg->tunnel_status;
    s_zone.owner = (at_owner_t){ AT_LINK_ZONE, side_abort, zone_note, &s_zone };
    s_zone.name = "zone";
    s_zone.nvs_net = "znet";
    s_zone.nvs_node = "znode";
    s_zone.status = cfg->zone_status;
    s_radio.owner = (at_owner_t){ AT_LINK_RADIO, side_abort, radio_note, &s_radio };
    s_radio.name = "radio";
    s_radio.nvs_net = "rnet";
    s_radio.nvs_node = "rnode";
    s_radio.status = cfg->radio_status;
    uint8_t mac[ETH_ALEN];
    esp_read_mac(s_sta_mac, ESP_MAC_WIFI_STA);
    et_zone_mac(s_sta_mac, s_zone_mac);
    s_ip = cfg->ip;
    et_tunnel_mac(s_ip, mac);
    side_init(&s_tun, mac);
    side_init(&s_zone, s_zone_mac);
    side_init(&s_radio, s_sta_mac);
    s_radio.active = radio_wanted() && s_ip;
    if (s_radio.active) note("radio", "listening for Macs on this network");

    if (tun_wanted()) {
        tunnel_open();
        s_tun.active = s_sock >= 0 && s_ip;
        if (s_tun.active) note("tunnel", "listening for Basilisk II");
    }
    s_running = 1;
    if (s_zone_on && s_zone_name[0]) zone_start(s_zone_name);
    if (xTaskCreatePinnedToCore(et_task, "ethertalk", 8192, NULL, 4, NULL, 0) != pdPASS) {
        s_running = 0;
        return ESP_ERR_NO_MEM;
    }
    ESP_LOGI(TAG, "EtherTalk as a %s (radio %s, tunnel %s, zone %s)", cfg->type,
             s_radio_on ? "on" : "off", s_tunnel_on ? "on" : "off",
             s_zone_on && s_zone_name[0] ? "on" : "off");
    return ESP_OK;
}

int ethertalk_running(void) { return s_running; }

void ethertalk_ip_changed(uint32_t ip)
{
    if (!s_running) return;
    xSemaphoreTake(s_lock, portMAX_DELAY);
    s_new_ip = ip;
    s_ip_changed = 1;
    xSemaphoreGive(s_lock);
}

void ethertalk_net_down(void)
{
    if (!s_running) return;
    xSemaphoreTake(s_lock, portMAX_DELAY);
    s_net_down = 1;
    xSemaphoreGive(s_lock);
}

void ethertalk_set_status(uint16_t tunnel_status, uint16_t zone_status, uint16_t radio_status)
{
    if (!s_running) return;
    xSemaphoreTake(s_lock, portMAX_DELAY);
    s_tun.status = tunnel_status;
    s_zone.status = zone_status;
    s_radio.status = radio_status;
    lt_node_set_status(&s_tun.link.node, tunnel_status);
    lt_node_set_status(&s_zone.link.node, zone_status);
    lt_node_set_status(&s_radio.link.node, radio_status);
    xSemaphoreGive(s_lock);
}

// ------------------------------------------------------------- /api/et

static int side_json(char *p, size_t cap, const et_side_t *s, const char *state)
{
    const et_link_t *l = &s->link;
    const lt_node_t *n = &l->node;
    char addr[16] = "";
    if (n->phase == LT_ONLINE) snprintf(addr, sizeof addr, "%u.%u", n->net, n->node);
    int k = snprintf(p, cap,
        "{\"state\":\"%s\",\"address\":\"%s\",\"mac\":\"%02x:%02x:%02x:%02x:%02x:%02x\","
        "\"frames_in\":%lu,\"frames_out\":%lu,\"bad\":%lu,\"own\":%lu,\"aarp_in\":%lu,"
        "\"aarp_out\":%lu,\"unresolved\":%lu,\"lookups\":%lu,\"replies\":%lu,\"opens\":%lu,"
        "\"busy\":%lu,\"pap\":{\"open\":%s,\"conn\":%u,\"bytes\":%lu},\"heard\":[",
        state, addr, l->mac[0], l->mac[1], l->mac[2], l->mac[3], l->mac[4], l->mac[5],
        (unsigned long)l->st.rx, (unsigned long)l->st.tx, (unsigned long)l->st.bad,
        (unsigned long)l->st.own, (unsigned long)l->st.aarp_in, (unsigned long)l->st.aarp_out,
        (unsigned long)l->st.unresolved, (unsigned long)n->st.lookups,
        (unsigned long)n->st.replies, (unsigned long)n->st.opens, (unsigned long)n->st.busy,
        n->pap.open ? "true" : "false", n->pap.connid, (unsigned long)n->pap.bytes);
    for (int id = 1, first = 1; id < 255 && k > 0 && (size_t)k < cap; id++) {
        if (!(n->heard[id / 8] & (1u << (id % 8)))) continue;
        k += snprintf(p + k, cap - k, "%s%d", first ? "" : ",", id);
        first = 0;
    }
    // W-1079: the peers heard in the last 10 minutes, newest first, for the
    // settings page, with the Macintosh name of each that gave one. A Basilisk
    // II peer's MAC is "B2" and its computer's IP.
    et_peer_t peers[ET_JSON_PEERS];
    size_t np = et_link_peers(l, now_ms(), LT_SEEN_MS, peers, ET_JSON_PEERS);
    if (k > 0 && (size_t)k < cap) k += snprintf(p + k, cap - k, "],\"macs\":[");
    for (size_t i = 0; i < np && k > 0 && (size_t)k < cap; i++) {
        const et_peer_t *e = &peers[i];
        char ip[32] = "";
        if (e->hw[0] == 'B' && e->hw[1] == '2')
            snprintf(ip, sizeof ip, ",\"ip\":\"%u.%u.%u.%u\"", e->hw[2], e->hw[3], e->hw[4], e->hw[5]);
        k += snprintf(p + k, cap - k,
            "%s{\"addr\":\"%u.%u\",\"mac\":\"%02x:%02x:%02x:%02x:%02x:%02x\"%s,\"ago\":%lu",
            i ? "," : "", e->net, e->node, e->hw[0], e->hw[1], e->hw[2], e->hw[3], e->hw[4],
            e->hw[5], ip, (unsigned long)e->ago_s);
        if (e->name && k > 0 && (size_t)k < cap) {
            char u[3 * NBP_NAME_MAX + 1], q[2 * sizeof u];
            nbp_utf8(u, sizeof u, e->name);
            size_t j = 0;
            for (const char *c = u; *c; c++) {             // quotes and backslashes escaped
                if (*c == '"' || *c == '\\') q[j++] = '\\';
                q[j++] = *c;
            }
            q[j] = '\0';
            k += snprintf(p + k, cap - k, ",\"name\":\"%s\"", q);
        }
        if (k > 0 && (size_t)k < cap) k += snprintf(p + k, cap - k, "}");
    }
    if (k > 0 && (size_t)k < cap) k += snprintf(p + k, cap - k, "]}");
    return k;
}

void ethertalk_json(char *buf, size_t cap)
{
    if (!s_running) {
        snprintf(buf, cap, "{\"on\":false}");
        return;
    }
    char *p = buf, *end = buf + cap - 8;
    xSemaphoreTake(s_lock, portMAX_DELAY);
    const char *ts = !s_tunnel_on ? "off" : s_sock < 0 ? "no socket" : !s_ip ? "no address"
                   : s_tun.link.node.phase == LT_ONLINE ? "online" : "acquiring";
    const char *zs = !s_zone_on || !s_zone_name[0] ? "off" : !s_ws_up ? "connecting"
                   : s_zone.link.node.phase == LT_ONLINE ? "online" : "acquiring";
    const char *rs = !s_radio_on ? "off" : !s_ip ? "no address"
                   : s_radio.link.node.phase == LT_ONLINE ? "online" : "acquiring";
    p += snprintf(p, end - p, "{\"on\":true,\"radio\":");
    if (p < end) p += side_json(p, end - p, &s_radio, rs);
    if (p < end) p += snprintf(p, end - p, ",\"tunnel\":");
    if (p < end) p += side_json(p, end - p, &s_tun, ts);
    if (p < end) p += snprintf(p, end - p, ",\"zone\":");
    if (p < end) p += side_json(p, end - p, &s_zone, zs);
    xSemaphoreGive(s_lock);
    if (p < end)
        p += snprintf(p, end - p,
            ",\"radio_drops\":{\"in\":%lu,\"out\":%lu,\"unknown_frames\":%lu,\"appletalk_frames\":%lu,"
            "\"retries\":%lu},"
            "\"tunnel_drops\":%lu,\"tunnel_nomem\":%lu,\"tunnel_errno\":%d,\"tunnel_retries\":%lu,"
            "\"relay\":{\"connected\":%s,\"in_drops\":%lu,\"out_drops\":%lu,"
            "\"bad_messages\":%lu,\"pongs\":%lu,\"last_error\":\"%s\",\"why\":\"%s\"},"
            "\"internal_ram\":{\"free\":%u,\"largest\":%u,\"lowest\":%u},",
            (unsigned long)s_radio_in_drops, (unsigned long)s_radio_out_drops,
            (unsigned long)s_radio_unknown, (unsigned long)s_radio_kept,
            (unsigned long)s_radio_retries,
            (unsigned long)s_tun_drops, (unsigned long)s_tun_nomem, s_tun_errno,
            (unsigned long)s_tun_retries,
            s_ws_up ? "true" : "false",
            (unsigned long)s_zone_in_drops, (unsigned long)s_zone_out_drops,
            (unsigned long)s_zone_bad, (unsigned long)s_zone_pongs, s_zone_err, s_zone_why,
            (unsigned)heap_caps_get_free_size(MALLOC_CAP_INTERNAL),
            (unsigned)heap_caps_get_largest_free_block(MALLOC_CAP_INTERNAL),
            (unsigned)heap_caps_get_minimum_free_size(MALLOC_CAP_INTERNAL));
    if (p < end) {
        at_printer_json(p, end - p);
        p += strlen(p);
    }
    if (p > end) p = end;                          // a cut-short part never runs past buf
    snprintf(p, buf + cap - p, "}");
}
