wr/airwriter/firmware/components/localtalk/pap_client.c

// SPDX-License-Identifier: GPL-3.0-or-later
// The PAP client (W-1082); see pap_client.h.
#include "pap_client.h"
#include <stdarg.h>
#include <stdio.h>
#include <string.h>

static void say(pap_client_t *c, const char *fmt, ...) __attribute__((format(printf, 2, 3)));

static void say(pap_client_t *c, const char *fmt, ...)
{
    if (!c->ops.log) return;
    char line[120];
    va_list ap;
    va_start(ap, fmt);
    vsnprintf(line, sizeof line, fmt, ap);
    va_end(ap);
    c->ops.log(c->ops.ctx, line);
}

// How long since `then`; 0 for a stamp later than `now` (a frame handled at
// a later clock than the tick that follows it), never a wrapped huge one.
static uint64_t since(uint64_t now, uint64_t then)
{
    return now > then ? now - then : 0;
}

static uint32_t rnd(pap_client_t *c)
{
    c->rng ^= c->rng << 13;
    c->rng ^= c->rng >> 17;
    c->rng ^= c->rng << 5;
    return c->rng;
}

static void send(pap_client_t *c, const lt_route_t *to, uint8_t sock, uint8_t ctl, uint8_t bitmap,
                 uint16_t tid, uint8_t u1, uint8_t u2, uint8_t u3, const uint8_t *d, size_t n)
{
    uint8_t user[4] = { c->connid, u1, u2, u3 };
    if (u1 == PAP_SEND_STATUS) user[0] = 0;
    lt_node_send_atp(c->node, to, sock, ctl, bitmap, tid, user, d, n);
}

static void release(pap_client_t *c, const lt_route_t *to, uint16_t tid)
{
    static const uint8_t none[4] = { 0 };
    lt_node_send_atp(c->node, to, PAPC_SOCK, ATP_TREL, 0, tid, none, NULL, 0);
}

static void finish(pap_client_t *c, papc_end_t how)
{
    if (c->phase == PAPC_IDLE) return;
    static const char *const names[] = { "printed", "canceled", "busy too long", "no answer",
                                         "refused", "dropped" };
    say(c, "PAP %u to %u: %s, %lu bytes sent", c->connid, c->sls.addr.node,
        names[how], (unsigned long)c->sent_bytes);
    c->phase = PAPC_IDLE;
    if (c->ops.ended) c->ops.ended(c->ops.ctx, how);
}

void papc_init(pap_client_t *c, const papc_ops_t *ops, uint32_t seed)
{
    lt_node_t *node = c->node;
    memset(c, 0, sizeof *c);
    c->node = node;
    c->ops = *ops;
    c->dead_ms = PAPC_DEAD_MS;
    c->rng = seed ? seed : 0x1082u;
}

void papc_set_dead_ms(pap_client_t *c, uint32_t ms) { c->dead_ms = ms; }

int papc_idle(const pap_client_t *c) { return c->phase == PAPC_IDLE; }

// ------------------------------------------------------------- opening

static void send_open(pap_client_t *c, uint64_t now)
{
    uint32_t waited = (uint32_t)((since(now, c->first_try)) / 1000);
    uint8_t data[4] = { PAPC_SOCK, PAPC_FLOW, (uint8_t)(waited >> 8), (uint8_t)waited };
    send(c, &c->sls, PAPC_SOCK, ATP_TREQ | ATP_XO, 0x01, c->open_tid, PAP_OPEN_CONN, 0, 0,
         data, sizeof data);
    c->open_out = 1;
    c->open_at = now;
}

int papc_open(pap_client_t *c, const lt_route_t *to, uint32_t busy_ms, uint64_t now)
{
    if (!c->node || c->phase != PAPC_IDLE) return -1;
    lt_node_t *node = c->node;
    papc_ops_t ops = c->ops;
    uint32_t dead = c->dead_ms, rng = c->rng;
    // A fresh connection: nothing of the last one carries over but the
    // callbacks, the timers' settings and the random state.
    lt_route_t st_to = c->st_to;
    uint16_t st_tid = c->st_tid;
    uint8_t st_tries = c->st_tries;
    uint64_t st_at = c->st_at;
    memset(c, 0, sizeof *c);
    c->node = node; c->ops = ops; c->dead_ms = dead; c->rng = rng;
    c->st_to = st_to; c->st_tid = st_tid; c->st_tries = st_tries; c->st_at = st_at;

    c->sls = *to;
    c->busy_ms = busy_ms;
    do c->connid = (uint8_t)rnd(c); while (!c->connid);
    c->phase = PAPC_OPENING;
    c->first_try = c->answered = now;
    c->open_tid = lt_node_next_tid(c->node);
    say(c, "PAP %u: opening a connection to %u:%u", c->connid, to->addr.node, to->addr.sock);
    send_open(c, now);
    return 0;
}

static void start_read(pap_client_t *c, uint64_t now);

static void open_reply(pap_client_t *c, const atp_t *a, uint64_t now)
{
    if (!c->open_out || a->tid != c->open_tid || a->len < 4) return;
    c->open_out = 0;
    c->answered = now;
    release(c, &c->sls, a->tid);
    uint16_t result = (uint16_t)(a->data[2] << 8 | a->data[3]);
    const uint8_t *st = a->len > 4 && 5 + (size_t)a->data[4] <= a->len ? a->data + 4 : NULL;
    if (result == PAP_RESULT_OK) {
        c->connid = a->user[0] ? a->user[0] : c->connid;
        c->sess = c->sls;
        c->sess.addr.sock = a->data[0];
        c->quantum = a->data[1] >= 1 && a->data[1] <= PAPC_FLOW ? a->data[1] : 1;
        c->phase = PAPC_OPEN;
        c->heard = c->tickled = now;
        c->rd_seq = 1;
        say(c, "PAP %u: open, the printer's socket %u, quantum %u", c->connid,
            c->sess.addr.sock, c->quantum);
        if (c->ops.opened) c->ops.opened(c->ops.ctx);
        start_read(c, now);
        return;
    }
    if (st && c->ops.status) c->ops.status(c->ops.ctx, st);
    if (result != PAP_RESULT_BUSY) {
        say(c, "PAP %u: refused (result %04x)", c->connid, result);
        finish(c, PAPC_END_REFUSED);
        return;
    }
    if (since(now, c->first_try) >= c->busy_ms) {
        finish(c, PAPC_END_BUSY);
        return;
    }
    c->next_open = c->open_at + PAPC_BUSY_RETRY_MS;   // every 2 s from the last try
}

static void tick_opening(pap_client_t *c, uint64_t now)
{
    if (since(now, c->answered) >= PAPC_GONE_MS) {
        finish(c, PAPC_END_DEAD);
        return;
    }
    if (since(now, c->first_try) >= c->busy_ms) {
        finish(c, PAPC_END_BUSY);
        return;
    }
    if (c->open_out) {
        if (since(now, c->open_at) >= PAPC_RETRY_MS) send_open(c, now);    // the same TID: XO
        return;
    }
    if (now >= c->next_open) {
        c->open_tid = lt_node_next_tid(c->node);
        send_open(c, now);
    }
}

// ------------------------------------------------------------- our data

static void send_reply(pap_client_t *c, const papc_reply_t *r, uint16_t tid, const lt_route_t *to)
{
    for (int k = 0; k < r->n; k++) {
        uint8_t ctl = ATP_TRESP | (k == r->n - 1 ? ATP_EOM : 0);
        send(c, to, PAPC_SOCK, ctl, (uint8_t)k, tid, PAP_DATA, r->eof, 0, r->pkt[k], r->len[k]);
    }
}

static papc_reply_t *cached(pap_client_t *c, uint16_t seq)
{
    if (!seq) return NULL;                       // 0: unsequenced, never a retransmit
    for (int i = 0; i < PAPC_CACHE; i++)
        if (c->cache[i].used && c->cache[i].seq == seq) return &c->cache[i];
    return NULL;
}

static void top_up(pap_client_t *c)
{
    while (!c->src_eof && !c->cancel && c->staged < sizeof c->stage) {
        int eof = 0;
        size_t n = c->ops.read ? c->ops.read(c->ops.ctx, c->stage + c->staged,
                                             sizeof c->stage - c->staged, &eof) : 0;
        c->staged += n;
        if (eof || !c->ops.read) c->src_eof = 1;
        if (!n) break;
    }
}
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
