wr/airwriter/(commit log)

2026-08-04 Scaffold AirWriter repo from build spec
    Lays out hardware/firmware/tools per spec section 6, consolidates the two
    stray empty KiCad stubs into hardware/airwriter/, and records the spec as
    docs/SPEC.md so the unverified-assumptions list stays with the code.
    kicad-cli 10.0.2 lives outside PATH; noted in AGENTS.md.
2026-08-04 Add Kycon KMDGX-8S-BS mini-DIN-8 footprint and shielded symbol
    KiCad 10 stock has a Mini-DIN-8 symbol but no mini-DIN footprint at all, and
    the stock symbol has no shield pin — the spec needs one to star-ground the
    shell through a 0R + 1nF.
    Footprint geometry is taken from Kycon engineering drawing KMDGX-xS-BS rev C6
    (ECO#18-013), 8-position 'Recommended PCB Layout (Top View)', not from memory.
    Pin 7 sits at +0.90 from the centreline while pin 2 above it sits at +1.30 —
    the row is deliberately asymmetric, which is easy to get wrong by eye.
    Refs: W-568
2026-08-04 Place all 36 schematic symbols with footprints assigned
    Swaps U2 from MAX3491 (SOIC-14) to MAX3490 (SOIC-8): the spec tied DE high and
    RE low permanently, so the enable pins were dead weight, and the MAX3490 ships
    with a verified pinout in KiCad's stock library. analog.com is unreachable from
    this machine, so drawing a MAX3491 symbol would have meant guessing a 14-pin
    transceiver pinout.
    Polarity swapping is four 3-way solder jumpers (JP1-JP4), one per differential
    line, rather than two per pair — pin 2 common to the connector, pins 1/3 to the
    transceiver, default bridged 1-2.
    Sheet is A3; nothing is wired yet. ERC parses clean with 179 unconnected-pin
    violations, all expected at this st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
2026-08-04 Wire the schematic; ERC clean with zero errors
    33 signal nets. Notable choices:
    - UART1 on IO17/IO18 with CTS on IO8, clear of the strapping pins and of the
    flash/PSRAM pins the WROOM-1 keeps internal.
    - Bring-up header J3 carries the S3's native USB (GPIO19/20, exposed on the
    module as USB_D-/USB_D+) plus 3V3 and GND, per spec 2.5.
    - Receiver bias pulls A high and B low so an idle line reads as marking at RO.
    All three of R5/R6/R7 stay DNP.
    - R9 (0R, DNP) added: the spec wanted T1 wired to HSKi but not populated, and a
    DNP series resistor is the way to express that without leaving U3's T1OUT
    driving the printer by default.
    - USBLC6 sits on VBUS only. USB-C is power-only here, so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
2026-08-04 Board outline 30x45mm, M2 mounting holes, design rules
    Spec targeted 55x35mm (1925 sq mm); this is 1350, about 30 percent smaller,
    per the request to make it as compact as possible. Sizing is driven by three
    parts that cannot shrink: the WROOM-1 module (18mm wide, antenna overhanging
    the top edge), the mini-DIN body (14 x 13.5mm on the bottom edge), and the
    USB-C receptacle beside it. Passives go on the back to keep the top face free
    for the module and the two connectors.
    Design rules set to 0.15mm track and clearance with 0.3/0.6mm vias — standard
    JLCPCB capability, no premium process needed.
    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
2026-08-04 Import footprints to the board; fix malformed mini-DIN footprint
    F8 pulled in 35 of 37 parts. The two it dropped, and why:
    - R9 had no footprint assigned. It was added to the schematic after the batch
    that set footprints, so it never got one. Assigned R_0603.
    - J2 was skipped because the generated .kicad_mod carried unescaped double
    quotes inside its (descr ...) string, which makes the s-expression malformed.
    KiCad failed to load the footprint and dropped the part silently. Rewrote the
    descr and added a balance check.
    Both are now on the board with their nets, injected directly rather than
    costing another GUI round trip. 41 footprints total, board loads clean.
    Project library tabl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
2026-08-04 Ignore KiCad 10's .history auto-versioning directory
    It is its own git repo, so it was being added as an embedded repository.
2026-08-04 Place the board; clear every DRC error except silkscreen
    Board is 32 x 54mm (1728 sq mm) against the spec's 55 x 35 (1925). The floor is
    set by three parts that cannot move: the WROOM-1 needs 18 x 19.5mm of board with
    its antenna overhanging the top edge, and the mini-DIN body reserves the whole
    bottom 13.5mm, with the USB-C receptacle beside it.
    Placement was done against measured courtyard extents rather than datasheet
    guesses, which caught two things worth noting:
    - SW1's B3S-1100 footprint has a 10 x 8.9mm courtyard, much larger than the
    4.5mm tactile the spec assumed. It now sits in the pocket right of the DIN.
    - The WROOM-1 courtyard is 48 x 41mm because it includes the antenna kee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
2026-08-04 Finish placement: DRC down to 6 benign violations
    - Swapped SW1 from B3S-1100 (10 x 8.9mm courtyard) to B3U-1000P (4.8 x 3.4mm).
    The big switch had become the binding constraint on the pocket beside the
    mini-DIN; the small one frees it entirely.
    - Moved every reference designator from F.SilkS to F.Fab. At this density the
    silkscreen text was unreadable and generated 75 of the 82 violations. The
    designators still print on the assembly drawing.
    - J2 carried both a legacy (fp_text reference "REF**") and a modern Reference
    property, so the render showed REF**. Stripped the legacy text from the board
    and the library module.
    - J1 pulled back to sit flush with the board edge instead of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
2026-08-04 Ground plane, BOM with real DNP flags, fab exports, hardware README
    - GND zone on B.Cu across the board.
    - DNP is now a real symbol flag on R5/R6/R7/R9 rather than the word 'DNP' glued
    into the value string, so the BOM's DNP column is populated and an assembler
    will actually skip them. BOM is grouped by value+footprint+DNP, otherwise R8
    (populated 0R) and R9 (DNP 0R) merge into one misleading line.
    - Exported BOM, pick-and-place, layer SVG, board stats, top render.
    - README documents the size derivation, the 6 accepted DRC violations, the
    routing hand-off, and three MCP tool traps that corrupt this project.
    Gerbers deliberately not exported: the board is not routed, so they would be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
2026-08-04 Route the board via Freerouting: 0 unconnected
    571 segments across both layers, 58 vias at 0.6/0.3mm. Every net connected.
    Committing the raw router output before cleanup so there is a restore point.
    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
2026-08-04 Clean up the routed board: DRC 278 -> 3, zero unconnected
    The GND pour was never connected. add_zone created it on net "GND" while every
    pad sits on "/GND" — KiCad's hierarchical name carries a leading slash. The
    zone had been floating copper since it was added, and DRC surfaced this as 28
    isolated-copper islands rather than as a disconnected zone.
    Also fixed:
    - Design rules had reverted to KiCad defaults when the project was reopened,
    putting min_through_hole_diameter back to 0.3mm and flagging the WROOM-1's
    0.2mm thermal vias. Re-applied.
    - U1's antenna keepout polygon was stranded 46mm off the board. Footprint zones
    store absolute coordinates, so the scripted placement moved the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
2026-08-04 Resolve assumption 3: spec 2.4's receiver polarity is backwards
    Apple's convention, from two Mac serial references: a binary 1 is represented
    when TxD- is more negative than TxD+, and the RxD pair reads the same way. So
    the + line is non-inverting — at mark, TxD+ is high and TxD- is low.
    MAX3490: RO high when A > B; DI high drives Y high, Z low.
    Driver path is right as specced. Idle TX high gives Y high and Z low, so
    Y->pin 8 (RxD+) and Z->pin 5 (RxD-) presents a mark to the printer.
    Receiver path is inverted. Spec maps A<-TxD- and B<-TxD+, which holds A low at
    mark, so RO idles low and every byte arrives inverted. It should be A<-pin 6
    (TxD+) and B<-pin 3 (TxD-).
    The board follows the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
2026-08-04 Remove the polarity jumpers and fix the receiver mapping
    Two changes that belong together.
    Receiver polarity was inverted. Apple's convention is that a binary 1 has TxD-
    more negative than TxD+, so the + line is non-inverting. The MAX3490 needs
    A > B at mark, which means A<-TxD+ (pin 6) and B<-TxD- (pin 3). The spec had
    these swapped, so every received byte would have arrived inverted.
    JP1-JP4 deleted. They existed as insurance against exactly the polarity question
    above, but the ESP32 UART already provides it: uart_set_line_inverse() with
    UART_SIGNAL_TXD_INV / UART_SIGNAL_RXD_INV. Inverting DI flips Y and Z together,
    which is electrically identical to swapping the differential pair, and t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
2026-08-04 Re-route after jumper removal: 470 segments, 64 vias
    Restore point before stitching-via cleanup. 7 GND connections still open and
    one via too close to the board edge.
    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
2026-08-04 Finish the re-route: every pad connected, fab outputs regenerated
    Freerouting left 7 open GND connections. Root cause was the ground plane, not
    the router: 99 new B.Cu signal traces had carved the pour into electrically
    separate regions, so vias that looked stitched were landing on islands that no
    longer reached each other.
    Fixed by pouring GND on F.Cu as well, which is the normal answer on a dense
    two-layer board. That took the open connections from 7 to 3 and, more to the
    point, removed every pad-level and track-level break. Coverage is now 840mm² on
    top and 1270mm² on the bottom over a 1728mm² board.
    Also:
    - Two stitching vias added where F.Cu ground stubs had no path to the plane.
    -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
2026-08-04 Target PCBWay: pull the board back into the standard drill tier
    PCBWay's standard minimum drill is 0.30mm and 0.20mm is an upgraded spec that
    costs a lot more — a documented case went from $5 to $65 for ten boards.
    KiCad's stock ESP32-S3-WROOM-1 footprint puts twelve 0.20mm thermal vias in its
    ground pad, and they were the only sub-0.30mm holes on the board. Enlarged to
    0.30mm; the 0.6mm pad still leaves a 0.15mm annular ring, and every real via was
    already 0.30mm. Smallest drill is now 0.300mm across the whole board.
    The edit is in the board file rather than the library, so re-importing U1's
    footprint will put the 0.20mm drills back. That is also why U1 now shows a
    library mismatch in D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
2026-08-04 Add the LocalTalk section: TashTalk PIC + SN65HVD1473 + second mini-DIN
    Mode 3. AirWriter becomes the AppleTalk option card the ImageWriter never had:
    AirPrint on one side, a real LocalTalk bus on the other.
    Wiring is copied from FeralFirmware/TailTalk's TashTalkUSB, which runs
    lampmerchant's TashTalk firmware, rather than derived from the prose README.
    I pulled their KiCad netlist and matched it node for node:
    LT_DATA PIC RA5 <-> transceiver RO and DI, 10k pull-up (their U2.2/U3.1/U3.4/R14)
    LT_DE PIC RA4 -> transceiver RE and DE tied together (their U2.3/U3.2/U3.3)
    A/B/Y/Z through 10R series into DIN pins 5/8/3/6 (their R8-R11)
    PIC RA2 -> host CTS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
2026-08-04 Place the mode 3 board: 52 x 54mm, placement clean
    50 footprints on a 52 x 54mm board. Bottom edge carries both mini-DINs and the
    USB-C; the LocalTalk section (PIC, transceiver, series resistors, ICSP header)
    sits in the freed area right of the module.
    DRC down to 7, all cosmetic: 3 library metadata mismatches, 2 silkscreen over
    the edge where the module overhangs, 2 silkscreen overlaps. Schematic parity
    clean apart from the four mounting holes, which are mechanical.
    Fixes this pass:
    - Restored the board outline. KiCad reverted it to the old 32mm rectangle when
    the project was reopened for the import, the same way it reset the design
    rules earlier. My file edits do not survive a KiCad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
2026-08-04 Route mode 3, round the corners, add the wordmark
    Your Freerouting pass landed 427 segments and 35 vias. Cleanup on top:
    - Board min_clearance was 0.15mm while the Default netclass was 0.12mm, so
    Freerouting routed to 0.12 and DRC then flagged 129 of its own tracks.
    Aligned the board minimum to 0.12. PCBWay's floor is 0.076mm.
    - 3mm corner radii, which the spec asked for and the outline never had.
    - AirWriter wordmark and rev A on the front silkscreen; PRINTER, LOCALTALK and
    5V IN port labels plus a TashTalk credit on the back.
    - Back-silk text was unmirrored, which would have read backwards on the real
    board. Fixed, and moved the credit clear of J5's pads.
    DRC is 5: three library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
2026-08-04 Swap the LocalTalk transceiver for two commodity half-duplex parts
    Verified sourcing properly this time, on LCSC rather than Digi-Key.
    The printer-port transceiver needed no change at all. MAX3490ESA+T is $0.687 at
    qty 10 on LCSC with 3,788 in stock. My $6.61 figure was Digi-Key. That part of
    the cost problem was a sourcing mistake, not a part-choice mistake.
    The LocalTalk transceiver did need changing, and not only for price. Every
    full-duplex RS-422 part with driver and receiver enables that I checked is out
    of stock on LCSC: ISL3177EIBZ ($3.39) and MAX3491ESD+ ($1.56) both zero.
    Full-duplex RS-422 is niche; half-duplex RS-485 is commodity.
    So U6 is now two SP3485EN-L in SOIC-8, $0.21 e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
2026-08-04 Place the split transceiver, reflow the LocalTalk corner
    Two SOIC-8 parts where one MSOP-10 used to be, so the whole right-hand column
    moved: PIC, driver, receiver stacked vertically with their passives beside them
    and the series resistors dropped to a row below.
    Stale routing ripped up, since 427 segments and 35 vias still referenced the
    removed part's pads.
    J5 separated from mounting hole H2 and the wordmark moved off U5.
    DRC 3, schematic parity clean. Ready to route.
    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
2026-08-04 Put the wordmark in a measured free region
    Correction to the previous commit message: DRC was 7 after that change, not 3.
    The wordmark had landed on U2 after the reflow, and I had been repositioning it
    by eye. Computed the free space from every footprint courtyard instead and
    placed it at the centre of the one 15x5mm gap that exists.
    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
2026-08-04 Rev A complete: routed, verified, fab package generated
    434 segments, 34 vias, every component pad connected. DRC 5, all cosmetic.
    Board is 52 x 54mm two-layer with both mini-DINs and USB-C on the bottom edge.
    44 populated parts plus 4 DNP. Smallest drill is 0.300mm, so it stays in
    PCBWay's standard tier.
    Design rules and board outline both survived this import, unlike the previous
    two rounds.
    The 15 unconnected are all pour-fragment to pour-fragment. I checked each
    fragment for a GND anchor and every one has a pad or via, so this is zone
    contiguity, not floating copper. Nothing involving a pad or a track remains.
    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
2026-08-04 Add handoff doc
    Current state, every deviation from the spec and why, the status of the five
    unverified assumptions, the traps that cost time, sourcing with verified LCSC
    prices, the projects this builds on, and the next actions in dependency order.
    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
2026-08-04 Resolve two unverified assumptions from the ImageWriter II Technical Reference
    Bit order and the density escape codes are both settled from Apple's own
    manual, cross-checked byte for byte against Ghostscript's gdevadmp.c.
    Bit 0 is the top pin, and ESC p is 144 dpi where ESC P is 160.
    Also narrows assumption 4 with the DTR handshake thresholds and timing,
    and archives the two reference PDFs the research came from.
2026-08-04 Settle initial printer support scope
    v1 is the ImageWriter II over serial. StyleWriter and ImageWriter LQ are
    cut, both on consumables rather than protocol: nobody has made a
    StyleWriter print head since about 2005, and LQ ribbons are gone.
    LocalTalk is second rather than cut. Its job goes out through the serial
    port, so that path has to work first, and the option card takes the plain
    escape stream wrapped in PAP - same bytes, same fixtures.
    No printer-driver abstraction. The StyleWriter was the only candidate that
    differed structurally, so with it cut the capability data goes in one
    struct and nothing needs a vtable.
2026-08-04 Add the implementation plan for the host raster pipeline
    Nine tasks covering M2: decode URF, resample onto the 144x72 grid,
    halftone, transpose, emit, plus a stub IPP server to capture a real job
    from an iPhone.
    Every code block in tasks 1-8 was extracted and compiled under -Werror
    before committing, which caught a resampler bug that discarded every
    source row not completing a target row, a const-qualifier mismatch C
    rejects where C++ would not, and three -Wmisleading-indentation errors.
    The hand-computed Atkinson test vector was also wrong and is now derived
    from a single-column case where it can be checked by hand.
2026-08-04 Add 32-bit overflow guard for URF width/height
    On 32-bit targets (ESP32-S3), width * bits_per_pixel can wrap, producing
    a small buffer and silently wrong decoding. Guard dimensions at 65535 to
    prevent overflow while still accommodating the printer's real 1152-dot limit.
2026-08-04 Fix RLE decoder: reject malformed overruns, add height-limit test
    CRITICAL: The original code clamped runs that overran a line boundary,
    leaving unread bytes that desynchronized every subsequent line on
    corrupt input. Runs never legitimately cross a line boundary, so now
    return URF_ERR_MALFORMED instead.
    - Added URF_ERR_MALFORMED (-4) error code to the header
    - Both LITERAL and REPEAT branches reject overruns instead of clamping
    - Removed unreachable dead code (tail memset)
    IMPORTANT: Added test cases for:
    - LITERAL run overrunning the line
    - REPEAT run overrunning the line
    - Height limit overriding line-repeat byte (the spec's escape hatch)
    Test count: 45 checks across three binaries, al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
2026-08-04 Add a streaming resampler for the printer's dot grid
    The ImageWriter is 144 dpi across and 72 dpi down, and iOS sends whatever
    it likes, so the scale factors differ per axis. Box filter down, replicate
    up, one destination row held at a time.
2026-08-04 Fix round 1: document contract, add upscale tests
    Extend the header comment with the resampler contract: caller must push
    exactly src_h rows, or trailing destination rows won't be emitted. Add two
    test cases exercising horizontal upscaling and mixed-axis scaling (the real
    case for the printer's 144 dpi horizontal, 72 dpi vertical grid).
2026-08-04 Add halftoning with Atkinson, Floyd-Steinberg, Bayer and threshold
    Atkinson is the default. It spreads six eighths of the error rather than
    all of it, which is what holds contrast on a device with no ink density
    control.
2026-08-04 Add Kycon 3D model for the mini-DIN ports
    KiCad ships no mini-DIN model, so board STEP exports had two holes where
    J2 and J4 should be, which makes the enclosure impossible to gauge.
    Kycon publishes the official rev C6 STEP on an Extranet path that the
    product page does not link to. Attached to the footprint at
    rotate -90 0 180, verified by rendering the board from below: all eight
    pins and all three mounting posts sit centred in their holes.
    The model carries the same asymmetric lower pin row as the footprint
    (pin 7 at +0.90, pin 2 at +1.30), confirming the hand-drawn geometry.
2026-08-04 Fix unclamped error diffusion and add Floyd-Steinberg validation test
    Remove clamping before error computation in Atkinson and Floyd-Steinberg.
    Published algorithms derive error from unclamped accumulated value; clamping
    here discards error when pixels overshoot, losing detail in extremes.
    Add FS kernel test with width 3, row {255, 128, 255} to catch miscoded weights.
2026-08-04 Add the ImageWriter output stage
    Bit 0 is the top pin, ESC G takes four ASCII digits, and every page ends
    with a form feed. All three are cited to the technical reference in the
    header, because all three are wrong in most circulating documentation.
2026-08-04 Restore the USB-C port to the 3D export
    KiCad 10 ships the HRO TYPE-C-31-M-12 footprint but not its 3D model,
    and the footprint points at a KICAD10_3DMODEL_DIR path that does not
    exist. J1 was therefore missing from every STEP export with no warning
    at all. Upstream kicad-packages3D does not carry it either.
    Model taken from NabuCasa/yellow-3dshapes. Its origin is a corner rather
    than the footprint centre, so it needs rotate -90 0 0 with offset
    -4.47 -3.65 0. Derived by matching shield-tab and leg spacings to the
    pads, confirmed by render: all six through-board features seat in their
    holes, and the shield tabs are asymmetric enough to rule out a
    180-degree error.
    Also checked every other m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
2026-08-04 Wire the raster pipeline into a rip binary
    Decode, resample onto the 144x72 grid, halftone, transpose, emit. The
    byte-for-byte regression against a committed stream is the point of the
    whole tool.
2026-08-04 rip: don't paper over truncated pages, fix OOM leak paths
    A mid-page decode error still got a form-feed terminator, making a
    corrupt stream.bin look complete to a caller that ignores the exit
    status. Route every page-loop exit through one cleanup path instead
    of three ad-hoc breaks so allocation failures on ht_init/rs_init/
    calloc can no longer leak, and only call iw_end_page when the page
    actually finished. Also log when a page's width gets silently
    clamped to IW_MAX_DOTS.
2026-08-04 Add status LEDs, mode button and I2C header to the schematic
    D2 chains off D1's DOUT, so the second addressable LED costs no GPIO —
    one LED can show network state while the other shows the printer link,
    which a single RGB has to serialise into blink codes.
    D3 is a plain green LED across the 3V3 rail with no GPIO at all. During
    bring-up it separates 'board is dead' from 'firmware is dead'.
    SW2 sits on IO14 rather than sharing IO0 with SW1: IO0 is a strapping
    pin, so holding it at reset means USB download mode and it cannot also
    mean 'hold to do something else'. C19 mirrors the SW1/C7 debounce.
    J6 is a 4-pin JST-SH on IO15/IO16 with 4.7k pullups, Qwiic pin order.
    A display module plugs in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
2026-08-04 Move the new IO to pads on U1's near edge
    IO14/15/16 were picked before checking where they physically land: IO15
    and IO16 come out on the WROOM's far-left edge, which would have meant
    40mm runs across the densest part of the board to reach a connector in
    the top-right corner.
    IO36/37/38 sit on U1's right edge facing the new block, roughly 23mm
    away with an open corridor. Available because the module is an N8R2 with
    quad PSRAM, where GPIO33-37 are free; IO35 is already used for HSKI_DRV
    on the same basis.
    SDA=IO36, SCL=IO37, button=IO38. ERC still clean.
2026-08-04 Place the indicator cluster and UI parts on the board
    D1 moves from mid-board to (135, 97.5) and D2 sits beside it at
    (138.5, 97.5), so one light-pipe part covers both. D3 and its resistor
    go just above them; C20 decouples D2 below. The whole group sits in the
    open band behind the mini-DINs, clear of the LT_PORT and PR_RXD runs.
    J6, SW2 and the pullups take the top-right corner, the only other real
    free space on a board this full.
    Three placements had to move after DRC disagreed with my own clearance
    check: J6's mounting pegs sat on a diagonal 3V3 track, and R18 fouled
    H2's courtyard. The checker was missing pads whose bodies did not match
    a narrow regex, and was ignoring fp_circle courtya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
2026-08-04 ippcap: parse the IPP TLV structure to find the document
    Print-Job located the document boundary by searching for a raw 0x03
    byte, which a crafted or unlucky attribute value can contain before
    the real end-of-attributes tag — producing a silently wrong capture
    with no error. find_document() now walks delimiter tags and
    length-prefixed attributes explicitly and only stops at a genuine
    end-of-attributes tag, raising a clear error on a malformed body
    instead of mis-parsing or crashing.
2026-08-05 Import the routed session and fix U1's stale pad nets
    Freerouting's session lands 7 of the new connections. Five gaps remain:
    three on 3V3, the D1-to-D2 chain, and SCL into U1.
    U1 pads 29/30/31 still carried unconnected- placeholders from before the
    move to IO36/37/38. The schematic and the exported DSN both had the real
    nets, so Freerouting routed to those pads correctly and DRC then read the
    result as a short. Schematic parity did not catch it, which is worth
    knowing: it does not compare pad-level nets against placeholders.
    DRC clean again with zones refilled.
2026-08-05 rip: add a Letter-page fixture generator for the margin-crop path
    checker.urf is 2in wide at 144dpi, so it never exercises main.c's new
    0.25in-margin crop (a US Letter page arrives 1224 dots wide, 72 over the
    1152-dot printable width). This sibling generator writes a 2550x3300
    @300dpi page with solid black in the outermost 0.25in on each side and a
    distinct vertical bar, so the crop and the resulting column mapping can be
    checked by hand against main.c's arithmetic. Not a second regression
    target -- just a repeatable way to exercise the path.
2026-08-05 Capture a real iPhone job: iOS honours RS72-144
    It rendered at exactly 144 dpi rather than sending 300, so no downsample
    fallback is needed. The raster is the full 8.5in media width, meaning the
    margin crop is on the normal path rather than an edge case.
2026-08-05 Automate the Freerouting round trip and rebuild the UI strip
    The board grows to 64 x 54mm. All the controls now sit in one column down
    the new right-hand edge: the I2C connector at the top opening off the
    board so a cable has somewhere to go, both buttons together beneath it,
    and the three LEDs in a row at the bottom. Front silkscreen labels them
    I2C, BOOT, MODE, PWR, NET, JOB. The previous placement was whatever an
    automated first-fit search could squeeze in, and it looked it.
    route.py replaces the manual GUI round trip. kicad-cli lost Specctra
    export and import in KiCad 10, but the pcbnew Python module kept both, so
    the whole loop runs headless in about 35 seconds.
    It rounds the DSN coor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
2026-08-05 Regenerate the fab package for the 64 x 54mm board
    Gerbers, drill, position file, BOM and the 3D STEP all rebuilt from the
    widened board. Drill floor re-checked: nothing below 0.300mm, so this
    still orders at PCBWay's standard spec.
    SPEC and HANDOFF carried the old 52 x 54 outline and listed only D1.
2026-08-05 Settle the mini-DIN: Kycon KMDGX-8S-BS from Mouser
    Digi-Key is backordered; Mouser holds 1032 and ships now. It is the part
    the footprint was drawn from and checked against Kycon's STEP model, so
    there is no geometry risk for the sake of a couple of dollars.
    Also records why the four alternatives were rejected, and resolves the
    pin-numbering discrepancy against the DIN-802 footprint: ours is right,
    theirs is mirrored.
2026-08-05 Grow the board on the right axis and label the whole front
    The board is 52 x 66mm. The previous change widened it, which was the
    wrong axis: every port sits on one edge, so the room has to come from
    the axis those ports run along. Width is back to 52 and the height
    carries the extra 12mm.
    All three front connectors now put their mating faces on the board edge.
    They were never coplanar — the mini-DINs stood 1.25mm proud of the edge
    and the USB-C sat 0.55mm behind it, and no single case wall can meet a
    1.8mm spread.
    The controls sit in the band the ports vacated: LEDs, then both buttons,
    then the I2C header at the right. Front silkscreen now names every IC by
    what it does rather than by re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
2026-08-05 Regenerate the BOM with manufacturer part numbers
    The previous export carried only Reference, Value and Footprint, which is
    not enough for a turnkey assembler to buy anything. Adds MPN,
    Manufacturer, Description, Qty and DNP columns.
2026-08-05 Space out the controls and cut the silkscreen back to designators
    Ports move 2mm past the board edge so their faces land flush with the
    outside of a printed case wall rather than flush with the PCB.
    The buttons now straddle the board centreline at 122 and 130, the LEDs
    open up from 3.4mm to 5mm pitch, and the two I2C pullups move out of the
    space a plug needs.
    Silkscreen goes back to reference designators. The functional names were
    too wordy and several of them landed on top of parts. Only the controls
    a user actually touches keep a word: PWR, NET and JOB over the LEDs,
    BOOT and MODE over the buttons, plus the port names. Designators sit
    below those parts so the two never collide.
    J1 also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
2026-08-05 Fill in the missing manufacturer part numbers
    J4, U6, U8, U7, D2, SW2 and J6 had no MPN, which would have stalled a
    turnkey quote. J5 and D3 are marked Manufacturer=Any, following the
    convention J3 already used, so they read as deliberately generic rather
    than forgotten.
    ERC is unchanged: 4 lib_symbol_mismatch warnings, 0 errors, the same four
    symbols as before. Those warnings pre-date this commit.
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2026-08-05 Stand up the ESP-IDF project and build it for the target
    ESP-IDF v5.5.1 lives at ~/esp/esp-idf with tools for esp32s3 and esp32c6.
    The four raster components claimed to compile under ESP-IDF unchanged and
    nobody had ever checked; they do, and the project now links a 200KB image.
    main.c is a bring-up stub. It runs the halftone and imagewriter path once
    over a gradient so a target build proves those components execute, not
    just compile, then idles.
    sdkconfig is split per target because the only devkit on hand is a C6 and
    the board is an S3. The C6 has no PSRAM, which makes it the stricter of
    the two for memory -- an allocation the S3 would absorb fails there first.
    Refs: W-565
2026-08-05 M4: IPP server, printer attributes and mDNS discovery
    The codec is deliberately free of ESP-IDF: ipp_enc, ipp_attrs and the
    request parser are plain C, tested on the host under tools/ipp with 316
    checks. Only the esp_http_server transport needs a device.
    Attribute choices that decide whether iOS lists the printer at all, and
    fail silently when wrong:
    - the _universal subtype on _ipp._tcp, without which the print sheet
    never shows the queue however correct the rest is
    - urf-supported carrying RS72-144, which the real iPhone capture proved
    the phone honours
    - honest 6.35/12.7mm margins, because the tractor feed cannot reach the
    edge and a borderless claim gets laid out edge to edge and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
2026-08-05 Lay the board out block by block and clear the passive designators
    The old placement sorted parts by type, not by function. Twenty passives sat in
    three rows across the middle of the board with no relation to the chips they
    serve -- the USB-C CC pulldowns were 40mm from the connector, the MAX3232 charge
    pump caps were nowhere near it -- while the bottom-right quadrant was empty.
    That is what made the board read as cramped and sparse at the same time.
    Every block now sits with its chip. ESP32 rail under U1. LocalTalk digital top
    right. Printer analog above the printer port, LocalTalk line drivers above the
    LocalTalk port, the power chain above the USB-C. UI strip is a band above the
    ports. M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
2026-08-05 Say which half of the network join failed
    A station that associates and never gets a lease logged nothing at all,
    which reads exactly like a wrong password. It now reports the disconnect
    reason code and, every five seconds, that it is associated with no lease.
    Also disables WiFi power save. A mains-powered printer gains nothing by
    dozing between beacons, and it has to answer an mDNS query the moment it
    arrives; some APs also drop the unicast DHCP reply to a sleeping station.
    Sets SAE hash-to-element, which WPA3 access points may require.
    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
2026-08-05 Stitch the ground pour with 44 targeted vias instead of 82 scattered ones
    The first stitching pass was a blanket 2mm grid. Measuring it showed the grid was
    doing almost none of the work: it mostly dropped vias into pour fragments that
    were already tied down and missed the small ones that needed it.
    stitching vias front pour fragments left unjoined
    0 14
    8 one per fragment 8
    22 blanket 5mm grid 12
    44 one per fragment plus a 5mm grid 8
    82 blanket 2mm grid 9
    stitch.py now places one via per fragment first, at the roomiest point inside it,
    then fills a 5mm lattice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
2026-08-05 Replace esp_http_server with a socket transport for IPP
    esp_http_server cannot receive a chunked request body. It implements
    chunked responses only; for a chunked request it reports content_len 0
    and httpd_req_recv then returns 0 forever, so the document is
    unreachable. There is no public API to drain the bytes its own header
    parser already buffered either, so the framework cannot be worked
    around from outside.
    That is not an edge case. CUPS sends Print-Job chunked with Expect:
    100-continue, and SPEC.md 3.4 said as much before any of this was
    written. Every real job would have failed.
    ipp_http.c now does the framing: request line, headers, a body reader
    that hides the identity/chunked dist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
2026-08-05 Stop the BOM telling an assembler not to fit R8, R18 and R19
    The BOM grouped rows by value and footprint but not by the DNP flag, so parts that
    share a value merged across it and the whole row took the DNP label:
    "R8,R9" 0R DNP -- R8 is not DNP
    "R6,R7,R18,R19" 4.7k DNP -- R18 and R19 are not DNP
    Built as ordered, that leaves the printer port's shield ungrounded and the I2C bus
    with no pullups. Only R5, R6, R7 and R9 are DNP, and they are the fit-if-needed
    options on the printer port: 120R termination, the 4.7k failsafe bias pair, and the
    0R that would let the MAX3232 drive the printer's HSKi.
    Regenerated with DNP in the group-by, so the four DNP parts sit in thei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
2026-08-05 M5: rip real jobs on the device, byte-identical to the host
    The page loop moved out of tools/rip/main.c into a ripjob component, so
    the firmware and the host harness now run the same code. That is what
    makes the byte-for-byte fixture regression mean anything for the device:
    the host tool is a thin CLI over it and its output did not change by a
    single byte.
    job_pipe bridges the two halves. ipp_server pushes bytes off the socket;
    urf_decode pulls them through a callback. A stream buffer sits between,
    with the pipeline on its own task. When the buffer fills the push
    blocks, the socket stops being read, and TCP applies backpressure -- the
    printer's speed ends up throttling the phone, which is w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
2026-08-05 Check the whole BOM against LCSC stock before ordering
    Every named part sources and nothing is short. Prices and stock verified today,
    LCSC unless noted, recorded in the handoff sourcing table: the module, both RS-485
    transceivers, the MAX3490 and MAX3232, the LDO, the ESD array, the WS2812Bs, the
    USB-C, the JST SH and both Omron switches. About $13 of parts per board, $5 of
    which is the two Kycon mini-DINs from Mouser.
    Two things worth knowing before ordering:
    J3 and J5 are the only awkward line. LCSC does not stock 1.27mm single-row male
    headers as 1x4 or 1x5, only strips -- buy C28952 or C3408 and cut. Neither has to
    be fitted: J3 is bring-up only and the PIC can be programmed off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
2026-08-05 serial_out: the printer port, ready for a board
    UART1 at 9600 8N1 with the printer's HSKo on CTS, so the peripheral
    stalls its own FIFO while the printer is busy -- no polling loop and no
    software watermark, as SPEC.md 3.9 asks.
    That same line is the paper sensor. An ImageWriter deasserts HSKo
    constantly and briefly while the head returns; only a stall that
    outlasts the watchdog means paper. When it does, printer-state-reasons
    becomes media-empty and printer-state stopped, which surfaces as a real
    alert on the phone rather than a job that quietly never finishes.
    Pins come from the board netlist, not from memory: TX IO17, RX IO18,
    CTS IO8. Line inversion is exposed in Kconfig because the di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
2026-08-05 M6: settings, web UI, captive-portal provisioning, OTA, cancel
    Provisioning is a SoftAP captive portal, not Improv over BLE as SPEC.md
    3.1 called for. Improv needs Web Bluetooth, which Safari on iOS does
    not implement and is not going to, so on the one platform this printer
    exists for it cannot work at all. The device now brings up its own
    access point when it has no credentials or cannot join, answers every
    DNS query with its own address, and the setup page opens by itself. No
    app, and it works from a phone.
    Everything a user can change now lives in NVS and beats the Kconfig
    build defaults: network, hostname, queue name, dithering.
    The partition table gained a second app slot. A printer t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
2026-08-05 Fall back to the setup portal when a network gives no address
    Associating and never getting a lease is a real state, not a hang: a
    network that admits the device and then drops its traffic looks exactly
    like this, and the home network does it to this MAC every time.
    The wait was unbounded, so the device sat there forever. Nothing was
    listening, the setup portal never came up, and the only way back was a
    USB cable -- which a user does not have. It now gives up after 60
    seconds and brings up the access point, which is the whole point of
    having one.
    Found by switching the devkit to the home network from the web UI, which made
    it disappear with no way to reach it.
2026-08-05 Grow the board to 52 x 78mm and open a band for artwork
    Twelve millimetres inserted between the ESP32 row and the transceiver row, giving a
    clear 50 x 12mm strip at y 86 to 98 for a logo and whatever else wants silkscreen.
    Every footprint below y=87 moved down 12mm; nothing above it moved, so the antenna
    keepout, the three front connectors and their 2mm proud stand are untouched.
    C9 and C14 travelled with the band rather than staying in the top row. They bypass
    U2 and U3, and leaving them behind would have put them 22mm from the chips they
    serve. They sit at the top edge of the lower block now, about 5mm from their pins,
    which is closer than before the board grew.
    The eleven footprints mov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
2026-08-05 Socket the PIC and drop the ICSP header
    U7 becomes a PIC12F1840-I/P in PDIP-8, seated in an 8-pin DIP socket, and J5 goes
    away. TashTalk gets flashed in a chip programmer before the part is inserted, so a
    PIC that will not take firmware never gets soldered down and there is no header
    that exists purely for a one-time factory step.
    MCLR now ties to +3V3. It was only ever wired to J5 pin 1, so with no programmer
    attached it was floating -- held up by nothing but the PIC's internal weak pull-up.
    There is no in-circuit programming left to protect, so no series resistor. This does
    give up TashTalk's reset-and-tristate feature, which only matters when something
    else shares the RS-422 driver; noth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
2026-08-05 Rework the Wi-Fi panel around the two states a user is actually in
    Wi-Fi moved to the top and status to the bottom. On a new device the
    network is the only thing that matters; status is reference, not an
    instruction.
    With no network the page scans on load and offers a dropdown, because
    choosing one is the only thing there is to do. With a network it shows
    what it is joined to in a plain field and leaves the radio alone until
    Scan is pressed. Scan always returns to the dropdown, which is what
    makes it the way back from a typed name.
    "Other..." switches to an autofocused text field, for hidden networks.
    The results used to land in a datalist, which Safari on iOS renders as
    essentially nothi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
2026-08-05 Give firmware a reset line to the LocalTalk chip
    MCLR on U7 was tied to +3V3, which is safe but leaves the PIC restartable only by
    unplugging the board. It now runs to the ESP32 on IO2 as net LT_RESET.
    This is worth having on a headless dongle. Firmware can recover a wedged TashTalk
    without a power cycle, and can hold the PIC in reset in the modes where LocalTalk is
    not the live transport. Driving the GPIO low asserts reset; leaving it an input --
    which is what it is through ESP32 boot -- lets the PIC's internal pull-up on MCLR
    run the chip. No external resistor needed.
    IO2 was chosen because it is a plain GPIO, not a strapping pin, not JTAG and not the
    boot console UART, and because it is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
2026-08-05 Design pass on the config page
    Picks a lane on naming. AirWriter is the bridge; the printer is an
    ImageWriter II, and that is what the print sheet shows, because a person
    choosing a printer is looking for the machine the paper comes out of.
    The model is now a dropdown that sets the queue name, the hostname and
    the name in the page together, with Other... for anything unlisted.
    The look is Snow White -- frog design's 1984 language for Apple: fog
    grey and white, thin recessed lines, tight radii, no ornament. Apple set
    product names in Garamond Light Condensed and interface text in a
    grotesque, so headings are serif and controls are not. No webfont is
    loaded, so the serif falls through what Ma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
2026-08-05 Widen the power rails and stop routing inside PCBWay's cost floor
    Two things came out of grading the autorouted board.
    The clearance rule was 0.12mm. PCBWay's own guidance is to keep trace width and
    spacing above 6 mil (0.15mm) or pay for an upgraded spec, and the router had used
    every micron it was given: raising the rule to 0.15 and re-running DRC turned up 98
    violations, all of them traces sitting between 0.12 and 0.15mm apart. Same shape as
    the 0.20mm drill trap already in the handoff -- a rule quietly permitting a spec
    nobody meant to buy, invisible until the quote comes back. Rule is 0.15mm now and
    the board re-routes clean against it.
    Everything on the board was also 0.2mm wide, inc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
2026-08-05 Wi-Fi panel: borrow the one every user already knows
    The network picker is now the list from iOS Settings rather than a
    dropdown -- current network on top with a tick, everything else in a
    scrolling list five and a half rows tall, each row carrying a signal
    glyph and a lock. Picking one is a tap, and Other... is the last row
    where it belongs. Scan spins while it works.
    Signal is the three-arc glyph everyone reads as Wi-Fi, not cell bars.
    The scan API now returns rssi and whether a network is secured, so both
    are drawn from real values instead of a word.
    Dropped band and cipher from the connected row. Neither changes
    anything a reader can act on once the thing is joined, and 2.4 GHz was
    nev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
2026-08-05 Rebuild the page as a device panel instead of a settings form
    Four boxed sections of equal weight, each a stack of labelled fields, is
    a form. It competes with itself and buries the one thing a person opens
    this page to learn.
    There are two moments and they want different pages. Setup happens once,
    on a phone, with no network -- so nothing except choosing one matters,
    and the page is now the network picker with everything else absent.
    Every later visit is a glance: is it working, did my page print. That is
    the hero line, readable across a desk.
    So: one hero, one list, one footer. The list is three rows -- Network,
    Printer, Dithering -- showing their current values and opening in place
    the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
2026-08-05 Move the regulator next to the ESP32 so 3.3V stops daisy-chaining
    Freerouting routes a power net like any other signal -- nearest unconnected pad,
    repeat -- so the 3.3V rail was one chain 235mm long, with the loads strung along it.
    With U4 sitting by J1 in the bottom right and the ESP32 in the top left, everything
    was downstream of everything else.
    U4 moves up beside U1, taking C1, C2 and C3 with it. U5 and the CC pulldowns stay at
    J1: ESD clamping and USB-C configuration belong at the connector. VBUS makes the long
    diagonal now instead of 3.3V, which is the right way round -- 5V into an LDO with
    300mV of dropout does not care about 30mV of trace drop, and the 3.3V rail does.
    Distance from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
2026-08-05 Make the USB-C an actual USB port
    Spec 2.5 read "USB-C is power only. Flashing and console go over the S3's native USB
    peripheral on GPIO19/20 -- expose those on a 4-pin 1.27mm header for bring-up." The
    result was a USB connector on the front panel with its data pins tied off, a debug
    header nobody can reach without a custom cable, and a two-line USB ESD part sitting
    there with four of its six pins no-connected.
    D+ and D- now run from J1 through U5 to the S3's native USB peripheral. Both flip
    orientations are tied -- A6+B6 and A7+B7 -- which is what a USB 2.0-only device does.
    U5's I/O1 is pins 1 and 6 and its I/O2 is pins 3 and 4; each pair is one node inside
    the package, so both pins carr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
2026-08-06 Add the logo artwork to B.Silkscreen
    Ten polygons forming a 32.3 x 7.1mm wordmark at x 110.07-142.33, y 90.07-97.13 --
    inside the blank band, on the face that is becoming the visible top.
2026-08-06 Reserve a copper-free window so the logo can be backlit
    The wordmark needed the light path clear, and there was nowhere for it: the largest
    clear rectangle on the board -- both layers, 0.3mm margin -- was 3.5 x 40.5mm, a
    sliver down the right edge. Not components. Traces. The blank band is clear of parts
    but it is the highway every signal takes between the ESP32 at the top and the
    transceivers at the bottom.
    So the window is reserved rather than carved: a keepout rule area named LOGO WINDOW
    on F.Cu and B.Cu, 33.5 x 8.3mm, barring tracks, vias and copper pour. Freerouting
    honours it and funnels the crossings into the 9.5mm channel to its left and the 9.1mm
    to its right. The board still route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
2026-08-06 Order it in matte black with ENIG, and record that in the stackup
    The board had no stackup block at all, so KiCad had no idea what it was going to be
    made of and renders showed a default green HASL board. It now carries a real one:
    1.6mm two-layer, 1oz copper, matte black soldermask both faces, white silkscreen,
    ENIG.
    ENIG is not vanity. J1 is a USB-C receptacle at 0.5mm pitch and HASL is molten solder
    blown flat with an air knife -- the surface is uneven enough that plenty of fabs will
    not guarantee it below 0.5mm pitch. The board wants ENIG whatever the back looks
    like. It also stops exposed copper tarnishing, which now matters: the back is a
    display surface and may end up carrying capaci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
2026-08-06 Redesign the config page as the printer's own front panel
    The page is now written as ordinary HTML, CSS and JavaScript under
    tools/webui and compiled into the firmware by mkheader.py, so it can be
    opened in a browser and worked on rather than edited as an escaped C
    string. Never edit the generated header.
    The look is Snow White and the ImageWriter II's control panel: a case
    with a vent field at Apple's own spec, an engraved nameplate, bar lamps
    that read as an LED behind an acrylic pipe, and blank moulded keys with
    their legends printed on the case above them. Every key is one component
    in four states -- rest, pressed, latched, disabled -- travelling inside a
    housing that shortens as the ca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
2026-08-06 Config page: cache scans, seed the joined network, fault on no printer
    Scanning takes the radio off channel for a second and drops whatever is
    listening, so the page no longer scans on load when the printer is
    already on a network -- there is nothing to look for -- and the last
    list is kept for an hour and reused.
    The network the printer is joined to is shown whether or not a scan has
    run. It is the one entry we already know for certain.
    The sheet is a fixed five and a half rows tall, so the page does not
    jump when the first list arrives, and its empty state now says what to
    do rather than reporting a failure that has not happened.
    A missing printer is a fault, not an idle state: this dev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
2026-08-06 Point the indicators at the viewer and make BOOT two pads
    Components sit on the face that becomes the underside, so every indicator was firing
    away from the person looking at the board. All three are reverse-mount now, emitting
    toward the board -- and instead of the hole their footprints expect, they shine into
    a bare-FR4 window, which is the logo recipe at small scale.
    D1, D2 WS2812B-2020 -> SK6812MINI-E LCSC C5149201, $0.045
    D3 0603 green -> LED_1206 ReverseMount
    SW1 B3U-1000P -> two bare pads, SolderJumper-2_P1.3mm_Open
    The pin numbering changed and the wiring did not. WS2812B-2020 numbers its pins
    DOUT-VSS-DIN-VDD; SK6812 numbers them VSS-DIN-VDD-DOUT. B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
2026-08-06 Draw the tractor strip above the sheet
    The strips are pseudo-elements on the paper, but the sheet inside is
    positioned, so it painted over them wherever a row's background reached
    the content edge -- the perforation vanished beside the rows and
    survived only on blank paper below them. They are one piece of paper;
    the holes and the perforation belong on top.
2026-08-06 Centre the vents, hand over the address, confirm a save
    The vent pattern started its cycle at the left edge of the field, so
    the first slot sat against one end and the last was cut wherever the
    cycle happened to fall. Centring the background makes both ends match
    at any width.
    The CUPS link was a dead end: macOS ships CUPS with its web interface
    switched off, and a phone has no CUPS at all. What a person actually
    needs is the printer's address to paste into Add Printer, so the footer
    copies that to the clipboard instead, and falls back to showing it when
    the clipboard is unavailable.
    Saving printer details or a halftone was silent. Both now say so on the
    section heading for a moment -- and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
2026-08-06 Responsive pass for phones
    The setup portal is reached by joining the printer's own access point,
    so a phone is where this page is opened first and often the only place
    it is opened at all. Nothing here is a second design, only the same one
    with its metrics turned down: smaller nameplate, tighter case, shorter
    rows, and taps sized for a finger rather than a pointer.
    The nameplate and the indicator stack stop sharing a line, the printer
    fields stack, and the four halftone keys become two rows of two -- they
    will not sit across a phone at any size worth reading.
    The preview watches its own sheet with a ResizeObserver. A phone applies
    its metrics after first paint, and a canvas measured befor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
2026-08-06 Light the logo with a cavity bounce off three more pixels
    Reverse-mount LEDs make a local pool where they sit and do not spread sideways, so
    sitting four of them behind a 33mm wordmark would have given four bright patches and
    dim gaps between. D4, D5 and D6 are top-firing SK6812MINI instead, shining down into
    the printed housing; a white cavity floor bounces the light back up through the
    window already diffused, which is what a wide even glow wants.
    They sit outside the logo keepout -- (105.5, 93), (146.5, 93), (115, 86.3) -- because
    anything under the window would block light coming back up. For a light box the
    position barely matters; the cavity floods.
    All six pixels are one chain on on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
2026-08-06 Paper keeps its own ink, and the lamps share one grid
    The list borrowed the case's ink and dim colours, and those invert with
    the colour scheme -- so in dark mode the sheet stayed pale and its text
    went pale with it. Paper does not invert: ink on a page is dark in a
    dark room too. It now has --paper-ink and --paper-dim, identical in both
    schemes, and the sheet is dimmed to a warm off-white in the dark so it
    is not a slab of glare.
    Each lamp was its own two-column grid, so the columns were laid out
    independently and the bars drifted as the legends changed width -- which
    showed up as soon as the phone layout narrowed them. The stack is the
    grid now and each lamp is display:contents: one colum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
2026-08-06 Make MODE a gold touch pad on the face you actually look at
    SW2 stops being a switch. It is now airwriter:TouchPad_Comb_9x7mm -- a comb electrode
    on B.Cu with a ground guard bar, mask opened over both so a bare finger meets ENIG
    gold on the visible face. The comb is one net; the interleaving is visual. The S3
    senses self-capacitance, where a continuous electrode beats an interdigitated one, so
    the look costs nothing.
    MODE moves IO38 -> IO14, because the S3 only does touch on IO1-IO14
    R20, 1k, in series: exposed metal on a GPIO is an ESD path and the S3 is rated
    around 2kV while a person carries far more
    C19 goes DNP rather than away -- 100nF across a touch pin would swamp a sense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
2026-08-06 Import the dithered cover artwork onto the back
    Eight SVGs at 100 x 150mm, which is exactly 1.923x the board at the same aspect, so
    they scale by 0.52 and mirror onto the back layers. Smallest cell lands at 0.455mm
    and silk at 0.364mm, both clear of the fab floor.
    Three departures from the artwork's README:
    It goes on B.*, not F.* -- the back is the display face, so everything mirrors.
    The *_gold_copper layer is not imported at all. The back is already a solid ground
    pour, so copper is everywhere; 503 separate islands would have shorted across
    traces. The mask openings alone give the gold, because the pour underneath is the
    copper. Same trick as the touch pad and the logo.
    Th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
2026-08-07 Give the keys their click
    A latching key clicks twice, once going over centre and once seating in
    the detent; a momentary one gives a single hollow knock with some body
    under it. Synthesised rather than sampled -- nothing on this page may
    fetch a file, and a click is a filtered burst of noise anyway.
    The audio context is built on the first press, because iOS will not
    start one outside a gesture.
2026-08-07 Fix the routing regression the artwork introduced
    The board has been carrying unrouted signals for several commits and I did not catch
    it. kicad-cli reports pour islands and genuinely unrouted nets in the same
    unconnected_items list, and route.py prints "Found N unconnected pads" for both, so a
    board with UART_TX, UART_RX, UART_CTS, LED_DATA and USB_DP/DM disconnected still
    showed four DRC violations and read as clean. At worst it was 16 real net breaks.
    The router says so plainly if you read the whole line -- "(11 unrouted and 10
    violations)" -- and a finished board has no unrouted clause at all.
    The cause was the wordmark reserve: 49mm wide on a 52mm board, barring tracks on both
    layers,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
2026-08-20 Spec the dot-panel cover
    The show face moves off the main board onto a passive snap-apart art
    panel: Wells's Frame 7 dot grid in four coupon-verified PCB materials,
    backlit per-dot through a printed light-guide lattice. Supersedes the
    LCARS direction. Scale (62x100) was settled with true-scale TM-m30
    prints; Figma stays the artwork source of truth.
    Refs: W-573
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2026-08-20 Re-plan the panel generator around the single Figma export
    Wells exported the full panel as one SVG (62x101.51): fill colour is
    the material, coordinates are the layout. Drops the two-SVG offset
    math, corrects the dot map (test dot r3c3, 2.25mm hole), and makes
    the export the sole source of truth.
    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
2026-08-20 Panel: fix silk counter islands (nested-hole classification)
    Two-level "biggest ring wins, everything else is its hole"
    classification lost letter counters (a, e, p) in the reversed silk
    labels: a counter and its containing letter-hole landed as sibling
    holes of the same plate instead of the counter re-solidifying as its
    own island. Classify by containment depth (parity) instead, scoped
    across the whole matched-fill set as before.
    A container must have strictly larger area than what it contains -
    without that constraint, a ring's own nested descendant can swallow
    its interior-point test (a donut's outer boundary, tested near its
    middle, geometrically also sits inside its own smaller inner h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
2026-08-20 Panel: fix mask-leaked plates, adopt taller re-export
    svgelements yields the CONTENT of <mask> definitions as ordinary
    elements during traversal - each label cell's mask rect (the full
    cell bounds, inheriting fill="white" from the <mask> element) leaked
    into silk.polys.json as a solid plate, which is why the label cells
    rendered as flat panels instead of text-on-black.
    svg2poly.py now strips <mask>...</mask> blocks from the raw SVG text
    before parsing (their content must never become an element), and
    separately parses each mask's own rect bbox from the raw text so any
    element still carrying mask="url(#id)" gets clipped to it via
    Sutherland-Hodgman rectangle clipping after flattening - the t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
2026-08-20 Panel: emit masked rules as plain rectangles
    Designer simplification overriding the Sutherland-Hodgman clip from
    the mask-leak fix: the three label-cell rules are just 4x360px
    rectangles in silk white, nothing more. Since both the masked
    element's own bbox and its mask rect are axis-aligned, their
    intersection is exactly the visible rectangle - no need to sample the
    source path's curve/segment geometry or run a general polygon clip.
    Emit that intersection as a plain 4-point rect directly; the raise-
    with-clear-message guard for non-rect mask content is unchanged.
    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
2026-08-20 Panel: fab-floor advisory pass, stackup-splice guard, test cleanup
    Adds floors.py: a system-python advisory check run between svg2poly
    and emit_board that grid-hashes sampled poly edge points to flag
    same-class poly gaps and hole-to-outline pinches in the 0.02-0.101mm
    band (below: designed touch, ignore; above: comfortable clearance).
    Never fails the build - the real hard floors are DRC's job. Confirms
    the known AirWriter subtitle microprint pinch near x 6.87, y 83.93.
    Also: inject_stackup asserts its splice actually landed instead of
    silently no-op'ing if the anchor text ever changes; test_svg2poly
    imports _interior_point/_contains from svg2poly instead of
    duplicating them; softened svg2po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
2026-08-20 Plan the main-board rework
    Plan 2 of 4: schematic surgery, 62x104.27 outline matching the panel,
    LED field scripted from panel_layout.json (37 at 5V behind an AHCT
    buffer - the SK6812MINI-E is 3.7-5.5V, so the old 3.3V D1/D2 were out
    of spec), DIP bank and test switch on verified-free GPIOs, then route
    and fab regen. Parts stock-verified at LCSC today. Spec amended: the
    board grows to the panel footprint, it does not shrink.
    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
2026-08-20 Rework schematic for the dot-panel face
    Removes the MODE touch pad (SW2, R20, C19) and the two-LED WS2812 test
    chain plus the logo-window trio (D1/C8, D2/C20, D4, D5, D6), killing
    nets BTN_MODE, TOUCH_SENSE, LED_CHAIN, LOGO_CH1/2/3. D3's footprint
    moves from the reverse-mount 1206 hole part to a plain top-side 0603
    LED. LED_DATA on U1 pin 25 (IO48) is untouched.
    Adds a 74AHCT1G125 single-gate buffer (U9, SOT-353) between LED_DATA
    and a new LED_DATA5 net, decoupled with C29, so the 37-LED dot panel
    (D10-D46, SK6812MINI-E, top-firing footprint) runs off a solid VBUS-
    referenced signal rather than the ESP32's raw 3.3V GPIO. Each LED gets
    its own 100nF decoupling cap (C30-C66); C21/C22 add 22uF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
2026-08-20 Panel: back-side copper flood confines light to the windows
    The black soldermask alone still transmits some teal - without a
    copper backstop behind it, an LED would glow through the whole back
    face and bleed between neighbouring dots. emit_board.py now floods
    B.Cu solid across the panel (inset from the outline) except the 37
    P/B/L translucent-dot windows (oversized 0.15mm for registration
    slack), the fr4 slash's footprint (a plain rect, since it sits behind
    mask), and the test NPTH's drill clearance. Copper stays solid behind
    every gold dot and the lockup, same as before.
    Two DRC-driven corrections from the literal spec: the flood's edge
    inset is 0.55mm, not 0.25mm - this board's default co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
2026-08-20 Trim the fitted parts to the real feature set
    Remove the I2C display header (J6) and its pull-ups (R18/R19) -- /I2C_SDA
    and /I2C_SCL die entirely, IO36/IO37 go no-connect. Remove the USB pin
    header (J3); /USB_DP and /USB_DM keep their other nodes (J1, U5, U1).
    Swap SW1 from the tweezer-pad BootPads_Service footprint to a real
    side-actuated SMD tact switch (Panasonic EVQP44B3M, LCSC C79164, in
    stock) on the same /BOOT_CFG and /GND nets -- reset now works through a
    case pinhole instead of bare pads. No stock KiCad footprint matches the
    part, so lib/airwriter.pretty carries a derived one (pad geometry is a
    conservative edge-mount estimate; Panasonic's outline drawing is
    image-based, same gap cl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
2026-08-20 Unmirror the LED field and settle the west edge
    The dot-panel mapping was mirrored in X (board = 100 + (62 - x_p)). That
    was wrong -- the panel sits face-up above the board, both viewed from the
    same side, nothing flips. Corrected to board = (100 + x_p, 60 + y_p) and
    re-placed all 37 LEDs (D10-D46) + their caps (C30-C66); re-derived the
    serpentine chain order (round 5: column-descending first leg, since the
    physical corner nearest U9 flips sides under the corrected map). D10 now
    sits 4.2mm from U9 (was the same distance under the old, wrong mirror --
    no move needed). SW3's test-dot assertion holds: panel (31,31) still
    lands at board (131,91), the centre column. 0/37 LED positions deviate
    fro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
2026-08-20 Restructure the band for the control edge and flush antenna
    The west edge becomes the control edge: S1's body face sits 0.25mm off x=100
    with its keys outboard, and SW1's actuator is flush at x=100 for the case
    pinhole. The 14-part passive column that owned that edge is gone, redistributed
    across the band.
    U1 moves west to 149.25 so the module's antenna tip lands flush on the x=162
    edge, and its courtyard is rewritten as the module's real outline rather than
    the stock L that fused the body with a 48mm RF rectangle. That rectangle was
    what collided with J1 and J4; the RF clearance now lives only in the antenna
    rule area, which bars copper instead of parts and is notched around J1's fixed
    cor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
2026-08-20 Open the escape channel above U1's pad row
    The validation route walled off U1's north pad row: U4 sat 0.33mm above it,
    so pads 5 through 12 had nowhere to escape and /LT_UART_RX never completed.
    Lift U4 and both cap columns 0.7mm into the grid-zone margin they are low
    enough to use, which turns that 0.33mm into 1.07mm.
    The west strip beside J2 had the same problem in miniature -- five 0603s at
    0.3mm pitch left no room for R5's and R6's own escapes. R6 moves out to U2,
    and the four that stay spread to 0.97mm gaps.
    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
2026-08-20 Drop the EN cap one row down the column
    The last break was /EN: a 0.15mm stub at U1 pad 3, stable at 60 and 100
    passes. Pad 3 escapes north into the channel under the cap column, and C6 sat
    two rows up with the redundant rail cap between them, so the track had to climb
    the column's contested flank to reach it.
    Swapping C5 and C6 puts the EN cap on the row nearest pad 3 and costs nothing:
    C5 is a supplementary rail cap and U4 is already covered by C2 and C4.
    The board now routes completely -- 0 real breaks, 945 segments, 71 vias, 30s,
    score 993.13.
    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
2026-08-20 Give the edge controls their real bodies
    S1 wore the stock top-slide DIP footprint, whose body, courtyard and 3D model
    describe a different part. Built airwriter:SW_DIP_8_RightAngle_DP-08RP from the
    manufacturer drawing, measured off the PDF's own vector paths rather than the
    raster: the SVG was transformed to page coordinates and scaled by the drawing's
    7.62mm pin-row dimension, giving 10.378 pt/mm.
    That measurement corrected the brief. The body does NOT stand at the front pin
    row -- it is centred on both rows, 0.994mm past each, for 9.61mm total. The
    piano keys protrude 2.40mm past the body face, 1.30 wide, 0.90 thick, 0.40 below
    the body top, aligned with the pin columns. Holes are 0.97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
2026-08-20 Give the LED field its bodies
    The 37 LEDs rendered as nothing, so the only 3D objects near each dot were the
    bypass caps -- which is why they read as misplaced LEDs.
    The derived TopFiring footprint carries no model, so it gets the shipped
    SK6812MINI-E body. That model is drawn for the reverse-mount footprint, and its
    point cloud says exactly how: the lead frame sits at z 0 to 0.15, resting on the
    pads, while the package's whole 3.2 x 2.8mm bottom face is at z -0.84. The body
    drops through the board cutout, which our footprint strips.
    So the correction is a 0.84mm lift, not a flip. Flipping it would bury the body
    under the PCB, and it does not need flipping anyway: the emitting aperture is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
2026-08-20 Adopt the rebalanced panel
    Frame 9b replaces the dot map. Both west corners, (0,0) and (7,0), are
    gold now, which is what lets the main board put a mounting hole under one
    and the DIP switch under the other without a single LED coming off the
    chain: the field is still 37, redistributed.
    56 dots = 18 G + 1 T + 14 P + 9 B + 14 L, no empty cells
    37 LED-backed = P + B + L exactly
    MAT_BY_FILL now reads the two teal classes by their own colours instead of
    the old placeholder pair: #14baba is B, the single-mask recipe with the
    viewer's face masked and the far face open, and #176767 is L, masked both
    sides so it reads darker until lit. RECIPE already emitted exactly those
    two recipes, so nothi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
2026-08-20 Spread the mounts to the corners
    The LED field re-places onto Frame 9b's map -- 37 LEDs, serpentine
    re-derived, worst error 0.0000mm, no schematic change -- and the four M2.5
    holes leave the board's south half for its corners. Support hull 505mm2 ->
    4069mm2, eight times the span.
    H1 (105.636, 65.636) under panel dot (0,0), gold
    H2 (156.364, 65.636) under panel dot (0,6), gold
    H3 (105.636, 151.930) H1's column, as far south as J2 allows
    H4 (143.990, 160.830) east, in the pocket between J4 and J1
    THE LOWER PAIR CANNOT REACH THE LABEL RULE AT y=155, AND CANNOT SHARE A y.
    Both are arithmetic and r7_anchors.py prints them on every run. West: J2's
    courtyard starts at y=154.675 and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
2026-08-21 Move H4 to the corner, restore the antenna keepout, route
    H4 to (153.364, 151.93): 3mm west, clear of the WROOM radiator. Its
    courtyard east edge (155.809) no longer enters the keepout (west 156.0),
    so the keepout is restored from its H4 notch to a full rectangle
    (156-162, 127.6-154.544). The antenna's south margin goes 0.495 -> 5.750mm.
    Committed route: 838 segs / 66 routing vias + 23 stitching vias, score
    993.43, 0 real breaks. DRC at the benign baseline (5 silk-edge, 5
    lib_footprint_mismatch, 1 TASHTALK silk_overlap; 50 known parity issues).
    Drills >=0.300mm, clearance >=0.15mm.
    Route relief (disclosed): the H4-west shift squeezed J1's power-pad lane
    and freerouting dropped a single mar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
2026-08-21 Refill zones after the hand-routed /VBUS completion
    Wells hand-routed U4/C4 into the D14/D15 gap (C21/C29 relieved) and
    finished /VBUS; the saved zone fills were stale, showing 5 phantom
    clearance flags. Refilled via ZONE_FILLER. DRC without --refill-zones is
    now the benign baseline: 11 violations (5 silk_edge + 5 lib_footprint
    _mismatch + 1 TASHTALK silk_overlap), 0 real breaks, 50 parity.
    (board.Save UUID reshuffle is expected noise.)
2026-08-21 Regenerate the fab package for the reworked board
    U4/C4 in the D14/D15 gap, 3.6mm test hole, 15mm button, zones refilled.
    DRC 0 real breaks (benign 11), drill floor 0.300, clearance 0.15,
    BOM LED x37 + removed parts (J6/R18/R19/J3) absent, pos excludes DNP,
    new IPC-D-356 netlist. All 3D model paths resolve.
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2026-08-21 Round 10 schematic: reset rewire, BOOT switch, LED series-R, U4 input cap, UART0 + test-point breakout
    SW1 rewired IO0/BOOT -> EN so the case pinhole is a RESET (R3/C6 POR
    intact, SW1 grounds EN). SW2 added = BOOT momentary switch, Omron
    B3U-1000P (top-actuated SMD, LCSC C231329) on IO0<->GND near U1 --
    EVQP44B3M side-press has no board-edge access near U1. R20 47R series on
    /LED_DATA5 (U9.4 -> LED_DATA5R -> R20 -> LED_DATA5 -> D10). C67 1uF 0805
    VBUS input cap at U4. UART0 broken out: U1 pin37=TXD0, pin36=RXD0.
    The 8 board-only test points (VBUS, +3V3, GNDx2, EN, TXD0, RXD0,
    LED_DATA5) are NOT schematic symbols (bare pads, not purchasable) and are
    added directly in pcbnew -- see docs/round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
2026-08-21 Round 10: relocate reset (SW1) beside U1, match BOOT as B3U-1000P
    Both service switches (reset SW1, boot SW2) now live near the ESP32 with
    case-BOTTOM access, both Omron B3U-1000P top-tact (LCSC C231329). SW1's
    side-press footprint is dropped -- pointless once interior/bottom-access,
    and matched switches are cleaner. The west edge now carries only the DIP
    S1 (relieves the S1<->SW1 tightness). This also makes both switch traces
    short + fully routable. SW1 stays on /EN; SW2 on /BOOT_CFG (IO0).
    Plan-4: no west-edge reset pinhole; two bottom buttons by U1.
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2026-08-21 Round 10: regenerate fab package + fix SW1/SW2 BOM identity
    - SW1 schematic+board: EVQP44B3M / C79164 (was stale B3U-1000P/C231329 from
    the abandoned reset-relocation; board keeps the east-edge side-press)
    - BOOT footprint linked to schematic SW2 (kept 'BOOT' silk); parity clean
    - Fab: gerbers, drill, pos (exclude-dnp), BOM, STEP, render, PCBWay zip
    - Removed 9 stale Aug-6 .gbr orphans kicad-cli no longer refreshes
    - Fresh STEP/STL to Desktop
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2026-08-21 Round 10: place UART TXD0/RXD0 test points in the freed U1 pocket
    TP7 TXD0 (150.3,150.3) / TP8 RXD0 (149.5,152.5), board-only TestPoints on
    short F.Cu stubs from U1 pad37/36, silk labels west into the open area.
    Enabled by the C67 relocation. 8 test points total.
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2026-08-21 Repair Wells's board hand-edit (fix-forward from clean HEAD)
    Preserved intent: SW1->RESET (silk label, ref stays SW1 for clean parity/BOM),
    trimmed to 4 test points (TP2 3V3, TP3 GND, TP7 TXD0, TP8 RXD0).
    Fixed damage: C67 off the LED_CH05 chain back to U4; LED_CH05 reconnected;
    RXD0 net un-shorted (C67.1/U4.2/U1.40 back to GND); removed 5 dangling vias +
    TP6 orphan stub; deleted 3 duplicate TP2 + a phantom footprint.
    Reverted Wells's accidental .kicad_pro rule change (0.15->0.2 clearance etc.
    that invalidated the whole routed board) and his cap nudges (C2->EN, C4->LED_CH05
    shorts against the clean routing).
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2026-08-21 GND integrity: stitch 12 of 17 stranded pour fragments to main plane
    Verified GND was fragmented (44 fill islands -> 18 components, 22 GND pads
    stranded off the main plane incl U5 ESD ground; J1 USB-C GND was actually fine).
    Added 12 GND stitch vias tying stranded F.Cu fragments to the main B.Cu flood
    (22 -> 7 stranded pads, 61 GND vias, DRC clean, 0 real breaks). Adds r12_gnd.py
    connected-components analyzer (matches KiCad ratsnest) + r12_fix/r12_bridge.
    HANDOFF corrected: Zone<->Zone is NOT benign when a fragment strands a pad.
    5 fragments (7 pads: U5.2 C5.2 C14.2 C3.2 C1.2 C18.2 C22.2) remain: their
    F.Cu islands sit over non-GND back copper and are boxed by 0.15mm-floor routing
    -- no cle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
2026-08-21 GND: tie U5 (ESD) + C5 grounds via local 0.12mm scoped rule
    Stitched U5.2 (USB ESD ground) and C5.2 to the main plane at their dense pinch
    spots using GND stitch vias under a scoped .kicad_dru rule area (GND_STITCH_012,
    0.12mm local clearance; global stays 0.15). U5 via a 0.28mm F.Cu jog+via, C5 a
    direct on-fragment via. 22 -> 5 stranded GND pads; 63 GND vias. DRC (with the
    .kicad_dru) 0 real breaks, 0 clearance violations, ERC 0. SOURCING: 0.12mm
    (4.7mil) min at those points. 3 fragments remain (C3/C14/C22 cluster) in the
    LocalTalk both-layer desert.
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2026-08-22 Ground: tie all 8 remaining stranded GND pads to the main plane
    On Wells's layout (HEAD 88564e0), ground-only, no layout changes. Ties the 6
    remaining stranded GND fragments (8 pads): C13.2+U3.10, U8.5, C6.2, SW2.2+C7.2,
    C5.2 via standard 0.15mm GND stitch vias (0.3/0.5 & 0.4/0.6); U5.2 (ESD) via a
    0.28mm F.Cu bridge + via under a scoped 0.12mm rule area (airwriter.kicad_dru,
    GND_STITCH_012 - global stays 0.15). Connected-components: 1 GND component, 0
    stranded pads. DRC identical to baseline except GND Zone<->Zone 6->0 - the
    pre-existing 1 /+3V3 break, 3 clearance, 5 dangling vias (Wells's WIP) untouched.
    SOURCING: 0.12mm (4.7mil) min at the one U5 stitch spot. Fab NOT regenerated.
2026-08-22 Board: rewire cleanup — GND stitched, test points reflow-safe, parity clean
    Full rewire to fix freerouting artifacts. On top of the rewired layout:
    - Stitched 15 stranded GND islands to the main plane (one via each over the
    back flood); GND is now a single connected component, 0 stranded.
    - Reset switch relabeled RESET -> SW1 to match the schematic.
    - Test-point column deduped (4 shared 'TP2') with net-correct values; TP2/4/7/8
    converted to back-side SMD pads (no drilled hole under the ESP32, reflow-safe
    for PCBWay full assembly), TP3/TP5 kept through-hole and moved clear of U1.
    - Test points and mounting holes flagged board-only.
    DRC clean: 0 violations, 0 unconnected, 0 schematic-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
2026-08-22 Schematic: LED swap to SK6812MINI-C, LT polarity + SP3485 shutdown fixes, SP-brand transceivers
    - D10-D46: SK6812MINI-E was a reverse-mount package (lens on the pad side);
    on this board with no cutouts it would fire into the FR4. Replaced with
    top-firing SK6812MINI-C (LCSC C7423117), stock PLCC4 3.5x3.5 footprint,
    symbol pins renumbered to the stock pair's numbering.
    - U6 ~RE: 3V3 -> GND. Tied high, the SP3485 enters shutdown whenever DE is
    low and the first LocalTalk sync edge after enable would be clipped.
    - U6/U8 A/B swapped to Apple polarity (TxD+/RxD+ on the non-inverting pins).
    - U2 -> SP3490EN-L (C26735), U3 -> SP3232EEN (C9378): pin-compatible,
    in stock, ~4x cheaper than th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
2026-08-22 Board: re-route for SK6812MINI-C LED field; LT polarity + U6 enable fixes carried through
    Full strip + Freerouting pass (0 unrouted), stitch (24 GND vias), 5 thermal
    vias in U4's tab, C17 moved to 1.7mm from U3's VCC pin. One 0.148mm pinch at
    U4 pad 2 covered by the existing GND_STITCH_012 0.12mm scoped rule (PCBWay
    tolerates it there). DRC: 0 errors, 0 parity, 0 real unconnected.
2026-08-22 Fab: regenerate order package after the review rework
    BOM now splits R8 (populated) from R9 (DNP) — the regression that would
    have left the printer-port shield floating. Every line carries an LCSC
    number; production/bom.csv adds PCBWay notes (J2/J4 hand-soldered, U7 gets
    the socket only). airwriter-fab.zip is the gerber+drill upload.
2026-08-22 Add combine_boards.py: merge main board + art panel into one 2-design snap-apart file
    Panel above board, 2mm routed gap, three 5mm tabs with 0.5mm mouse bites.
    Output hardware/combined/ is derived - re-run the script after board edits;
    never refill zones in the merged file (panel copper is net-0 with stored fills).
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2026-08-22 Panel: Wurth 9774030151R flat-bottom M2.5x3 standoffs — 6.0mm seats, ring paste, assembly data
    Sourcing: no boss-free M2.5x3 exists except this Wurth WA-SMSI spacer
    (Digi-Key, 48k stock). Seat grown 5.0->6.0mm per its land pattern; paste is
    a 5.8/3.9mm ring so solder can't wick into the bottom-resident thread. Case
    plan flag: screw tip must stop ~0.5mm short of the seat. MT1-4 now appear
    in panel-bom/pos and the combined assembly BOM.
2026-08-22 Combined panel: flip art board face-down for one-sided assembly; nut 3D model
    Panel mirrors left-right about its centreline inside the production panel,
    so the standoff nuts reflow on the same face as the main board's SMT — a
    single-side assembly order. Physical boards unchanged. Standoffs get a
    5.1x3mm cylinder wrl so they show in 3D/renders.
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2026-08-23 Panel: test hole 3.6 -> 3.8mm for the TS-1002's 3.5+/-0.2mm shaft
    Datasheet-verified: the switch is 16.0mm tall (correct for 0.5-1mm proud at
    a 13.4-13.9mm lattice) but its shaft is 3.5mm — 3.6 left 0.05mm/side and a
    tolerance-stack bind. Wells chose the bigger hole over a printed plunger.
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2026-08-23 Panel: close mask to the copper edge around the test hole — no FR4 sliver
    The marker circle (3.83mm) sits inside the hole-clearance floor (copper
    can't start before 4.4mm), so keeping mask closed only to the marker left
    a 0.3mm bare-FR4 ring. Mask now closes to max(marker, hole+0.6): the black
    ring runs from drill to gold with nothing between.
2026-08-23 Revert "Panel: close mask to the copper edge around the test hole — no FR4 sliver"
    This reverts commit eb9a4d2783863aab7f219a44ac207152b572bd98.
2026-08-25 Pre-order review #2: stitch 10 stranded GND islands, H4 and VBUS via fixes, CAM-clean seam, CTS invert option
    Ten top-side GND islands (SP3490, both SP3485 grounds, LED 20 onward, the WROOM's
    100 nF caps, CC1's pulldown, SP3232 V+ cap and T2IN tie) had no via to the plane.
    KiCad reported them as Zone<->Zone unconnected items and the 08-22 review had
    classed those as benign. Twelve vias and three short bottom-side jogs (VBUS trunk
    by U1, 3V3 diagonal and VBUS via at H4, DIP5 diagonal by U3) bring the GND net
    to one cluster; DRC is 0 errors / 0 unconnected with schematic parity.
    Also: second via on the 5 V layer crossing by U1/D10; V-CUT score line and label
    moved from Edge.Cuts to User.Comme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
2026-08-28 Stitch the ground pour into one net
    The board had exactly one GND via. The F.Cu pour was cut into 33 islands by
    signal routing, and 30 of them had no path to the back plane at all. DRC read
    that as 30 unconnected items.
    Adds 35 stitching vias and 11 short GND segments. Every via was placed against
    the real clearance rules, not a grid: 0.12 copper, 0.25 to the edge, 0.25
    hole-to-hole. Nothing already on the board moved, and no existing copper was
    removed.
    DRC now reports 0 errors and 0 unconnected items. The 75 silkscreen warnings
    and 25 schematic parity warnings are unchanged from before.
2026-08-28 Review #3 fixes: pull GND 0.5mm off the V-score, space the VBUS via pair, drop J2/J4 from the pos file
    - Both /GND zone outlines: seam edge y 60.3 -> 60.5 (PCBWay wants >0.4mm
    copper-to-score; KiCad DRC checks edge clearance, not this).
    - Second VBUS via 153.967 -> 153.82: was 0.186mm wall-to-wall from its
    partner, under PCBWay's 11 mil and our own 0.25mm min_hole_to_hole.
    - hole_to_hole severity warning -> error in BOTH projects, so this class
    can never hide inside a '0 errors' run again.
    - J2/J4 get exclude_from_pos_files (same mechanism as H_TEST): the
    hand-soldered mini-DINs no longer appear as placeable parts.
2026-08-28 Panel: plate the test hole — gold to the bore, no black surround
    The 3.8mm test hole becomes a plated pad (O4.4 pad, copper layers only):
    the bore wall takes ENIG and reads gold, the keep_dia black surround and
    its sub-0.1mm mask sliver are gone, and mask opens to the drill edge.
    Pad + annulus ring + tab art share decorative net PANEL_AU so their
    contact doesn't DRC as a short; combine_boards.py carries that one net
    through and strips all others (a pad's stripped (net 0) doesn't parse -
    delete the node instead). Flood window grown to clear the pad by 0.25mm.
2026-08-28 Schematic: U2/U3 MPN and Manufacturer fields catch up with the 08-22 part swap (SP3490EN-L / SP3232EEN, MaxLinear)
2026-08-28 Docs: review #3 outcomes — order notes canonicalised, assumptions 3+4 resolved, swatch cancelled
    - docs/ORDER-NOTES.md is the paste-ready order text (62.0 x 208.54, one
    V-score + one relief per end, 0.5mm score setback, plated 3.8 test
    hole, J2/J4 absent from pos, consignment labeling for the standoffs).
    - SPEC section 4: assumptions 3 and 4 upgraded to resolved from the
    Technical Reference's Appendix E (already in docs/reference/).
    - Swatch rail cancelled by Wells 2026-08-28; teal risk accepted
    unmitigated; spec references amended out.
    - HANDOFF: new top entry for review #3 (report artifact linked), stale
    hole sizes (2.25 -> 3.8 plated) and package pointers fixed, U8
    shutdown-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
2026-08-28 Docs: firmware pre-board audit filed + handoff for the waiting-on-boards state
    Audit verdict: no pin in firmware is wrong; the work is omissions. Must-dos
    before boards: reinstall ESP-IDF + set-target esp32s3, the S3-guarded IO48
    output-low clamp at the top of app_main, and a deadline in serial_out_write
    (as written, one job to a stalled printer wedges job_pipe's task and bricks
    the print service ~10 min later until power cycle). MCLR question resolved
    from the 08-22 datasheet pass: PIC internal pull-up, safe. Handoff also
    records the W654223ASS53 file-replacement plan and the programmer decision
    (PICkit 3 clone + PICkitminus; TashTalk is LVP_OFF so HV is required).
2026-08-28 Firmware pre-board hardening: FIFO-direct serial writes, IO48 boot clamp, IDF retarget
    The audit's traced brick is dead: one job to a stalled printer used to park
    job_pipe's rip task inside uart_write_bytes forever (no timeout exists), and
    job_pipe_begin then refused every future job until power cycle. The fix is
    not the audit's sketch and not the first implementation either — review
    proved uart_get_tx_buffer_free_size unsound as a bound (tx_len_tot counts
    only the ring item in service), so the TX ring is gone entirely: writes go
    FIFO-direct via uart_tx_chars, which cannot block, and the loop lives in
    pure-C serial_writer.c behind injectable ops with host tests (fail fast on
    watchdog BLOCK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
2026-08-28 dip_config: real mutex between a print job and a test page
    doc_begin relied on s_printing to keep a test page from overlapping a real
    IPP job, but ipp_server serializes jobs with its own s_print_lock and never
    checks s_printing -- a job arriving mid-test-page ran doc_begin concurrently
    with test_page_task, both resetting s_stream_crc/s_printer_failed and
    writing to printer_out() at once. Add s_job_lock: doc_begin takes it
    blocking (a real job waits out a test page), test_page takes it
    non-blocking (refuses rather than queuing), both release it once printing
    (including the flush) is done. s_printing stays as display-only state for
    the status page.
    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
2026-08-28 Fix wave from the whole-branch review: GPIO func-sel, JSON buffer, poll-not-push LEDs, SPDX batch
    F1: dip_config now issues one gpio_config() over an accumulated pin_bit_mask
    for every DIP + button pin instead of per-pin gpio_set_direction/
    gpio_set_pull_mode, which never touch the IO-MUX func-sel. DIP2-5 sit on
    IO39-42 (MTCK/MTDO/MTDI/MTMS) with no series resistor to the DIP commons;
    without func-sel those pins could stay on the JTAG function, and MTDO is a
    driven output a closed switch would short to GND.
    F2: webui's static status JSON buffer grows 640 -> 1024 bytes; worst-case
    status_json render is now ~668 bytes and was at risk of snprintf truncation.
    F3: led_grid drops its pushed-stat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
2026-09-02 Review #4 fixes: J2 flipped to Mac-style, THT thermal reliefs, D3 restocked part, order notes corrected
    Fourth adversarial pre-order review (layout, LCSC parts, circuit); report in
    docs/review-2026-09-01-pre-order-4.md. No dead-on-arrival defect found; these are the
    fixes it produced:
    - J2 (printer port) is now wired as a Macintosh serial port so Apple's own crossover
    cable (590-0552-A / M0197) is the right cable. Schematic labels swapped 1<->2, 3<->5,
    6<->8; six nets hand re-routed (three new signal vias, one GND stitch via at
    111.45,152.6); DNP resistors R5 and R7 rotated 180 deg to suit the new pin map.
    J2 and J4 now read the same way.
    - Both /GND zones use THT thermal reliefs (w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
2026-09-02 Order notes: record the 09-02 file-replacement message and the PCBWay BOM/centroid check
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2026-09-08 Enclosure: read board geometry out of the KiCad file
    Adds enclosure/board_geom.py, a small s-expression reader over
    hardware/airwriter/airwriter.kicad_pcb (outline, footprints, mount
    holes, local-to-board transform) so no case dimension is ever
    retyped. Footprint carries model_offset/model_scale/model_rotate
    pulled from each footprint's (model ...) sub-block, since several
    placed 3D models are not identity transforms.
    Fixes a bracket-matching gap found while writing this: the block
    scanner assumed every s-expression opener is followed by an
    on-line argument, but this board's gr_line/gr_arc blocks put
    their first argument on the next line, so outline() silently found
    nothing until the matche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
2026-09-08 Enclosure: check the counterbore-flat test against the boolean result
    test_counterbore_transition_is_coned_not_a_flat_ledge inspected
    screw_holes() -- the cutting tool -- for downward-facing flats. A tool
    solid has none at that shoulder: the tool's own material sits below
    and wider there, so the face's normal is +Z there. The unsupported
    ledge only exists on the boolean result (shell + standoffs - screw_holes),
    where the corresponding face points -Z. The test could never fail.
    Rewrite it to build the result inside the test and inspect that instead.
    Verified by hand that a no-cone variant of screw_holes() produces 4
    downward flats of 13.477 mm^2 at Z=-4.60 against the new check, and 0
    agains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
2026-09-08 Enclosure: port openings cut from the real connector STEPs
    connector_solid() applies the full KiCad 3D-model transform (scale, then
    rotate, then offset, then the footprint's own board rotation/position,
    then the case frame's Y flip) instead of the brief's false assumption
    that every model sits at offset 0 with the part's own origin on the
    footprint origin -- J1's USB-C model carries a real (-4.47, -3.65, 0)
    offset and all three carry a model rotation.
    Checked against three independently measured ground truths (now tests
    in TestPorts): J2/J4's mating faces land at case Y=-2.75 (exact),
    J2/J4's shells top out at Z=12.74 (within 0.02mm -- the real STEP
    measures 12.75, 0.01mm off the hand-writt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
2026-09-08 Enclosure: fix STANDOFF pin/floor interference, guard front wall against port over-cut (W-725 Task 5 fixes)
    Finding 1: STANDOFF 2.00 -> 3.00. J2/J4's real pin tips (measured off the
    Kycon MiniDIN-8 STEP) reach 2.150mm below the board's underside, so the old
    2.00 left the pins punching 0.15mm into the floor. Z_FLOOR_TOP/BOTTOM and
    EXT_H follow automatically; test_params.py's expectations for them are
    updated to match. Added a derived (not restated) test in test_case.py that
    asserts every STEP-backed connector clears Z_FLOOR_TOP by >= 0.50mm, so a
    future board revision or connector swap fails the suite instead of quietly
    interfering with the floor.
    Finding 2: added a test asserting the front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
2026-09-08 Enclosure: fix port-cutout clearance envelope, USB-C flare direction, and four tests that could not fail (W-725 Task 5 review fixes)
    - _grown(): hull the tessellated SURFACE (not BRep vertices) displaced
    along 98 sphere directions, then drop offset() entirely. The old
    vertex-only hull chorded across curved faces and understated J1's real
    clearance to the wall by an order of magnitude (0.0324mm measured vs
    0.30mm required). Verified fix measures 0.3849mm on all three connectors.
    - connector_solid(): raise if a footprint isn't on F.Cu -- a back-side
    footprint would otherwise be placed unmirrored.
    - port_cutouts(): replace the inverted USB-C chamfer cone with
    _usbc_flare(), a loft b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
2026-09-08 Enclosure: fix dead back-side-footprint guard, add USB-C flare regression tests (W-725 Task 5 re-review)
    _FP_LAYER.match() anchors at position 0 but every footprint block from
    _blocks() begins with a leading "\n\t", so the layer regex silently
    failed on all 138 footprints and connector_solid()'s NotImplementedError
    guard could never fire. Switched to .search() and added a test that
    reads TP2/TP4/TP5/TP7/TP8 (the board's five real back-side footprints)
    and J2 through the actual parser, not a monkeypatched fixture.
    Also added two tests pinning the corrected USB-C flare: the opening must
    be wider at the wall's outer face than just inside it (a plug enters
    from outside), and port_cutouts() must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
2026-09-08 Enclosure: DIP slot, reset pinhole, finished tray (W-725 Task 6)
    RULING 1: drop the brief's vacuous carveouts() -- the tray's interior is
    one open prism and U4/R3/U9 all sit well inboard of every wall, so
    subtracting cylinders there subtracts air from air. Replaced with a test
    that proves the real requirement: each part, grown by exactly 1.0mm, still
    clears the tray.
    RULING 2: fix the brief's dip_slot() typo (stray "- 0.5" cancelled the
    intended +0.5 offset), pinned with an exact-span test.
    reset_pinhole()'s Z was a guess in the brief; derived it instead from
    SW1's footprint descr (body 6.2 x 2.55 x 3.5mm, side-press body sits flush
    on the board like any SMD part) as half the body height a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
2026-09-08 Enclosure: Lite lid, four carried-over spec corrections (W-725 Task 7)
    lite_lid(): the panel stand-in for Lite builds -- POCKET-sized plate at
    Z_WALL_TOP, on four legs spanning the board face to the plate's underside,
    each with a downward-opening M2.5 insert bore at its free end and a bore
    over SW3's test plunger. Prints plate-down; the leg-to-plate junction is a
    clean coincident union so it adds no unsupported downward flat beyond the
    plate's own bed-contact face.
    Carried-over corrections:
    - STANDOFF_D and LEG_D moved into params.py, beside the SCREW_* params they
    derive from.
    - Softened the SW1 actuator-Z docstring: the .wrl cross-check shares the
    same "centred on the body" assumption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
2026-09-08 Enclosure: export, printability gate, README (W-8)
    test_printable.py is the gate between "the model closes" and "the print
    will not fail": no unsupported downward-facing flats printed floor-down
    (tray) or plate-down (lid), one watertight solid each, walls >=2.80mm
    everywhere.
    First run failed 2 of 5: the DIP slot's ceiling (a ~19mm flat bridge cut
    into the west wall), both mini-DIN ports' and the USB-C port's flat
    mating-flange/shield tops (grown outward by _grown(), which stays flat
    where the real connector is), and the Lite lid's insert bores (flat
    blind-hole bottoms). Fixed by roofing each with a 45-degree ridge (new
    _ridge_roof()/_dip_slot_roof()/_port_roof()/_print_reliefs() in case.py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
2026-09-08 Enclosure: fix printability gate blind spots (W-8 review fixes)
    The Lite-lid check looked for model -Z faces, but the lid prints
    plate-down which inverts the model (print-down is model +Z) -- it could
    only ever see the always-supported plate-top side. Split the shared
    overhang engine into downward_flats() (tray, same orientation as
    modelled) and upward_flats() (lid, inverted), each documenting which
    model direction is print-down for that part.
    Also: threshold at the real 45-degree FDM overhang limit instead of
    exact-horizontal (a face tilted a fraction of a degree off flat was
    passing); sum candidate area per Z-band instead of per face (a
    hull-derived opening can tile a real ceiling into ma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
2026-09-08 Enclosure: test corner wall thickness, record shop GLB recipe
    Adds the reviewer-flagged corner test: at each of the tray's four rounded
    corners, read the exterior and pocket fillet faces back as real cylinder
    geometry and require concentric axes with an exact 2.80mm radial wall
    (WALL - POCKET_CLEAR). Proved it fails before the fix holds by breaking
    EXT_R (CORNER_R + WALL - 0.5, i.e. 4.499999 instead of 4.999999) and
    confirming red, then restored. Full suite: 65 tests, green.
    Also records the exact command used to convert the tray to a GLB for the
    shop's product viewer (shop/public/models/airwriter-case.glb), including
    why --lay-flat and no --flip.
2026-09-08 Enclosure: fix final review findings (Lite lid clearance, board drift, docs)
    Finding 1 (Important): the Lite lid's plate was cut at the pocket's own
    size (POCKET_W/POCKET_L/POCKET_R), giving it ZERO clearance to seat in
    the pocket -- an FDM part at exactly the pocket's nominal size doesn't
    drop in, and it violated the spec's claim that the lid reproduces the
    panel's real 62.00 x 104.27 outline. Cut the plate at the panel's own
    outline (BOARD_W/BOARD_L/CORNER_R) instead, landing the 0.20mm/side the
    pocket was already cut to give (measured: 0.000mm -> 0.200mm clearance).
    Replaced the zero-margin `(tray & lid).volume == 0` test with
    `distance_to(...) >= 0.15`, and fixed the plate-size test and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
2026-09-09 Enclosure: fix three measured fit defects (wall/panel flush, DIP slot, boss relief)
    CAVITY was double-counting the panel's 1.60mm thickness (once inside CAVITY,
    again in Z_WALL_TOP), standing the wall 1.6mm proud of the panel -- corrected
    against the board's own GLB (lattice tops out at 12.74, panel top measures
    ~14.32) so the wall now lands flush with the panel/lid at 14.34. Flagged in
    params.py and the spec that this contradicts the spec's own nut-stack
    derivation, pending a check against real hardware.
    The DIP slot behind S1 added its margin onto the pad-column centres instead
    of the keys' own edges, so the outer two keys sat 0.05mm inside the wall;
    now derives from the key's real 1.30mm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
2026-09-09 Enclosure: keep the Lite lid's legs out of the board
    The legs stand where the board does, and two parts crowd a mounting hole.
    J2's mini-DIN shell comes within 2.220 mm of H3's centre against a 3.00 mm leg
    radius, for the leg's whole 12.74 mm height — roughly 27 mm³ of solid overlap,
    so the lid would not have gone on at all. C22, a 0603 1.24 mm tall, reaches
    within 2.844 mm of H4's centre; a leg standing on a capacitor cracks it.
    The legs are now trimmed to the real vendor solids of J2/J4/J1 rather than to
    a guessed diameter, so this self-corrects if a connector moves, and their feet
    are relieved 0.60 mm for their first 1.60 mm to clear short parts. The insert
    keeps its full 1.20 mm wall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
2026-09-10 Panel: swap too-small test label for a dot mark (PCBWay EQ)
    PCBWay flagged the "test" soldermask label on the cover panel as below
    their minimum feature size. Frame 9 drops that four-glyph label and adds a
    ~0.9mm accent dot in the test cell's lobe, with the lobe corner radius
    opened from 10u to 12u.
    The dot is emitted as a #111111 mask-knockout path -- the panel pipeline
    ignores <circle> and only ingests white/#fff/#111 fills, so a plain black
    circle would have been silently dropped. As a knockout it renders as a
    kept-soldermask island on exposed gold. Regenerated panel -> combined ->
    fab. Smallest B_Mask features in that cell: 0.90mm island, 0.23mm opening.
2026-09-18 Enclosure: flat port lintels instead of ridge roofs
    The 45-degree roofs over the DIP slot and the ports were there only to pass
    test_printable's no-flat-ceiling check. J2/J4's peaked at Z 14.55, above
    Z_WALL_TOP (14.34), and cut triangles out of the rim; and a roof's layers
    bridge the same span as the flat they replace. The openings keep flat tops:
    bridges a wall deep, 20.7 mm at the longest.
    The gate now allows a through-wall lintel and caps its span at 25 mm, and
    test_case asserts no cut reaches the top 0.5 mm of the rim (the averaged band
    probes let the notches through).
    Refs: W-806
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2026-10-13 pic_prog: flash TashTalk into the LocalTalk PIC from the ESP32 over LVP
    The PICkit 3 clone couldn't program the PIC12F1840. Factory-fresh parts
    ship with LVP on, and the board already wires IO2/IO4/IO5 to MCLR,
    ICSPCLK and ICSPDAT, so the ESP32 can program its own PIC in the socket
    with no 9 V. A "flash" key in a new localtalk section of the web UI
    (POST /api/localtalk/flash) writes the vendored, unmodified upstream
    tashtalk-2.1.3.hex with CONFIG2.LVP set at runtime, then verifies it.
    The LVP patch is not optional: a part in LVP mode can't clear its own
    LVP bit, so the unpatched image fails its config verify (host-tested).
    Protocol per DS41439A; host-tested against a pin-level simulator th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
2026-10-13 pic_prog: review fixes -- MCLR ordering, DAT pull-down, config read-back
    From the design critique:
    - Never drive DAT while MCLR is high: out of reset the PIC runs TashTalk,
    whose UART TX is RA0, and IO5 driving it is a 33 mA short through R16.
    MCLR now falls before CLK/DAT are driven (no rising edge first; key
    matching doesn't need one, DS41439A Fig 8-9) and DAT is released before
    MCLR rises on exit. The simulator now treats either as contention, and
    a test proves that rule fires.
    - DAT gets a pull-down for the session, so an empty socket (or a part
    whose LVP bit is already off) reads 0x0000 = "no PIC answered" instead
    of a random ID.
    - Pins start from gpio_reset_pin so a GPIO-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
2026-10-13 main: clamp IO4 high and IO35 low at boot
    Two pins floated from power-on with nothing claiming them.
    IO4 (LT_UART_TX) runs through R15 to the PIC's RA1, TashTalk's UART
    receive. Floating, TashTalk can decode noise as host commands and put
    garbage on a LocalTalk bus. It is now driven high, the UART idle level,
    guarded on CONFIG_AIRWRITER_PIC_CLK_PIN. pic_prog still hands the pin
    back as a pulled-up input after a flash, and a LocalTalk UART driver
    will own it later; the clamp only covers boot until then.
    IO35 (HSKI_DRV) is U3.11, the SP3232's T1IN: a driver input with no
    pull-up that the datasheet says must be tied. Review #4 and the
    firmware audit both called for this; it was never written.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
2026-10-14 main: bring up Wi-Fi before the setup portal on a blank board
    A board with no stored SSID skipped wifi_start(), which is where
    esp_netif_init, the default event loop and esp_wifi_init lived, so
    net_provision_start() aborted with ESP_ERR_INVALID_STATE in
    esp_netif_create_default_wifi_ap() and the board boot-looped. The
    devkit always had credentials and never took this path; rev A's first
    flash did.
    The one-time init moves to wifi_init(), called unconditionally. The
    event handlers stay in wifi_start() so setup mode never fires
    esp_wifi_connect() at an empty SSID.
    Verified on rev A: blank NVS boots to the AirWriter-2434 open AP and a
    phone joins and gets a lease.
    Refs: W-1032
2026-10-14 HANDOFF: rev A bring-up — boots, prints, stream matches the host fixture
2026-10-14 main: make the job lock a binary semaphore
    test_page() takes s_job_lock on dip_config's poll task and
    test_page_task gives it back. A FreeRTOS mutex has an owner, so that
    give tripped the priority-disinherit assert and rebooted the board
    after every test-button page. A binary semaphore has no owner; the
    take-then-spawn sequencing that refuses a second press is unchanged.
    Verified on rev A: a held press prints the strip with the board staying
    up (uptime continuous), a second press during it starts no second
    strip, and presses while the printer is blocked fail the page cleanly
    without a reboot.
    Refs: W-1033
2026-10-14 HANDOFF: test-button fix, iPhone full page, flash vs power-cycle handshake
    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
2026-10-15 pic_prog: sleep whole ticks so TPINT is never cut short
    The first flash on rev A failed CONFIG1 verify (wanted 0x09C4, read
    0x3FFF). h_delay rounded to milliseconds and then to ticks, and at
    CONFIG_FREERTOS_HZ=100 pdMS_TO_TICKS(3) and pdMS_TO_TICKS(6) are zero,
    so the "+1" left TPINT as vTaskDelay(1): until the next tick, 0-10 ms.
    Program rows got away with it because loading a row takes ~2 ms of a
    10 ms tick; the config write follows a long spin-wait verify and lands
    at a random phase.
    pic_sleep_ticks() rounds microseconds up to whole ticks plus one for
    the partial first tick, and decides spin versus sleep in one place.
    The host test now flashes through a HAL that sleeps the way vTaskDelay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
2026-10-15 Plan: status language v2, eight tasks; spec aligned with it
    The spec now says what the plan builds: lazy timers in ps_update rather
    than a tick, booting ending on the core's own timer, the stall limit
    enforced by the serial writer, 100 ms HSKo sampling, the swell on every
    entry to Ready, instant wake, a linear pilot light, and 'other' as the
    offline reason (offline-report is not IANA-registered).
    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
2026-10-15 Enclosure: flexing west wall and 0.30 clearance so rev A fits the tray
    The rev A board could not be fitted into the printed tray. S1's keys
    stand 2.2mm past the board's west edge into a closed slot, so the board
    has to finish with a slide west. But the mini-DINs and USB-C stand into
    closed windows in the front wall, which pin it to +-0.4mm side to side,
    and the pocket gave 0.2mm. A collision sweep found no path in; the
    ports alone rock in fine.
    Below the panel seat the west wall is now 0.80mm thick, with a 45-degree
    ramp back to the full wall, so it bows out past the keys while the
    seat, rim and outside stay as they were (Wells's call over an open
    notch or a drop-in bezel). Ends taper over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
2026-10-15 printer_state: discrete display states on a lazy clock
    Eight states in priority order (booting, setup, joining, attention,
    failed, printing, offline, ready) derived from events plus now, with an
    asleep modifier and a greeted flag for a Ready entered straight from
    Joining or Booting. Every timer is evaluated in ps_update(), so the core
    stays pure and the host test drives it with a fake clock. The LEDs keep
    today's patterns, mapped onto the new names, until the renderer is
    rewritten.
    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
2026-10-15 serial_out: report HSKo edges; a stalled job pauses instead of aborting
    serial_out no longer decides that a low line means paper out. It reports
    edges, and printer_state judges them in context. The write loop rides
    out a stall and gives up only after AIRWRITER_STALL_ABORT (600 s) with
    nothing accepted. Nothing is latched across writes, so a job to a
    printer that has been off a long time still gets its whole wait.
    job_pipe's push and end waits stretch to match.
    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
2026-10-15 led_grid: panel language v4 on the measured physics; DIP7 gamer mode
    Every state uses the array: a radar sweep for setup, rings pulsing out
    while joining, per-dot white breathing for Ready (green only for the
    Wi-Fi-connected moment), warm embers when the printer is offline, a
    bidirectional print head, an amber double ripple, a red glitch, and a
    pilot light with a rare twinkle when asleep. Each dot carries a fixed
    hashed variation in phase, period and hue. Information stays on the FR4
    dots; mask dots join only in the all-dot states at 4x. DIP7 turns
    Ready and Asleep into a slow RGB drift.
    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
2026-10-15 webui: status names follow the new states; offline is not a fault
    status JSON reports the human state ('Needs attention', 'Printer
    offline', ...), the machine name and asleep. The page lights the fault
    lamp only for attention or a failed job, and tells offline apart from
    busy on the printer lamp.
    Also moves W-1028's LocalTalk flash section into tools/webui: it had
    been edited into the generated webui_page.h only, so regenerating the
    header would have deleted it.
    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
2026-10-15 Review fixes: 64-bit state clock, cancel frees a paused printer, Done after flush
    - printer_state_core runs on uint64 ms. With uint32, stamps older than
    49.7 days of uptime aliased back into their windows: the boot spin
    replayed, an expired failure re-showed, a long-offline printer read
    ready for 3 s.
    - serial_writer gains an aborted() hook; Cancel-Job sets it, so a paused
    (paper-out) write gives up at once instead of after STALL_ABORT and
    the printer frees up. A cancel ends the job as done, not as a red
    failure.
    - JOB_DONE is posted after the final flush, which now waits as long as a
    paused job does, so paper running out on the last sheet reads as
    needs attention, not offlin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
2026-10-15 Enclosure: second-print fixes for the tray (keys, wall, ports, height)
    Wells's first print of the flex-wall tray:
    - DIP keys touched the top and bottom of their slot and could barely
    toggle. Piano keys rock; the slot goes 5.20-9.30 -> 4.60-9.90, about
    0.9 each way past the keys.
    - The 0.80 west wall split near the floor. Bowing it 2mm puts ~1%
    layer-pulling strain at the floor junction whatever the thickness
    (FEA: 0.99% at 0.80, 1.04% at 1.20; a bottom-only taper just moved
    the peak up the wall). 1.20 is no gentler but 2.25x stronger against
    overload; cove 1.5. README asks for PETG.
    - Mini-DIN windows were ~0.9 too deep at the bottom: the hull reached
    back to the pins. They ar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
2026-10-15 led_grid: 16-bit render, temporal dither, steady 100 fps -- smooth fades
    Tuned on board 1: Ready's breathe sits at 1-6 counts of drive after gamma
    and the 48/255 cap, so an 8-bit frame had ~6 levels and each step (1 to 2
    is double the light) read as a stutter. Frames now render at 8.8 fixed
    point and a sigma-delta dither carries each channel's fraction into the
    next frame, at a steady 100 fps (xTaskDelayUntil) instead of ~33 fps.
    Sub-count pilot channels snap to 0 or 1 so the asleep dot never shimmers.
    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
2026-10-15 Enclosure: light-guide lattice
    Egg-crate grid on the dot pitch, posts at H1-H4 with standoff pockets, side rails to the front posts, and a tube for the power LED D3. Part clearances come from KiCad's STEP export; the antenna keepout stops at the grid's front wall.
    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
2026-10-15 Lattice: review fixes (export validation, through-notch leaks, D3 seal)
    - components.export(): kicad-cli exits 2 on every run because KiCad 10
    ships no SK6812MINI model, so the first build after any board edit
    failed and the next trusted the "failed" file. It now writes to a
    temporary file, accepts only missing models that NO_MODEL /
    NO_MODEL_LIB cover, names any other part, and replaces the cache only
    on success.
    - leaky_walls(): counts a wall only when a cut goes straight through it,
    however small; thinning no longer counts. Today: four through-notches,
    all lit-to-gold or lit-to-front.
    - The D3 tube's wall check probes from 0.2 above the board to the top,
    where the part voi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
2026-10-15 printer_state: count offline from the end of the boot animation
    Measured on board 1 (W-1039): the ImageWriter reports busy for ~3.5 s
    after the AirWriter powers up, then clears by itself -- identically with
    or without a CTRL-X purge, so no purge is sent. Counting the offline
    debounce from power-on flashed embers right after the spin and skipped
    the green Wi-Fi-connected moment; counting it from the end of the boot
    animation gives the printer up to 6 s to settle.
    Refs: W-1037, W-1039
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2026-10-15 Unstick a printer left busy by serial-line noise with CTRL-X
    Board 1 (W-1039): replugging the serial cable can leave the ImageWriter
    holding DTR false with SELECT lit -- an unprinted line in its buffer.
    Bench: stuck 120 s with no help (control), ready 4.1 s after a CTRL-X
    sent past the flow control, twice. printer_state decides when
    (ps_want_kick: idle, busy 5 s, then every 60 s at most, never mid-job);
    a kick task sends it via serial_out_send_unflowed() under the job lock.
    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
2026-10-15 Lattice v2: test-button collar, edge ridge, clear light pipe for D3
    From Wells's first print of the lattice:
    - The test button is tall and wobbly. A collar in the test cell's top
    2 mm (Ø3.6 bore on the plunger's measured 3.1-3.2) braces it, tied to
    the cell walls by four ribs; nothing lower, so no extra drag.
    - Natural variation leaves a slight gap round the panel's edge. A 1.5 mm
    lip round the lattice's top edge reaches to 0.1 short of the tray wall,
    so the lattice sits snug and the gap shows black plastic.
    - The power LED is dim through the thin "/" window. A clear-PETG light
    pipe fills the D3 tube, standing on the board with D3 and R17 in slots
    in its foot. The tube's outer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
2026-10-15 main: a cut transfer stops a paused write
    The iPhone cancels a job by dropping the upload (with streaming
    Print-Job it never got a job id for Cancel-Job). doc_end then waited in
    job_pipe_end for a rip task parked in serial_out_write behind a paused
    printer -- up to the 10-minute stall limit, holding the job lock, panel
    amber. A cut transfer now sets the writer's abort flag first.
    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
2026-10-15 led_grid: Ready and the offline embers at 4x drive, for daylight
    On board 1 Ready's breath peaked under 6 counts and the embers under 4;
    both vanished in a daylit room. Same breath and colours, levels raised
    so the linear drive is 4x: Ready 30-70%, embers 9-60%. The neutral-white
    test now checks tint relative to the brightest channel, since a fixed
    3-count tolerance can't hold at higher drive.
    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
2026-10-15 Resync the printer before the job after an aborted one
    A job aborted mid-page -- Cancel-Job, a cut transfer, a stall -- stops
    writing wherever it was, almost always inside a strip's 1152 column bytes.
    The ImageWriter is then still counting graphics data and prints the next
    job's ESC c / ESC p / ESC T16 / ESC G as dots, then parses image bytes as
    commands. Purging our FIFO cannot help: the printer already has the header.
    The Technical Reference's recovery (Cancel Current Line, p. 85) is 1280 NULs,
    which run out any graphics count and are ignored as text, then CTRL-X, which
    erases the half-received line. iw_link tracks whether the last stream that
    started was cut; the next job sends iw_resync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
2026-10-15 main: report why the chip last reset
    /api/status gains a reset field and the boot log names the reason. The
    USB console re-enumerates with the chip and loses the ROM's rst: line, so
    a pulled cable, a brownout and a panic all looked the same on the bench.
    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
2026-10-15 Kconfig: printer-uuid stays put by default
    Development mode made a new printer-uuid on every boot. After a morning of
    bench reboots the iPhone listed two "ImageWriter II" printers and, sending
    to the stale one, polled Get-Printer-Attributes forever without a job; the
    Mac hung on Preparing. The UUID now derives from the MAC alone unless
    development mode is switched on.
    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
2026-10-15 ipp_server: Create-Job + Send-Document, so a paused job is visible mid-upload
    Print-Job's response, and with it the job-id, only goes back once the whole
    document is in. A stalled printer backs the upload up, so the iPhone had no
    job to poll and kept showing "Printing" while the panel said out of paper.
    Create-Job answers with the job-id at once; the document follows in
    Send-Document, streamed exactly as Print-Job's is. While the printer is
    stopped, a printing job reads processing-stopped / printer-stopped. The job
    slot is a pure core (ipp_job.c, host-tested in tools/ipp); a Create-Job whose
    document never comes is aborted after multiple-operation-time-out (60 s) so it
    cannot hold the print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
2026-10-15 IPP: media-empty-error, printer-state-message, timeout action
    RFC 8011 5.4.12 says a stopped printer MUST carry an error reason, and a bare
    keyword is only assumed to be one; say it outright with the -error suffix.
    printer-state-message gives the phone the panel's words, and
    multiple-operation-time-out-action (PWG 5100.13, abort-job) says what the
    60 s Create-Job timeout does. Keywords checked against the IANA registry.
    Refs: W-1040
2026-10-15 ipp_server: one waiter for the printer, busy not not-accepting, no job 0
    Review of the Create-Job change. Each request waiting for the printer pins
    one of three workers; with a paused job holding another, two waiters would
    leave nothing for the phone's polls or its Cancel-Job. Only one request now
    waits (30 s, as before); the rest get server-error-busy at once, which RFC
    8011 defines as "retry later" -- the old not-accepting-jobs contradicted
    printer-is-accepting-jobs = true. The empty slot before the first job no
    longer answers as a completed job 0.
    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
2026-10-15 ipp_server: four workers, backlog 8, 16 sockets
    A paused job holds a worker for minutes, so there are three beyond it. The
    listen backlog is 8 (it was WORKERS + 2) with the accept mailbox raised to
    match, so a burst queues instead of being reset. lwIP gets 16 sockets: the
    webui's httpd can take 9 of the default 10 and leave IPP's accept() none.
    Set CONFIG_LWIP_MAX_SOCKETS / CONFIG_LWIP_TCP_ACCEPTMBOX_SIZE in an existing
    sdkconfig too; defaults only seed a new one.
    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
2026-10-15 ipp_server: Print-Job only; drop Create-Job and Send-Document
    With Create-Job and Send-Document in operations-supported the iPhone held
    every job at "Waiting" and never submitted it, re-polling
    Get-Printer-Attributes (W-1040 bench: 182-318 GPAs, no job op, on two builds
    and a fresh printer-uuid). They were added so the phone would have a job-id
    before the upload, and that premise was wrong: while a Print-Job body is
    still streaming, iOS and macOS find the job with Get-Jobs and poll
    Get-Job-Attributes, so the processing-stopped / printer-stopped mapping
    reaches them on Print-Job alone.
    Gone: the Create-Job / Send-Document handlers, the abandoned-job reaper,
    multiple-operation-time-out(-actio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
2026-10-15 HANDOFF: W-1040 bench result, Print-Job only, worker starvation, open iPhone stall
    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
2026-10-15 IPP: Get-Printer-Attributes honours requested-attributes; UUID epoch 2
    macOS flagged the queue cups-ipp-conformance-failure-report: every
    Get-Printer-Attributes returned the whole set, 'none' included, and
    media-col-database came back for 'all' and for no list, where RFC 8011 /
    IPP Everywhere send it only when named.
    The parser keeps requested-attributes in place in the request buffer (no
    copy on a worker's stack); the writer sends the groups 'all',
    'printer-description' and 'job-template', explicit names, or nothing for
    'none', and opens the printer group only if something goes in it.
    tools/ipp/gpa_server puts the real parser and encoder behind a localhost
    socket so ipptool's suites run wi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
2026-10-15 Buffer the whole job in PSRAM; answer when the upload ends
    With an 8 KB ring a paused printer stalled the upload behind a zero window,
    so a client that dropped mid-document looked exactly like a healthy paused
    one until paper came back or the 600 s stall abort: its FIN sits behind its
    own unsent data. job_pipe's ring is now 1 MB of PSRAM (8 KB internal if the
    allocation fails), so the socket is read to the end whatever the printer is
    doing and a hang-up is hbody_read -1 at once -> doc_end(0) -> abort.
    Print-Job replies as soon as the body is in, with the job
    processing. job_pipe_end no longer waits: the pipeline task finishes the
    rip and calls cfg.done, where main's job_finished flushes, en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
2026-10-15 W-1042 review fixes: no 1MB reset, cancels that cannot go astray
    - job_pipe_begin drains instead of xStreamBufferReset, which with
    assertions on memsets the whole 1MB ring inside a critical section.
    - run_document passes a Cancel-Job on again after begin(): a cancel while
    begin() waited out a test page reached a sink with nothing started and
    was then cleared by begin, so the job printed while reading canceled.
    - Cancel-Job calls sink.cancel under the job lock, so the job cannot
    finish and hand the printer to the next one in between.
    - job_finished purges the FIFO on any failed or canceled job: the rip can
    stop between writes and leave a FIFO of the dead job behind a paused
    printe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
2026-10-15 Log where an upload's time goes, and the RSSI with each job
    Bench step 4 on 1a4c21a took 11.5 KB in 42 s and step 3's cut was seen 16 s
    after the client died, both with SELECT off. Nothing in the firmware ties the
    upload to a rip task blocked on the printer -- the ring has 1 MB free, so
    xStreamBufferSend never waits, serial_writer sleeps rather than spins, and no
    lock is shared -- and the same session had an OTA crawl at 2-7 KB/s on an
    idle board joined at rssi -80. run_document now logs its duration, the
    longest wait for data (and any over 2 s as it happens) and the longest push
    into the sink; doc_begin logs the RSSI. A slow upload with short pushes is
    the link; a long push would be a coupl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
2026-10-15 wifi: join the strongest access point, not the first
    The default fast scan takes the first AP that answers, scanning channels in
    order. On a mesh that picked a far node on channel 1 at -80 to -87 dBm over a
    -46 dBm node on channel 11: uploads crawled at about 6 KB/s, an OTA failed,
    and a paused print's upload stalled at lwIP's receive window. Scan every
    channel and sort by signal.
    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
2026-10-15 Retire HANDOFF: audit fixes
    A cross-check against the old HANDOFF found facts the first pass missed
    or got wrong:
    - hardware-rev-a: full rev B list from review #4, DIP net vs printed
    label (DIPn = label 9-n), the alignment-proof scripts, and what the
    08-20 pivot removed that SPEC 2.2-2.5 still names
    - traps: the main-board routing order, >1 MB jobs bypass the PSRAM
    buffer, floors.py now gives 7 warnings (not 8), part heights the
    KiCad models get wrong, make -B rewrites tools/ipp's committed binaries
    - AGENTS: W-1044's cause never isolated, Pro screws M2.5 x 18, ERC/DRC
    baselines re-run today, tools/ippcap and tools/webui in the layout
    - sourcing: PCBWay sourced the standoffs for r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
2026-10-15 LocalTalk: what the bench showed about the end of a job
    The second complete print matched the first byte for byte (11968 bytes) and
    ended with CloseConn, no PAP EOF, and no read of us at all, so d3dcfcf's
    reason for answering the Mac's read was wrong. The read answer stays (it is
    TailTalk's tested behaviour for clients that do read); the comments now say
    what was seen, and traps.md records the end-of-job exchange.
    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
2026-10-15 fixtures: a page as the AppleTalk ImageWriter driver sends it over PAP
    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
2026-10-16 Licensing for a public release; Apple manuals cited, not shipped
    LICENSE.md maps the repository to its licences (texts in LICENSES/):
    firmware, tools and fixtures GPL-3.0-or-later; hardware and enclosure
    CERN-OHL-S-2.0; docs CC-BY-SA-4.0. The AirWriter name and logo are
    reserved, and third-party material is listed with its terms.
    TashTalk's corresponding source (one-chip.asm at v2.1.3) now ships beside
    the hex it builds. The two Apple manuals leave the tree for a citation in
    docs/reference/README.md; they also have to be purged from history before
    the repository goes public. Home Wi-Fi names are scrubbed from the docs.
2026-10-16 J1's USB-C model is our own, drawn from dimensions
    The HRO TYPE-C-31-M-12 model came from a repository with no licence, which
    blocks a public release. lib/make_usbc_model.py draws a replacement in
    build123d from the Type-C shell dimensions plus the leg, peg and pad
    positions in the footprint's frame (CERN-OHL-S).
    The case and the lattice cut the model's convex hull. The new hull matches
    the old one to 0.000 mm (same volume, no vertex outside either), so the
    enclosure is unchanged: the lattice mesh has identical vertices and volume,
    and the tray differs only in how the USB-C opening is triangulated
    (0.0008 mm3). 123 enclosure tests pass.
    Refs: W-1054
2026-10-16 Board STEP exports carry the new J1 model
    fab/airwriter-3d.step and its copy in production/airwriter.zip embedded the
    unlicensed USB-C model. Regenerated the STEP from the current board
    (kicad-cli pcb export step --subst-models) and swapped it into the zip;
    the zip's other 38 files are untouched. Old versions still need purging
    from history before the repository goes public.
    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
2026-10-16 LocalTalk: print PAP jobs, with back-pressure and the job lock
    A PAP job is the Mac driver's own ImageWriter stream (fixtures/
    pap-iw701-page.bin), so it goes to the printer as it is:
    - lt_node: printer ops (job_begin may answer busy, job_data, job_room,
    job_end with normal = the Mac ended it). The next SendData waits for a
    whole read's room, so a paused printer holds the Mac, not our buffers.
    lt_node_pap_abort tells the Mac with CloseConn when the printer gives up.
    - localtalk.c: a 16 KB spool and a print task, so the printer's blocking
    writes never stall the LocalTalk task.
    - main.c: the job takes s_job_lock without waiting (IPP and test pages
    exclusive; the Mac is told busy), w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
2026-10-16 LocalTalk printing: review fixes
    - A Cancel-Job for an IPP job still waiting in doc_begin set the global
    serial abort and killed the LocalTalk job printing. doc_cancel now acts
    only while IPP owns the printer; ipp_server re-delivers the cancel once
    begin returns.
    - A Mac that stops sending mid-job, tickling, held the printer from every
    other job indefinitely. After 5 min owing data with the printer ready, the
    connection is closed and what came prints if it ends between commands. A
    Mac waiting out paper-out is never cut off.
    - A flush that times out is a failed job, and the print task counts what
    the printer end says reached the printer.
    - iw_scan reads ESC I as Table 7-1 has it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
2026-10-16 Recovery: factory slot, OTA rollback gate, long-press factory reset
    W-1046 Factory reset must always work, even with broken firmware
    W-1045 Long-press factory reset with live feedback on the LED panel
    Partitions: factory + ota_0 + ota_1, 2 MB each, nvs/otadata/phy_init at
    their old offsets so the one USB flash that moves a board keeps its
    settings. The C6 devkit keeps the old 4 MB table (partitions-4mb.csv).
    Rollback: CONFIG_BOOTLOADER_APP_ROLLBACK_ENABLE. A new OTA image is kept
    after 15 s of health (with credentials: joined, IPP and web UI up;
    without: setup AP and web UI up), and rolled back if not healthy 120 s
    after boot (components/ota_health, pure gate in ota_health_core).
    Bootload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
2026-10-16 Recovery: review fixes
    A failed settings erase also waits for the button to be let go before
    restarting, so it cannot turn into the bootloader's reset. The countdown
    moves only on a sample that is itself down, so a release just past 1 s is
    still a tap. The LED task cannot read an action that started after its
    clock as 49 days old. A failed mark-valid leaves trial true. traps.md:
    any reboot during an OTA trial rolls it back.
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2026-10-16 Cable tester: review hardening
    Wait out a cable test holding UART2 before starting the node on a DIP flip,
    and end a capture after 60 us of quiet rather than 30: TashTalk's gap after
    its sync pulse is ~20 us by the cycle count, not ~13.
    Refs: W-1055
2026-10-16 Cable tester: retry from a reset TashTalk, and report what each leg saw
    On board 1, before the LocalTalk node had run that boot, TashTalk sent and
    relayed nothing over the cable test's own UART2 link while its CTS said it
    was alive: no edge reached J2's RxD, and nothing came back from a forced
    J2->J4 frame. With the node's link the same frames passed both ways, and
    after that boot the own link has passed every time, idle minutes included.
    The cause was not found. A fail on the own link now gets one more try after
    holding TashTalk in reset for 2 ms, and logs when that is what passed.
    Each result carries dbg (RMT captures, what TashTalk relayed, its CTS,
    whether it was reset), and POST /api/c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
2026-10-16 Cable tester: answer with a green or red left-right sweep
    White read as Ready. The answer is now one sweep across every dot, left to
    right and back in 1.8 s: green for a crossover, red for a straight, broken or
    missing cable. Green also means Wi-Fi connected; the sweep tells them apart.
    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
2026-10-16 Cable tester: red blinks the dots around the test button twice
    After the sweep a fail no longer pulses: the six dots nearest the test button
    blink twice, 200 ms on, 200 off, 200 on, with the rest of the panel dark.
    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
2026-10-16 W-1048 review fixes: stalls let go of the job lock; quiet auto-retry
    - An upload that stalls (three 20 s timeouts) or has a job waiting on it
    ends, freeing the job lock; a download that does not move for 60 s too.
    - Auto-update asking during a long job says nothing and waits; only a
    person's install shows "printing".
    - An image running unsigned refuses every update, so the page says so.
    - fw_update's task gets 8 KB and logs its stack headroom after a check.
    - release.sh tags the commit it built, removes the tag if gh fails, and
    checks the compiled-in key digest against the committed key.
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2026-10-16 led_grid: W-1049 tasks, moments, acknowledgements and LocalTalk ink
    The renderer takes a slot per task family (factory reset, firmware
    update, TashTalk flash; the first running one owns the panel), an
    acknowledgement drawn over the state (dropped in Booting, Needs
    attention and Job failed, never over a task), and the job's source.
    States open with moments drawn from the state before: printer gone and
    back, page out, cancelled, could not join. A LocalTalk job inks in the
    six classic Apple stripes. Refused and rolled back are held back and
    draw the state.
    The glue keeps a slot per family (the same act again only moves its
    progress on), and an acknowledgement raised during the Spin waits for
    i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
2026-10-16 W-1049: the board's actions reach the panel; a second tap cancels the test page
    - Each job sets its source before it starts, so a LocalTalk job prints
    in the stripes and an AirPrint job or test page in warm ink.
    - A cancelled IPP job or test page ends as cancelled, not done.
    - The test button: a tap with nothing printing prints the test page; a
    tap during it cancels it (the write is aborted, W-1041's resync runs
    before the next job); a tap during anyone else's job shows Busy.
    - The TashTalk flash shows while it runs, then OK or failed.
    - The LocalTalk node reports coming online, an answered NBP lookup and
    a new node heard; main shows LocalTalk on, and a Mac heard at most
    every 6 s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
2026-10-16 W-1049 review fixes: long uptime, the tap race, the page's end, the draw
    - The panel's clocks are 64-bit and saturate (lg_elapsed): a 32-bit
    difference went negative after 24.8 days of uptime and froze a
    finished one-shot (a Saved ring, TashTalk OK, a let-go reset) on its
    first frame until day 49.7.
    - The tap and the test page's end decide under one critical section, so
    a tap as the page finishes can no longer cancel the next phone or Mac
    job. The test button is one path with W-1055's cable test: a tap
    during the test page cancels it whatever the printer line says.
    - The test page ends as job_finished does: flush, purge what did not go
    out, then settle the link. A cancel too la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
2026-10-16 W-1049: a quiet power-on
    A normal power-on showed the Spin, Joining, the Wi-Fi green, the
    printer gone and back, then Ready. Now the Spin is all it shows: it
    keeps turning until Wi-Fi is up and the printer line has held still
    (ready 1 s, or down 10 s: no printer), at least 3.0 s and at most 30 s,
    then goes out straight into the state. No printer opens on the embers
    directly; no credentials on Setup; a failed join of the saved network
    on the two red pulses, then Setup (join_failed, from the Spin or from
    Joining); no Wi-Fi by the cap on Joining.
    The green Wi-Fi moment opens the first Ready only after Wi-Fi was saved
    from the web page (a flag in RTC memory across that restart), and any
    real re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
2026-10-16 led_grid: send each frame by RMT DMA, so a Wi-Fi join cannot corrupt it
    The 37-LED frame is 888 bits. Without DMA the RMT driver refills a
    48-symbol block from an interrupt every ~30 us, and that interrupt is
    not cache-safe (CONFIG_RMT_TX_ISR_CACHE_SAFE is off): it is masked
    during flash writes and delayed by Wi-Fi interrupts on core 0. A late
    refill sends stale bits, so during a Wi-Fi join (all-channel scan,
    WPA3 handshake, NVS writes) some frames reached the LEDs wrong and the
    quiet power-on's Spin looked stuttery (W-1049 bench). One DMA buffer
    holds the whole frame, so nothing refills it mid-flight.
2026-10-16 Known-good slot: the power-up reset boots the last firmware that worked
    Three equal app slots replace the factory slot, and a small record
    written twice like otadata names the known-good one. The running image
    takes it over once it is kept and has finished a real print; updates
    never write the running or the known-good slot; the bootloader hook's
    power-up reset erases settings and boots it, falling back to any image
    that checks out. Nothing is copied between slots, so the board is never
    without one complete good copy.
    Not benched yet.
    Refs: W-1059
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2026-10-16 Known-good: vouch for an image, not a slot; never prefer an unkept one
    From review. The reset tried the slot otadata boots second, which can be
    an update still on trial; with the known-good image damaged it would have
    made that update permanent ahead of the last kept image. It now reads
    what otadata says each slot holds and tries kept images first, unkept
    last. The record also carries the image's app_elf_sha256, so a slot
    rewritten under it (older firmware's update, an app-only USB flash) is
    no longer vouched for. Promotion needs a real mark-valid, not just the
    end of the trial.
    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
2026-10-16 Known-good reset: write otadata over the unkept entry, not the kept one
    From the second review. IDF's rule overwrites whatever entry is not
    active, and when an update is new or on trial its entry is the active
    one: a power cut mid-write would have left that update with nothing to
    roll back to. The hook now writes over the sector that does not hold the
    newest kept entry, past both sequence numbers. The status page no longer
    reads a version from a slot with no image under a blank record.
    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
2026-10-16 Known-good status: check the whole image, as the bootloader does
    From the bench. With the known-good image damaged, the power-up reset
    fell back correctly, but /api/status still named the damaged slot: the
    app read only the image's description. It now runs the bootloader's own
    image check on that slot (about 0.2 s at boot) and reports none.
    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
2026-10-16 Revert "Known-good status: check the whole image, as the bootloader does"
    On board 1 it crash-looped the app at boot: with signed updates on,
    esp_image_verify also runs an RSA-PSS check, which overflows app_main's
    stack once the slot holds a whole image. The status page goes back to
    reading the image's description; the bootloader's own check is what the
    power-up reset relies on. The trap is in docs/traps.md.
    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
2026-10-16 led_grid: every effect peaks at 100% of its cap
    Wells found the effects often too dim on board 1. Many peaked well under
    full (Ready 70%, the embers 60%, Job failed's pulse 60%, page out 30%,
    most moments and tasks 80-90%). Each is now scaled so its brightest
    moment reaches 100% of its cap, with its lower levels in proportion, so
    it is the same animation, brighter. Caps are unchanged, and every frame
    still draws less than the boot spin's heaviest. The Spin's 60% hold
    while Wi-Fi joins and the asleep pilot light stay as they were.
    The Setup shimmer test is now relative to the level, like the neutral
    white check, since a brighter shimmer spans more counts.
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2026-10-16 led_grid: asleep, one dot breathes like an old Mac laptop's sleep light
    The asleep pilot (a fixed dot at 3-12% of the cap, plus a twinkle every
    30 s) read too dim on board 1. Now one FR4 dot breathes every 5 s, 12 a
    minute, in the old Mac laptops' curve, (e^sin - 1/e)/(e - 1/e), from off
    up to the full cap and back to off. Each breath comes up at a new dot:
    every FR4 dot takes a turn in a shuffled order before any repeats, and
    never the same dot twice running. The twinkle is gone; the moving
    breath does its job of showing the board is alive.
    Wells watched it on board 1 before this commit.
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2026-10-17 W-1064 review fixes: a colour job always asks the ribbon
    A job whose printer is not ready waits for it, and one after a cut stream
    resyncs first, before asking: a stale colour state after a ribbon swap
    would otherwise print four passes on a black ribbon. Self-ID takes C only
    straight after the width. An idle check is scheduled only after the line
    was down a second, the TXT record is pushed after the server starts, and
    the kick task gets 4 KB.
    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
2026-10-17 halftone: dot gain curve, serpentine, blue noise, inks kept apart
    Prints of the dusk page came out heavier and noisier than the bits
    deserved. Four changes to the screen, all in the pure-C core so the host
    tool and the board agree:
    A pin's dot is as wide as its row, so neighbours overlap and a tint prints
    darker than asked. A tone curve now runs ahead of every screen, the
    inverse of 1 - (1 - a)^k for the dot gain at a half tint, 20% by default
    (CONFIG_AIRWRITER_DOT_GAIN seeds NVS "gain"; POST /api/general sets it,
    /api/status shows it). Black and white stay themselves.
    Atkinson and Floyd-Steinberg scan serpentine, each row the other way with
    the kernel mirrored, which is the end of their d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
2026-10-17 halftone: the dot gain curve is off by default
    The calibration page printed the dusk art at 0, 10 and 20 percent, and
    Wells found the uncorrected one closest to the screen, no contest. The
    ribbon's dot gains less than its geometry says, or the screens were tuned
    on this printer already. The curve stays, settable, for a worn ribbon or a
    different paper; the default is 0 everywhere (Kconfig, rip, the page),
    and the iOS and colour fixtures are regenerated without it.
    Refs: W-1068
2026-10-17 webui: the halftone sheet at one device pixel per dot
    Wells found the sheet a lot worse than the print, and the print is looked
    at from a foot away, not through a glass. One device pixel per dot: on a
    retina Mac the sheet is half the size it was and nearly the printer's
    1152 dots across. The type scales with the page, about 15 points on
    paper, and is set to the measure, with a second paragraph about the
    printer so a wide sheet has something to show; what does not fit is cut
    at the end of a sentence.
    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
2026-10-18 enclosure: rubber feet in 0.20 pockets, flat-bottomed mini-DIN windows, no USB-C flare
    Four 10 mm feet sit in pockets in the floor's underside, each over a screw
    counterbore so it hides the screw, as evenly placed as the holes allow. The
    pockets are 0.20 deep (Wells: "make foot recess in bottom case .2mm instead of
    1mm"), and the counterbores sit 0.90 above them, the head room Wells asked for
    under the earlier 1.00 pockets. That puts the head seat at Z -5.90, and a new
    test holds the Pro M2.5 x 18 to the README's rule: through the standoff's
    thread and at least 0.5 short of its blind end (1.90 counterbores left 0.14).
    Also from 2026-10-17: the mini-DIN windows get flat bottoms, the USB-C op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
2026-10-19 enclosure: foot pockets 0.40 deep, counterbores up with them
    Wells: ".4mm", after 0.20. The counterbores keep 0.90 of head room above the
    pocket ceiling, so the head seat moves to Z -5.70: the Pro M2.5 x 18 stops
    0.74 short of the standoff's blind end, the Lite M2.5 x 10 reaches 4.30 into
    its insert.
2026-10-19 AGENTS: LocalTalk printed on paper, W-1053 done; the bench Mac's freeze
    The bench Mac printed through the LocalTalk node onto paper, so W-1053's
    last owed test is in and it leaves the open-work list. Its second job
    froze the Mac 8.7 in down the page; the board timed the connection out
    and went Ready, so that is a known issue to watch, not a board bug yet.
    Board 1's node ID is now 198.
    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
2026-10-19 localtalk: EtherTalk Phase 2 framing and AARP layouts
    Infinite Mac and Basilisk II speak AppleTalk on Ethernet: 802.3 frames with
    an 802.2 SNAP header around long-header DDP, and AARP to map AppleTalk
    addresses to MACs. These are the parse/build halves, pure C beside
    lt_proto.c, so the link built on them can be host-tested like the cable
    node. A frame whose 802.3 length disagrees with what arrived is dropped
    here, before anything trusts it.
    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
2026-10-19 localtalk: the EtherTalk link: AARP, the address map, SNAP framing
    What sits between the ELAP-mode node and an Ethernet. It takes a startup-
    range address by AARP probe (nobody's network here has a router), answers
    AARP for it, learns MACs from AARP and from every datagram received, and
    holds one datagram while it asks for an unknown address. A transport that
    drops (the relay closing, Wi-Fi going) ends the job at once, and a new MAC
    (the tunnel's is the board's IP) starts the address over.
    The captured Mac page goes through it byte for byte, and two links sharing
    one printer answer the second Mac busy until the first is done.
    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
2026-10-20 localtalk: the tunnel's and the relay's rules, held to the other end
    Basilisk II's UDP tunnel and Infinite Mac's zone relay each have their own
    small conventions: the tunnel's MACs are "B2" and an IPv4 address and say
    where a frame goes; the relay speaks JSON with "AT" and "*" destinations and
    pings its members. These are pure functions, tested against the formats read
    out of both projects' source (and the relay's, against a live zone), so the
    ESP glue that uses them has nothing left to get wrong in the bytes.
    A zone name goes into the relay's URL as it is, so only 1-32 of A-Z a-z 0-9
    - _ . are accepted; anything a person might paste beyond that is refused.
    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
2026-10-20 firmware: TLS buffers in PSRAM, so the relay cannot starve Wi-Fi
    With Infinite Mac's relay connected, mbedTLS held ~45 KB of internal RAM
    and left 4-13 KB for Wi-Fi and lwIP (91 bytes at a handshake's worst): the
    settings page stalled for 25 s at a time and every reconnect failed for want
    of memory. mbedTLS now allocates from PSRAM; with the relay up the board
    keeps ~42 KB internal free (20 KB at the handshake's worst) and the page
    loads in 0.2 s. GitHub update checks share the allocator and still work.
    /api/et now shows internal RAM, and a failed relay connection reports its
    TLS error rather than the last handshake's stale 101.
    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
2026-10-20 tools/ethertalk: a software EtherTalk Mac for testing the board
    etpeer takes an address with AARP, looks the board up with NBP and prints
    a file over PAP, through Basilisk II's UDP tunnel or an Infinite Mac zone,
    so both of the board's EtherTalk links can be exercised without an emulator.
    Against board 1, fixtures/pap-iw701-page.bin printed byte for byte both
    ways (crc32 62416521 in the board's log).
    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
2026-10-20 localtalk: review fixes: busy-to-itself race, Wi-Fi drops, relay closes
    From the branch's review:
    - The printer's holder is named before main.c's begin posts the job's
    start. Before, a state change seen in that window set the holding
    node's status word to busy for the whole job, and a Mac told busy about
    its own job never sends: any link could hang, the cable included.
    - Wi-Fi lost ends both EtherTalk links' jobs at once; the relay's TLS
    socket is pinged every 15 s and given up after 45 s.
    - A clean close from the relay reconnects (enable_close_reconnect);
    before, the client's task ended and the zone stayed down.
    - The open setup network has no EtherTalk routes, so the zone name i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
2026-10-20 localtalk: EtherTalk on the board's own Wi-Fi, for real Macs
    A third EtherTalk link, "radio": real Macs on the home network (on
    Ethernet, or on Wi-Fi through a BlueSCSI's DaynaPORT, like the SE/30) find
    the printer in the Chooser and print, as Infinite Mac and Basilisk II do.
    AppleTalk frames come in through lwIP's unknown-protocol hook, which keeps
    only AppleTalk and leaves everything else to lwIP's drop as before, and go
    out through the Wi-Fi driver under the station's own MAC. A spike on board 1
    showed the SE/30's 802.3 + SNAP frames reach the ESP32 and that it answers
    the board's AARP over the radio.
    Frames an access point turned into Ethernet II are rebuilt as 802.3 + SNAP
    (host-tested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
2026-10-20 localtalk: radio frames arrive with an 802.3 length of 0; rebuild it
    The SE/30's Chooser lookups over its BlueSCSI's Wi-Fi reach the board with
    the 802.3 length field set to 0 (captured on board 1), so the strict parser
    turned every one away and the Chooser never saw the printer. The length is
    rebuilt from what the frame carries: the DDP header's own length, or AARP's
    fixed 28. The captured frame is now a host test. /api/et counts the frames
    lwIP passes the hook and the AppleTalk ones it keeps.
    Refs: W-1078
2026-10-20 localtalk, webui: Infinite Mac has its own on/off; the classic macs section
    The relay no longer runs just because a zone name is saved: NVS et/zone_on
    switches it, and a board from before reads a saved name as on. Turning it
    off keeps the name. /api/et/settings carries "infinite".
    The settings page's classic macs section is one sentence naming the three
    ways in that need nothing set, and a checkbox for Infinite Mac with its zone
    name. W-1079 replaces the whole page; this keeps the branch working until
    then.
    SPEC §3.13 gains the radio link (W-1078) and zone_on; traps gain the
    zero-length 802.3 frames and Infinite Mac's B2 rule.
    Refs: W-1076, W-1078
2026-10-20 firmware: what the new settings page needs (W-1079)
    AirPrint gets an off switch: _ipp and _printer leave Bonjour and Print-Job
    and Validate-Job are refused as not accepting jobs; on, they come back under
    the same printer-uuid, live.
    The AppleTalk port gets a switch on the page that takes over from DIP
    switches 1-2 once used. The LocalTalk node cannot stop once started, so off
    is quiet: TashTalk answers for no node, frames are dropped, a job is cut
    short; on acquires a node again.
    Each AppleTalk link reports the Macs it heard in the last 10 minutes,
    newest first (/api/lt and each /api/et link's "macs"): the cable by node,
    the EtherTalk links by address and MAC, one per MAC, and a Basilisk I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
2026-10-20 firmware: what the settings page needs in its edge states (W-1079)
    - /api/scan escapes network names: one with a quote in it spoiled the
    whole list, and the page said "No answer from AirWriter". It answers 503
    when the radio cannot scan, and never writes past its buffer.
    - /api/wifi with no password keeps the stored one only for the same
    network. For another it means none: an open network joined with the last
    one's WPA2 password is never found, and the board fell back to setup mode.
    - /api/general refuses a host name that is not letters, digits and dashes
    (unescaped, a quote in one broke every status reply), and a saved string
    is cut on a character, not mid-emoji.
    - /api/status: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
2026-10-20 webui: empty, error and edge states; a preview server for them (W-1079)
    Every state looked at in tools/webui/preview.py, which serves the page with
    no board from states.json (36 states: no printer, setup mode, a failed join,
    odd and long names, a failing relay, update errors, a board that stops
    answering...), at desktop and phone width, light and dark.
    - A long network name no longer breaks the Wi-Fi row or the sidebar: it is
    cut with an ellipsis, and on a phone the row leads with the network, as
    macOS's list does. A weak signal lights the lamp amber.
    - Printer offline reads "Check power, cable and SELECT", and Print Test Page
    says so instead of sending a page. In setup mode the print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
2026-10-20 testpage: no ESC F, after board 1's first print
    On paper, whole strips and colour passes printed inches to the right of
    where they belonged, and the ruler's 8, placed with ESC F at 7.95 in,
    wrapped to the left margin. AirPrint's streams, which never place the
    head, print right on the same printer, so the page now sends graphics as
    they do: each pass from the left margin to its last dot. Text is placed
    with spaces in a fixed pitch, the colour names print in one pass
    (correspondence, not NLQ), the AppleTalk ways in go on to a fifth row
    instead of being cut, and the rules move to pin 5: board 1's top pin is
    dead and the rules under the headings did not print at all.
2026-10-20 imagewriter: a blank strip is only its line feed
    Every 8-row strip went out as ESC G and all 1152 columns, blank or not,
    so a white page fed at a line a second at 9600 baud (Wells, board 1, a
    calibration page). A strip with no dots now only owes its LF, held with
    the others until a strip below it prints, so the page's last strip
    still never gets one. The colour writer already did this; a test now
    holds both to it.
    fixtures/ios-20260804-232652.expected.bin regenerated for it: 114848
    bytes to 98617, 14 blank strips no longer sent, and the same 694624 dots
    in the same places (drawn with tools/iwview). The checker and both
    colour fixtures are unchanged.
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2026-10-20 ripjob, testpage: a top margin, signed, in printer rows
    Positive adds blank paper ahead of each page; negative drops the page's
    first rows, cropping what is on them once past the page's own blank
    margin. Every row is still screened, so the rows kept print the bits they
    would with no margin; only the printer stream moves. rip --top-margin
    takes it.
    The test page is now laid out as an AirPrint page is, from the sheet's top
    edge with its content an inch down, where printing starts on paper loaded
    as Apple's guide says, and the setting moves it the same way, short of
    cropping it. To fit, the colour still life is an inch tall (its ramps 16
    rows on 18), the screen panels 56 rows, and a few gaps t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
2026-10-20 webui: take the Top margin menu off the Printer pane (W-1079)
    Loaded as the Owner's Guide says, under the paper bail, the printer
    starts about 1 in down and the default margin puts pages where iOS laid
    them out. A menu, and then a line-up sheet, confused more than they
    helped, and no margin can fix paper loaded at the tear edge: the board
    cannot roll a sheet back above where the head sat at power-on.
    The setting stays in firmware and over POST /api/general, so board 1
    keeps its -7/8 in. traps.md records the loading rule and what the
    reverse-feed tests showed.
    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
2026-10-21 AppleTalk card: say when the LocalTalk chip is missing (W-1081)
    With U7 empty or blank, the node used to start anyway: its sync sat behind
    CTS, 20 unanswered ENQs claimed a node ID, and the card read "No Macs
    connected" like a working port. Now localtalk_start checks that TashTalk
    takes the sync within 100 ms; if not it gives UART2 and the pins back and
    returns ESP_ERR_NOT_FOUND, and lt_start reads U7's device ID, as the cable
    test does, to tell an empty socket from a chip without TashTalk.
    /api/status reports it as lt_chip. The card keeps its switch on and says
    which, with a Flash TashTalk key for a blank chip; after a good flash the
    board starts the port without a restart. A build with no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
2026-10-21 AppleTalk card: no switch while the chip can't run the port (W-1081)
    Wells: in the no-chip and Flash TashTalk states the switch made no sense. The
    card now says why in its place, as macOS does for missing hardware, with Flash
    TashTalk where the switch was for a blank chip. So that holds with the port
    switched off too, the board asks U7 at boot (localtalk_probe: the same sync,
    the node left off) and after a flash, not only when the node starts; starts
    and probes take one lock.
    Refs: W-1081
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2026-10-22 fixtures: synthetic 300 dpi text and photo pages; ippcap can advertise RS300 (W-1082)
    pscheck now rips both for a LaserWriter: the text page's PostScript is 37%
    of its bitmap, the photo's 92%, both dot for dot with Ghostscript.
2026-10-22 laser: the query job, its parser, the status words and the LaserWriter's caps and UUID (W-1082)
    The query job asks product, version, revision, language level, resolution,
    imageable area and page size, each inside stopped, and sends a 256-byte
    binary probe; Ghostscript runs it (and again held to Level 1) and the
    board's parser reads every answer back. Status strings map loosely to IPP
    reasons; toner low is a warning that does not stop the printer.
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2026-10-22 localtalk: a PAP client beside the server, host-tested (W-1082)
    The board as a PAP client to a LaserWriter: OpenConn with busy retried every
    2 s (the wait counting since the first try) up to the stall limit, the
    printer's SendData answered with at most 8 packets of 512 bytes, the last
    8 answers kept for retransmits, the printer's output read back from the
    start, EOF, tickles every 30 s, dead after 120 s silent, CloseConn after the
    printer's EOF or 30 s without it. Constants checked against TailTalk's
    pap.rs; it keeps 8 replies for retransmits too, and sends a wait of 0 where
    this counts seconds.
2026-10-22 etpeer: a fake LaserWriter; the PAP client proven against it on the host (W-1082)
    etpeer.py laserwriter registers NAME:LaserWriter and answers PAP as a
    LaserWriter does, the board's query job included, saves and draws each job,
    and can be told busy, out of paper, a jam, a PostScript error or to go
    silent. lwhost runs the firmware's EtherTalk link and PAP client on this
    computer; make -C tools/rip interop prints through it to the fake over a
    pipe: lookup, query (binary and hex), a print byte for byte, busy, paper out,
    an error, cancel and a silent printer all pass.
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2026-10-22 ipp_server: a printer per resource; the ImageWriter answers as before, a LaserWriter beside it (W-1082)
    The server's one printer becomes a record per printer: printer 0 is the
    ImageWriter, set up as it always was, answering at every path; printer 1 a
    shared LaserWriter at /ipp/laser, under its own Bonjour instance, UUID,
    icon and caps, set and cleared with ipp_server_set_printer. One print lock
    across both, so a job for either waits behind the other. A job carries
    job-state-message when set (a PostScript error). The ImageWriter's golden
    answers are unchanged; gpa_server --laser answers as both, and CUPS's
    attribute suite passes on both but for its media-col-database-alone case,
    which fails o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
2026-10-22 laser: share a LaserWriter as a second AirPrint printer (W-1082)
    laser.c keeps the LaserWriters heard on the cable, the Wi-Fi link and the
    Basilisk II tunnel, the one shared (NVS laser) and what its query job said,
    advertises it as ipp_server's printer 1 once queried, and pushes its state
    to the phone. A job takes the job lock, opens PAP (waiting out busy), rips
    at 300 dpi through job_pipe into ps_page and a 16 KB spool the client
    drains as the printer pulls, and ends at the printer's EOF; a PostScript
    error becomes the job's message. The links run for either printer and
    answer as the ImageWriter only where it is shared. The panel follows the
    LaserWriter while its job prints, and on a board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
2026-10-22 laser: fixes from the whole-branch review (W-1082)
    - The AppleTalk Port card, /api/status lt and the test page call the port on
    only while it answers as the ImageWriter, not while the cable's node runs
    for a LaserWriter alone (localtalk_serving).
    - Status strings are read for the printer's own status field and any
    PrinterError, never the job:, user: or source: fields: a job named
    "Pajamas" is not a paper jam.
    - The query job pads the binary probe with as many spaces and counts as
    answered once the probe is (every other question comes first), so a Level 1
    LaserWriter that mangles binary gets hex instead of never being shared.
    - Busy, warming up and toner low reach the phone: print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
2026-10-22 laser: its state in PSRAM, so Wi-Fi keeps its internal RAM (W-1082)
    On board 1 the branch's ~15 KB of new statics left Wi-Fi and lwIP so little
    internal RAM that every reply over one TCP segment crawled or stalled, on
    ports 80 and 631, for both printers. The laser's core, parse and query
    buffers, the IPP printer records and the card's JSON buffer now live in
    PSRAM; .bss is back within 1.2 KB of main. /api/status reports internal
    free and its low mark. After the fix the settings page (105 KB) loads in
    0.14 s, with 28-30 KB internal free.
    Refs: W-1082
2026-10-22 job_pipe: a LaserWriter job never asks the ImageWriter; rip rows in PSRAM (W-1082)
    On board 1 the first 300 dpi job reached the fake LaserWriter as its header
    only: the pipeline asked the ImageWriter for its ribbon before every rip,
    the LaserWriter's included, and with the ImageWriter switched off that ask
    waits out the 10-minute stall limit. job_pipe_rip_cfg now builds the rip's
    settings, and a target's job never calls colour_ok (test_job_pipe_rip).
    The same job took internal RAM down to 923 bytes: at 300 dpi the error
    rows, the resampler and the URF line are ~30 KB, all under the 16 KB line
    that keeps a malloc internal. They now come from PSRAM (bigmem.h), on the
    ImageWriter's jobs too; h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
2026-10-22 laser: a paper fault mid-job is not a PostScript error (W-1082)
    On board 1 a job that ran out of paper and then printed whole was failed
    as "out of paper": lw_ps_error took "%%[ PrinterError: out of paper ]%%"
    for a PostScript error because the key contains "Error:". Only a message
    whose first key is Error: is the job's error now.
    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
2026-10-22 pap_client: a cancel the printer does not pull closes the connection (W-1082)
    A LaserWriter out of paper asks for no data, so the EOF a cancel sends
    with the next answer waited for paper, and the canceled job held the board
    and the ImageWriter behind it for up to the 10-minute stall limit (seen on
    board 1). After 10 s with no SendData the client sends CloseConn, which
    ends the job at the printer as the EOF would have.
    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
2026-10-22 docs: rip rows in PSRAM; a gdb attach resets board 1 (W-1082)
    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
2026-10-22 laser, ethertalk: per-job pull and memory figures; why tunnel sends fail (W-1086)
    /api/laser's job now reports the last job's time, the rip's wait on a full
    spool, the printer's wait on us, its SendData count, the ones answered again
    from the cache, and internal RAM's low during the job. /api/et counts tunnel
    sends that failed for want of buffers and the last errno. On board 1 a Mac
    photo job showed every failed send as ENOMEM, with internal RAM at 1 KB.
    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
2026-10-23 ethertalk: a send with no buffer free waits and tries again (W-1086)
    On board 1 a LaserWriter job took internal RAM to ~1 KB and the tunnel's
    sendto failed with ENOMEM on up to a tenth of its frames; each dropped PAP
    reply cost the printer a 2 s retry, and a photo page at -86 dBm took 9
    minutes. A send that finds no buffer (ENOMEM, ENOBUFS, ESP_ERR_NO_MEM) is
    only a burst Wi-Fi has not sent yet: the tunnel and the Wi-Fi link now wait
    10 ms and try again, five times in all (et_send_patiently,
    test_send_patiently). With the settings page loaded in a loop beside a
    photo job, internal RAM fell to 1.5 KB, 13 sends waited, and none dropped.
    Wi-Fi and lwIP buffers in PSRAM (SPIRAM_TRY_ALLOCATE_WIF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
2026-10-23 ripjob: the per-job state in PSRAM, off the rip task's stack (W-1082)
    task's 7168 unused. pipe_t, with the ImageWriter encoder and the ink
    screens, is ~3.8 KB and sat on that stack for every job, the LaserWriter's
    included; it now comes from bigmem. A bigger stack was tried first and
    rejected: 8 KB in one piece was not free when a job started, so the job
    failed. Every stream is byte for byte the same (make regress, pscheck).
    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
2026-10-23 ipp_server: log each request's printer, asked attributes and answer size
    On board 1 the iPhone tapped Print, asked for the LaserWriter's attributes
    348 times in four minutes and sent no job, with the log saying only
    "op 0x000b". Each request now logs its path, which printer that is, the
    IPP version and requested-attributes, and each Get-Printer-Attributes
    the answer's size and printer-state, so the next such stall says why.
    Refs: W-1082, W-1044
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2026-10-23 imagewriter: read the ImageWriter LQ's self-ID (W-1087)
    The reader took only the ImageWriter II's "IW" + two digits, so an LQ's
    answer to ESC ? read as unknown: the board never switched to colour and
    an LQ with a colour ribbon printed colour pages gray. It now also takes
    "LQ" + one digit of carriage width, with C straight after the digit
    meaning colour, as GSport's emulator sends it ("LQ1CF1" and a CR). Bit 7
    is still ignored, noise ahead still skipped, a stray C still ignored.
    The shape is from GSport, not Apple's manual, and untested on a real LQ.
    Every IW case and every regression stream is unchanged.
    Refs: W-1087
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2026-10-24 lt_node: several names per node, and an AirWriter marker (W-1088)
    A node answers NBP for its own name and up to four registrations, each
    with its own listening socket (0x85-0x89): printers offered to Macs on
    that link, and the marker <host>:AirWriter@*, which never opens. SendStatus
    on a registration asks its owner for the string; OpenConn asks pap_open
    (busy when it says so) instead of the ImageWriter's job_begin, and the
    connection records which registration it is on. Nodes heard answering as
    an AirWriter are remembered for ten minutes, so lookups can skip another
    box's printers.
    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
2026-10-24 laser: every AppleTalk printer in the list, one client (W-1088)
    laser.c no longer keeps one shared LaserWriter: it looks on every
    running link (10 s after start, every 30 s for five minutes, then every
    five minutes), tells the printer list what it hears, and serves the
    list's AppleTalk printers in turn: status, the query, the job. A printer
    answering from another AirWriter's node is skipped. The list puts each
    shared LaserWriter on AirPrint printer 1-3 (W-1082's keeps ipp/laser),
    so a second one is found and shared unasked.
    The panel follows the box while idle: ready while any shared printer is.
    etpeer's fake can carry a second LaserWriter on the same tunnel.
    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
2026-10-24 localtalk: relay a Mac's PAP connection to a printer on another link (W-1088)
    An old Mac on one AppleTalk way in can now print to a LaserWriter on
    another. The Mac's connection on the relayed name goes through the board
    with its one PAP client: the Mac hears busy, in the printer's own status
    words, until the printer's connection is open; then its data goes to
    the printer and the printer's output (query answers, PostScript errors)
    back to its reads. Nothing is ripped or rewritten. It takes the job lock
    like any job.
    pap_relay is pure state and buffers that ask the board to open, cancel
    or end each side, so each side's calls run on its own link's task.
    etpeer gains print-ps NAME FILE.
    Refs: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
2026-10-24 ps_page: a test page for PostScript printers (W-1088)
    A LaserWriter now gets a test page of its own, in its own Times and
    Helvetica: the AirWriter mark, its name and product, the board's
    details, a type sample, its own gray ramp, AirWriter's five screens as
    300 dpi swatches, a ruler and four one-inch squares. Plain Level 1
    PostScript, hex only, sent as it is.
    The test button, DIP4 and the page's Print Test Page go to the port's
    ImageWriter, else to the first shared printer. A second tap cancels a
    LaserWriter's page. A raw job's end no longer reads as a failure (it
    cut the page's last 13 KB on the bench).
    rip --ps-testpage writes it on the host; pscheck renders it under the
    Level 1 trap.
    R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
2026-10-24 webui: a Printers section, AirPrint and AppleTalk around it (W-1088)
    The settings page's Printer pane becomes Printers: the notices (found,
    not known, changed, didn't answer, more than four) with their keys, a
    row per printer with its state, and each printer's detail: its state in
    its own words, name, model for the port's, Share, halftone, Print Test
    Page, Test Cable for the port, Remove. Add a Printer and Look for
    Printers at the foot. AirPrint lists each shared printer's address;
    AppleTalk is the old Macs' pane, says what they see, and loses the
    LaserWriters card. The preview has a state for each case.
    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
2026-10-24 printers: review fixes (W-1088)
    - A printer list this firmware can't read is never stored over: the board
    rebuilds from its old settings, and a newer firmware's list (after an OTA
    rollback or the known-good reset) is kept for it.
    - The AppleTalk port runs whenever U7 runs TashTalk, so Look for Printers
    looks there with the old-Mac switch off, and after a TashTalk flash.
    - Print Test Page works for a LaserWriter that is not shared.
    - What old Macs are offered is set one caller at a time.
    - No new internal RAM: pr_load keeps no static, the node's registrations
    are the link's room in PSRAM, and the unused AirWriter list is gone.
    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
2026-10-24 printers: the idle CTRL-X follows the ImageWriter's own line (W-1088)
    Since the panel follows the box while idle, a shared LaserWriter that is
    ready kept printer_state's line ready, so a port ImageWriter stuck busy
    with SELECT lit was never sent its CTRL-X. printer_state now keeps the
    port printer's own line for the kick (ps_port_line), and the kick runs
    whatever line the panel follows. Found on board 1's bench, 2026-10-24.
    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
2026-10-24 webui: one icon system, and the ports drawn as the parts are (W-1093)
    Every glyph now sits on the same 16-unit grid inside 1..15, with one
    stroke weight (1.5, was 1.5 to 2), one set of corner radii, and tiles at a
    quarter round with the glyph about 5/8 of the tile (was 0.58 to 0.64).
    The AppleTalk Port icon is the face of J4's mini-DIN 8 as Kycon's model
    has it: eight pins three-three-two with the middle one off centre, the key
    at the top and the shoulders at the foot (it had seven pins and the key
    in the wrong place). The Ethernet icon takes an 8P8C jack's proportions
    and its eight contacts, so it stops reading as a monitor. The LaserWriter
    keeps its tall box but its cassette is narrower t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
2026-10-24 webui: a shorter compact Mac, and plugs flat on top, round below (W-1093)
    Wells: the Mac read a touch tall, and a real cable's plug is flat on top
    and round at the bottom. The Mac is now 10 by 13 units (was 14). Each plug
    moulding is a D about its socket, square overall with small top corners,
    its boot concentric with the round, as in Wells's sketch; the drawing is
    10 units taller so the cable's loop clears the plugs.
2026-10-24 webui: the sidebar shows the panel's dots, live (W-1092)
    The 3D render beside the name is now the status panel itself: its 7 x 8
    dot grid from panel_layout.json, lit as the board drives the LEDs right
    now. GET /api/panel returns the LED task's frame (37 x RGB, 8.8 fixed
    point, 222 bytes); the page draws each dot in the colour board 1's panel
    was measured showing, the same model as the wiki's GIFs
    (tools/lights/render.py), and blends from one answer to the next.
    It asks about 6 times a second while the mark is on screen, once a second
    while a job prints or with reduced motion, and never in a hidden tab or
    in setup. Measured on board 1: 6 a second cost 7% of one core (Wi-Fi, TCP
    and the web s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
2026-10-24 job_pipe: rip as the URF arrives, and buffer the printer's bytes (W-1066)
    A full-page colour photo is ~5.7 MB of URF, five times the 1 MB job
    buffer, so its upload streamed at the printer's pace: the phone held it
    open for ~5 minutes, longer with a paper-out pause. What it rips to is
    small (250-350 KB; a page of colour noise, the worst, is 460 KB), so an
    ImageWriter job now splits the same 1 MB: 512 KB of URF ahead of the
    rip and 512 KB of printer bytes behind it, which a printer task with
    its stack in PSRAM feeds to the port. The rip runs at the upload's pace
    and any one page uploads at Wi-Fi speed. A LaserWriter job keeps the
    whole 1 MB as URF, as before.
    Refs: W-1066
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2026-10-24 firmware: the page's Erase answers before Wi-Fi stops (W-1076)
    On the bench the board erased, but the page's dialog sat for 30 s and then
    said "No answer from AirWriter.": reset_task stopped Wi-Fi the moment it
    started, before the reply queued by erase_post left the board. The page's
    Erase now waits 300 ms first, as Restart does. The held button's reset is
    unchanged.
    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
2026-10-24 ipp_server: a job the printer cannot take now is told busy (W-1076)
    The bench sent an AirPrint job while a Basilisk II tunnel page printed. Both
    times the job came back aborted-by-system with 0 pages. doc_begin waited for
    the job lock with the document unread, and the unread upload held received
    frames in internal RAM: free fell from 26 KB to 6.8 KB in 25 s. When the
    lock came, job_pipe_begin could not find 7 KB for the rip task's stack. The
    same job printed alone.
    A Print-Job no longer waits with its document unread. The sink's new claim
    takes the job lock without waiting. When another link's job, the test page
    or an update has it, the client is told server-error-busy, the body is read
    to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
2026-10-24 docs: a job the printer cannot take is told busy; unread uploads hold RAM (W-1076)
    SPEC 3.4 says a Print-Job that finds the printer taken is answered busy at
    once and asks again, and why it never waits with its document unread; 3.13's
    shared printer points there. Traps gains the unread upload and ipptool's lack
    of retries. The tools/ipp build-folder trap no longer says its binaries are
    committed (2d05e94 stopped tracking them).
    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
2026-10-24 AGENTS: W-1076 benched; AirPrint busy; board 1 erased and restored; W-1094
    The W-1076 bench of 2026-10-24 is recorded under Open work: what passed,
    what Wells waived, and the two bugs it found and fixed. AirPrint's bullet
    says a job that finds the printer taken is told busy. EtherTalk's bullet
    notes the first real Infinite Mac print. Board 1's node ID and port uuid
    changed with the Erase. W-1094 (internal RAM during AirPrint jobs) is a
    known issue, and W-1066's RAM note points at it.
    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
2026-10-24 memdiag: /api/mem shows what holds internal RAM at its lowest (W-1094)
    A 20 ms sampler keeps the lowest free internal RAM it has seen and, at each
    new low, a snapshot: used and free blocks by size, each long-lived task's
    stack (size, where, spare), the biggest blocks no stack accounts for, and
    failed allocations by size, caps and task. GET /api/mem shows it beside a
    snapshot taken then; POST /api/mem/reset starts a new low. Its task,
    snapshots and JSON are in PSRAM; it costs ~250 bytes of internal RAM.
    The console's "mem:" lines give free RAM and the low since the last mark:
    relay connecting, relay up, relay down, job start, job done, ready.
    The relay's errors now say why. esp_websocket_cl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
2026-10-24 fw_update, webui: restart from the caller when the reboot task cannot be made (W-1094)
    Installing the W-1094 build onto board 1, whose internal RAM's low was 23
    bytes, /update answered "ok" and the board never restarted: /api/update sat
    at "restarting" for 3+ minutes until /api/restart. fw_update_restart ignored
    xTaskCreate's result, so a reboot task that could not be made was nothing.
    Now it waits the same 800 ms and restarts from the caller's task instead.
    The Wi-Fi save's restart had the same unchecked create and gets the same
    fallback.
    AGENTS.md and docs/traps.md record the W-1094 bench on board 1
    (v0.2.0-150-g8088a2f): idle 86.6 KB free with a 31.7 KB largest piece and a
    60.7 KB boot l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
2026-10-24 etpeer: the fake LaserWriter takes many jobs a connection, and print-ps sends each file as its own job (W-1095)
    A real LaserWriter keeps the connection open across jobs. After its EOF
    it pulls the next job, and a Mac's LaserWriter driver sends its query and
    then the document that way. The fake now does the same: after its EOF
    reaches the client, it starts a new job and pulls again, and it saves each
    job as its own job-N.ps. A CloseConn between jobs is a normal end, not a
    cut-short job.
    `print-ps NAME FILE [FILE ...]` now sends each file as its own job over one
    connection, the way the driver does: the job and its EOF, the printer's
    output read to its EOF and printed, then the next file, and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
2026-10-24 docs: the SE/30 printed through the relay; out of paper read off the NTR (W-1095)
    Its driver sends four jobs on one connection and closes before the
    printer's last EOF; the relay now finishes that job. Out of paper, mid-job,
    reads "PrinterError: multipurpose tray: out of paper" and maps to
    media-empty-error. Board 1 runs v0.2.0-160-gd20f49d.
2026-10-24 webui: a LaserWriter's detail no longer says it is untested (W-1082)
    A Personal LaserWriter NTR has printed through AirWriter on board 1
    (2026-10-24), and test status belongs in Linear, not on the page.
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2026-10-25 webui: printer notices only for what needs a decision, worded as warnings (W-1088)
    The "Found <printer>. It's shared with your iPhone, iPad and Mac." notice
    stayed until dismissed and told nothing the list didn't: a found printer
    now just joins the list. The firmware no longer makes it, and drops any an
    older build stored.
    The notices left (unrecognized port printer, a different port printer, a
    LaserWriter not responding, more than four) each ask something, so they
    read as warnings: an amber caution mark, a bold line saying what is wrong
    and a plain one saying what to do. The same mark sits beside Printers in
    the sidebar while one waits.
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2026-10-25 laser, printers, webui: a switch for a LaserWriter's start page (W-1099)
    Every PostScript LaserWriter prints a start page at power-on. The query
    now reads it (statusdict /dostartpage), the record keeps it in what was
    lw_info_t's tail padding (its stored size is pinned), and the printer's
    detail shows a Start page switch where the printer said. Flipping it
    sends LaserWriter Utility's recipe (exitserver with password 0, then
    setdostartpage) on the laser task as a query is, and the page waits for
    the printer's answer: saved, busy, a password, or no answer.
    The fake LaserWriter takes the job (and a password fault), lwhost and
    the interop test send it, pscheck runs it through Ghostscript's job
    s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
2026-10-25 Copy pass: every message the page and phones show, in the voice guide (W-1100)
    The page's own text and the board's messages that reach it: printer list
    and update errors, TashTalk flash failures in plain words (each still told
    apart, as the wiki's LocalTalk Chip page needs), phones' Offline status
    with what to check, and the halftone sample in American spelling. No line
    narrates AirWriter, no hedges or test status, digits for counts.
    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
2026-10-26 Rev B list: U3 to an SP3232EU so HSKi can carry a QuickDraw LaserWriter's ~1 MHz clock (W-1091, W-1102)
    The fitted SP3232EEN's receiver skew (200 ns typical, 1 us max) is too close to a 1 MHz
    clock's 500 ns half-cycle; the SP3232EU is the same package and pinout at 50 ns. Raised by
    Bolacore on 68kMLA.
    Refs: W-1091, W-1102
2026-10-26 StyleWriter design: AirPrint to the seven documented StyleWriters on the printer port, then vintage Macs through AirWriter as Apple's adapter (W-1103)
    Reverses the August cut: owners restore and use them, and lpstyl and TailTalk/InkTalk
    document the protocol. Built against a software StyleWriter; an owner confirms on paper.
    Refs: W-1103
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2026-10-28 Rev A can power up in download mode: C7 on IO0 races EN (W-1091)
    Board 1 came up with only its power LED lit: the S3 had latched IO0 low at
    a power-on reset (GPIO_STRAP 0x23) and sat in the ROM's download loop. IO0
    has C7, 100 nF to GND, and nothing but the chip's ~45 k internal pull-up to
    charge it, against EN's 10 k / 1 uF. No firmware runs in that state, so the
    fix is hardware: lift C7 on rev A, a 10 k pull-up and no C7 on rev B.
    traps.md says how to tell and how to get out over USB: USB and RTS resets
    leave the straps as latched, esptool's watchdog reset re-latches them.
    Refs: W-1091
2026-10-28 Boot wave: a diagonal rainbow on all 37 dots replaces the boot Spin
    The shop's 3D model of the board showed the Spin, and through the solder mask
    it read as chaos: a dot's brightness swings hard with hue there (a double-mask
    dot is nearly black at red, bright at green), so a wheel turning round the test
    button blinked 23 of the 37 dots on and off out of step. Wells picked a steady
    diagonal rainbow on the stage and wants the board to do what the site shows.
    The wave is the shop's formula, hue 30t - 14(row + col) at saturation 90%,
    through the usual gamma and caps. It comes in from the top-left corner, eases
    to 60% after 3 s while Wi-Fi joins (as the Spin did), and once the board
    settles roll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
2026-10-28 Rev 2026.11 board design: the board AirWriter sells (W-1091)
    Rev B's list sorted for a board that sells in three forms (AirWriter, Lite,
    TashTalk add-on): every power-up runs the firmware, the printer port takes
    StyleWriters, the QuickDraw LaserWriter clock and RS-232 printers both ways,
    base boards are safe with an empty socket, the power light stands up under
    the slash, and PCBWay fits J2. Drops the J2 option pads, U3's removal, inrush
    soft-start and J4's shell tie; corrects review #4 on U9 (LVC fails a 3.3 V
    input at 5 V) and IO3 (pull up, not down).
    Refs: W-1091, W-1043
2026-10-28 A failed update no longer leaves the board restarting forever (W-1108)
    After any failed update, every boot checked the failed slot's RSA-3072
    signature on the main task, from esp_ota_get_last_invalid_partition(). That
    check needs at least 3.7 KB of stack from ota_health_start down, by GCC's
    count, on a 3,584-byte task. It overflowed into the other core's IPC task,
    which crashed 50 ms into each boot: board 1 sat off the network until a USB
    flash (2026-10-28). It only runs when a slot is marked failed, and since
    signed images (2026-10-16) no rollback had been benched.
    - ota_health names the rolled-back slot from otadata's state and the image's
    descriptor, which need no signature check (752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
2026-10-28 Boot wave at 90 degrees a second, its mask dots 1% under the cap
    At 30 degrees a second a fast power-on moved the colours only a quarter of
    the way round, and on board 1 Wells found it too slow. He picked 90 from
    rendered previews: each dot goes round every 4 s and the bands cross the
    panel in about 2 s.
    Faster, the wave goes through more hues at full brightness during a boot,
    and its heaviest frame rose to 7030 counts, over the Spin's 6990 that the
    host test holds it to. LG_BOOT_MASK_CAP puts its mask dots at 190 of 255
    instead of 192, which brings it to 6968 and cannot be seen.
2026-10-28 Rev 2026.11 design: crisp dots, hand routing, a shorter test button (W-1091)
    Wells's three requests: a front copper flood on the top case with a window
    at each lit dot (light was leaking sideways through the FR4 and out through
    the black mask), every trace drawn by hand with no autorouter, and SW3 at
    15 mm so the plunger stands 0.36 mm proud instead of 1.36.
    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
2026-10-28 Board check scripts resolve paths from their own location (W-1091)
    r6_lib, r7_verify and place_leds named the main checkout's files, so run
    from a worktree they checked the wrong board. Rev A baseline in this
    worktree: ERC 0 errors (42 lib_symbol_mismatch, 2 isolated_pin_label); DRC
    0 errors, 0 unconnected, 5 lib_footprint_mismatch, 80 field-parity notes;
    GND one cluster, 153/153 pads; r7_verify 37 LEDs within 0.0005 mm, plunger
    at (131, 91), and six FAIL lines rev A already shipped with (TP courtyards
    over U1, C5/C9/TP5 under dot (7,6), SW1's west-edge rule, U5 8.1 mm from J1
    on D-, U4 in GND_STITCH_012).
    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
2026-10-28 Schematic: rev 2026.11 (W-1091)
    Pulls on IO0 (C7 gone), LT_DE, IO48, IO35, IO17 and IO3; 1 k in LT_RESET
    and DIP3; 10 k in each leg of U2's receive pair (R5-R7 gone); R9 fitted;
    J4's handshakes on U3's spare channel through IO10/IO11; revision and Lite
    straps on IO12/IO9. U3 SP3232EB, U9 SN74LV1T125, R17 150R, SW3 15 mm, D3 a
    3 mm THT LED on a spacer. The LocalTalk nets take the Mac port's signal
    names (LT_PORT_RXD_N for J4.5 and so on). tools_sch/check_rev2026_11.py
    checks every changed net pin for pin. ERC as rev A: 0 errors, 44 warnings.
    R9 was deleted and placed again because konnect can't clear a DNP flag;
    the Lite strap R33 is not DNP in the schematic, and make_fab.sh leaves it
    off th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
2026-10-28 Board follows the rev 2026.11 schematic (W-1091)
    tools_pcb/r13_sync.py does Update PCB from Schematic headless, matched by
    reference: KiCad's own update (and konnect's) refuse this board because
    rev A's LEDs and SW1 were placed with an empty schematic path. Every
    footprint now carries its symbol's path, so a later F8 in the GUI matches
    them; C7 and R5-R7 are gone, D3 is the THT footprint, R21-R33 are parked
    east of the board for placement, 59 pads take their new nets, copper on the
    renamed LocalTalk nets follows the rename, and footprints carry hidden LCSC,
    MPN and Note fields (field-parity notes 80 -> 18).
    Not yet clean on purpose: 10 shorts are rev A copper that now joins two
    nets, and R9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
2026-10-28 Board: rev 2026.11 parts placed, rev A copper the changes broke removed (W-1091)
    r13_clean.py removes copper that meets another net's pad (ten pieces: U2's
    receive legs, U7.4, U1.33, the old D3 feed under the new D3) and prunes what
    that leaves hanging, back to the next pad, via or pour: 45 items, all on
    nets rev 2026.11 changed. It refuses to cut copper on any other net, so a
    part placed on a live track stops the run instead of costing the track.
    r13_place.py puts each new resistor beside its pin on a spot clear of
    courtyards, F.Cu (0.25 mm), U7's TASHTALK label, the antenna keepout and the
    lit dots; R21 sits on C7's old spot so its pad meets BOOT_CFG. D3 is a new
    footprint (r13_mkfp_d3.py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
2026-10-28 Top case: copper under the front mask, open only where light leaves (W-1091)
    Wells: the lit dots look fuzzy. The panel had copper only on its back, so
    light came in through each back window, spread sideways in the FR4 and
    leaked out through the black mask round the dot; on the 23 teal dots the
    mask covers dot and surround alike, so nothing on the front marked the
    edge at all. front_flood.py puts the windows in a front flood: teal dots
    exactly the dot, bare-FR4 dots and the power slash a hair wider than their
    mask openings so misregistration never shows copper. All front copper,
    gold art included, is on PANEL_AU so DRC reads one node. Inset 0.55 mm from
    the outline, as the back flood. Figma a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
2026-10-28 Enclosure: the lattice's D3 tube clears the LED on its spacer (W-1043)
    D3 is now a 3 mm flat-top LED 8 mm up on a nylon spacer, two 3D models on
    one footprint (lib/make_led_spacer_model.py draws both; KiCad's own 3 mm LED
    is a dome on long legs that would reach 16.3 mm, through the top case).
    board_geom reads every model on a footprint and components merges their
    STEP bodies into one envelope; the D3 tube is cut round the window and that
    envelope, D3_TUBE_CLEAR all round. Its wall may be one printed line (0.45)
    where J1 crowds it, and the wall check stops at the lattice's own outline
    where the board's edge closes the tube. R17 turns and moves 0.7 mm north so
    its clearance cut no longer nicks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
2026-10-28 Board: rev 2026.11 routed, U3's channels swapped for straight J4 runs (W-1091)
    U3 now gives the printer port driver 2 and receiver 2 (pins 7-10) and the
    LocalTalk port driver 1 and receiver 1 (pins 11-14), so J4's two RS-232 lines
    leave U3 on the side facing J4 and run down beside it and under U8 with one
    via each. The printer port's lines rejoin rev A's routes by short steps.
    No free GPIO reaches U3 for a separate J4 HSKo drive: IO36 sits under
    UART_TX's via and IO7 is walled off north of U7. IO35 now drives both of
    U3's driver inputs, R24 holds both low, and R31 goes. The cable test still
    sees each handshake wire on its own: IO8 reads J2.2 and IO37 reads J4.2.
    To make room, U3's 3.3 V fe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
2026-10-28 Docs: rev 2026.11 as drawn, order notes for its PCBWay order (W-1091)
    docs/hardware-rev-2026-11.md is the board as routed: U3's swapped channels,
    the GPIOs that changed, parts that moved, rev A copper that changed, and
    what to leave alone. ORDER-NOTES now describes the rev 2026.11 order with
    its two variants, and combined-top.png is re-rendered from the routed
    panel in its stackup colours.
    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
2026-10-28 Design: amend rev 2026.11 with what routing decided (W-1091)
    J4's HSKo shares IO35 with J2's because no free GPIO reaches U3, U3's
    channels are swapped so J4's lines face J4, R26 and R31 are dropped,
    the VBUS via is grown instead of doubled, and Claude draws the traces
    along chosen paths for Wells to review.
    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
2026-10-28 Rev 2026.11: fixes from the board review (W-1091)
    - R17 moves 0.3 mm west: its ground pad sat 0.275 mm from the routed edge,
    under PCBWay's 0.30 minimum with a +-0.2 mm router.
    - D3's cathode gets a K on the silk past pad 1, where the spacer doesn't
    hide it; its designator goes to F.Fab, as rev A's LEDs, off the edge.
    - R29/R30 go from 10 k to 15 k: against U2's typical 15 k input, 10 k let
    a -15 V RS-232 line reach -9 V, past the SP3490's -7 V common mode.
    - The order notes ask to keep J4's holes free of solder, and add
    airwriter-top.png, the main board at ~40 px/mm, for polarity checks.
    - r13_check.py checks pad-to-edge, silk on the board and D3's mark.
    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
2026-10-28 Enclosure: no DIP window on a board without S1; pinhole on the new reset button (W-1091)
    The tray is cut to the board, and rev 2026.11 has no DIP switches, so its
    west wall stays whole; the DIP slot and its tests apply only to a board
    with S1 (rev A's tray is at hw-rev-a). SW1 is now the BZCN TSB001A3518A,
    with a model, so the lattice is cut round its body and the reset pinhole
    aims at its button, 1.90 mm up. 131 tests pass, 7 DIP ones skipped.
    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
2026-10-29 Rev 2026.11: spare pins IO38-IO40 on bare pads; cleanup sees through via stubs (W-1091)
    IO38, IO39 and IO40 each run straight down to a via and a bare 1 mm pad on
    the back (TP10-TP12, labelled), so a future idea can be tried on a built
    board with a few wires. On the back, the front keeps only a short stub per
    pin and its ground pour still reaches C1 and C22. IO41 has no way past
    USB D- and IO42 has C1 over it.
    r13_clean.py no longer counts a stub lying wholly inside a via as joining
    it: rev A's DIP and IO35 runs ended so, and the pair held each other up,
    leaving dead stubs on IO38, IO40 and IO42. r13_reroute.py's explicit IO35
    drops go with it. All other copper is unchanged.
    Refs: W-1091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
2026-10-29 Rev 2026.11: U2 is the THVD1451 (W-1091)
    TI's THVD1451DR replaces the SP3490 on the printer port: the same SOIC-8
    pinout (checked against TI's SLLSEY3E), +-30 kV HBM on the bus pins
    against +-2 kV, and a receiver that works with +-15 V on its inputs, so
    an RS-232 printer's line is in range without a divider. R29/R30 stay at
    15 k as series protection; a -15 V line lands near -12.5 V. Its
    fail-safe threshold reads an idle or unplugged line as mark. Board copper
    is unchanged.
    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
2026-10-29 Lite frame: the printed part the acrylic top is taped to
    The Lite's clear acrylic top needs something to sit on. lite_frame.py is the
    Lite lid's four legs (now case.lite_legs, shared with the lid: the same
    inserts, M2.5 x 10 from below, connector trims and foot relief), stopped 0.50
    under CAVITY for 3M VHB 4905, joined by a rim round the top edge (1.7 wide,
    2.5 deep) and an arm from each leg to the side rim. The acrylic is taped to
    the four leg tops and lands on J2/J4's shells at CAVITY, as the Pro's panel
    does, its face 0.10 under the rim. The rim clears every part's envelope and
    keeps out of the power slash's window, and J2/J4 cut it at the front; the
    loose piece between them is dropped. P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
2026-10-29 Lite top: Frame 17, the Lite art at the top case's full height
    svg/lite.svg is now Wells's Frame 17: AirWriter LC, airprint to serial bridge,
    rev 2026.11, the Pro's 18 gold dots and test dot, the serial and power labels
    and rules, the power slash, with the other 37 dots in the background colour.
    It is 1100 x 1850 like the panel, so Frame 13's bottom-band shift goes: the
    art maps straight onto the sheet, and the build now fails on art of any other
    height. Circles placed by a Figma matrix are read with it; a path with a
    transform fails. The test dot is the gold dot at the panel's test position;
    every other gold circle is frosted and the background-colour ones are not.
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2026-10-29 Board: no art on the back after all (W-1091)
    Wells: "nevermind, nothing on back". Reverts af375aa, the Snow White
    stripes; the back keeps its port labels, name, URL and licence text.
    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
2026-10-29 Fab: AirWriter ships with both ports and TashTalk, the LC with neither (W-1091)
    Wells: "full ships with all ports + tashtalk, LC ships without. tashtalk won't
    be an add-on anymore".
    AirWriter's panel order now fits J4 (Kycon KMDGX-8S-BS from Mouser, as J2) and
    presses a blank PIC12F1840-I/P (PDIP-8, Digi-Key or Mouser) into U7's socket:
    137 placements, J4 out of the board's exclude-from-position list (r13_place.py
    and the board). The PIC goes in blank and PCBWay never programs it; an erased
    12F1840 has LVP on, so the board flashes TashTalk at Wells's bench test.
    The LC's order is as before: J4's holes and U7's socket left empty, 55
    placements. make_fab.sh's notes are per variant, and the L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
2026-10-29 No Lite left: the LC's net, note, specs and logs say LC (W-1091)
    Wells: "no need to preserve 'lite' since there are no orders or shop
    things we need to preserve". IO15's strap net is BOARD_LC in the
    schematic (two labels, by konnect) and the board (renamed in place by
    pcbnew), and R33's note reads "LC only"; make_fab.sh blanks it by that.
    No copper moved: ERC 47 known warnings, DRC 0 errors, 0 unconnected, no
    parity items, the netlist and board gates pass, and both order packages
    rebuild with the same position files and BOMs (the gerbers differ only in
    dates and the net's name). The acrylic top's spec is
    2026-10-28-lc-acrylic-top-design.md; the other specs, plans and build logs
    say LC, and t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
2026-10-29 LC top: 1.5 mm acrylic, and its marks un-welded for the shop's model
    Wells is buying 1/16 in (1.5 mm) cast sheets, so ACRYLIC goes back to 1.50:
    the frame drops 0.50 and the sheet rests on J2/J4's shells again, its face
    0.10 under the rim; a sheet up to 1.6 still sits no prouder than it.
    lc_top.engraved(welded=False) gives the engraved layer before weld(), each
    mark with the art's own subpaths. The laser file is unchanged (but its note):
    its welded outlines bridge their counters in, which a laser fills even-odd
    and the shop's triangulator could not (the A and i of the wordmark rendered
    with a wedge missing).
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2026-10-29 Drop references to the plans and reviews moved to private notes
    Follow-up to the previous commit, which removed the files but missed
    staging these edits: the AGENTS.md docs table and laser-printer note,
    the enclosure README, hardware-rev-a's rev B note, a fixture docstring,
    and the .gitignore entry for docs/superpowers/plans/.
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2026-10-30 LC: a loose light tube round D26, and its dot frosted on the acrylic
    D26, the LC's one light under the test button, gets a tube of its own
    (lc_light.py, out/airwriter-lc-light.stl): walls round D26 and C46 from
    the board to 0.2 under the acrylic, which traps it, and a cap with a 3 mm
    hole under the 5.64 dot, a diffuser (Wells: the LEDs are bright). It is
    loose because D26 sits mid-board, and an arm out from the frame would
    show across the clear top.
    Wells's new Frame 17 draws D26's dot gold, so the laser file frosts it.
    JP1 gets a 0.5 solder-blob height (components.py had no height for it, so
    the case build stopped), which re-cuts the lattice round it.
2026-10-30 LC light: the tube takes in the test switch, which holds it and which it braces
    Wells: "encompass the switch too. this will also help stabilize the
    switch and center the part." lc_light.py is now one block over D26 and
    SW3: D26's chamber as before, and a sleeve 0.2 round SW3's body and legs
    (LC_SWITCH_CLEAR, the guiding fit) with the lattice's collar round the
    plunger in the top 2 mm. The collar centres on the switch's body, so it
    follows the switch, and sits 0.1 off the acrylic's test hole.
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2026-10-30 Status panel: asleep, a few dots breathe in turn like fireflies (W-1117) (#6)
    One dot breathing at a time, somewhere new each breath, was too subtle on
    board 1: one dot of 14, and the panel dark most of the time. Now a breath
    starts every 2 s at a new FR4 dot and lasts 6 s, so three overlap and two
    or three dots are always lit. Same curve and cap as before, and the same
    10 s fade in and instant wake. A round of the shuffle never opens on either
    of the last round's last two dots, so no dot breathes twice at once. In
    gamer mode each firefly is its own hue.
    Picked from previews over a fixed dot by the test button and the whole
    panel breathing, and approved on board 1.
    Refs: W-1117
2026-11-03 traps: lifting C7 fixes rev A's download-mode power-up (#4)
    Board 1 with C7 lifted started normally in 50 plug-ins (2026-10-29), and
    the BOOT button still works without it.
2026-11-03 StyleWriters on the printer port (W-1103) (#10)
    StyleWriter owners can print to them over AirPrint, and the printer port keeps a
    printer for each model used on it, so swapping the cable between an ImageWriter and
    a StyleWriter needs no setup.
    The seven models lpstyl covers are found on the printer port and shared under their
    own names, in color with a color cartridge, with their cartridge, faults and Clean
    Print Head on the settings page. Up to six printers are shared at once. Host-tested
    for all seven models against a software StyleWriter; a Color StyleWriter 2500 on a
    rev A board runs pages to their end, with R9 fitted and without.
    Brings in W-1116 (#7), the 2500's fixes (#8) and R9 (#9)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
2026-11-04 README: a product page, not a docs page (#11)
    The README now opens like the shop does: what AirWriter is, a photo, and what it does, in
    short lines a busy owner can read in a few seconds. It says what it does in the same words as
    the wiki's home page, with the same needs list, so the two stop drifting apart.
    It also drops what didn't belong up top: which boards were tested on which printers, baud
    rates and raster formats, and the cable details the wiki already covers. It no longer says
    vintage Macs print to "the same printers", which was wrong for StyleWriters. TashTalk moves
    into Credits beside lpstyl and TailTalk.
    The photo is the shop's, docs/images/airwriter.jpg.
2026-11-08 Clean Print Head ends when a 2500 finishes, not 10 minutes later (W-1131) (#12)
    On board 1's Color StyleWriter 2500, Clean Print Head cleaned the head in
    about 26 s, but the board stayed on Printing for 10 minutes, then called the
    cleaning failed and reset the printer. It waited for status 1's busy bit to
    go off, as TailTalk does, and the 2500 reads busy all the time: idle, while
    it cleans, and after E.
    Its 08 (everything sent is done) is what moves: off from the reset, on 26 s
    after a setup with P and 3.5 s after one without. A cleaning now ends on
    whichever changes first, busy going off after reading on or 08 coming on
    after reading off. Printers that drop busy end as before; the 5 s fall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
2026-11-08 StyleWriter test page: its pictures are stored, not traced while it prints (W-1133) (#14)
    On board 1's Color StyleWriter 2500 the test page stopped twice partway down,
    the second time with the noises the printer makes at power-up. The page is
    drawn and sent from one task with no buffer between, and the board ray traced
    the still life and the scene the six screens show as their rows were made, so
    the printer had nothing for seconds at a time. That tracing was about three
    quarters of the page's drawing.
    tools/rip/mkscene.c now traces both once on the host with tp_scene.c and
    writes them to sw_scene.h as zlib streams (53 KB of flash). sw_unpack.c reads
    them a row at a time: on the board with t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
2026-11-09 Settings page: a technical log that survives crashes and being unplugged (W-1136) (#16)
    Owners can now read what the board did, on About under Log: every message at info and above and what it was doing when it crashed, kept through restarts and power cuts, with names left out so a log can be posted. Pages get real addresses, and the window on a desk is 860 wide.
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2026-11-13 Personal LaserWriter 300s on the printer port (W-1102) (#19)
    A Personal LaserWriter 300 on the printer port prints over AirPrint: found by its clock on HSKi, linked by GP-SPI2 as a slave with every chunk read back, Atkinson with Apple's 300 screen past the page budget, status, Apple's recovery, the manual slot, and a test page. An LS or Select 300 shows as a grayed row. Two fixes reach past the 300: a Mac's job may carry 8 KB of attributes, and a Mac's Paper Feed (InputSlot) is read. Benched on board 1 with Wells's printer; docs in SPEC 3.18.
2026-11-13 Log: a Mac's status polls no longer push out a job's own lines (W-1142) (#20)
    A Mac with a job queued asks after the printer about once a second, and
    during a job the log saves to flash only when a warning or error is
    waiting. The routine poll lines are kept in RAM only, and in one shared
    ring they pushed a job's start and pages out before anything saved
    them: on board 1 a Personal LaserWriter 300 job with its cover opened
    mid-page left its end in the log and not its start.
    The RAM ring now has two parts in the same noinit memory: 32 KB for the
    lines flash keeps, as before, and 8 KB for the routine polls, so polls
    push out only older polls (about 34 polls, half a minute of a Mac
    asking ever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
2026-11-13 Pages rip faster: 240 MHz and leaner screens (W-1143) (#22)
    * Each page's rip says where its time went (W-1143)
    A blank iPhone page took board 1 about 21 s to rip for the Personal
    LaserWriter 300, longer than the printer takes to print it. Before making
    the rip faster, the board says per page how long it spent reading
    (decoding, and waiting for the upload), scaling, in its screen, in a
    stage's second screen, sending rows on, and in the page's end, and per job
    how long the rip waited for the upload. `rip --times` prints the same
    line on the host.
    Refs: W-1143
    * The error-diffusion screens skip white and stop checking every tap (W-1143)
    Atkinson and Floyd-Steinberg did their bookkeeping pe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
2026-11-14 Rev 2026.11 boards get firmware of their own (W-1109)
    The new board's module has octal PSRAM, which ESP-IDF fixes at build time,
    so each board now has its own build from the same source:
    - idf.py -B build-2026.11 -DAIRWRITER_BOARD=2026.11 build makes
    airwriter-2026.11.bin with 16 MB flash, octal PSRAM, three 3 MB app slots
    and the new pins. The build stops if the sdkconfig is the other board's.
    - Releases carry both images; each board reads its own key in
    airwriter.json and refuses the other board's image, by download or upload.
    - The bootloader hook clamps IO47 and IO13 on the new board and never
    touches IO35-IO37, its PSRAM.
    - The board straps (IO16, IO15) are read at boot and sho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
2026-11-14 Cable test: name the broken handshake wire's pins (W-1109)
